minhqng/predictive-cold-chain-aiot/evidence/A/W01/photos/21-dual-esp32-actual-component-side.jpg

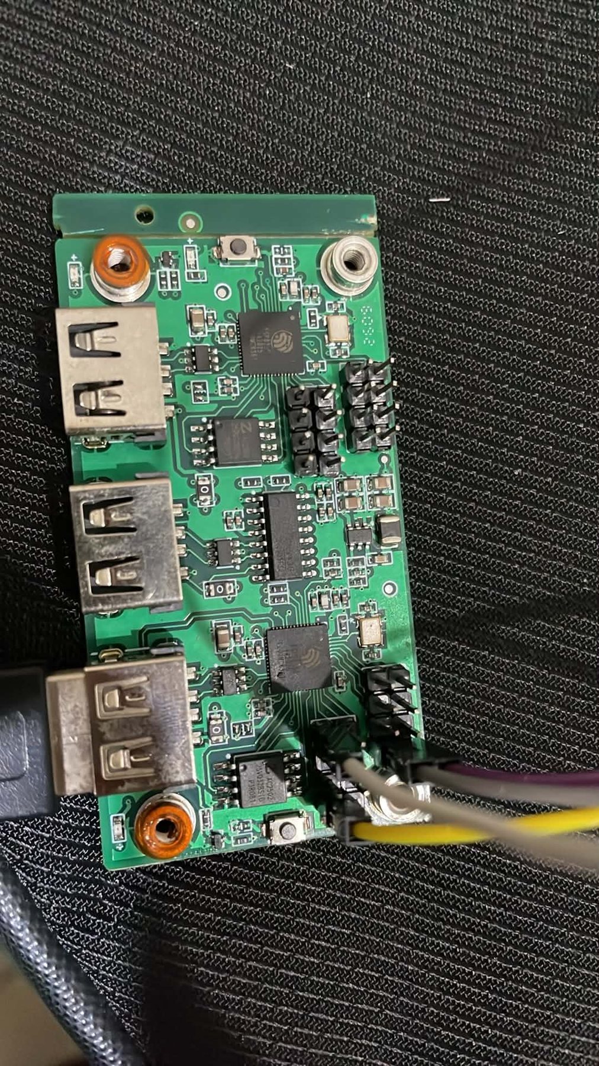
evidence/A/W01/photos/21-dual-esp32-actual-component-side.jpg
