minhqng/predictive-cold-chain-aiot/evidence/A/W01/photos/25-bme280-actual-component-side.jpg

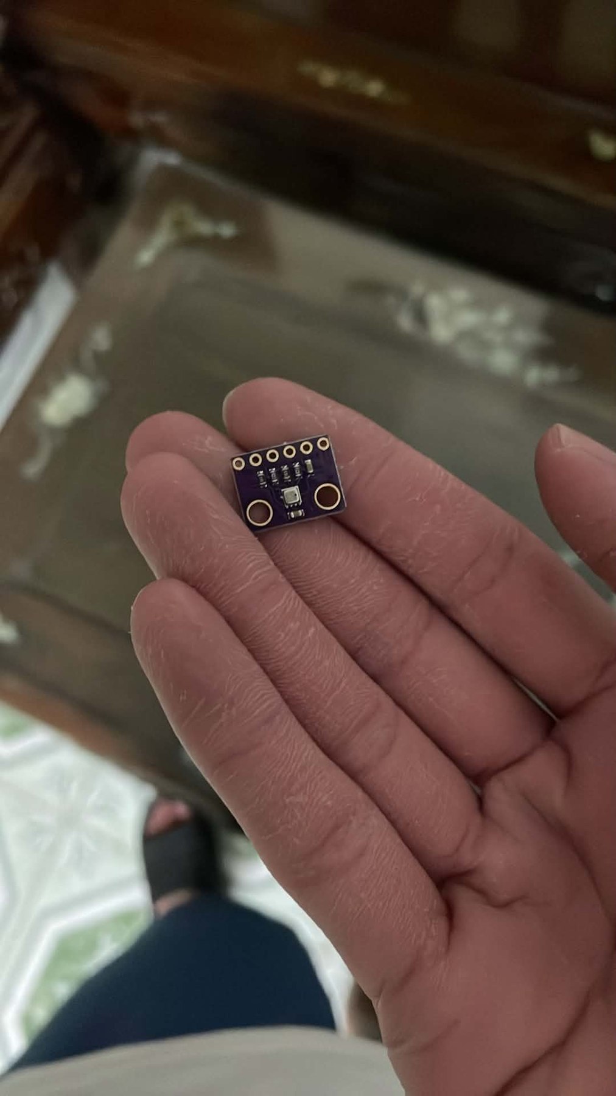
evidence/A/W01/photos/25-bme280-actual-component-side.jpg
