minhqng/predictive-cold-chain-aiot/evidence/D/W21/README.md

# Week 21 — Final resilience/security campaign gate

**Status: HOST MATRIX TESTED; LIVE FINAL CAMPAIGN PENDING.**

The pure `negative_campaign.py` assessment covers all nine cases in Doc 05D
section 53: expired, duplicate, out-of-range, wrong-device, unauthorized
broker, backend authorization, network/backend outage, AI outage, and
reconnect. Each case has explicit required outcomes and an evidence authority.

Host simulation may prove the decision contract and make `all_cases_pass`
true. It cannot make `live_evidence_complete` true. That final state requires
passing `LIVE_EVIDENCE` for every case, with a nonempty evidence reference and
operator identity on every record. Merely changing the authority enum cannot
create live completion. The module only assesses immutable caller-supplied
facts; it does not publish, reconnect, authorize, enter a real mode, actuate
hardware, or edit evidence.

The final live negative/failure campaign remains pending. No physical effect,
ACL event, backend denial, outage transition, or reconnect result is claimed
by this host-only change.
