minhqng/predictive-cold-chain-aiot/evidence/A/W23/README.md

# A-W23 documentary delivery — runbook, recovery kit, labeling deviation

DRAFT week delivery (Member A W23). Base main b5e5cbf.

## Accepted / pending
- **A-W23-02 PASS** — recovery kit: spare fuses (20/30/10 A), jumper 40P, tools,
  spare wire+faston, clamp meter, documentation. Genuine photos
  (operator-submission-20261108/), operator confirmed 2026-11-08.
- **A-W23-01 pending** — demo runbook drafted (demo-runbook.md + runbook v2);
  operator 8-step confirmation outstanding.
- **A-W23-03 INCOMPLETE** — operator-accepted deviation: dedicated branch labels NOT
  applied; system identified via existing component markings + runbook v2 schematic.
  Canonical criterion (6 applied labels) not met; labeling deferred. Not a PASS.
  (operator-acceptance-20261108.md records the decision; no waiver clause exists.)
- **A-W23-04 pending** — ≥3 team rehearsals (not performed).
- **A-W23-05 pending** — evidence index (blocked by A-W15-01).

## Evidence
- operator-submission-20261108/: kit-jumpers/tools/spare-wire/clamp-meter/spare-fuses,
  fuse-block-installed, diagrams (GENERATED, not photos), runbook-v2. SHA256SUMS.
- results/A-W23-02.json (PASS), A-W23-03.json (INCOMPLETE) + imports/ (integrity []).

## Provenance / limitations
- Photos are genuine operator submissions; diagrams are generated schematics (not
  physical photos) and are not used as photo evidence.
- A-W23-03 deviation is operator-accepted but does not satisfy the applied-label
  criterion; kept INCOMPLETE, history preserved.
- Evaluators live in the unpublished acceptance application (feat/a-w21-evidence-final);
  not fully reproducible on main alone.

## Merge readiness
DRAFT — not merge-ready. W23 not complete (W23-01/03/04/05 pending). Operator decides merge.
