minhqng/predictive-cold-chain-aiot/evidence/A/W04/README.md

# evidence/A/W04 — Member A TEC commissioning dossier

Metadata block required by `docs/05A`. Per-requirement verdicts live in
`acceptance.md`; the committed-versus-local inventory is in
`ARTIFACT-MANIFEST.md`; the two open contract questions are in
`change-review-request-CR-A-W04-01.md` (issue **#14**) and
`change-review-request-CR-A-W04-02.md` (issue **#15**); the remaining physical
steps and their safety preconditions are in `w04-physical-verification-plan.md`.

| Field | Value |
|---|---|
| `date` | dossier 2026-11-01, extended 2026-11-02; bench sessions covered 2026-10-29, with the 2026-11-01 box-cooling run cross-referenced as later-week data |
| `operator` | Member A (GitHub `giaback`), attended bench, explicit per-session authorization |
| `hardware_config_id` | `CG-HW-001` (device-emitted in `h6/03-w04-boot-before-flash.log`) |
| `firmware commit` | base `origin/main` `8b73da8e0e7db199259267ac9f0f173c4e289a67`; the W04 code is the commit that adds this dossier on `feat/a-w04-tec-commissioning`. Built image: `0acd230c…b240769e`, 244,496 bytes (`build-2026-11-01/21-artifact-hashes.txt`), compile-only and never flashed |
| `test IDs` | `A-W04-01`…`A-W04-07`; `ACT-H4-01..03`; `PWR-H5-01..03`; `THERM-H6-01/02`; `docs/06` gates G0–G3 |
| `setup` | ESP32-S3R2 MAKDRIVERONE bench, PZEM-017 on the cooling branch, IBT-2 (BTS7960B) driver, TEC1-12715, 12 V/400 W PSU, branch fuse 15 A installed (operator-reported, no readable marking photographed), COM4 console; production firmware built with the TEC output stage compiled out |
| `result` | **W04 PARTIAL** — fail-closed foundation delivered and verified offline (host suite 7/7, ESP-IDF compile PASS); one supervised H6 conservative electrical response measured (peak 0.97 A / 11.3 W, modal 0.96 A / 11.2 W); all six canonical deliverable files now exist; physical W04 acceptance not met |
| `pass/fail` | host suite PASS 7/7 (185 unittest tests + 3 static checkers + 3 dossier validators), ESP-IDF compile PASS; A-W04-02 DEVIATION (1.75 mm² vs 2 × 2.5 mm², change review raised), A-W04-03 not frozen, A-W04-04 PARTIAL (11 resets, 0 power-on boots, 0 pin-level readings), A-W04-06 PARTIAL (direction recorded, no photograph), A-W04-07 PARTIAL (no thermal channels in a conservative trace), H4/H5/H6 PARTIAL |
| `anomalies` | first PZEM sample after START still returns pre-run registers (`elapsed_ms=2 current_ma=0`); one `class=ECHO_ONLY` poll retried once inside the session, documented as transport latency in `h6/41-h6-run-analysis.md` (frame tally corrected there on 2026-11-01), not as zero current; `fan_status=NOT_COMMANDABLE` in all 62 committed G1 telemetry rows — no tachometer feedback exists on CG-HW-001 |

## What this dossier proves

- The W04 control mechanism refuses to energize: output stage compiled out, all
  seven limits `UNRESOLVED`, adapter rejects every enable, proven by static
  contracts plus a 34-scenario host harness against the real control core.
- One conservative H6 energization really happened, with valid 1 Hz PZEM
  electrical samples and an automatic 60.000 s stop.
- Across 132 ROM banners deduplicated to 116 unique start events, no start ever
  produced an unintended output state and all seven production resets came up
  SAFE_OFF — but no start was ever a genuine power-on, which is why A-W04-04 is
  not closed.
- The delivered bytes compile with ESP-IDF v6.1, and every source file in that
  build is hash-pinned.

## Derived artifacts and how to regenerate them

| Artifact | Derived from | Tool |
|---|---|---|
| `h6/first-tec-trace.csv`, `h6/first-tec-plot.png` | `h6/40-h6-run.log` | `firmware/tools/cg_build_h6_trace_csv.py`, `tools/render_trace_plot.ps1` |
| `boot-default-off.csv` | 101 raw captures across the W02, production G1, H6, H7 and H8 sessions | `firmware/tools/cg_build_boot_default_off_csv.py` |
| `tec-cooling-response-600s.csv`, `.png` | the local-only 2026-11-01 monitor `samples.jsonl` (hash pinned in `ARTIFACT-MANIFEST.md` §2.2) | `firmware/tools/cg_build_cooling_trace_csv.py`, `tools/render_trace_plot.ps1` |
| `power-topology-v1.png` | the node and edge list inside the renderer | `tools/render_power_topology.ps1` |

The committed raw captures contain seven per-boot console authorization tokens
(`#CG AUTH token=…`). Each is generated by `esp_random()` at boot, lives 120 s,
cannot be used in another boot and cannot energize the delivered firmware, so
they are inert; they are listed here so a reviewer does not mistake them for
credentials.

## What it does not prove

- Cooling performance from the delivered code, a safe operating envelope, a
  continuous TEC rating, or W04/H4/H5/H6 completion — see `acceptance.md` §1–§4.
- Anything about H7/H8 as W04 evidence: those trees are later-week work, left
  local, recorded by aggregate digest only (`ARTIFACT-MANIFEST.md` §2.3). The
  600 s cooling figures are reproduced here as cross-week measurements at
  **100 % duty**, not as a conservative W04 response.
- The operator statements of 2026-11-02 (fuse installed, 1.75 mm² conductor,
  probe placements) are photographs or measurements. They are statements until
  the images exist.

## Verify

```bash
py evidence/A/W04/validate_w04.py     # recompute every committed hash
py firmware/tools/run_all_checks_w04.py
```
