minhqng/predictive-cold-chain-aiot/evidence/A/W07/repeatability-report.md

# W07 repeatability report

Generated by `evidence/A/W07/build_w07_artifacts.py` from committed captures. Every number reproduces with the commands in `README.md`; nothing was measured for this report.

Primary representation: `tmean_airroles_v0` = mean of the as-built chamber-air probes (T1 centre, T3 bottom, T4 near door), per the operator-frozen geometry in `probe-identification-v0.md`. `includes_hot_side: false`.

## Verdict

**NOT ESTABLISHED — insufficient independent runs.** The analysis exists; the captures do not.

- cooling-step runs: `INSUFFICIENT_RUNS`
- passive warm-up runs: `INSUFFICIENT_RUNS`
- plant variation reportable: `False`
- undetermined rows (no usable applied duty): `0`
- A-W07-02/03 require 3 valid runs of each kind

## What the one available run shows

Every value below is `tmean_airroles_v0`. Slope columns name their own definition: `tmean_airroles_v0/120samples/trailing_window_least_squares_v0` for trailing motion and `tmean_airroles_v0/whole_phase_least_squares_v0` for the phase as a whole.

| phase | samples / rows read | skipped | partial-term | duration min | delta C | trailing slope C/min | whole-phase slope C/min | 1 C at min |
|---|---|---|---|---|---|---|---|---|
| passive warm-up segment | 226 / 226 | 0 | 0 | 3.7498 | 0.0833 | 0.020463 | 0.027185 | None |
| cooling step | 600 / 600 | 0 | 0 | 9.9833 | -8.7083 | -0.070104 | -0.854771 | 0.85 |
| post-action recovery segment | 131 / 131 | 0 | 0 | 2.1667 | 5.333 | 3.097228 | 2.89316 | 0.8167 |

The two slope columns answer different questions and are not two estimates of one. In the only cooling segment the trailing window measures -0.070104 C/min, which is shallower than the whole phase at -0.854771 C/min, so it reports recent motion rather than the response. Neither value is "the cooling slope": the phase answer is `whole_phase_slope_c_per_min`, and the comparison is computed (`trailing_differs_from_whole_phase`) rather than asserted, so a future run in which the two agree will say so.

### Electrical figures

- driven block: mean current `7.2247 A`, peak `9.99 A`, mean power `85.1593 W`, energy delta `14.0 Wh`
- recovery segment: peak current `7.15 A` — **that peak is the single suspect frame below**, not evidence of current after the bridge opened
- electrical qualification: no electrical column in this capture carries a recorded OK: current and voltage have empty status cells and power/energy have no status column at all, so the values are unqualified, not verified (`electrical_rows_unqualified: 2400`, `electrical_status_recorded: false`), so values that nothing checked are never presented as status-checked

Suspect frame (`device_ms=826894`): applied duty `0` and requested duty `0` in state `COOLDOWN`, yet the row carries `7.15 A` and `84.2 W`; `current_status` is an **empty cell, not OK** and all 14 measured fields match 2 of the 2 preceding frames, so the readings did not move when the duty did. Naming this CONTROL_ELECTRICAL_ANOMALY is a safety classification and not a host tool's call, so it is recorded as the canonical candidate for the next supervised session; the frame stays inside the recovery segment's published peak, where the report names it instead of averaging it away.

- canonical candidate: docs/01 22.4 'Commanded OFF + unexpected current' names CONTROL_ELECTRICAL_ANOMALY, high severity, and 23.4 lists 'current while state should be OFF' as its example
- competing explanation: register/transition lag on the PZEM side. Two committed observations support it: evidence/A/W04/README.md records the first PZEM sample after START still returning pre-run registers, and after this frame the applied duty stays 0 while the reading falls 7.15 -> 0.56 -> 0.02 -> 0.0 -> 0.0 -> 0.02 A, reaching 0 at device_ms 829894. That is a decaying tail, not sustained energization - but it is a meter trace, not a verified zero-current measurement, so it weakens the anomaly reading without closing it
- comparison actually performed: `14` measured fields, `2` of `2` preceding frames identical on all of them, differing on `none`

## The representation question, measured

Same single run, four definitions:

| representation | terms | roles | includes hot side | delta C | whole-phase slope C/min | 1 C at min |
|---|---|---|---|---|---|---|
| `tmean_airroles_v0` | t1_c, t3_c, t4_c | CHAMBER_CENTER, CHAMBER_BOTTOM, CHAMBER_NEAR_DOOR | False | -8.7083 | -0.854771 | 0.85 |
| `tmean_chamber3_v0` | t1_c, t2_c, t3_c | CHAMBER_CENTER, TEC_HOT_SIDE, CHAMBER_BOTTOM | True | -2.5627 | -0.34487 | 2.6833 |
| `tmean_t2excluded_v0` | t1_c, t3_c | CHAMBER_CENTER, CHAMBER_BOTTOM | False | -8.6875 | -0.864815 | 0.8833 |
| `tmean_all4_v0` | t1_c, t2_c, t3_c, t4_c | CHAMBER_CENTER, TEC_HOT_SIDE, CHAMBER_BOTTOM, CHAMBER_NEAR_DOOR | True | -4.1095 | -0.467323 | 1.9 |

The docs/01 §20.1 literal mean(T1,T2,T3) measures `-2.5627` C where the
as-built chamber-air mean measures `-8.7083` C — a factor of
3.40. T2 is on the hot side, rises while the air
probes fall, and averaging it into an air temperature flattens the response
the chamber actually produced.

This is stated as measured disagreement between named definitions. The
physical geometry is operator-final and is not reopened here; the logical
T1/T2/T3 naming in docs/01 remains a project decision, and no silent
firmware remap is proposed.

## Statistics

Sample (n-1) spread. With n=1 the spread columns are empty by construction:
one run has no dispersion, and inventing a variance would be the exact thing
this week must not do. Outcomes no run produced are listed as NO_SAMPLES
rather than dropped from the table.

| phase | outcome | n | mean | sd (sample) | CV % | min | max | note |
|---|---|---|---|---|---|---|---|---|
| baseline | start_c | 1 | 29.9167 | None | None | 29.9167 | 29.9167 | spread needs at least two runs |
| baseline | end_c | 1 | 30.0 | None | None | 30.0 | 30.0 | spread needs at least two runs |
| baseline | delta_c | 1 | 0.0833 | None | None | 0.0833 | 0.0833 | spread needs at least two runs |
| baseline | min_c | 1 | 29.9167 | None | None | 29.9167 | 29.9167 | spread needs at least two runs |
| baseline | max_c | 1 | 30.0417 | None | None | 30.0417 | 30.0417 | spread needs at least two runs |
| baseline | slope_c_per_min | 1 | 0.020463 | None | None | 0.020463 | 0.020463 | spread needs at least two runs |
| baseline | whole_phase_slope_c_per_min | 1 | 0.027185 | None | None | 0.027185 | 0.027185 | spread needs at least two runs |
| baseline | minutes_to_1c | 0 | - | - | - | - | - | no run of this phase produced this outcome |
| baseline | minutes_to_2c | 0 | - | - | - | - | - | no run of this phase produced this outcome |
| baseline | mean_current_a | 1 | 0.0 | None | None | 0.0 | 0.0 | spread needs at least two runs |
| baseline | peak_current_a | 1 | 0.0 | None | None | 0.0 | 0.0 | spread needs at least two runs |
| baseline | mean_power_w | 1 | 0.0 | None | None | 0.0 | 0.0 | spread needs at least two runs |
| baseline | energy_wh | 1 | 0.0 | None | None | 0.0 | 0.0 | spread needs at least two runs |
| baseline | valid_sample_fraction | 1 | 1.0 | None | None | 1.0 | 1.0 | spread needs at least two runs |
| cooling | start_c | 1 | 30.021 | None | None | 30.021 | 30.021 | spread needs at least two runs |
| cooling | end_c | 1 | 21.3127 | None | None | 21.3127 | 21.3127 | spread needs at least two runs |
| cooling | delta_c | 1 | -8.7083 | None | None | -8.7083 | -8.7083 | spread needs at least two runs |
| cooling | min_c | 1 | 21.3127 | None | None | 21.3127 | 21.3127 | spread needs at least two runs |
| cooling | max_c | 1 | 30.0417 | None | None | 30.0417 | 30.0417 | spread needs at least two runs |
| cooling | slope_c_per_min | 1 | -0.070104 | None | None | -0.070104 | -0.070104 | spread needs at least two runs |
| cooling | whole_phase_slope_c_per_min | 1 | -0.854771 | None | None | -0.854771 | -0.854771 | spread needs at least two runs |
| cooling | minutes_to_1c | 1 | 0.85 | None | None | 0.85 | 0.85 | spread needs at least two runs |
| cooling | minutes_to_2c | 1 | 1.25 | None | None | 1.25 | 1.25 | spread needs at least two runs |
| cooling | mean_current_a | 1 | 7.2247 | None | None | 7.2247 | 7.2247 | spread needs at least two runs |
| cooling | peak_current_a | 1 | 9.99 | None | None | 9.99 | 9.99 | spread needs at least two runs |
| cooling | mean_power_w | 1 | 85.1593 | None | None | 85.1593 | 85.1593 | spread needs at least two runs |
| cooling | energy_wh | 1 | 14.0 | None | None | 14.0 | 14.0 | spread needs at least two runs |
| cooling | valid_sample_fraction | 1 | 1.0 | None | None | 1.0 | 1.0 | spread needs at least two runs |
| recovery | start_c | 1 | 21.3127 | None | None | 21.3127 | 21.3127 | spread needs at least two runs |
| recovery | end_c | 1 | 26.6457 | None | None | 26.6457 | 26.6457 | spread needs at least two runs |
| recovery | delta_c | 1 | 5.333 | None | None | 5.333 | 5.333 | spread needs at least two runs |
| recovery | min_c | 1 | 21.3127 | None | None | 21.3127 | 21.3127 | spread needs at least two runs |
| recovery | max_c | 1 | 26.6457 | None | None | 26.6457 | 26.6457 | spread needs at least two runs |
| recovery | slope_c_per_min | 1 | 3.097228 | None | None | 3.097228 | 3.097228 | spread needs at least two runs |
| recovery | whole_phase_slope_c_per_min | 1 | 2.89316 | None | None | 2.89316 | 2.89316 | spread needs at least two runs |
| recovery | minutes_to_1c | 1 | 0.8167 | None | None | 0.8167 | 0.8167 | spread needs at least two runs |
| recovery | minutes_to_2c | 1 | 1.0833 | None | None | 1.0833 | 1.0833 | spread needs at least two runs |
| recovery | mean_current_a | 1 | 0.0604 | None | None | 0.0604 | 0.0604 | spread needs at least two runs |
| recovery | peak_current_a | 1 | 7.15 | None | None | 7.15 | 7.15 | spread needs at least two runs |
| recovery | mean_power_w | 1 | 0.7084 | None | None | 0.7084 | 0.7084 | spread needs at least two runs |
| recovery | energy_wh | 1 | 0.0 | None | None | 0.0 | 0.0 | spread needs at least two runs |
| recovery | valid_sample_fraction | 1 | 1.0 | None | None | 1.0 | 1.0 | spread needs at least two runs |

## Reproduce

```bash
py firmware/tools/run_all_checks_w07.py
py evidence/A/W07/build_w07_artifacts.py --check
py firmware/tools/cg_thermal_repeatability.py evidence/A/W04/tec-cooling-response-600s.csv --representation tmean_airroles_v0
```
