minhqng/predictive-cold-chain-aiot/evidence/A/W08/Gate-A-report.md

# Gate A report - W08 physical characterization and SAFE_LOCAL support

Generated by `firmware/tools/cg_w08_gate_a.py` through
`evidence/A/W08/build_w08_artifacts.py`. **Every** statement below is one of
an observation over recorded bytes, a declared dependency, or a named gap.
No line is `PHYSICALLY_VERIFIED`; nothing here authorizes energizing the
branch, and the produced verdict is `GATE A NOT CLOSED`.

## 1. Requirement matrix (docs/05A section 17)

| ID | Canonical ask | Status | Evidence | Gap |
|---|---|---|---|---|
| **A-W08-01** | safe operating envelope from W4-W7 | REAL_DATA_ANALYZED (observed) / NOT FROZEN | operating-envelope-v1.yaml, envelope-by-duty.csv, holdover-frames.csv, electrical-status-coverage.csv | one committed duty level; the ladder is local-only; no limit is a rating |
| **A-W08-02** | fuse finalization 10/15/20 A with rationale | BLOCKED_HARDWARE | fuse-selection.md (generated) + the observed currents table | no ampacity basis for the installed conductor (2.405 mm2 derived from a 1.75 mm core diameter under a solid-round assumption), no photographed fuse marking, canonical 2 x 2.5 mm2 deviation open |
| **A-W08-03** | hot-side sustainability long run | REAL_DATA_ANALYZED (three of four bullets) / NEED_USER_ACTION | thermal-sustainability.csv | terminals/IBT-2 abnormal behaviour is unmeasured by any frame; no continuous rating may be claimed |
| **A-W08-04** | SAFE_LOCAL integration support with D | TEAM_DEPENDENCY | safe-local-physical-inputs.csv (SL-01..SL-14) | no transport, no wall clock, no fan observation, no interlock, and the mode itself belongs to D |
| **A-W08-05** | Gate A package indexing all H0-H7 artifacts | IMPLEMENTED / HOST_VERIFIED | Gate-A-report.md + gate-a-artifact-index.csv | W07 evidence is not in this checkout; the H7/H8 raw sessions are local-bench; committed captures in this run: 5 |

## 2. Pass-criteria walk

| Criterion | Result | Why |
|---|---|---|
| safe physical envelope known | NOT MET | the observed envelope exists (one duty level committed, the ladder local-only), but the fuse/conductor basis is missing so nothing can be called safe; see fuse-selection.md verdict NO_FREEZE |
| repeatable enough plant | NOT MET HERE | repeatability is W07's question and its evidence is not in this checkout; one 600 s capture cannot answer it |
| fuse selected | NOT MET | NO_FREEZE: no ampacity basis for the installed branch (a 1.75 mm core diameter, 2.405 mm2 if solid round) and no photographed fuse marking; the 15 A value is operator-reported only |
| no unresolved high-current anomaly | NOT PRE-JUDGED - CANDIDATE OPEN IN W15 | fault_bits=0 in all 957 committed frames and steady OFF current never exceeded the 0.02 A meter floor; the duty-0 frames above it are the two PZEM register-latency frames, named individually and left open by W15 between the register-holdover reading and the canonical CONTROL_ELECTRICAL_ANOMALY class (docs/01 22.4/23.4, high severity). This row does not decide that safety classification, and nothing here measures the terminals or the IBT-2 case either |
| SAFE_LOCAL physically possible | NOT DEMONSTRATED | the inputs exist (SL-01..SL-08) but the fan is unobservable, no interlock is installed, there is no wall clock and no transport, and the mode itself is Member D's |

## 3. Index of H0-H7 artifacts (docs/01 Gate H0 ... Gate H7)

Curated list, resolved against this checkout. `exists_in_this_checkout`
false is a finding, not a formatting failure: those artifacts live on other
branches or only in Member A's local bench tree.

| Gate | Required | Artifact | In this checkout | SHA-256 (12) |
|---|---|---|---|---|
| H0 mechanical assembly | V1 installed, TEC integrated, paste, fan mounted, penetration sealed, sensor positions fixed, panel outside chamber | `evidence/A/W01/hardware-audit-w01.md` | true | 9962ee5ee97c |
| H0 as-built positions | the frozen as-built pin/position record | `evidence/A/as-built-pinmap-2026-10-27.md` | true | 39acc702d0d7 |
| H0/H1 photos | photographic inventory of the assembly | `evidence/A/W01/photo-inventory.csv` | true | a644db8cd956 |
| H1 sensor subsystem | three expected DS18B20 ROM ids, BME read, MC-38 open/close | `evidence/A/W02/ds18b20/ds18b20-verification.md` | true | ecace2203db4 |
| H1 ROM map | the by-source ROM identity table | `evidence/A/W02/sensor-rom-map.yaml` | true | 50709135f7f0 |
| H1 door subsystem | MC-38 open/close verified | `evidence/A/W02/mc38/mc38-bench-report.md` | true | 48d33f5294e8 |
| H2 logic power | 5 V rail verified, no TEC actuation | `evidence/A/W03/logic-power-measurement.md` | true | 485cfaffeda6 |
| H3 PZEM / RS-485 | Modbus response, 50 A profile, V/I/P/Wh readable | `evidence/A/W03/pzem-register-readback.txt` | true | ca6b58183c1e |
| H3 current profile readback | 50 A profile verified on the wire | `evidence/A/W03/hardware-2026-10-27/test-131-profile-readback.md` | true | b7301e80b9e0 |
| H3 OFF-state envelope | zero-current envelope with per-sample validity | `evidence/A/W03/hardware-2026-10-27/raw/test-132b-off-envelope.csv` | true | 7eac5f80c2d9 |
| H4 IBT-2 logic | default OFF, enable, direction, reset, 3.3 V logic | `evidence/A/W03/hardware-2026-10-27/test-133b-reset-default-off.md` | true | bb1d334b79f3 |
| H4 default-OFF on the delivered build | boot with outputs off | `evidence/A/W04/boot-default-off-note.md` | true | c67ed70cc300 |
| H4 IBT-2 pin map | the pin contract actually used | `evidence/A/W03/ibt2-pin-map.md` | true | 4901c0328534 |
| H5 power branch | fuse installed, high-current wiring, shunt, terminal check, fan | `evidence/A/W04/fuse-commissioning-note.md` | true | 2342bbbf3b38 |
| H5 shunt continuity | series return path proven | `evidence/A/W03/hardware-2026-10-27/shunt-continuity.md` | true | fa0e25f36b65 |
| H5 G0 electrical verification | branch voltage/presence evidence before any drive | `evidence/A/W04/g0-electrical-verification.md` | true | de2f24567b46 |
| H6 conservative TEC test | current present, correct cooling face, hot side rejects, no abnormal connector behaviour | `evidence/A/W04/h6/41-h6-run-analysis.md` | true | d5553d313c22 |
| H6 trace artifact | the 1 Hz electrical samples | `evidence/A/W04/h6/first-tec-trace.csv` | true | f5cd1fb7d741 |
| H6 polarity | correct cooling face proven | `evidence/A/W04/polarity-photo.md` | true | f1729ecadf6a |
| H7 full characterization | V/I/P, actuation state, T1/T2/T3, BME, door, timing, thermal response over the duty ladder | `evidence/A/W04/tec-cooling-response-600s.csv` | true | f8716b5136f3 |
| H7 duty ladder | the 20-100 % staircase | `h7/50-stage-20pct.md .. h7/60-h7-100pct-duty-audit.md` | false | - |
| H7 endurance / hot side | long runs at 100 % duty | `h8/phase4e/H8_FULL_SENSOR_ENDURANCE_REPORT.md` | false | - |
| W05 timing / freshness | cadence and age statistics | `evidence/A/W05/timing-pilot.json` | true | 6621f7a9c12b |
| W06 command/ACK contract | desired vs applied state, idempotency, expiry | `evidence/A/W06/ack-fixture.json` | true | 1a195a4a7fef |
| W07 plant repeatability | repeated baseline runs and their spread | `evidence/A/W07` | false | - |

## 4. SAFE_LOCAL physical inputs (A-W08-04)

What firmware can observe, what must come from Member D's policy, and what
no recorded field measures at all. Full machine-readable table:
`safe-local-physical-inputs.csv`.

| ID | Input | Firmware can observe | Recorded validity | Gap |
|---|---|---|---|---|
| SL-01 | chamber CENTER temperature (T1, as-built CHAMBER_CENTER) | YES | false | the device role token is UNASSIGNED in every frame, so the mapping T1=CHAMBER_CENTER comes from the operator-frozen as-built record, not from the frame |
| SL-02 | TEC HOT_SIDE temperature (T2, as-built TEC_HOT_SIDE) | YES | false | the production schema still reports the hot-side channel as NOT_ASSIGNED, so the delivered build has no hot-side protection input until the role is wired end to end |
| SL-03 | chamber BOTTOM (T3) and NEAR-DOOR (T4/SPARE) | YES | false | both report role UNASSIGNED in every frame; no frame proves which physical probe it is, and the ROM ids are by-source (firmware ROM map), not a readback |
| SL-04 | chamber air / humidity / pressure (BME280) | YES | UNQUALIFIED | the CSV builder dropped the air and humidity validity tokens, so an air statistic quoted from the CSV is unqualified even though the wire labelled it OK |
| SL-05 | door state (MC-38) | PARTIAL | UNQUALIFIED | no magnetic/door disturbance experiment has been recorded, and the polarity check is by-source, not by a documented test procedure |
| SL-06 | branch voltage / current / power (PZEM-017) | YES (with one-poll latency) | UNQUALIFIED | the producer publishes a 666 ms-old sample into a 1 Hz frame and the CSV carries no token at all, so downstream consumers cannot separate fresh, stale and held-over readings |
| SL-07 | accumulated energy (PZEM energy register) | PARTIAL | UNQUALIFIED | a 1 Wh counter at ~85 W updates about every 42 s, so it cannot resolve a short run, and it has no validity token on the bench wire at all |
| SL-08 | applied duty and its readback (IBT-2 / LEDC) | YES for duty, NO for the enable pins | false | enable_readback reports ren:0,len:0 in EVERY frame including the 600 driven ones while ren_command=1, so the driver enable state is commanded but never observed; output verification rests on current alone |
| SL-09 | TEC / hot-side fan running | NO | UNQUALIFIED | the only fan evidence is operator presence; SAFE_LOCAL cannot detect a stopped fan from any recorded field |
| SL-10 | safety interlock / hardware cutout | NO | n-a | no interlock is installed, so every stop recorded so far came from software or from the operator at the PSU |
| SL-11 | operating limits and who approved them | PARTIAL (it reports the policy it was given) | n-a | the six (docs/05A) / seven (docs/06) limit-count discrepancy and the numeric values are Member D's decision; the bench image's APPROVED table is not the delivered firmware's and must never be quoted as such |
| SL-12 | wall clock / command expiry | NO | n-a | clock synchronisation is Member C's work; until it exists, expiry-based protection is fail-closed rather than satisfied |
| SL-13 | backend / broker reachability | PARTIAL | n-a | the delivered firmware has no transport, so removing the broker/backend (the literal A-W08-04 ask) cannot be tested against it; the SAFE_LOCAL mode itself is Member D's |
| SL-14 | fault latch and why the stage stopped | YES | false | fault_latency_us=-1 in every frame: the fault-to-stop latency has never been measured because no fault was ever injected |

### 4.1 The split, stated plainly

**Firmware observes:**
* raw sensor conversions with per-channel status and age
* the snapshot completeness mask and the mandatory-role gate
* PZEM V/I/P with per-field status and age (one poll of latency)
* requested vs applied duty and the duty readback
* fault bits, stop reason and the OFF-current gate result

**Member D must supply:**
* the numeric values of the six operating limits and their provenance
* the SAFE_LOCAL entry/exit rule and what protective cooling is allowed while the remote path is gone
* the staleness budget each input must satisfy before it may act
* the fault taxonomy that turns an anomaly into a lockout

> the bench image reports limits_policy=APPROVED and limits_enforced=1; that table belongs to a bench build and is not the delivered firmware's, whose limits are all UNRESOLVED

## 5. Named gaps

| Gap | Detail | Status |
|---|---|---|
| no electrical validity token in the committed 600 s CSV | voltage_status and current_status exist as columns but are empty in all 957 rows; power_status, energy_status and door_status are not columns at all. The same session's wire frames do carry them, so the loss happened in the CSV builder. | REAL_DATA_ANALYZED |
| energy has no validity token anywhere on the bench wire | no energy_wh_status token exists in any of the 957 raw frames; the delivered production schema expects one. | REAL_DATA_ANALYZED |
| driver enable state is commanded but never observed | enable_readback=ren:0,len:0 in every frame including the 600 driven ones, while ren_command=1 there. | REAL_DATA_ANALYZED |
| fan running is not electronically observable | fan_readback=NOT_ELECTRONICALLY_VERIFIED in 957/957 frames. | BLOCKED_HARDWARE |
| no hardware interlock | interlock_state=NOT_INSTALLED in 957/957 frames. | BLOCKED_HARDWARE |
| fault-to-stop latency never measured | fault_latency_us=-1 in every frame; no fault was ever injected. | NEED_USER_ACTION |
| duty-0 frames with current | 11 frames across all sources, each listed individually in duty-zero-current-frames.csv and excluded from both the drive and the OFF envelope. The record names them as register-latency cases, which is an explanation and not a classification: docs/01 22.4/23.4 make a commanded-OFF-with-current frame a candidate CONTROL_ELECTRICAL_ANOMALY (high severity), and W15 leaves that option open. For device_ms=826894 the applied duty stayed 0 while the PZEM-reported reading decayed 7.15 -> 0.56 -> 0.02 -> 0.0 A, reaching zero at device_ms=829894, so the decay weakens sustained-energization and supports register/transition lag - but that trace is the meter's own report with no independent instrument behind it, so measured value and verified physical current stay apart and the safety qualification is open. | REAL_DATA_ANALYZED |
| no continuous rating for the TEC | the 55 C hot-side ceiling was provisional; the SKU continuous rating is unestablished, so 'margin to 55 C' is not headroom. | NEED_USER_ACTION |
| conductor deviation open | the record's "1.75" is the copper core diameter in mm (unit error corrected by the operator 2026-11-02), i.e. 2.405 mm2 if the core is round solid - a ~3.8 % gap to the canonical 2 x 2.5 mm2 ask rather than ~30 %, and inside the FDD2-250 1.5-2.5 mm2 termination rating. The assumption is stated, not proven: no marking was photographed, so no nominal 2.5 mm2 compliance is claimed and HW-19 stays UNVERIFIED. | TEAM_DEPENDENCY |

## 6. Operator action queue (W08 half; the W15 half is in evidence/A/W15)

Merged to the minimum number of supervised sessions without dropping any
required repetition. The unpowered inspection (OQ-W08-1) is **necessary, not
sufficient**: it produces the conductor and fuse markings, and it does not by
itself clear any energized-session gate - the open CONTROL_ELECTRICAL_ANOMALY
classification of the duty-0 frame and Member D's unresolved thresholds gate
those sessions too, and neither is answered by a photo.

| Queue | Requirement | Action | Power state | Unlocks | Sessions |
|---|---|---|---|---|---|
| OQ-W08-1 | A-W08-02 | Photograph the installed branch fuse body (rating, 250 V, glass/ceramic) and the spare 10 A fuse; photograph the installed power cable marking and measure its run length. | PSU OFF, branch de-energized; no flashing, no serial needed | the ampacity basis that A-W08-02 needs before any of 10/15/20 A can be defended; closes the HW-19 audit row. It is necessary, not sufficient: it does not clear an energized-session gate, which also needs the duty-0 anomaly classification and Member D's thresholds | 1 (cold inspection, no supervision of energized parts needed) |
| OQ-W08-2 | A-W08-03 | One supervised long run at 100 % duty for at least 1800 s with the operator touching nothing and reporting terminal / IBT-2 / cable temperature by touch-free measurement at t=0, 300, 600, 900, 1200, 1500, 1800 s. | energized branch, attended bench, operator at the PSU | A-W08-03's fourth bullet (terminals/IBT-2 abnormal behaviour) and the component-thermal half of the fuse decision | 1 (merge with OQ-W15-2's duty points only if the ladder is re-authorized; a 100 % long run must keep its own repetition) |
| OQ-W08-3 | A-W08-04 | SAFE_LOCAL demonstration session: with TEC running, remove broker/backend reachability (and then restore it) while Controller A keeps sensing and local output behaviour is recorded. | energized branch, attended | A-W08-04 and the docs/00 Q7 resilience claim | 1 (depends on D + C delivering a mode to test) |
| OQ-W08-4 | A-W08-01 / A-W08-05 | Deliver the committed copy of the H7 duty-ladder logs and the H8 A-E endurance samples.jsonl into this repository (hash-pinned, read-only), or accept that the envelope's 20-90 % rows stay LOCAL_BENCH and unreproducible for reviewers. | no hardware at all: this is an evidence-move, not a test | a clean-checkout reviewer can reproduce every number in operating-envelope-v1.yaml instead of trusting a declaration | 0 |

## 7. What this package refuses to say

* it does not certify the envelope as safe (fuse/conductor basis missing);
* it does not claim a continuous TEC rating, and 55 C is quoted only as the
  provisional working ceiling the bench sessions were run against;
* it does not claim a device received a command, that the branch may be
  energized, or that SAFE_LOCAL works - there is no transport and no mode;
* it does not average TEC_HOT_SIDE into any chamber statistic, and no frame
  proves which physical probe is which beyond the operator-frozen as-built
  record;
* every electrical figure from the committed CSV is published as a value
  with **no recorded validity** (`electrical_status_recorded: false`);
* it does not decide the duty-0-with-current classification, and it does not
  treat the PZEM's own decaying trace as proof the branch was unenergized -
  a measured value and a verified physical current are different claims, and
  no independent instrument stands behind any figure here;
* it does not read the corrected conductor figure as compliance: ~2.405 mm2
  holds only if the core is round solid, and no marking was photographed;
* it does not treat a shop listing or catalogue entry as evidence about the
  installed fuse body, whose marking has never been read;
* it does not claim that the unpowered inspection clears an energized-session
  gate.

Verdict: **GATE A NOT CLOSED**
