minhqng/predictive-cold-chain-aiot/evidence/A/W14/spatial-report.md

# W14 spatial statistics (A-W14-03)

Generated by `evidence/A/W14/build_w14_artifacts.py` from committed captures. Nothing was measured for this report: no flash, no energized stage, no probe moved, and every figure below is host analysis of rows already in the repository.

## Verdict

- independent thermal sessions on disk: **1** (`boot_id` 56044b74), each phase block labelled from its own capture
- gradient distribution: **NOT_COMPUTABLE_AS_DISTRIBUTION** - a distribution needs 3 independent sessions, so what is published instead is one session's per-sample series, labelled `SINGLE_SESSION_OBSERVATION`
- disturbance-specific spatial response: **NOT_COMPUTABLE**
- max pairwise air difference in the driven block: **1.126 C**, against **18.938 C** between an air probe and the hot-side surface

## What one session can and cannot say

It can say how far apart the three chamber-air positions sat from each other while the bridge was driven, and how far the hot-side surface sat from them. It cannot say what the run-to-run spread of those quantities is, because one boot of one session carries no repetition; calling its sample dispersion a distribution would be the exact defect this deliverable exists to avoid.

## Air gradients (T1 centre, T3 bottom, T4 near door)

`sd_within_session_sample_c` is dispersion across samples **inside one run** (sample n-1). It is not a repeat spread and is not a tolerance.

| phase | pair (roles) | n | mean C | sd within session C | min C | max C | max |dT| C | at device_ms |
|---|---|---|---|---|---|---|---|---|
| baseline | t1_c-vs-t3_c (CHAMBER_CENTER vs CHAMBER_BOTTOM) | 226 | 0.3285 | 0.0348 | 0.25 | 0.375 | 0.375 | 127894 |
| baseline | t1_c-vs-t4_c (CHAMBER_CENTER vs CHAMBER_NEAR_DOOR) | 226 | -0.0338 | 0.0313 | -0.063 | 0.0 | 0.063 | 49894 |
| baseline | t3_c-vs-t4_c (CHAMBER_BOTTOM vs CHAMBER_NEAR_DOOR) | 226 | -0.3623 | 0.0289 | -0.438 | -0.312 | 0.438 | 200894 |
| cooling | t1_c-vs-t3_c (CHAMBER_CENTER vs CHAMBER_BOTTOM) | 600 | -0.731 | 0.3909 | -1.126 | 0.375 | 1.126 | 518894 |
| cooling | t1_c-vs-t4_c (CHAMBER_CENTER vs CHAMBER_NEAR_DOOR) | 600 | -0.3815 | 0.2316 | -0.626 | 0.063 | 0.626 | 632894 |
| cooling | t3_c-vs-t4_c (CHAMBER_BOTTOM vs CHAMBER_NEAR_DOOR) | 600 | 0.3495 | 0.2462 | -0.438 | 0.687 | 0.687 | 408894 |
| recovery | t1_c-vs-t3_c (CHAMBER_CENTER vs CHAMBER_BOTTOM) | 131 | -0.1136 | 0.4771 | -0.813 | 0.5 | 0.813 | 833894 |
| recovery | t1_c-vs-t4_c (CHAMBER_CENTER vs CHAMBER_NEAR_DOOR) | 131 | -0.3913 | 0.1901 | -0.626 | -0.062 | 0.626 | 851894 |
| recovery | t3_c-vs-t4_c (CHAMBER_BOTTOM vs CHAMBER_NEAR_DOOR) | 131 | -0.2777 | 0.2988 | -0.626 | 0.25 | 0.626 | 925894 |

Row accounting for the driven block: `{'usable_pairs': 600, 'partial_rows': 0, 'invalid_rows': 0, 'unqualified_rows': 0, 'usable_pairs_all_terms_ok': 600}` - a row missing one probe is counted, not averaged over.

## Air versus the hot-side surface

T2 sits on TEC metal (`TEC_HOT_SIDE`) and is never part of an air mean; it is reported here as a separation so the surface is visible without being averaged into air. The pairs below are labelled by what they are.

| phase | pair (roles) | read as | n | mean C | max |dT| C |
|---|---|---|---|---|---|
| baseline | t1_c-vs-t2_c (CHAMBER_CENTER vs TEC_HOT_SIDE) | surface-to-air separation, not an air gradient | 226 | 0.1813 | 0.25 |
| baseline | t2_c-vs-t3_c (TEC_HOT_SIDE vs CHAMBER_BOTTOM) | surface-to-air separation, not an air gradient | 226 | 0.1472 | 0.25 |
| baseline | t2_c-vs-t4_c (TEC_HOT_SIDE vs CHAMBER_NEAR_DOOR) | surface-to-air separation, not an air gradient | 226 | -0.2152 | 0.313 |
| cooling | t1_c-vs-t2_c (CHAMBER_CENTER vs TEC_HOT_SIDE) | surface-to-air separation, not an air gradient | 600 | -14.2271 | 18.938 |
| cooling | t2_c-vs-t3_c (TEC_HOT_SIDE vs CHAMBER_BOTTOM) | surface-to-air separation, not an air gradient | 600 | 13.4961 | 18.063 |
| cooling | t2_c-vs-t4_c (TEC_HOT_SIDE vs CHAMBER_NEAR_DOOR) | surface-to-air separation, not an air gradient | 600 | 13.8456 | 18.376 |
| recovery | t1_c-vs-t2_c (CHAMBER_CENTER vs TEC_HOT_SIDE) | surface-to-air separation, not an air gradient | 131 | -12.0072 | 18.687 |
| recovery | t2_c-vs-t3_c (TEC_HOT_SIDE vs CHAMBER_BOTTOM) | surface-to-air separation, not an air gradient | 131 | 11.8936 | 17.937 |
| recovery | t2_c-vs-t4_c (TEC_HOT_SIDE vs CHAMBER_NEAR_DOOR) | surface-to-air separation, not an air gradient | 131 | 11.6159 | 18.124 |

## Disturbance-specific response

**NOT_COMPUTABLE**. no door-open transition exists in the capture: the field is never OPEN, so there is no applied disturbance whose spatial response could be measured. Estimating one would be inventing a physical event.

Re-derived from the capture rather than quoted from a document:

- rows: `957`
- `door_open` token tally: `{'0': 940, 'UNKNOWN': 17}`
- rows that are OPEN: `0`
- rows whose door state is not knowable: `17`
- confirmed closed: `940`

What would make it computable: a supervised session that opens the door to a recorded extent and holds it for a bounded window, with door_polarity CONFIRMED on the open rows, repeated at least the required number of times

## Data limits this report lives inside

- one `boot_id` (56044b74) across 957 rows, so baseline, cooling and recovery are segments of one session, not three runs
- gradient tallies carry `unqualified_rows`: a row whose `t*_status` was never recorded is counted as unvouched instead of being quietly treated as checked (this capture's `t*_status` is `OK` on every row, so the count here is 0)
- `current_status`/`voltage_status` are empty in every row and `power_w`/`energy_wh` have no status column, so no electrical figure is status-checked
- `device_ms` is per-boot; host wall-clock is not device time
- the `#CG H8S schema=3` frames carry no sensor ROM ids, so a channel is a slot name, not a proven physical probe
- the 2026-11-02 touch session is classed `PROBE_IDENTIFICATION` and is excluded from every number above

## Reproduce

```bash
py firmware/tools/cg_w14_spatial.py evidence/A/W04/tec-cooling-response-600s.csv --min-sessions 3
py evidence/A/W14/build_w14_artifacts.py --check
py evidence/A/W14/validate_w14.py
```
