minhqng/predictive-cold-chain-aiot/evidence/A/W15/pzem-quality-report.md

# A-W15-01 / A-W15-03 - PZEM electrical-producer quality report

Generated by `firmware/tools/cg_w15_pzem_quality.py` through
`evidence/A/W15/build_w15_artifacts.py`. Status label: **REAL_DATA_ANALYZED**
- every figure below is a statistic over frames that were recorded by
supervised bench sessions. Nothing here is `PHYSICALLY_VERIFIED`, no
calibration is certified, and no hardware was touched to produce it.

## 1. Headline

* sources audited: **23** (5 committed in git, the rest in Member A's local bench tree)
* frames: **11242**, of which **85** carry no electrical value at all and **16** say so explicitly with `IO_ERROR` (+85 non-OK status frames across all sources)
* register-latency (holdover/settling/pre-run) frames: **31**, each listed individually
* V x I versus reported power: worst absolute delta **0.0997 W** against a register-quantisation tolerance of **0.18 W**; **0** frames beyond tolerance
* sources that publish an electrical value with **no validity token** (so the value is unqualified): H7-100pct, H7-20pct, H7-30pct, H7-40pct, H7-50pct, H7-60pct, H7-60pct-diag1, H7-60pct-diag2, H7-60pct-shunt, H7-70pct, H7-80pct, H7-90pct, W04-G1-production-failclosed, W04-H6-10pct, W04-H8C-box-600s
* sources that carry **no freshness age token** at all: H7-100pct, H7-20pct, H7-30pct, H7-40pct, H7-50pct, H7-60pct, H7-60pct-diag1, H7-60pct-diag2, H7-60pct-shunt, H7-70pct, H7-80pct, H7-90pct, W03-132b-off-envelope, W03-pzem-off-2026-10-20, W04-G1-production-failclosed, W04-H6-10pct, W04-H8C-box-600s (the W03 host captures carry a poll-level token but no age; the committed CSV carries neither)

## 2. What the producer actually publishes

The PZEM-017 is read as six input registers (`firmware/tools/cg_modbus.py`: 0x0000 voltage, 0x0001 current, 0x0002..0x0003 power, 0x0004..0x0005 energy) with the 50 A shunt profile in holding register 0x0003. The device stamps each of voltage, current and power with its own status token and an age; **energy gets a value and nothing else** - no `energy_wh_status`, no age token, in any of the 957 committed raw frames. Power factor and frequency (input 0x0006/0x0007) are not read by this firmware at all.

## 3. Missing, invalid and unpowered responses

| Source | Frames | With a current value | Without | Status tokens | Transport classes | rx_len |
|---|---|---|---|---|---|---|
| H7-100pct | 60 | 60 | 0 | {"(no token)": 60} | {"OK": 60} | {} |
| H7-20pct | 60 | 60 | 0 | {"(no token)": 60} | {"OK": 60} | {} |
| H7-30pct | 60 | 60 | 0 | {"(no token)": 60} | {"OK": 60} | {} |
| H7-40pct | 60 | 60 | 0 | {"(no token)": 60} | {"OK": 60} | {} |
| H7-50pct | 60 | 60 | 0 | {"(no token)": 60} | {"OK": 60} | {} |
| H7-60pct | 60 | 60 | 0 | {"(no token)": 60} | {"OK": 60} | {} |
| H7-60pct-diag1 | 20 | 20 | 0 | {"(no token)": 20} | {"OK": 20} | {} |
| H7-60pct-diag2 | 20 | 20 | 0 | {"(no token)": 20} | {"OK": 20} | {} |
| H7-60pct-shunt | 20 | 20 | 0 | {"(no token)": 20} | {"OK": 20} | {} |
| H7-70pct | 60 | 60 | 0 | {"(no token)": 60} | {"OK": 60} | {} |
| H7-80pct | 60 | 60 | 0 | {"(no token)": 60} | {"OK": 60} | {} |
| H7-90pct | 60 | 60 | 0 | {"(no token)": 60} | {"OK": 60} | {} |
| H8-A-180s | 1023 | 1010 | 13 | {"IO_ERROR": 13, "OK": 1010} | {} | {} |
| H8-B-420s | 1086 | 1085 | 1 | {"IO_ERROR": 1, "OK": 1085} | {} | {} |
| H8-C-600s-2026-10-31 | 1195 | 1195 | 0 | {"OK": 1195} | {} | {} |
| H8-D-900s | 1186 | 1186 | 0 | {"OK": 1186} | {} | {} |
| H8-E-1800s | 2915 | 2913 | 2 | {"IO_ERROR": 2, "OK": 2913} | {} | {} |
| W03-132b-off-envelope | 600 | 600 | 0 | {"OK": 600} | {} | {"29": 600} |
| W03-pzem-off-2026-10-20 | 601 | 594 | 7 | {"CRC_VALID": 594, "INVALID": 7} | {} | {"28": 1, "29": 6} |
| W04-G1-production-failclosed | 62 | 0 | 62 | {"INVALID": 61, "NO_DATA": 1} | {} | {} |
| W04-H6-10pct | 60 | 60 | 0 | {"(no token)": 60} | {"OK": 60} | {} |
| W04-H8C-box-600s | 957 | 957 | 0 | {"(no token)": 957} | {} | {} |
| W04-H8C-box-600s-raw | 957 | 957 | 0 | {"OK": 957} | {} | {} |

Reading rules that matter for this table:

* **Producer read failures are stamped, not silent.** In the H8 raw sessions 16 frames carry `current_a_status=IO_ERROR` with an **empty value cell** and an age token of `-1`: the frame still exists, so the correct reading is 'no sample', never 'zero current'. Per source: H8-A-180s 13; H8-B-420s 1; H8-E-1800s 2,
* **Host-side poll failures are recorded explicitly too.** The W03 capture is the other family: 7 of 601 rows are `quality=INVALID` with `physical_fail=1` (`received=29` six times, `received=28` once) and empty value cells. Those are missing-sample evidence, and they are why `frames_without_any_electrical_value` is 7 there rather than 0.
* **The production fail-closed build publishes no electrical value at all**: 62/62 frames label the cells `INVALID`/`NO_DATA` with the value empty. That is a declared absence by design, not a lost sample, and it is the reason a zero from the production build must never be read as a measurement.
* `rx_len=25` is a good poll in the **device-side** trace (~86-111 ms round trip, 8 echo + 17 response). The W03 host collector counts its own received length (28-29), so a byte-length threshold must never be shared between the two collectors.
* `rx_len=0` with `class=NO_RESPONSE` while the 12 V supply is off is the **expected** behaviour of an unpowered meter, not a failed MAX3485; it must not be counted as a transceiver defect.
* `ECHO_ONLY` (rx_len=8) is a retried poll: the H7 60 % diagnostic runs record exactly one each and the stage continued after the retry.
* The committed 600 s CSV has **no failed-poll signature at all** - a failed poll simply never became a row, and the rows that exist carry empty status cells. So 'no row' and 'a row with no value' and 'a row that says IO_ERROR' are three different statements, and only the second and third are visible in this dataset.

## 4. Cadence and freshness

| Source | frames with clock | median gap ms | max gap ms | late | age token | current age median ms | current age max ms |
|---|---|---|---|---|---|---|---|
| H7-100pct | 60 | 1000 | 1010 | 0 | NO |  |  |
| H7-20pct | 60 | 1000 | 1010 | 0 | NO |  |  |
| H7-30pct | 60 | 1000 | 1010 | 0 | NO |  |  |
| H7-40pct | 60 | 1000 | 1010 | 0 | NO |  |  |
| H7-50pct | 60 | 1000 | 1010 | 0 | NO |  |  |
| H7-60pct | 60 | 1000 | 1010 | 0 | NO |  |  |
| H7-60pct-diag1 | 20 | 1000 | 1010 | 0 | NO |  |  |
| H7-60pct-diag2 | 20 | 1000 | 1010 | 0 | NO |  |  |
| H7-60pct-shunt | 20 | 1000 | 1010 | 0 | NO |  |  |
| H7-70pct | 60 | 1000 | 1010 | 0 | NO |  |  |
| H7-80pct | 60 | 1000 | 1010 | 0 | NO |  |  |
| H7-90pct | 60 | 1000 | 1020 | 0 | NO |  |  |
| H8-A-180s | 1023 | 1000 | 1000 | 0 | yes | 666 | 666 |
| H8-B-420s | 1086 | 1000 | 1000 | 0 | yes | 666 | 666 |
| H8-C-600s-2026-10-31 | 1195 | 1000 | 1000 | 0 | yes | 666 | 666 |
| H8-D-900s | 1186 | 1000 | 1000 | 0 | yes | 666 | 666 |
| H8-E-1800s | 2915 | 1000 | 1000 | 0 | yes | 666 | 666 |
| W03-132b-off-envelope | 600 | 1000 | 1000 | 0 | NO |  |  |
| W03-pzem-off-2026-10-20 | 601 | 1000 | 1004 | 0 | NO |  |  |
| W04-G1-production-failclosed | 62 | 980 | 1080 | 0 | NO |  |  |
| W04-H6-10pct | 60 | 1000 | 1013 | 0 | NO |  |  |
| W04-H8C-box-600s | 957 | 1000 | 1000 | 0 | NO |  |  |
| W04-H8C-box-600s-raw | 957 | 1000 | 1000 | 0 | yes | 666 | 666 |

The committed 600 s capture runs at a 1000 ms frame period. On the wire its electrical sample is stamped **636-666 ms old** at publish time, and the BME air sample 775 ms old - so the frame that reports 'this instant' actually reports a ~0.67 s-old branch reading. In the CSV both ages and both status tokens were dropped, which is why freshness cannot be audited from the committed CSV at all and why every electrical figure taken from it must be published as `electrical_status_recorded: false`.

### Clock semantics (which clock is the sample time)

* authoritative device time: **device_ms within boot_id + seq (docs/01 18.3)**;
* docs/01 18.5: record uptime and sequence; do not manufacture false timestamp precision;
* a TTL measured on arrival does not establish a command's original age; unverifiable absolute expiry fails closed;
* docs/01 18.4: historical validity != control freshness;
* no source in this dossier uses a host wall-clock stamp as the sample time, and opening the COM port starts a new `boot_id`, so a segment of one boot is never filed as an independent run.

| Source | device clock | frames with clock | monotonic non-decreasing | host wall clock used |
|---|---|---|---|---|
| W03-132b-off-envelope | device_ms | 600 | yes | no |
| W03-pzem-off-2026-10-20 | device_ms | 601 | yes | no |
| W04-G1-production-failclosed | device_ms | 62 | yes | no |
| W04-H6-10pct | device_ms | 60 | yes | no |
| W04-H8C-box-600s | device_ms | 957 | yes | no |

## 5. ON/OFF separation and holdover patterns

| Source | DRIVEN | PRE_RUN_REGISTER | OUTPUTS_OFF_REGISTER | OFF_SETTLING | OFF_RESIDUAL_ABOVE_FLOOR | IDLE_OFF | NO_ELECTRICAL_VALUE |
|---|---|---|---|---|---|---|---|
| H7-100pct | 59 | 1 | 0 | 0 | 0 | 0 | 0 |
| H7-20pct | 59 | 1 | 0 | 0 | 0 | 0 | 0 |
| H7-30pct | 59 | 1 | 0 | 0 | 0 | 0 | 0 |
| H7-40pct | 59 | 1 | 0 | 0 | 0 | 0 | 0 |
| H7-50pct | 59 | 1 | 0 | 0 | 0 | 0 | 0 |
| H7-60pct | 59 | 1 | 0 | 0 | 0 | 0 | 0 |
| H7-60pct-diag1 | 19 | 1 | 0 | 0 | 0 | 0 | 0 |
| H7-60pct-diag2 | 19 | 1 | 0 | 0 | 0 | 0 | 0 |
| H7-60pct-shunt | 19 | 1 | 0 | 0 | 0 | 0 | 0 |
| H7-70pct | 59 | 1 | 0 | 0 | 0 | 0 | 0 |
| H7-80pct | 59 | 1 | 0 | 0 | 0 | 0 | 0 |
| H7-90pct | 59 | 1 | 0 | 0 | 0 | 0 | 0 |
| H8-A-180s | 179 | 1 | 1 | 1 | 0 | 828 | 13 |
| H8-B-420s | 419 | 1 | 1 | 0 | 0 | 664 | 1 |
| H8-C-600s-2026-10-31 | 599 | 1 | 1 | 0 | 0 | 594 | 0 |
| H8-D-900s | 899 | 1 | 1 | 1 | 0 | 284 | 0 |
| H8-E-1800s | 1799 | 1 | 1 | 0 | 0 | 1112 | 2 |
| W03-132b-off-envelope | 0 | 0 | 0 | 0 | 0 | 600 | 0 |
| W03-pzem-off-2026-10-20 | 0 | 0 | 0 | 0 | 0 | 594 | 7 |
| W04-G1-production-failclosed | 0 | 0 | 0 | 0 | 0 | 0 | 62 |
| W04-H6-10pct | 59 | 1 | 0 | 0 | 0 | 0 | 0 |
| W04-H8C-box-600s | 599 | 1 | 1 | 1 | 0 | 355 | 0 |
| W04-H8C-box-600s-raw | 599 | 1 | 1 | 1 | 0 | 355 | 0 |

Documented latency behaviour, from these captures:

* the first sample after START still holds the pre-run registers (current 0.00 with duty nonzero) - one frame per driven block;
* the first poll after outputs go off returns the **last loaded current** (7.11-7.15 A in the H8 sessions, one frame period after the last driven frame), and the poll ~1 s later reads the unwinding value (0.41-3.57 A) or 0;
* steady OFF current never exceeded **0.02 A** - one current LSB - which is the meter's own noise floor, well under the bench image's simulated `off_current_limit_a=0.200` gate;
* so the ON/OFF separation rule for any downstream feature is: drop the first frame of a driven block and the first two frames after the applied duty reaches 0, and say which frames were dropped.

### Applied duty versus measured current, frame by frame

* `applied_off_current_above_floor`: 2
* `applied_off_current_at_or_below_floor`: 1549
* `applied_on_current_at_or_below_floor`: 0
* `applied_on_current_flows`: 658
* `applied_on_current_zero`: 2
* `commanded_and_applied_differ`: 600
* `commanded_on_but_applied_zero`: 0

| Kind | source | device_ms | applied duty | current A | frame class | electrical status recorded |
|---|---|---|---|---|---|---|
| APPLIED_ON_ZERO_CURRENT | W04-H6-10pct | 2 | 100 | 0.0 | PRE_RUN_REGISTER | false |
| APPLIED_ON_ZERO_CURRENT | W04-H8C-box-600s | 226894 | 999 | 0.0 | PRE_RUN_REGISTER | false |
| APPLIED_OFF_CURRENT_ABOVE_FLOOR | W04-H8C-box-600s | 826894 | 0 | 7.15 | OUTPUTS_OFF_REGISTER | false |
| APPLIED_OFF_CURRENT_ABOVE_FLOOR | W04-H8C-box-600s | 827894 | 0 | 0.56 | OFF_SETTLING | false |

APPLIED_OFF_CURRENT_ABOVE_FLOOR frames are candidate anomalies only, and two explanations compete without this host tool choosing between them: the canonical safety class CONTROL_ELECTRICAL_ANOMALY (docs/01 22.4 'Commanded OFF + unexpected current' and 23.4 'current while state should be OFF', high severity), and the register-holdover reading in which the same values merely repeat the preceding driven frame. The anomaly option stays open, exactly as docs/01 23.5 prefers UNKNOWN over invented certainty. The 600 s capture's `device_ms=826894` frame is quoted here exactly as recorded - commanded OFF, applied duty 0, 7.15 A, an empty status cell, and every measured field identical to the two preceding driven frames - and it is **not** averaged into any peak.

### What the meter reported after each applied-OFF frame above the floor

The whole recorded decay, not only the first held frame. The applied duty stayed 0 across each row below; the walk stops at the first frame whose applied duty is not 0, and once the reported current reaches 0.0 A.

| source | device_ms | PZEM-reported current A while applied duty stayed 0 | returns to 0.0 A at device_ms |
|---|---|---|---|
| W04-H8C-box-600s | 826894 | 7.15 -> 0.56 -> 0.02 -> 0.0 | 829894 |
| W04-H8C-box-600s | 827894 | 0.56 -> 0.02 -> 0.0 | 829894 |

For the committed capture the sequence is **7.15 -> 0.56 -> 0.02 -> 0.0 A**, reaching zero at `device_ms=829894`. That decay supports register/transition lag and weakens sustained-energization, and it is recorded here exactly as the operator confirmed it on 2026-11-02 - but the recorded sequence is what the PZEM itself reported while the applied duty stayed 0; no independent instrument stands behind it, so it does not verify that the branch was de-energized and it does not settle the anomaly classification. A measured value and a verified physical current are different claims, so the safety qualification of the CONTROL_ELECTRICAL_ANOMALY candidate stays open, and a short unpowered inspection does not close it: that classification and Member D's unresolved thresholds gate the energized sessions as well.

## 6. Power consistency (A-W15-01's fourth bullet)

| Source | frames compared | mean abs delta W | max abs delta W | verdict |
|---|---|---|---|---|
| H7-100pct | 60 | 0.0429 | 0.098 | NO_MISMATCH_BEYOND_REGISTER_QUANTISATION |
| H7-20pct | 60 | 0.0529 | 0.085 | NO_MISMATCH_BEYOND_REGISTER_QUANTISATION |
| H7-30pct | 60 | 0.0546 | 0.0964 | NO_MISMATCH_BEYOND_REGISTER_QUANTISATION |
| H7-40pct | 60 | 0.0582 | 0.0936 | NO_MISMATCH_BEYOND_REGISTER_QUANTISATION |
| H7-50pct | 60 | 0.041 | 0.0987 | NO_MISMATCH_BEYOND_REGISTER_QUANTISATION |
| H7-60pct | 60 | 0.0428 | 0.098 | NO_MISMATCH_BEYOND_REGISTER_QUANTISATION |
| H7-60pct-diag1 | 20 | 0.0442 | 0.0812 | NO_MISMATCH_BEYOND_REGISTER_QUANTISATION |
| H7-60pct-diag2 | 20 | 0.0409 | 0.088 | NO_MISMATCH_BEYOND_REGISTER_QUANTISATION |
| H7-60pct-shunt | 20 | 0.0439 | 0.0975 | NO_MISMATCH_BEYOND_REGISTER_QUANTISATION |
| H7-70pct | 60 | 0.0458 | 0.0928 | NO_MISMATCH_BEYOND_REGISTER_QUANTISATION |
| H7-80pct | 60 | 0.0485 | 0.095 | NO_MISMATCH_BEYOND_REGISTER_QUANTISATION |
| H7-90pct | 60 | 0.048 | 0.0976 | NO_MISMATCH_BEYOND_REGISTER_QUANTISATION |
| H8-A-180s | 1010 | 0.009 | 0.098 | NO_MISMATCH_BEYOND_REGISTER_QUANTISATION |
| H8-B-420s | 1085 | 0.018 | 0.098 | NO_MISMATCH_BEYOND_REGISTER_QUANTISATION |
| H8-C-600s-2026-10-31 | 1195 | 0.0272 | 0.0997 | NO_MISMATCH_BEYOND_REGISTER_QUANTISATION |
| H8-D-900s | 1186 | 0.0415 | 0.0997 | NO_MISMATCH_BEYOND_REGISTER_QUANTISATION |
| H8-E-1800s | 2913 | 0.0462 | 0.0985 | NO_MISMATCH_BEYOND_REGISTER_QUANTISATION |
| W03-132b-off-envelope | 600 | 0 | 0 | NO_MISMATCH_BEYOND_REGISTER_QUANTISATION |
| W03-pzem-off-2026-10-20 | 594 | 0 | 0 | NO_MISMATCH_BEYOND_REGISTER_QUANTISATION |
| W04-H6-10pct | 60 | 0.0415 | 0.0587 | NO_MISMATCH_BEYOND_REGISTER_QUANTISATION |
| W04-H8C-box-600s | 957 | 0.0349 | 0.099 | NO_MISMATCH_BEYOND_REGISTER_QUANTISATION |
| W04-H8C-box-600s-raw | 957 | 0.0349 | 0.099 | NO_MISMATCH_BEYOND_REGISTER_QUANTISATION |

Energy counters versus the integral of reported power, per source that has a counter:

| Source | counter delta Wh | integral Wh | residual Wh | counter verdict |
|---|---|---|---|---|
| H8-A-180s | 5 | 4.3309 | 0.6691 | COUNTER_WITHIN_QUANTISATION |
| H8-B-420s | 10 | 9.9241 | 0.0759 | COUNTER_WITHIN_QUANTISATION |
| H8-C-600s-2026-10-31 | 14 | 14.1276 | -0.1276 | COUNTER_WITHIN_QUANTISATION |
| H8-D-900s | 21 | 21.1049 | -0.1049 | COUNTER_WITHIN_QUANTISATION |
| H8-E-1800s | 42 | 42.0576 | -0.0576 | COUNTER_WITHIN_QUANTISATION |
| W03-132b-off-envelope | 0 | 0 | 0 | COUNTER_WITHIN_QUANTISATION |
| W03-pzem-off-2026-10-20 | 0 | 0 | 0 | COUNTER_WITHIN_QUANTISATION |
| W04-H8C-box-600s | 14 | 14.219 | -0.219 | COUNTER_WITHIN_QUANTISATION |
| W04-H8C-box-600s-raw | 14 | 14.219 | -0.219 | COUNTER_WITHIN_QUANTISATION |

Every counter in this dataset is monotonic non-decreasing inside a boot and quantised to 1 Wh, so `COUNTER_WITHIN_QUANTISATION` is the strongest statement the data supports - and none of these counters carries a validity token.

## 7. A3 feature provenance (A-W15-02)

| Feature | Kind | Register | Validity condition | Authentic data | Computable now |
|---|---|---|---|---|---|
| branch_voltage_v | raw | input 0x0000, 0.01 V/count | status token == OK AND age within the acquisition period AND the frame is not a register-latency frame | YES in 7-qualified sources: H8-A-180s, H8-B-420s, H8-C-600s-2026-10-31, H8-D-900s, H8-E-1800s, W03-132b-off-envelope, W04-H8C-box-600s-raw | YES |
| branch_current_a | raw | input 0x0001, 0.01 A/count | same as voltage; plus the 50 A shunt profile (holding 0x0003) is what the readback recorded | YES: H8-A-180s, H8-B-420s, H8-C-600s-2026-10-31, H8-D-900s, H8-E-1800s, W03-132b-off-envelope, W04-H8C-box-600s-raw | YES |
| branch_power_w | raw | input 0x0002..0x0003 (low word first), 0.1 W/count | status OK; note the delivered CSV builder never emitted a power status column at all | YES: H8-A-180s, H8-B-420s, H8-C-600s-2026-10-31, H8-D-900s, H8-E-1800s, W03-132b-off-envelope, W04-H8C-box-600s-raw | YES |
| accumulated_energy_wh | raw | input 0x0004..0x0005 (low word first), 1.0 Wh/count | NONE PUBLISHED: the value arrives with no validity companion, so it cannot be qualified at all | values exist in H8-A-180s, H8-B-420s, H8-C-600s-2026-10-31, H8-D-900s, H8-E-1800s, W03-132b-off-envelope, W03-pzem-off-2026-10-20, W04-H8C-box-600s, W04-H8C-box-600s-raw but NONE of them are qualified (qualified sources: W03-132b-off-envelope) | NO (unqualified) |
| v_times_i_power_w | derived | computed from input 0x0000 x 0x0001 | both operands qualified and the frame is DRIVEN | YES for the raw operands; the derived column agrees with reported power inside quantisation | YES |
| energy_delta_wh | derived | difference of input 0x0004..0x0005 across a run | same boot_id, monotonic counter, run boundaries known | YES: committed 600 s capture 108 -> 122 Wh (delta 14 Wh) against a 14.219 Wh trapezoidal integral of power | YES, but resolution-limited |
| specific_power_w_per_kelvin | derived | power register / thermal channels | power qualified AND the thermal channel OK AND the sensor position frozen | PARTIAL - one 600 s committed run at one duty level only | NO for a duty-resolved model |
| power_factor / frequency | raw-register-not-published | input 0x0006 (power factor) / 0x0007 (frequency) on the PZEM-017 - NOT read by this firmware, which reads 6 input registers (cg_modbus.py INPUT_REGISTER_COUNT) | n/a | NO | NO |
| electrical_quality / producer liveness | derived | host-side classification of the frames | requires the delivered schema's liveness counters, which the bench image's line does not emit | NO bench capture carries them; the W05 fixture shows them as a host scenario | NO from authentic data |

Machine-readable version, including the caveats: `a3-feature-provenance.csv`.

## 8. A-W15-03 - reference check against an independent meter

Trusted independent meter available: **NO**.
Reported instead: *plausibility and internal consistency*.

* no calibration record for the PZEM-017 and none for the 50 A / 75 mV shunt exists in this repository (the shunt was seen in a photo only, SOURCE VERIFIED, never calibrated)
* V x I agreement: worst 0.099 W against a 0.18 W quantisation tolerance, 0 frames beyond tolerance in 4 committed sources
* energy agreement per source: W03-132b-off-envelope counter 0 Wh vs integral 0 Wh (COUNTER_WITHIN_QUANTISATION); W03-pzem-off-2026-10-20 counter 0 Wh vs integral 0 Wh (COUNTER_WITHIN_QUANTISATION); W04-H8C-box-600s counter 14 Wh vs integral 14.219 Wh (COUNTER_WITHIN_QUANTISATION)
* resolution limits: V 0.01 V, I 0.01 A, P 0.1 W, E 1.0 Wh - a 1 Wh counter and a 0.1 W register cannot resolve a short-run efficiency difference; only run-integral comparisons are meaningful

Certified calibration: **no**. Status label: **NEED_USER_ACTION** - one trusted reference meter (or a calibrated shunt channel) measured at several duty points against the PZEM, recorded in the same session.

## 9. What could not be computed, and why

* power factor / frequency features: the firmware never reads those registers, so no capture contains them;
* producer liveness counters (`power_beats`, `power_max_gap_ms`, `electrical_quality`): a delivered-schema concept that the bench image's line does not emit, so it exists only in the W05 host fixture;
* a duty-resolved electrical model from committed data alone: the ladder is local-bench only;
* stale-versus-fresh separation inside the committed CSV: its status and age columns are empty/absent;
* any calibration statement: no reference instrument, no shunt calibration.
