minhqng/predictive-cold-chain-aiot/docs/04-team-execution-plan-coldguard.md

# COLDGUARD — HỆ THỐNG BẢO VỆ CHUỖI LẠNH CHỦ ĐỘNG
## Team Execution Plan · 24-Week Delivery · Ownership · Dependencies · Gates · Evidence

> **Document:** `docs/04-team-execution-plan.md`  
> **Course:** Internet of Things (IoT) — Course Project / Bài tập lớn  
> **Project:** **ColdGuard — Hệ thống bảo vệ chuỗi lạnh chủ động**  
> **Type:** Team Execution Plan + Delivery Governance + Integration/Review Contract  
> **Status:** **PROPOSED FREEZE v1.0 — REVIEW CANDIDATE**  
> **Baseline date:** **2026-09-29**  
> **Team size:** **4 members**  
> **Planning horizon:** **24 weeks**  
> **Parents:**  
> `00-project-scope-architecture.md` — project thesis, architecture, exact purchased BOM baseline and scope.  
> `01-physical-measurement-correctness-contract.md` — physical authority, measurement semantics, legal states and safety invariants.  
> `02-aiot-closed-loop-engineering.md` — firmware, MQTT, backend/twin, inference, command, SAFE_LOCAL and recovery semantics.  
> `03-verification-experiments-demo.md` — commissioning tests, experiment design, statistical analysis, evidence and demo/defense proof.  
> **Children:**  
> `05A-member-a-embedded-thermal.md`  
> `05B-member-b-ai-experimental-data.md`  
> `05C-member-c-iot-backend-digital-twin.md`  
> `05D-member-d-control-security-resilience.md`  
> **Normative role:** source of truth for ownership, 24-week chronology, dependency graph, integration order, review rules, work-item taxonomy, release gates, handoff deadlines, workload accounting, scope-cut order, leader audit and final delivery preparation.  
> **Not source of truth for:** physical/correctness semantics (`01`), runtime protocol semantics (`02`), experiment/statistical meaning (`03`). If schedule conflicts with correctness or evidence, **Docs 00–03 win**.  
> **Execution principle:** work is organized around **proof-bearing vertical increments**. A risky mechanism is not considered delivered until the member can demonstrate implementation, quantitative evidence, integration and reproducibility in the same phase.

> **Team north star.**  
> **By Week 24, all four members must be able to start or reconstruct the system from a clean environment, identify the exact frozen hardware configuration, explain the complete sensing→prediction→policy→actuation→verification loop, reproduce at least one failure/resilience proof, trace one physical A/B experiment from raw telemetry to statistical result, and defend why the final claims are limited to what the evidence actually supports.**

---

# 0. Executive plan

## 0.1 Team structure

### Member A — Embedded & Thermal Systems

Primary ownership:

```text
exact purchased hardware testbed
ESP32-S3R2 primary controller
DS18B20 ×3
BME280
MC-38
PZEM-017
50 A / 75 mV shunt
MAX3485
IBT-2
TEC1-12715 exact purchased SKU
V1 thermal assembly
HS2 6 L chamber
12 V / 33 A power architecture
fuses / wiring / distribution
physical commissioning
sensor identity / placement
plant characterization
repeatable disturbance
physical response evidence
```

Secondary/cross-cutting:

```text
firmware acquisition quality
hardware configuration versioning
physical A/B campaign execution
final physical demo
```

North star:

> **Turn the purchased prototype into a safe, repeatable, measurable physical plant whose data are trustworthy.**

---

### Member B — AI & Experimental Data

Primary ownership:

```text
data quality analysis
dataset manifests
run-level split
label protocol
temporal features
threshold/hysteresis analytical baseline
XGBoost
prediction horizon selection
probability calibration when justified
predictive metrics
ablation
locked holdout
paired A/B statistics
confidence intervals
model card
scientific result package
```

Secondary/cross-cutting:

```text
experiment-design review
effect-size/sample-size planning
data leakage audit
report methodology/results
```

North star:

> **Prove predictive usefulness honestly without leakage, inflated sample size or score-only storytelling.**

---

### Member C — IoT Backend & Digital Twin

Primary ownership:

```text
Mosquitto / MQTT
TLS-ready broker configuration
message identity
ingestion validation
raw immutable telemetry
PostgreSQL / TimescaleDB
run metadata
reported/desired/derived twin
event/audit timeline
command lifecycle persistence
API
realtime
prediction integration
replay / duplicate / out-of-order
backup / restore
observability
Docker Compose / reproducible deployment
```

Secondary/cross-cutting:

```text
schema integration
experiment export
closed-loop traceability
demo operational reliability
```

North star:

> **Make every physical sample, prediction, command and response reconstructable end to end.**

---

### Member D — Control, Security & Resilience

Primary ownership:

```text
safety hierarchy
policy state machine
Controller A reactive baseline
Controller B predictive policy
command validation
TTL/freshness/idempotency rules
cooling-health interpretation
electrical/thermal verification rules
SAFE_LOCAL
degraded modes
network/backend/AI outage behavior
identity / TLS / ACL / backend authorization
security negative tests
resilience campaign
final safety case
```

Secondary/cross-cutting:

```text
physical control review
threat model
A/B intervention policy
defense of safety/resilience claims
```

North star:

> **No prediction may become an unsafe or unaudited physical action.**

---

## 0.2 Why this ownership split is balanced

The split follows **authority and risk boundaries**, not feature count.

A's hard problem:

```text
physical uncertainty + electrical/thermal safety + repeatability
```

B's hard problem:

```text
small independent N + temporal dependence + leakage + honest inference
```

C's hard problem:

```text
identity + ordering + durable evidence + state reconciliation
```

D's hard problem:

```text
turn prediction into bounded action under failure and adversarial/stale inputs
```

The domains have different line counts but comparable engineering/research depth.

---

## 0.3 Workload envelope

Planned focused project effort:

| Member | Core hours | Average/week | Heaviest region |
|---|---:|---:|---|
| **A** | **~276 h** | **11.5 h/week** | W3–W4, W18–W20 |
| **B** | **~278 h** | **11.6 h/week** | W10–W11, W18–W20 |
| **C** | **~279 h** | **11.6 h/week** | W5–W6, W17–W20 |
| **D** | **~279 h** | **11.6 h/week** | W17–W20 |
| **Team** | **~1112 h** | **~46.3 h/week** | W17–W20 |

This includes:

- technical study directly supporting the project;
- implementation;
- physical lab work;
- test/evidence creation;
- integration;
- review;
- report/demo preparation.

It excludes:

- unrelated lecture study;
- general coursework;
- optional features after scope-cut;
- waiting time while chamber passively resets unless the member is actively operating/analyzing.

This is a capacity reservation, not a requirement to consume every hour.

---

## 0.4 Six-phase delivery model

| Phase | Weeks | Main question |
|---|---:|---|
| **P0 — Freeze & Physical Foundation** | **W01–W04** | Is the exact purchased system safe, understood and technically connectable? |
| **P1 — Stable IoT Baseline** | **W05–W08** | Can sensing, storage, reactive control and SAFE_LOCAL operate reproducibly? |
| **P2 — Dataset + Reactive Benchmark** | **W09–W12** | Can repeatable runs support baseline/XGBoost/diagnosis without leakage? |
| **P3 — Predictive Readiness + Resilience** | **W13–W16** | Does prediction provide useful warning, and is the system safe under failure? |
| **P4 — Predictive Closed Loop + A/B** | **W17–W20** | Can prediction safely change the plant and improve a matched physical outcome? |
| **P5 — Evidence Freeze + Defense** | **W21–W24** | Can another reviewer reproduce, audit and defend the entire evidence chain? |

---

## 0.5 Project critical path

```text
Docs 00–03 freeze
      ↓
A: exact hardware commissioning
      ↓
A: repeatable 6 L plant
      ↓
C: stable identity/raw telemetry/twin
      ↓
D: Controller A + SAFE_LOCAL
      ↓
A+C: valid experiment data path
      ↓
B: grouped baseline + XGBoost
      ↓
B+D: actionable warning / policy semantics
      ↓
C+D: shadow closed-loop trace
      ↓
A+D: Controller B physical enablement
      ↓
A+B+C+D: matched A/B campaign
      ↓
B: paired statistics / uncertainty
      ↓
team: evidence / demo / defense
```

---

## 0.6 Highest-risk critical path

The most schedule-sensitive chain is:

```text
PZEM / IBT-2 / V1 / TEC commissioning
→ repeatable S2 door disturbance
→ leakage-safe predictive evidence
→ command + physical verification
→ Controller B enablement
→ final paired A/B runs
```

If this path slips:

1. stop optional PWM/energy work;
2. stop deep-model work;
3. stop UI polish;
4. reassign reviewer capacity;
5. preserve W23–W24 evidence/defense buffer.

---

# 1. Delivery philosophy

## 1.1 Proof-bearing vertical increments

Bad plan:

```text
W1–W10 everyone codes own subsystem
W11 integrate
W18 test
W23 discover hardware/model mismatch
```

Preferred:

```text
small physical path
→ connect digital path
→ force failure
→ verify evidence
→ expand
```

Example:

```text
one real telemetry snapshot
→ MQTT
→ raw DB
→ twin
→ dashboard
```

exists before polishing the complete UI.

Another:

```text
one legal ON command
→ ACK
→ PZEM current
→ thermal response
```

exists before enabling AI control.

---

## 1.2 Risk-first sequencing

Implementation priority:

```text
1. electrical / thermal safety
2. stable sensor identity
3. PZEM electrical observability
4. repeatable plant dynamics
5. raw data provenance
6. Controller A + SAFE_LOCAL
7. leakage-safe model
8. command physical verification
9. Controller B
10. final A/B evidence
11. energy/deep-model/security hardening extras
```

---

## 1.3 Test accompanies mechanism

When introducing:

```text
PZEM
```

also implement:

```text
50 A range proof
OFF envelope
reference/plausibility check
```

When introducing:

```text
QoS 1
```

also test:

```text
duplicate delivery
```

When introducing:

```text
command TTL
```

also send:

```text
expired command
```

When introducing:

```text
XGBoost
```

also run:

```text
grouped split + leakage audit + baseline
```

Never defer all verification to W23.

---

## 1.4 Correctness outranks schedule

If `04` says:

```text
enable predictive actuation in W18
```

but Gate D in `03` is red:

```text
predictive actuation remains disabled
```

The schedule slips.

The safety rule does not.

---

# 2. Work-item / tracker operating model

The tracker mirrors this plan.

GitHub currently supports:

- parent/sub-issue hierarchies;
- issue dependencies;
- milestones/labels;
- Project fields.

Use those relationships instead of manually maintaining a second dependency spreadsheet.

---

## 2.1 Hierarchy

```text
Phase
  → Week parent issue
      → Member issue pack
          → implementation / experiment sub-issues
```

Example:

```text
W08 — Physical + Data Baseline Gate
  ├─ A-W08 Repeatability + Gate A evidence
  ├─ B-W08 Dataset readiness + Gate B
  ├─ C-W08 Platform soak / recovery
  └─ D-W08 SAFE_LOCAL integration
```

---

## 2.2 Recommended fields

```text
Status
Owner
Week
Phase
Priority
EstimateHours
ActualHours
Risk
ParentDoc
Gate
TestID
Reviewer
Evidence
BlockedBy
HardwareConfig
```

---

## 2.3 Status values

Use:

```text
Backlog
Ready
In Progress
In Review
Evidence
Done
Blocked
Cut
```

Avoid:

```text
almost done
basically working
testing later
```

---

## 2.4 Priority

```text
P0-BLOCKER
P0
P1
P2
```

`P0-BLOCKER`:

- active release gate cannot pass;
- optional work stops.

---

## 2.5 WIP limit

Per member:

```text
max 2 implementation issues In Progress
```

Team:

```text
max 1 unresolved critical architecture/correctness question on the main path
```

A member may wait on physical reset while doing analysis/review, but should not accumulate unrelated half-finished features.

---

# 3. Git / review baseline

## 3.1 Branching

Member C uses one feature branch and one pull request per week. All tasks for
that week land together after software verification.

Recommended:

```text
main
feature/<issue-id>-<short-name>
fix/<issue-id>-<short-name>
experiment/<id>-<short-name>
```

Avoid semester-long:

```text
person-a
person-b
person-c
person-d
```

branches.

---

## 3.2 Merge rule

Nontrivial P0 change:

- pull request;
- the assigned member owns implementation and verifies the change;
- required tests/evidence where applicable;
- no unresolved correctness question.

Peer review is optional. Technical verification and applicable safety and
evidence gates are required. Record human approval only when it occurred.

---

## 3.3 Reviewer matrix

| Area | Primary | Suggested peer reviewer |
|---|---|---|
| Physical wiring / pin / sensing | A | D |
| PZEM/IBT-2 actuation path | A | D |
| Dataset/split/label | B | A or C |
| Feature/model/evaluation | B | D |
| MQTT/schema/twin/storage | C | A |
| Command lifecycle / replay | C | D |
| Policy / Controller A/B | D | A |
| Security/ACL | D | C |
| A/B methodology | B | A + D |
| Final evidence trace | shared | ≥2 members |

---

## 3.4 PR evidence template

```text
Issue:
Parent docs:
What changed:
Invariant / claim affected:
Hardware config affected?:
Test IDs:
Evidence path:
Reviewer focus:
Known limitation:
Out of scope:
```

---

# 4. Definition of Ready

An issue is `Ready` only when:

```text
[ ] parent doc section is known
[ ] owner is known
[ ] dependency is available or a valid fixture/simulator exists
[ ] expected output is explicit
[ ] test/evidence is named
[ ] hardware impact is understood
[ ] no member is forced to invent missing semantics
```

If not:

> design/research issue first, implementation issue later.

---

# 5. Definition of Done

The team uses one shared quality definition.

The official Scrum Guide describes Definition of Done as the formal state at which an increment meets required quality measures and creates shared transparency.

ColdGuard adapts that concept to an academic cyber-physical project.

---

## 5.1 Ordinary software issue

```text
[ ] implementation complete
[ ] local tests green
[ ] integration test when boundary matters
[ ] docs/contracts still agree
[ ] logs/errors safe and understandable
[ ] assigned owner verified the change and applicable safety/evidence gates
[ ] no hidden TODO in P0 path
```

---

## 5.2 Physical/hardware issue

Additionally:

```text
[ ] physical configuration recorded
[ ] measurement evidence exists
[ ] safety check passed
[ ] actual measured value recorded where required
[ ] repeatability checked where required
[ ] photo/diagram/version stored
```

---

## 5.3 ML/data issue

Additionally:

```text
[ ] run-level independence preserved
[ ] leakage audit
[ ] baseline comparison
[ ] versioned feature/model artifact
[ ] metric unit clearly stated
[ ] reproducible script/notebook
```

---

## 5.4 Control/security issue

Additionally:

```text
[ ] failure/negative case
[ ] stale/duplicate behavior considered
[ ] no direct AI→actuator bypass
[ ] authoritative final state asserted
[ ] evidence stored
```

---

## 5.5 Week complete

A week is GREEN only if:

```text
exit criteria
+
required evidence
+
required handoff
+
integration check
```

are complete.

“Code written” is not week completion.

---

# 6. Ownership matrix

| Subsystem / artifact | Primary | Reviewer | Backup understanding |
|---|---|---|---|
| exact BOM / hardware config | A | D | all |
| DS18B20/BME/door | A | C | D |
| PZEM/MAX3485 | A | C | D |
| IBT-2/TEC/V1 | A | D | C |
| physical characterization | A | B | D |
| run validity physical side | A | B | D |
| raw dataset QA | B | C | A |
| split/label/feature | B | D | C |
| XGBoost/model card | B | D | C |
| statistics/A-B analysis | B | A | D |
| MQTT/broker | C | D | A |
| DB/twin | C | A | B |
| command persistence/ACK audit | C | D | A |
| backup/deployment | C | A | D |
| Controller A | D | A | B |
| Controller B | D | B | A |
| SAFE_LOCAL | D + A | C | B |
| security ACL/authz | D | C | A |
| resilience campaign | D | C | A |
| final closed-loop trace | shared | all | all |

---

# 7. Evidence ownership matrix

| Evidence family | Owner |
|---|---|
| H0–H7 commissioning | A |
| sensor/calibration records | A |
| data QA/split manifest | B |
| model metrics/calibration/ablation | B |
| raw ingestion/twin/command logs | C |
| replay/duplicate/backend recovery | C |
| policy decisions/safety tests | D |
| SAFE_LOCAL/security tests | D |
| H8 closed-loop proof | A+C+D |
| final paired A/B | A+B+C+D |
| final statistics | B |
| final claim→artifact index | C + leader |
| final defense evidence selection | all |

---

# 8. Critical dependency graph

```text
Docs 00–03
   ↓
A: H0–H4 physical bring-up
   │
   ├────────────→ C: schema/broker/DB with simulator
   │                    ↓
   └→ A: H5–H7 plant ─→ C: real telemetry/twin
              │                  ↓
              │             D: Controller A
              │                  ↓
              ├────────────→ A+D: SAFE_LOCAL
              │
              └→ A: repeatable S1/S2
                         ↓
                      B: QA
                         ↓
                 B: grouped baseline
                         ↓
                    B: XGBoost
                         ↓
                  B: locked evidence
                         ↓
                B+D: predictive policy
                         ↓
                  C+D: shadow mode
                         ↓
                  A+D: Controller B
                         ↓
                A/B final campaign
                         ↓
                 B statistical proof
                         ↓
                 final evidence/demo
```

---

# 9. Blocking rules

## A blocks B

B may develop synthetic pipelines early.

B may **not** claim real predictive evidence until:

- Gate A physical;
- repeated valid runs;
- hardware config stable enough.

---

## A blocks D

D may write policy logic early.

D may **not** enable physical Controller B until:

- A has safe actuation envelope;
- H8 reactive closed-loop works.

---

## C blocks B

B can analyze exported CSV manually during early development.

Final online model/evidence requires:

- stable raw identity;
- run manifests;
- reproducible export.

---

## B blocks D

D can implement Controller A without B.

Controller B requires:

- frozen model version;
- feature/horizon semantics;
- warning threshold/persistence.

---

## D blocks final A/B

No final predictive intervention before:

- command safety;
- shadow mode;
- SAFE_LOCAL;
- response verification.

---

# 10. Cross-member handoff contracts

## 10.1 A → C

A supplies:

```text
device_id
boot_id
seq
physical schema fields
quality flags
hardware_config_id
firmware_version
calibration_id
applied actuator state
```

Handoff evidence:

- sample telemetry;
- schema fixture;
- real device capture.

---

## 10.2 A → B

A supplies:

```text
valid run IDs
physical scenario semantics
sensor positions
disturbance timestamps
calibration/config
invalid-run reasons
plant response characterization
```

B does not infer missing physical meaning from column names.

---

## 10.3 A → D

A supplies:

```text
safe operating envelope
healthy current/power range
OFF envelope
thermal response window
actuator delay
fault behavior
```

D does not invent safety thresholds before measurement.

---

## 10.4 C → B

C supplies:

```text
versioned export
run manifest
raw/normalized data
event timeline
dataset checksum
```

---

## 10.5 B → C

B supplies:

```text
feature_version
model_version
model artifact/hash
horizon
risk-score/probability semantics
inference input/output contract
```

---

## 10.6 B → D

B supplies:

```text
warning threshold
persistence recommendation
false-warning behavior
EWT distribution
AIW evidence inputs
model limitations
```

D decides action policy.

---

## 10.7 D → C

D supplies:

```text
policy_version
command reason codes
TTL/freshness
state machine
verification state
security rules
```

C persists/transports these semantics.

---

## 10.8 D → A

D supplies device-side requirements:

```text
allowed command range
local fallback thresholds
expiry handling
idempotency
SAFE_LOCAL mode transitions
```

A implements physical edge behavior.

---

# 11. Integration freeze rules

## 11.1 End W4 — physical/protocol draft freeze

Freeze enough for W5 parallel work:

- physical signal names;
- device identity;
- single cooling branch semantics;
- initial MQTT topics;
- command/ACK shape v0.

Breaking change later requires explicit review.

---

## 11.2 End W8 — baseline integration freeze

Freeze:

- telemetry schema v1;
- run identity;
- hardware config;
- Controller A interface;
- SAFE_LOCAL contract;
- DB/twin baseline.

---

## 11.3 End W12 — dataset/control baseline freeze

Freeze:

- experiment protocol;
- critical-state label family;
- baseline metrics;
- Controller A;
- diagnosis semantics.

---

## 11.4 End W16 — predictive freeze

Freeze before final closed-loop campaign:

- feature version;
- model;
- primary horizon;
- model operating threshold;
- calibration semantics;
- policy version;
- Controller B;
- A/B primary outcomes.

---

## 11.5 W17 onward

No architecture redesign unless:

- safety defect;
- correctness defect;
- irreproducible experiment;
- severe implementation bug.

Optional improvement waits until after core campaign.

---

# 12. Weekly team cadence

## Week start — 30–45 min

Review:

```text
previous exit
gate status
current blockers
invalid evidence
Ready issues
review assignments
critical path
```

No slide deck.

---

## Midweek integration — 30–60 min

Run at least one actual cross-boundary path.

Examples:

```text
real ESP telemetry → DB
command → ACK
model → policy shadow
```

---

## End-of-week review — 45–75 min

Leader checks:

```text
objective
artifact
quantitative evidence
integration
handoff
actual hours
risk
GREEN/YELLOW/RED
```

---

## Async update

Compact:

```text
Closed:
In progress:
Blocked:
Evidence:
Need review:
```

---

# 13. Leader weekly audit checklist

For each member:

```text
[ ] required artifact exists
[ ] evidence is quantitative where applicable
[ ] version/config is recorded
[ ] acceptance criterion actually passed
[ ] handoff consumer can use the output
[ ] blocker has owner
[ ] no silent scope/hardware change
[ ] next-week dependency is Ready
```

For the team:

```text
[ ] critical path remains viable
[ ] no doc authority conflict
[ ] no invalid evidence hidden
[ ] optional work has not displaced P0
```

---

# 14. Health classification

## GREEN

- week exit complete;
- gate stable;
- no critical dependency blocked.

## YELLOW

- one important item late;
- workaround/fixture exists;
- no safety/correctness ambiguity.

## RED

- physical safety uncertainty;
- repeatability failure;
- schema/correctness disagreement;
- leakage detected;
- critical path >1 week late;
- required integration cannot run.

When RED:

```text
optional P1/P2 work = 0
```

until root issue understood.

---

# 15. Blocker escalation

## >2 focused hours

Write exact issue:

```text
expected
observed
reproduction
evidence
what was tried
which doc contract applies
```

Ask reviewer.

---

## >1 working day

Parent week becomes YELLOW.

Lead decides:

- pair;
- reassign;
- use fixture;
- scope cut.

---

## >1 week on critical path

Parent phase is RED.

Immediately:

- freeze optional work;
- protect final-campaign buffer;
- revise downstream week issue packs.

---

# 16. WEEK 01 — Shared freeze, BOM audit and execution setup
**Team planned effort: ~42 h**  
A: **11 h** · B: **10 h** · C: **11 h** · D: **10 h**

## Objective

All four members operate from the same Docs 00–03 and the exact current purchased hardware configuration.

---

## Team tasks

### TEAM-W01-01 — Read/freeze Docs 00–03

Each member writes a short summary:

```text
own authority
top 5 invariants
top 5 dependencies
top 3 risks
evidence responsibilities
```

### TEAM-W01-02 — Hardware inventory audit

A leads.

Verify all 24 purchased items physically against Docs 00–01.

No electrical power required.

### TEAM-W01-03 — Repo and tracker skeleton

Create:

```text
docs/
firmware/
backend/
ml/
frontend/
infra/
experiments/
tests/
evidence/
```

Set project fields/status.

### TEAM-W01-04 — Oral architecture walkthrough

All answer:

1. Why one TEC?
2. What does PZEM prove?
3. Why ACK is not physical success?
4. Who owns `reported` state?
5. Why rows are not independent samples?
6. What happens if broker disappears?

---

## Member A

- physical BOM audit;
- board/module visual identification;
- hardware risk ledger;
- proposed GPIO review;
- sensor labels.

Deliver:

```text
hardware-audit-w01.md
photos
risk register
```

---

## Member B

- freeze central RQs and ML claim boundaries;
- create data dictionary draft from Docs 01–02;
- identify leakage risks;
- define dataset artifact convention.

---

## Member C

- backend architecture decision draft;
- broker/database/container plan;
- telemetry/command schema fixtures v0;
- environment bootstrap plan.

---

## Member D

- safety hierarchy review;
- threat/control boundary;
- command safety checklist;
- failure-mode ledger.

---

## Exit

```text
[ ] Docs 00–03 accepted as implementation baseline
[ ] exact BOM physically reconciled
[ ] no legacy INA226/2-TEC/20-L assumptions remain
[ ] ownership agreed
[ ] tracker active
[ ] no authority disagreement
```

---

## Leader review

Focus:

- Does every member understand the new hardware?
- Did anyone copy an old two-channel schema?
- Are missing seller/module details correctly marked commissioning-derived?

---

# 17. WEEK 02 — Mechanical/sensor foundation + digital skeleton
**Team planned effort: ~44 h**  
A: **12 h** · B: **10 h** · C: **11 h** · D: **11 h**

## Objective

Create safe non-TEC physical foundation and reproducible digital infrastructure.

---

## A

Execute:

```text
H0 mechanical
H1 sensor subsystem
```

- mount V1/TEC mechanically without powered TEC test;
- freeze T1/T2/T3 positions;
- discover DS18B20 ROM IDs;
- BME read;
- MC-38 polarity;
- sensor consistency check.

Evidence:

```text
H0/H1 package
ROM map
placement photo
```

---

## B

- dataset schema validator;
- synthetic run generator;
- grouped split prototype;
- label mechanics with synthetic trajectory;
- experiment manifest parser.

No real model result yet.

---

## C

- Mosquitto + PostgreSQL/Timescale Compose;
- backend skeleton;
- raw table migration;
- MQTT simulator;
- TLS-ready configuration structure.

Test:

```text
clean compose up
synthetic telemetry → raw DB
```

---

## D

- threat model v0;
- policy state-machine skeleton;
- SAFE_LOCAL contract review with A;
- command validation rules draft.

---

## Team integration

Synthetic device uses same schema intended for A's real firmware.

---

## Exit

```text
[ ] H0/H1 safe
[ ] sensor identities stable
[ ] broker/db/backend boots from clean environment
[ ] synthetic telemetry persisted
[ ] control/safety boundary documented
```

---

# 18. WEEK 03 — PZEM/RS-485 + immutable ingestion + experiment design
**Team planned effort: ~47 h**  
A: **14 h** · B: **10 h** · C: **12 h** · D: **11 h**

## Objective

Establish electrical observation and experiment/data correctness before high-power TEC work.

---

## A

Execute:

```text
H2 logic power
H3 PZEM / MAX3485
H4 IBT-2 logic partial
```

Tasks:

- XL4015 5 V verify;
- MAX3485 3.3 V;
- PZEM Modbus;
- 50 A profile;
- OFF envelope;
- 8N1/8N2 actual revision check;
- IBT-2 default-off logic without unsafe high-load assumptions.

---
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
