minhqng/predictive-cold-chain-aiot/evidence/A/W01/photos/02-rs485-front.jpg

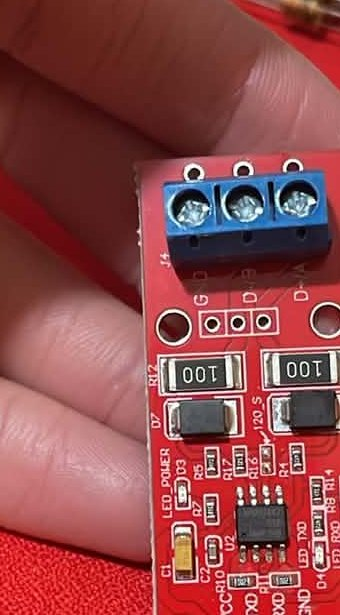
evidence/A/W01/photos/02-rs485-front.jpg
