minhqng/predictive-cold-chain-aiot/evidence/A/W01/photos/03-rs485-back.jpg

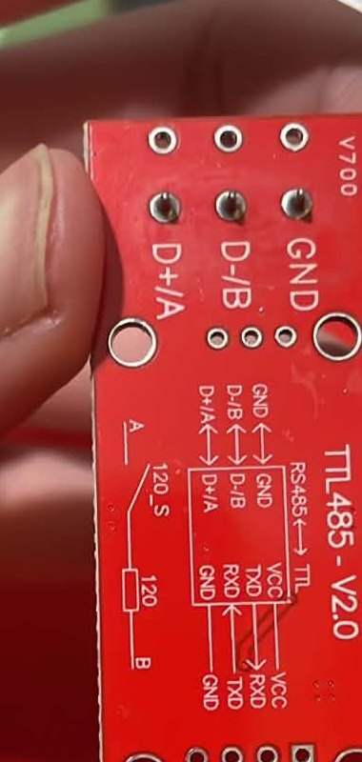
evidence/A/W01/photos/03-rs485-back.jpg
