minhqng/predictive-cold-chain-aiot/evidence/A/W01/photos/04-pzem-shunt.jpg

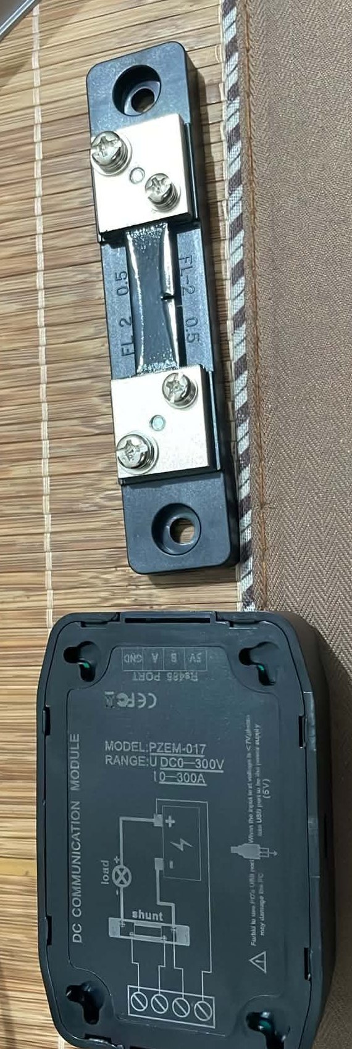
evidence/A/W01/photos/04-pzem-shunt.jpg
