minhqng/predictive-cold-chain-aiot/evidence/A/W01/photos/05-pzem-terminals.jpg

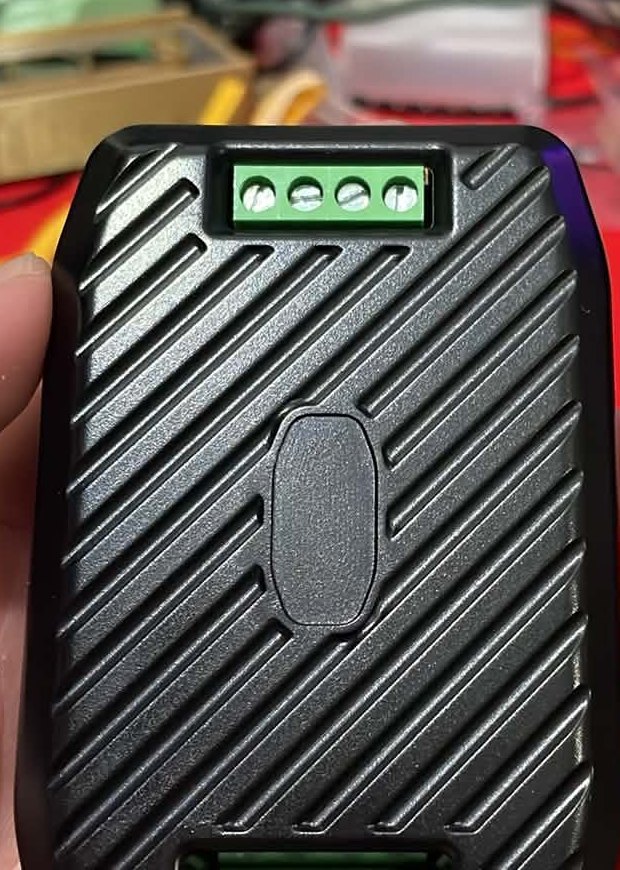
evidence/A/W01/photos/05-pzem-terminals.jpg
