minhqng/predictive-cold-chain-aiot/evidence/A/W01/photos/06-xl4015.jpg

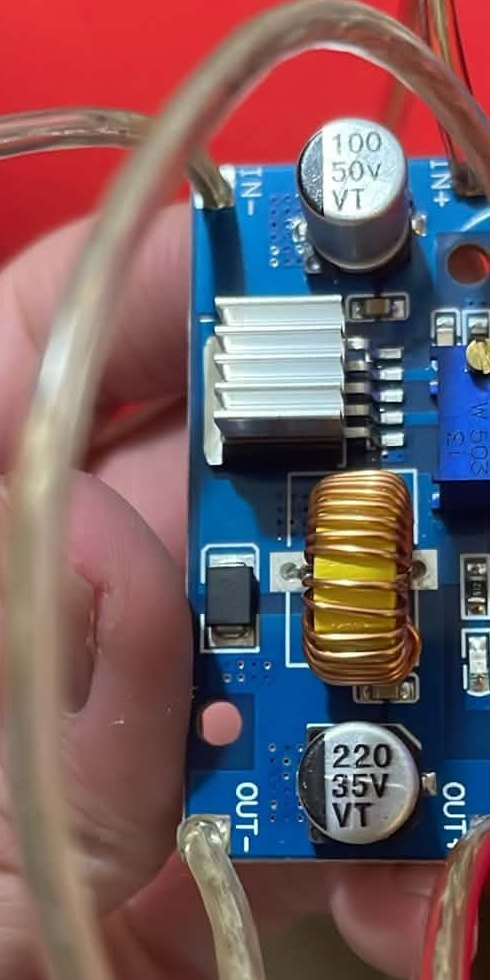
evidence/A/W01/photos/06-xl4015.jpg
