minhqng/predictive-cold-chain-aiot/evidence/A/W01/photos/07-fusebox.jpg

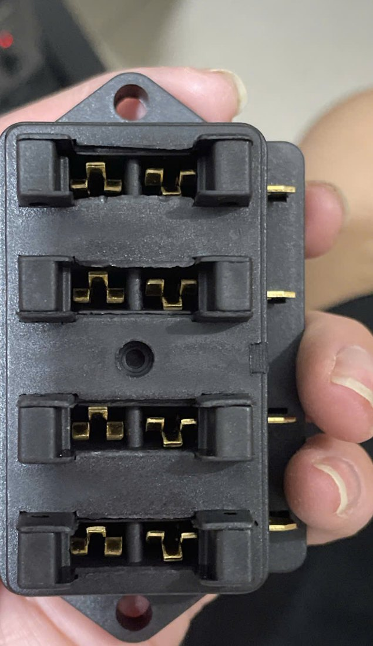
evidence/A/W01/photos/07-fusebox.jpg
