minhqng/predictive-cold-chain-aiot/evidence/A/W01/photos/08-terminal-block.jpg

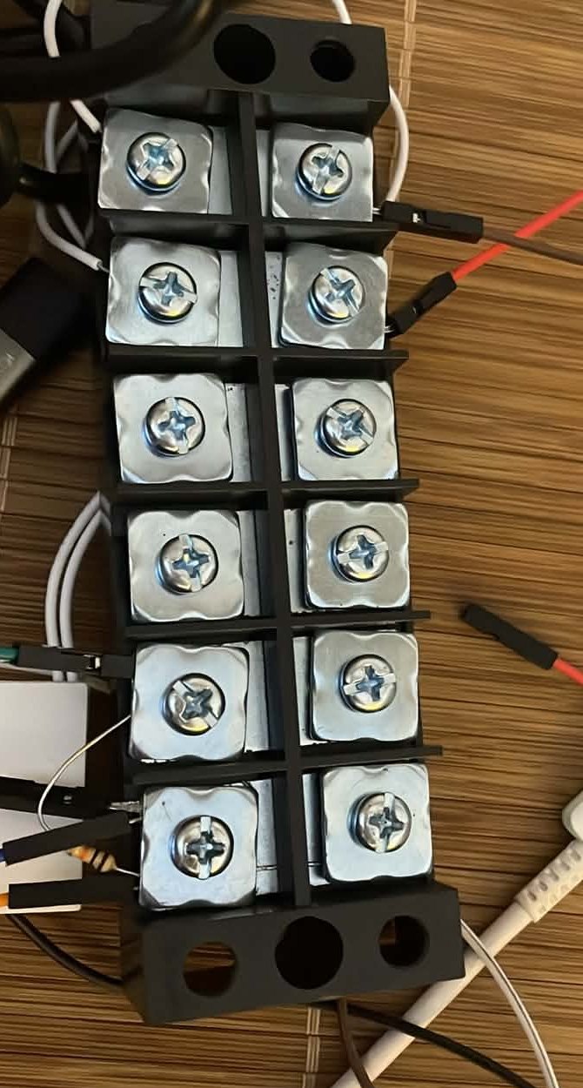
evidence/A/W01/photos/08-terminal-block.jpg
