minhqng/predictive-cold-chain-aiot/evidence/A/W01/photos/09-psu-output.jpg

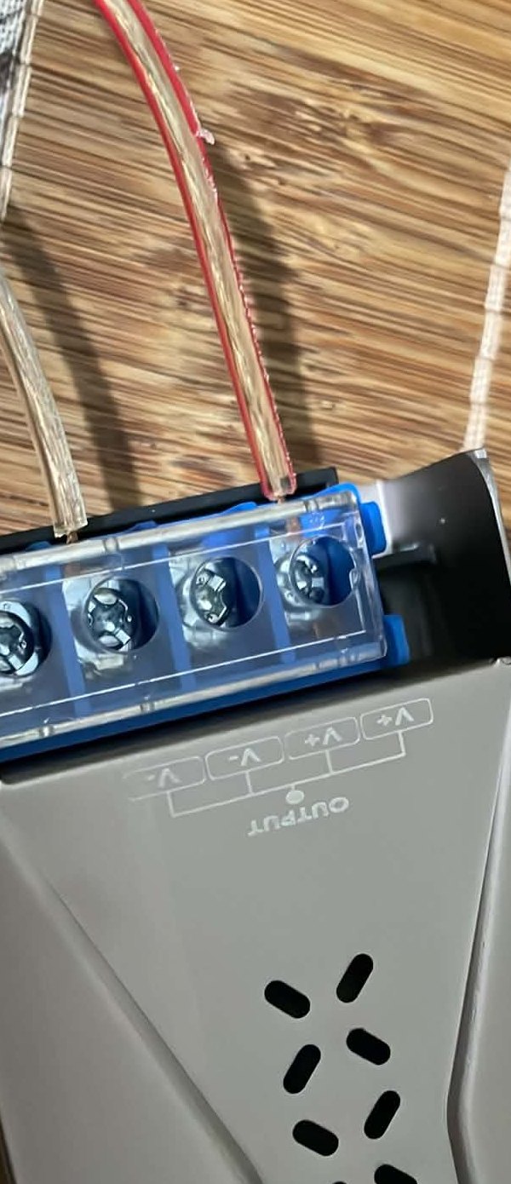
evidence/A/W01/photos/09-psu-output.jpg
