minhqng/predictive-cold-chain-aiot/evidence/A/W01/photos/10-fan-label.jpg

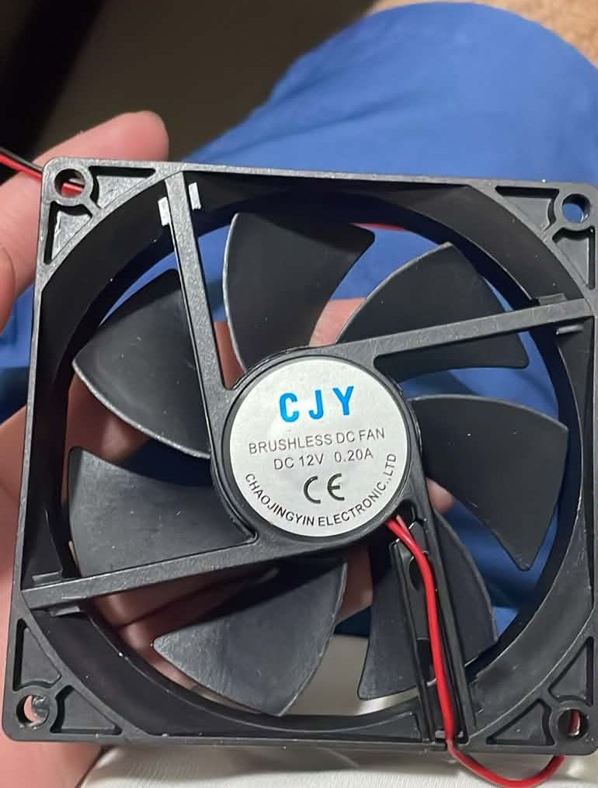
evidence/A/W01/photos/10-fan-label.jpg
