minhqng/predictive-cold-chain-aiot/evidence/A/W01/photos/12-ds18b20-probe-actual.jpg

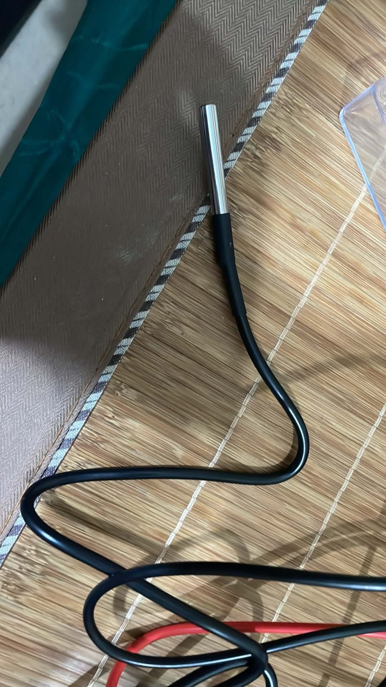
evidence/A/W01/photos/12-ds18b20-probe-actual.jpg
