minhqng/predictive-cold-chain-aiot/evidence/A/W01/photos/13-mc38-actual.jpg

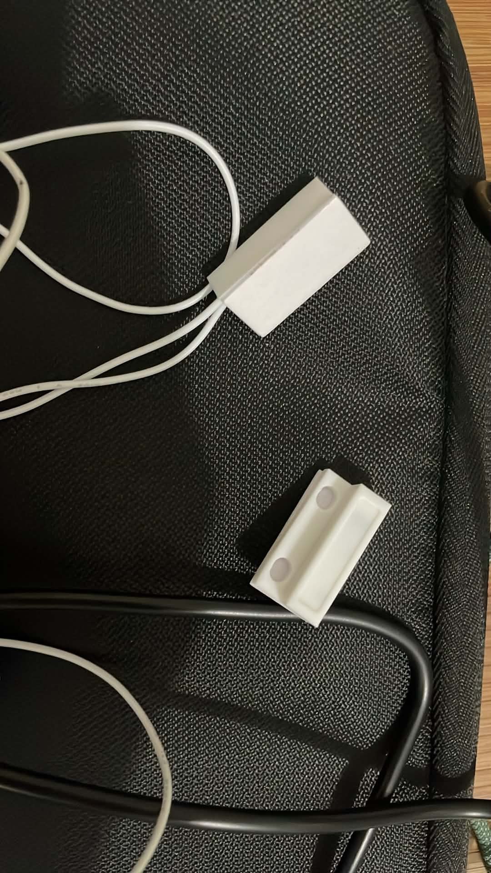
evidence/A/W01/photos/13-mc38-actual.jpg
