minhqng/predictive-cold-chain-aiot/evidence/A/W01/photos/14-ibt2-actual.jpg

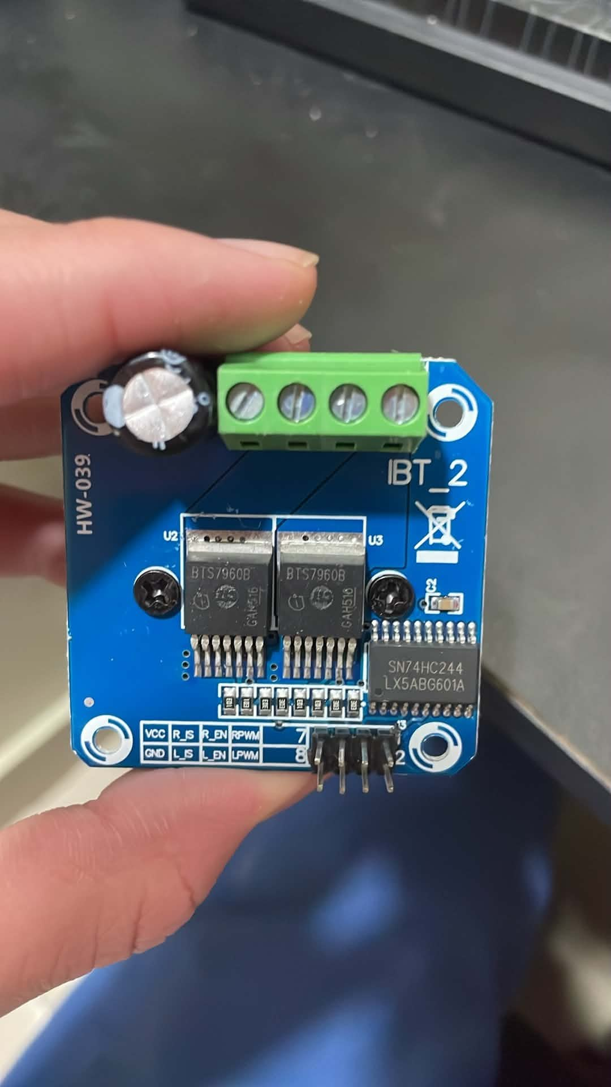
evidence/A/W01/photos/14-ibt2-actual.jpg
