minhqng/predictive-cold-chain-aiot/evidence/A/W01/photos/15-tec-marking-actual.jpg

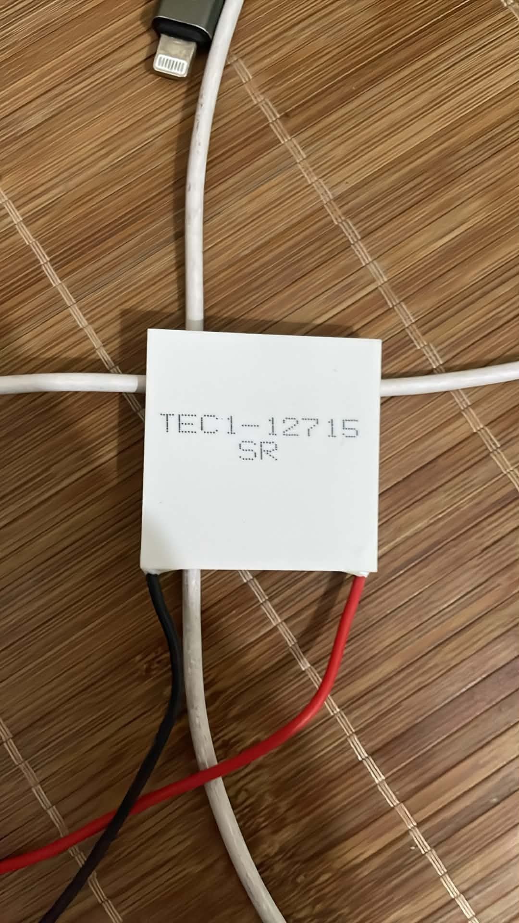
evidence/A/W01/photos/15-tec-marking-actual.jpg
