minhqng/predictive-cold-chain-aiot/evidence/A/W01/photos/17-v1-kit-actual.jpg

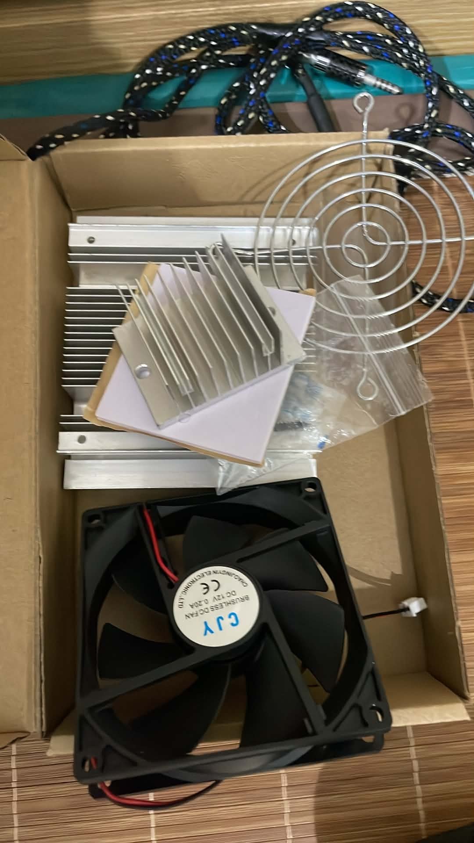
evidence/A/W01/photos/17-v1-kit-actual.jpg
