minhqng/predictive-cold-chain-aiot/evidence/A/W01/photos/20-dual-esp32-actual-back.jpg

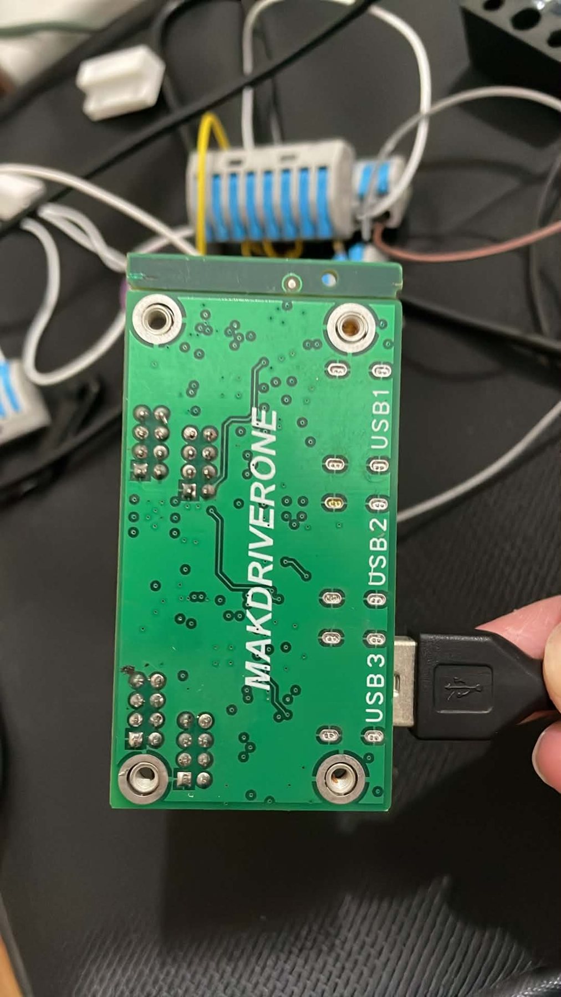
evidence/A/W01/photos/20-dual-esp32-actual-back.jpg
