minhqng/predictive-cold-chain-aiot/evidence/A/W01/photos/22-pct218-actual-marking.jpg

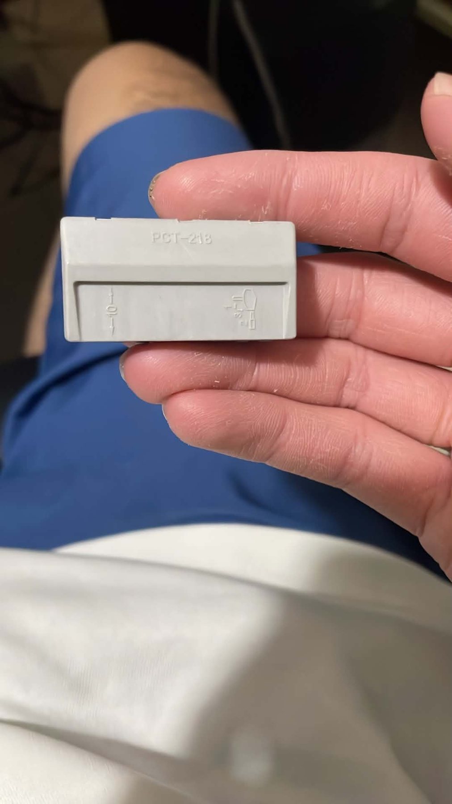
evidence/A/W01/photos/22-pct218-actual-marking.jpg
