minhqng/predictive-cold-chain-aiot/evidence/A/W01/photos/23-pct218-actual-levers.jpg

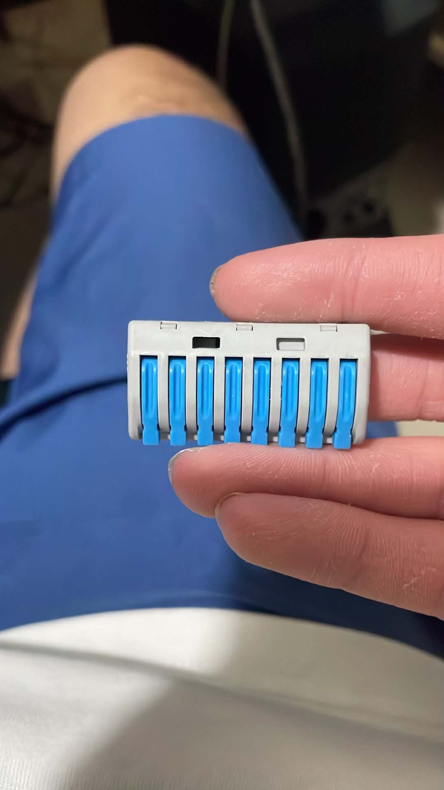
evidence/A/W01/photos/23-pct218-actual-levers.jpg
