minhqng/predictive-cold-chain-aiot/evidence/A/W01/photos/24-pct218-actual-ports.jpg

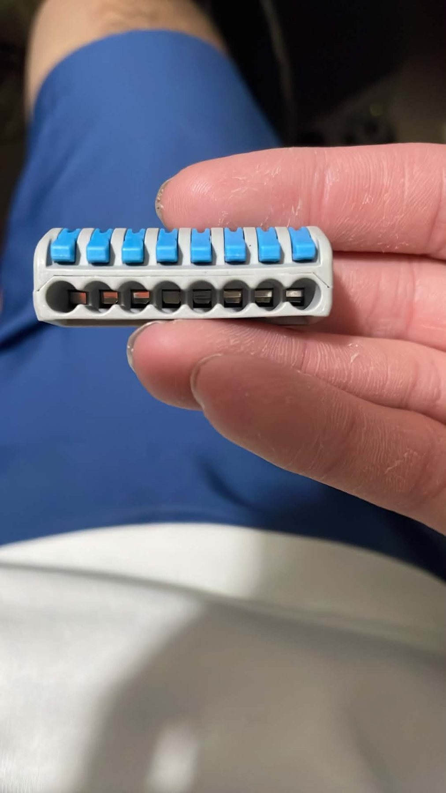
evidence/A/W01/photos/24-pct218-actual-ports.jpg
