minhqng/predictive-cold-chain-aiot/evidence/A/W01/photos/26-bme280-actual-silkscreen.jpg

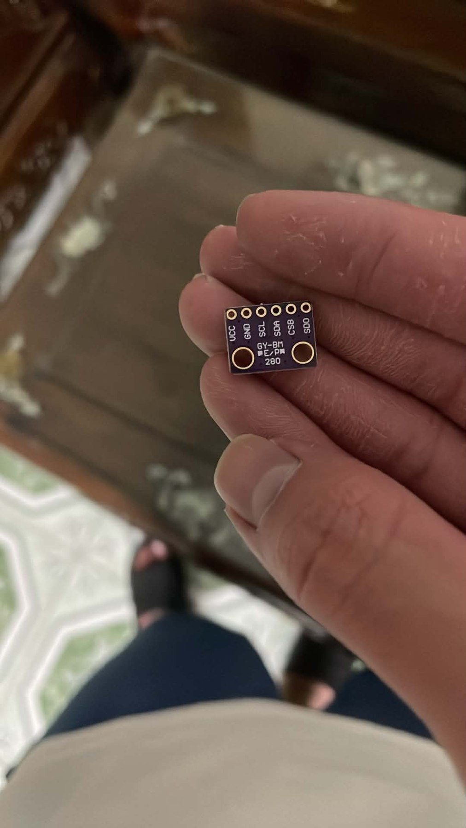
evidence/A/W01/photos/26-bme280-actual-silkscreen.jpg
