minhqng/predictive-cold-chain-aiot/evidence/A/W01/photos/27-chamber-packaged-user-photo.jpg

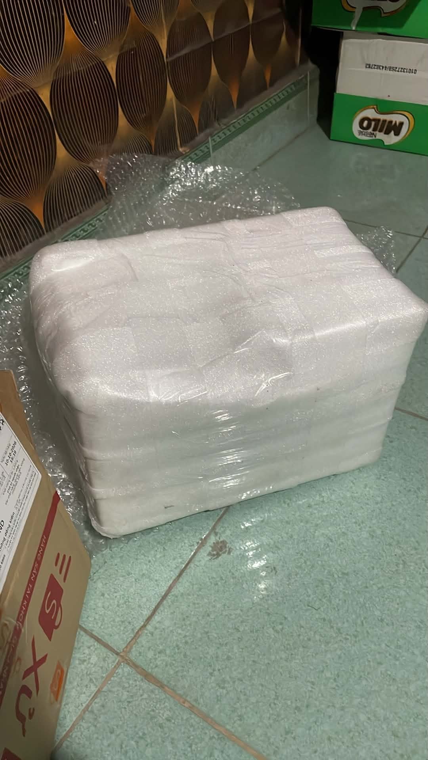
evidence/A/W01/photos/27-chamber-packaged-user-photo.jpg
