minhqng/predictive-cold-chain-aiot/evidence/A/W02/w02_ds18b20_600_samples_summary.png

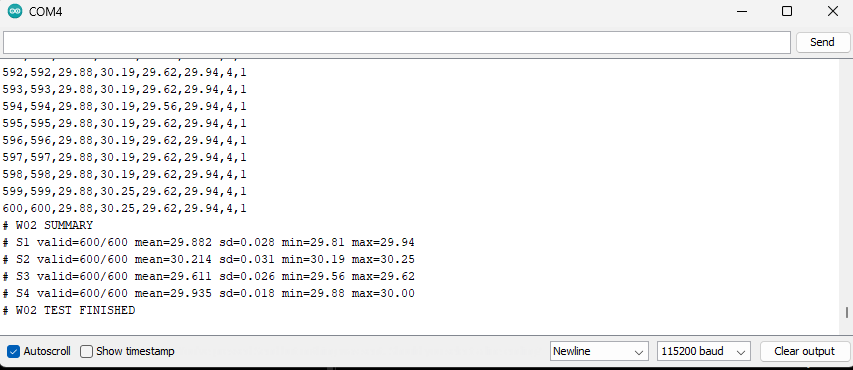
evidence/A/W02/w02_ds18b20_600_samples_summary.png
