minhqng/predictive-cold-chain-aiot/evidence/A/W02/w02_mc38_24_cycles.png

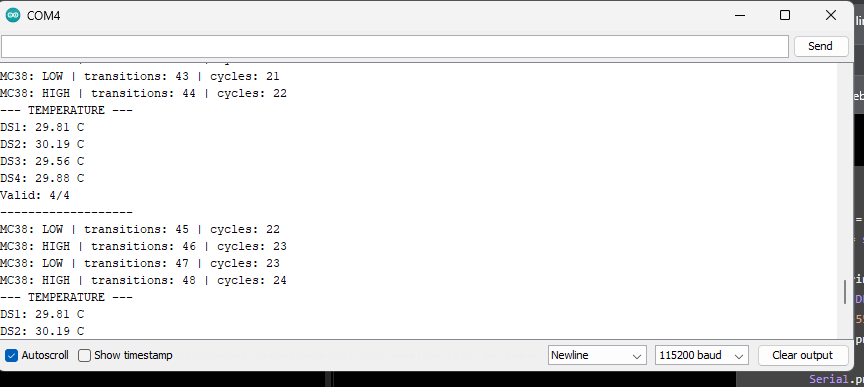
evidence/A/W02/w02_mc38_24_cycles.png
