minhqng/predictive-cold-chain-aiot/evidence/A/W02/w02_rom_enumeration_4_devices.png

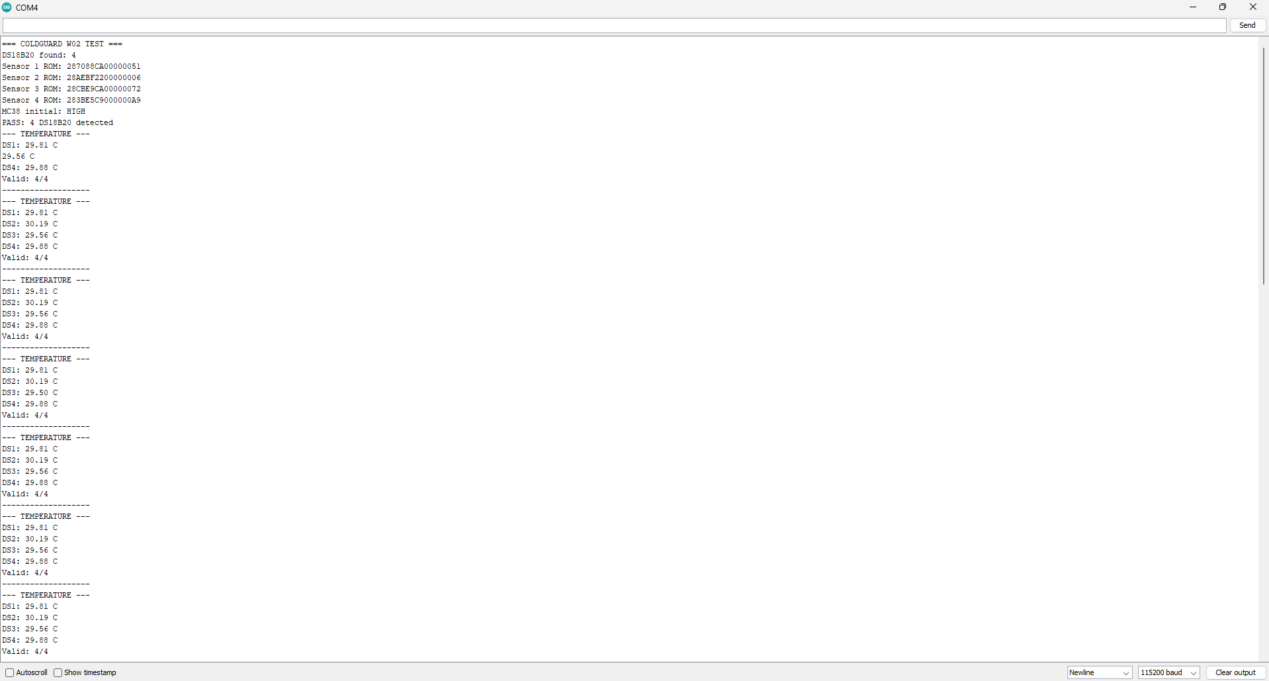
evidence/A/W02/w02_rom_enumeration_4_devices.png
