minhqng/predictive-cold-chain-aiot/evidence/A/W04/h6/first-tec-plot.png

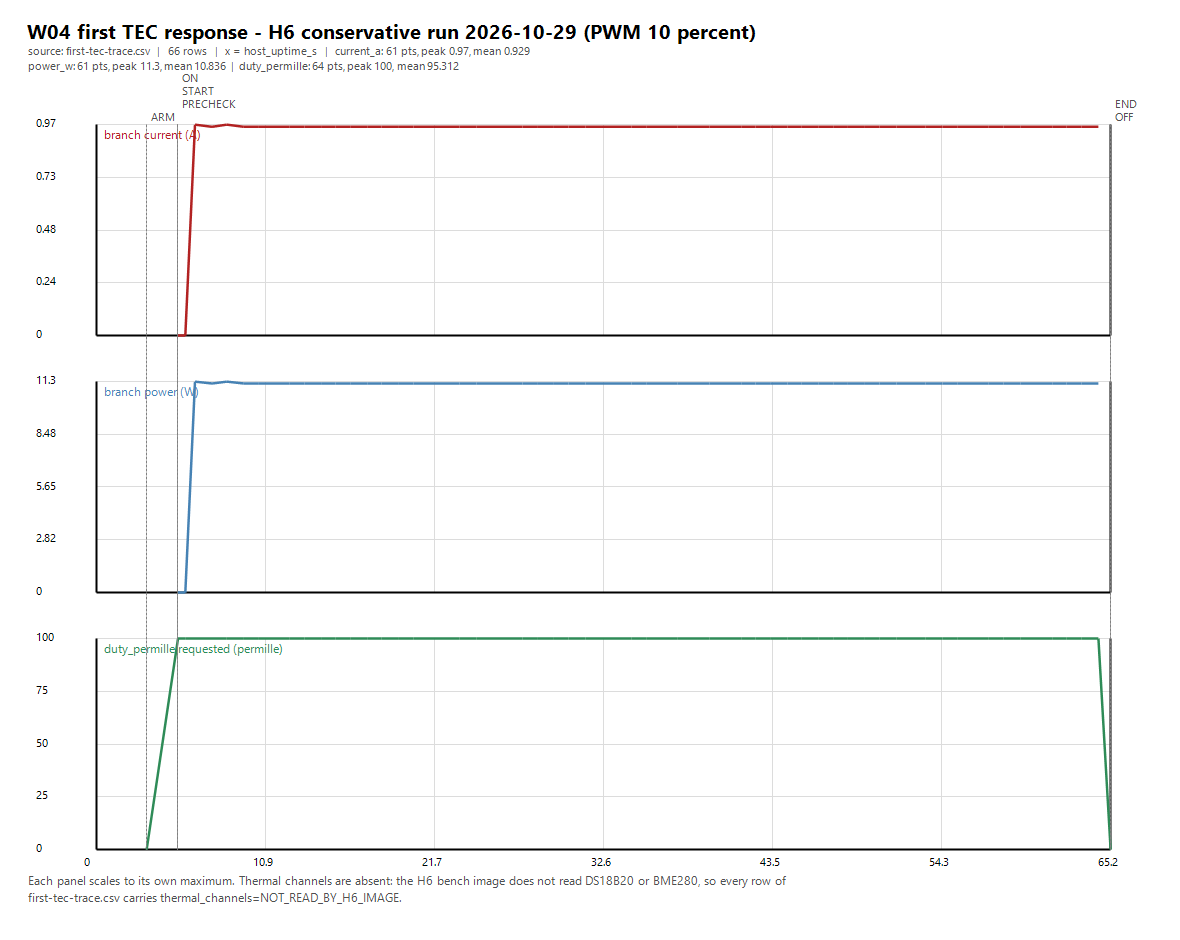
evidence/A/W04/h6/first-tec-plot.png
