minhqng/predictive-cold-chain-aiot/evidence/A/W04/power-topology-v1.png

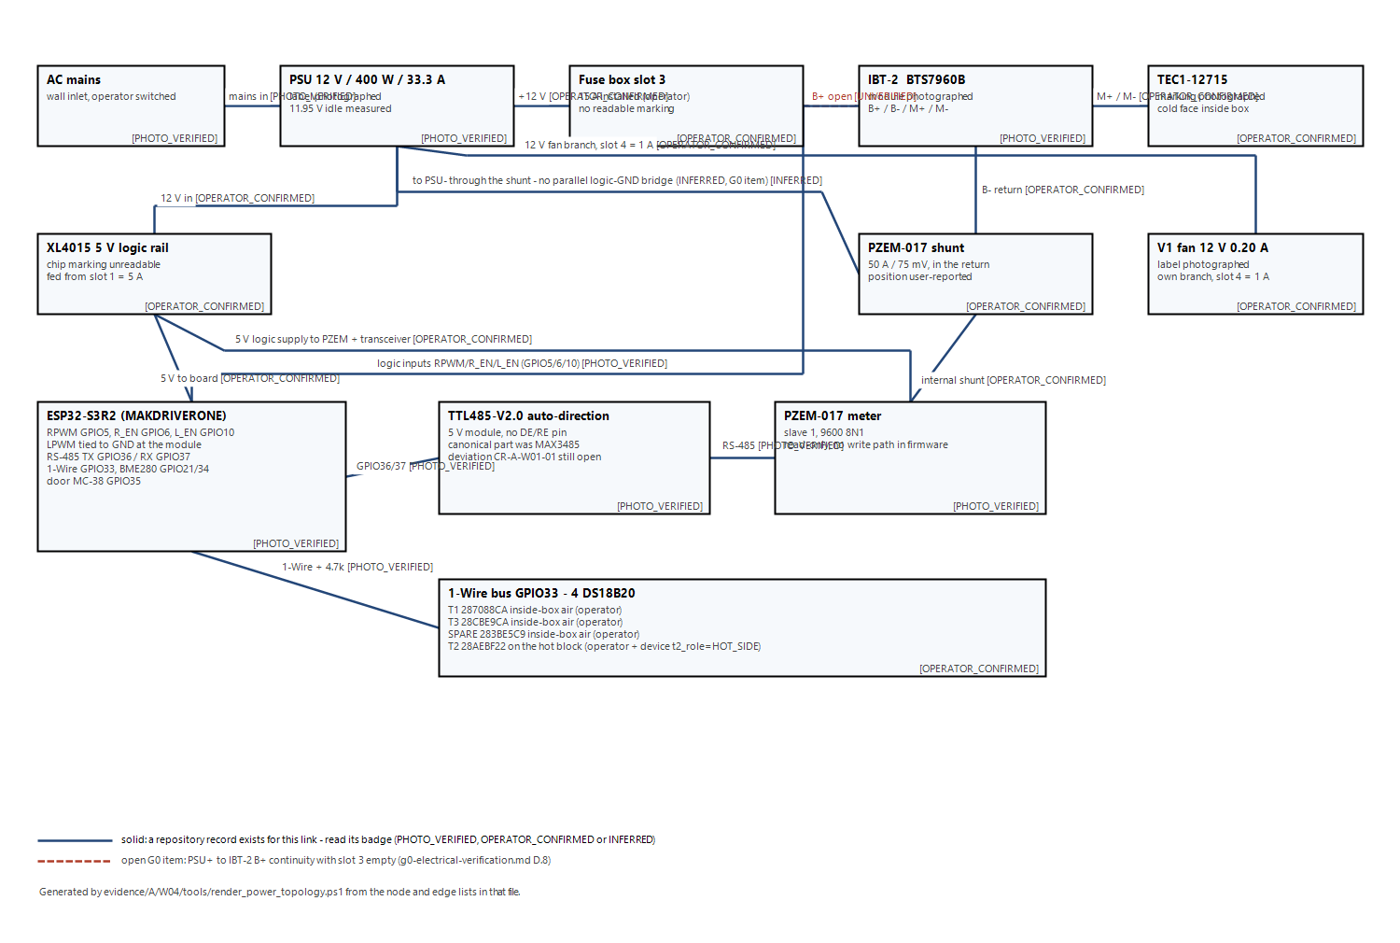
evidence/A/W04/power-topology-v1.png
