minhqng/predictive-cold-chain-aiot/evidence/A/W04/tec-cooling-response-600s.png

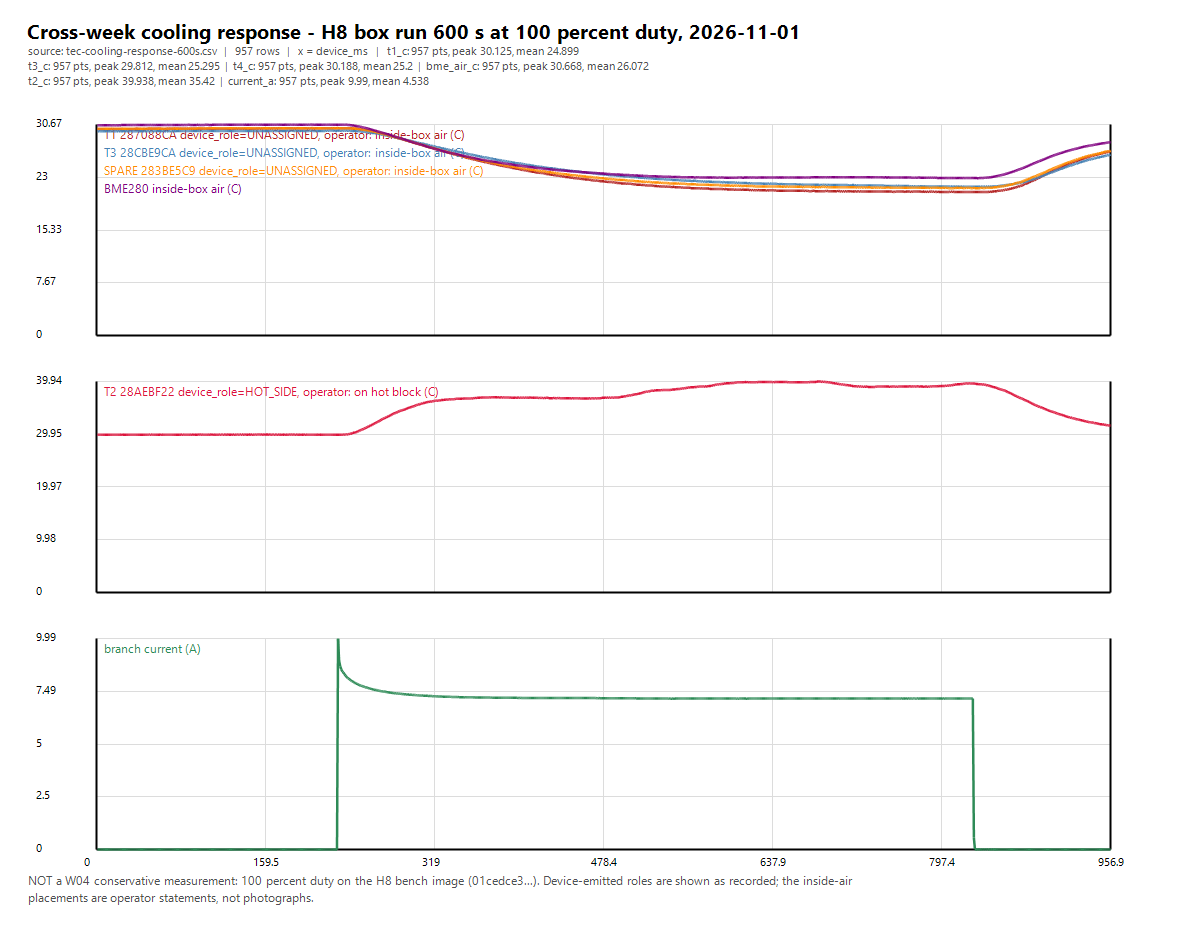
evidence/A/W04/tec-cooling-response-600s.png
