minhqng/predictive-cold-chain-aiot/evidence/A/W07/geometry-v1-photos-20261104/geometry-v1-interior-20261104.png

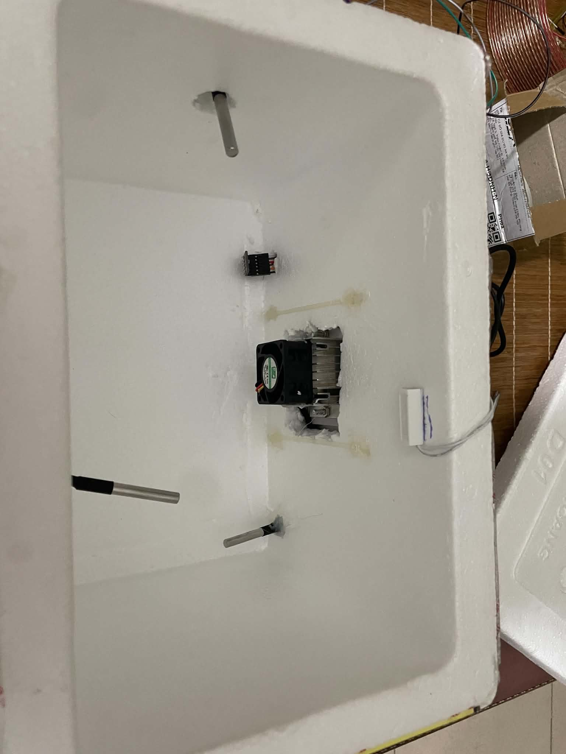
evidence/A/W07/geometry-v1-photos-20261104/geometry-v1-interior-20261104.png
