minhqng/predictive-cold-chain-aiot/evidence/A/W23/imports/A-W23-02/6d2c4ff9b788-kit-clamp-meter.png

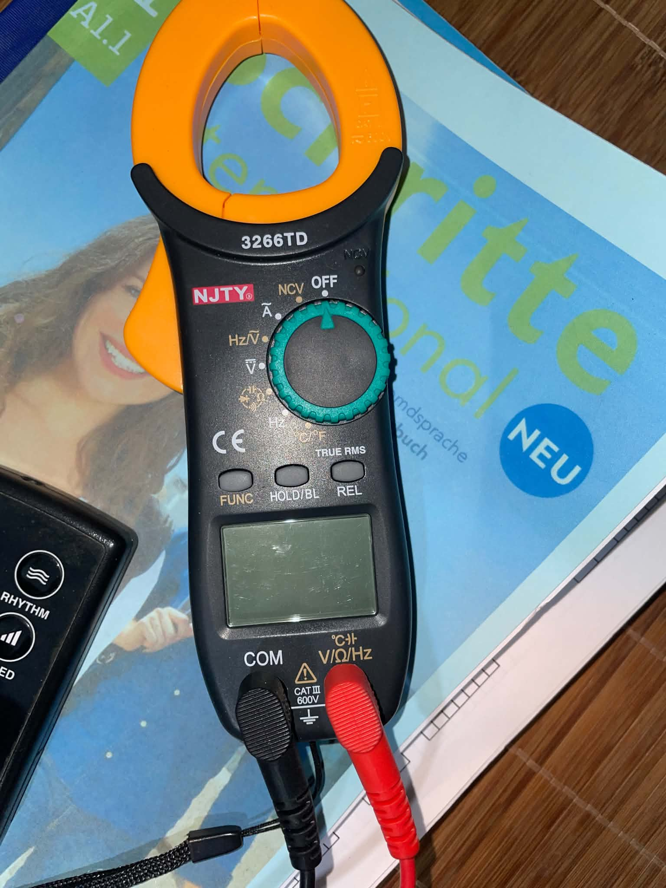
evidence/A/W23/imports/A-W23-02/6d2c4ff9b788-kit-clamp-meter.png
