minhqng/predictive-cold-chain-aiot/evidence/A/W23/imports/A-W23-02/64fe39468bc9-kit-tools.png

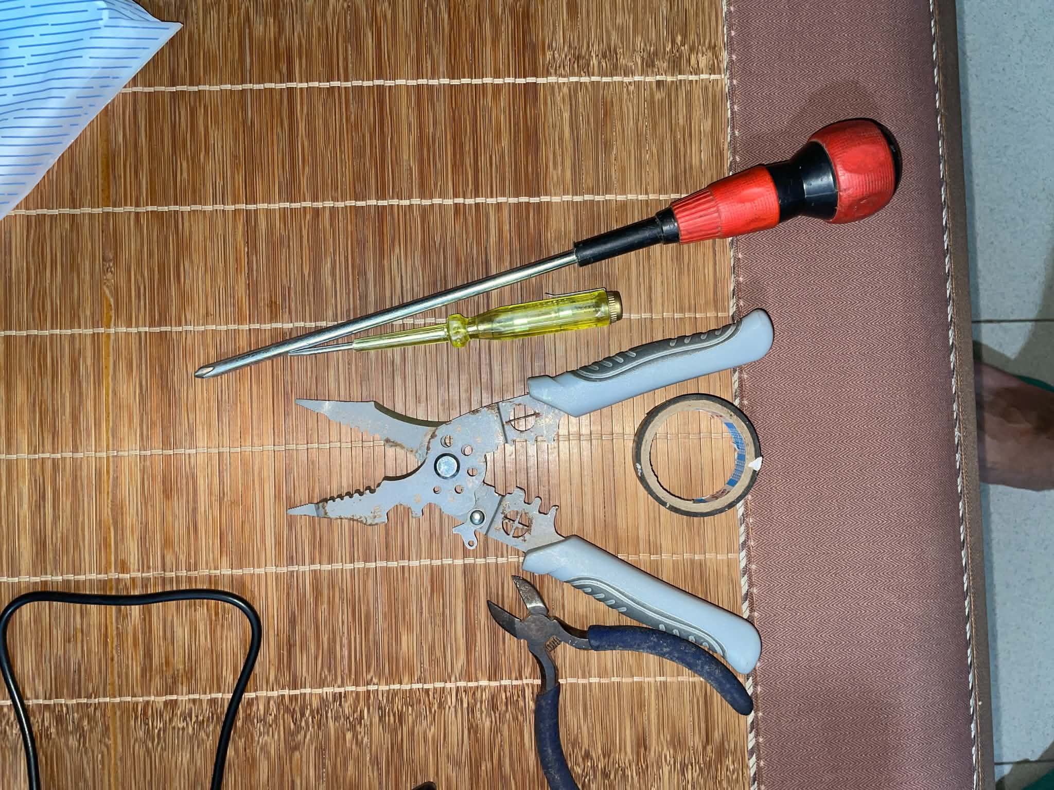
evidence/A/W23/imports/A-W23-02/64fe39468bc9-kit-tools.png
