minhqng/predictive-cold-chain-aiot/evidence/A/W23/imports/A-W23-02/203fe32ccc96-kit-spare-wire-fastons.png

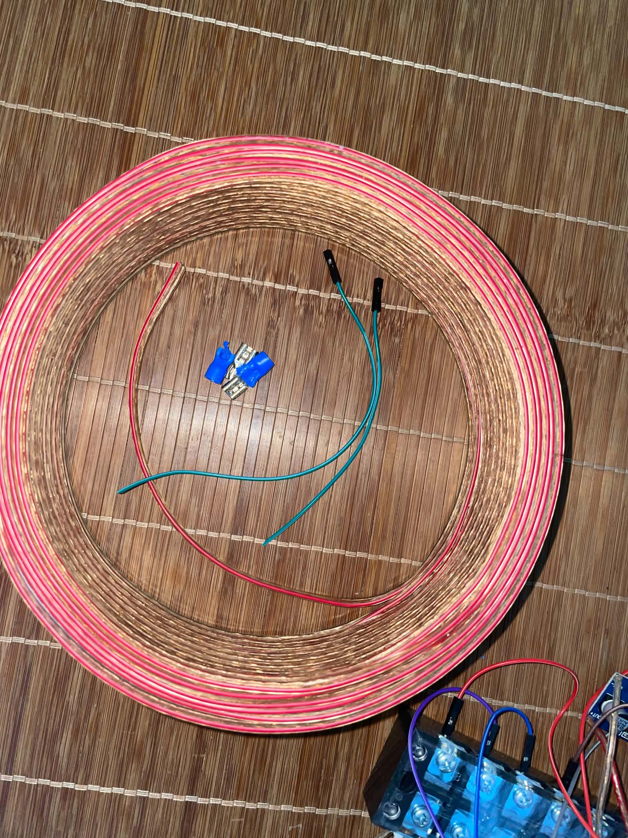
evidence/A/W23/imports/A-W23-02/203fe32ccc96-kit-spare-wire-fastons.png
