minhqng/predictive-cold-chain-aiot/evidence/A/W23/imports/A-W23-02/926f4ae340ee-kit-jumpers-40p.png

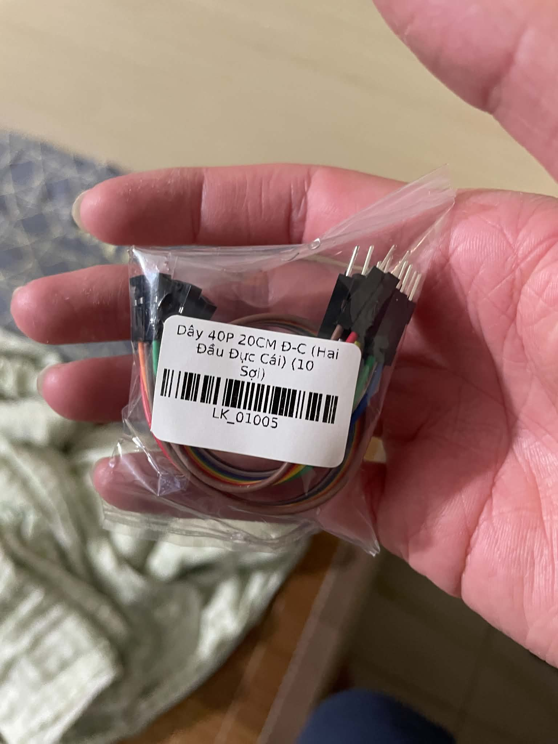
evidence/A/W23/imports/A-W23-02/926f4ae340ee-kit-jumpers-40p.png
