minhqng/predictive-cold-chain-aiot/evidence/A/W23/imports/A-W23-02/2873d1d9f501-kit-spare-fuses.png

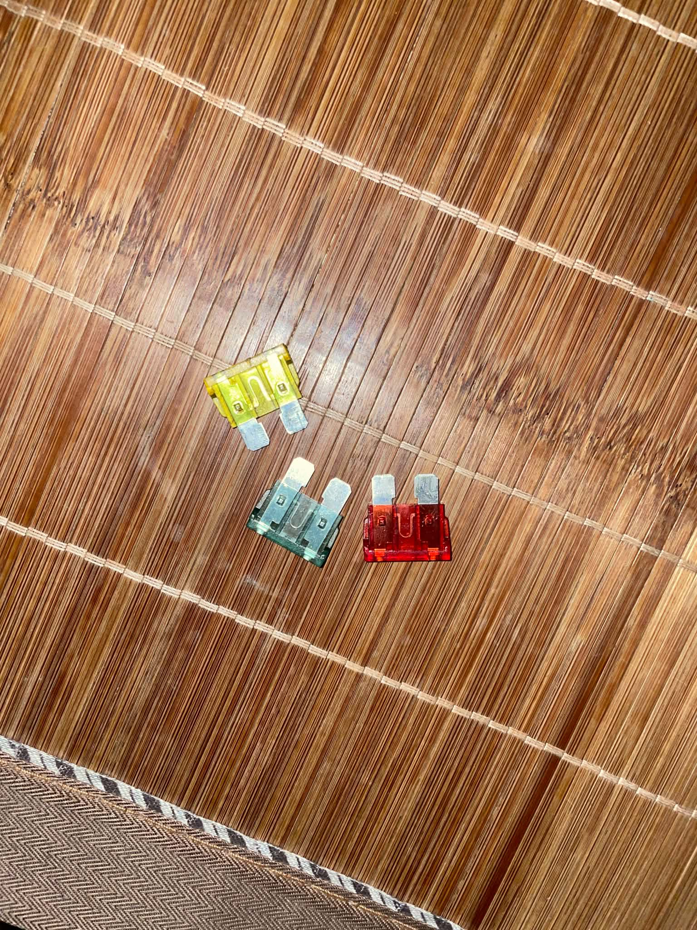
evidence/A/W23/imports/A-W23-02/2873d1d9f501-kit-spare-fuses.png
