minhqng/predictive-cold-chain-aiot/evidence/A/W23/imports/A-W23-03/9991e27915e0-18-shunt-marking-actual.jpg

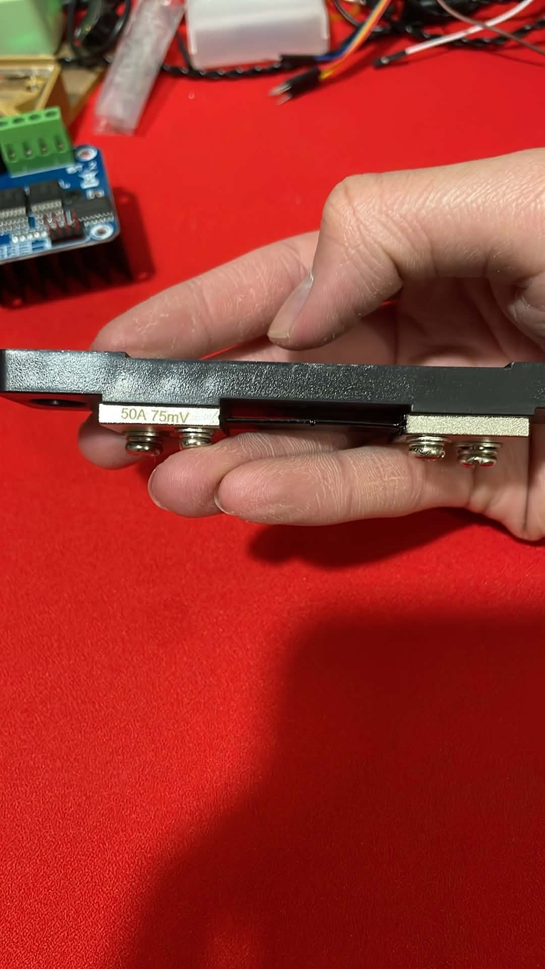
evidence/A/W23/imports/A-W23-03/9991e27915e0-18-shunt-marking-actual.jpg
