minhqng/predictive-cold-chain-aiot/evidence/A/W23/imports/A-W23-03/a518702fb2d1-16-psu-label-actual.jpg

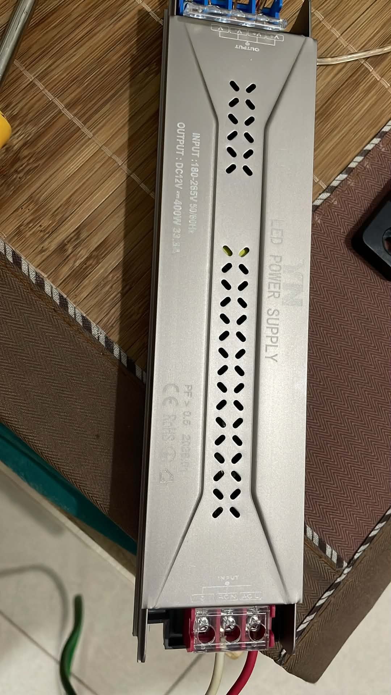
evidence/A/W23/imports/A-W23-03/a518702fb2d1-16-psu-label-actual.jpg
