minhqng/predictive-cold-chain-aiot/evidence/A/W23/operator-submission-20261108/diagram-power-GENERATED.png

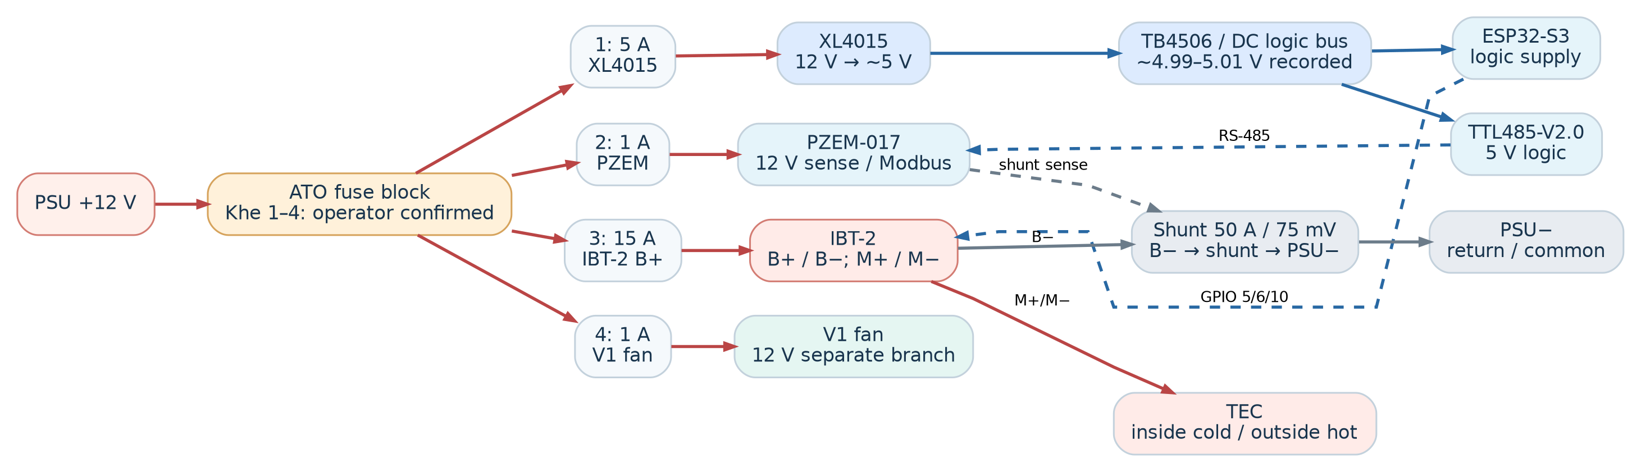
evidence/A/W23/operator-submission-20261108/diagram-power-GENERATED.png
