minhqng/predictive-cold-chain-aiot/evidence/A/W23/operator-submission-20261108/diagram-signals-GENERATED.png

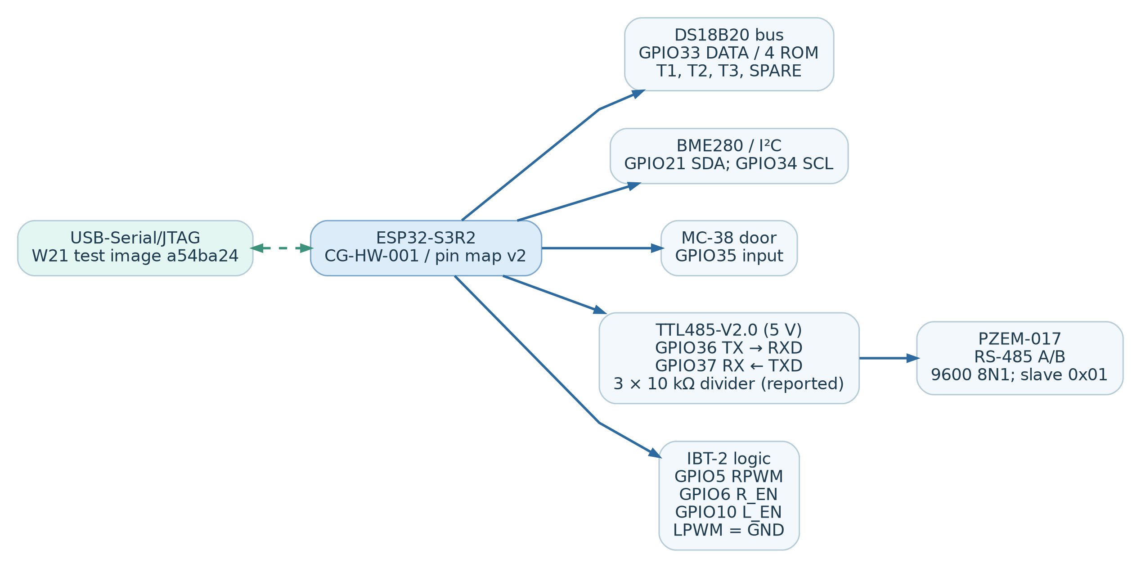
evidence/A/W23/operator-submission-20261108/diagram-signals-GENERATED.png
