minhqng/predictive-cold-chain-aiot/evidence/D/W01/trust-boundary.png

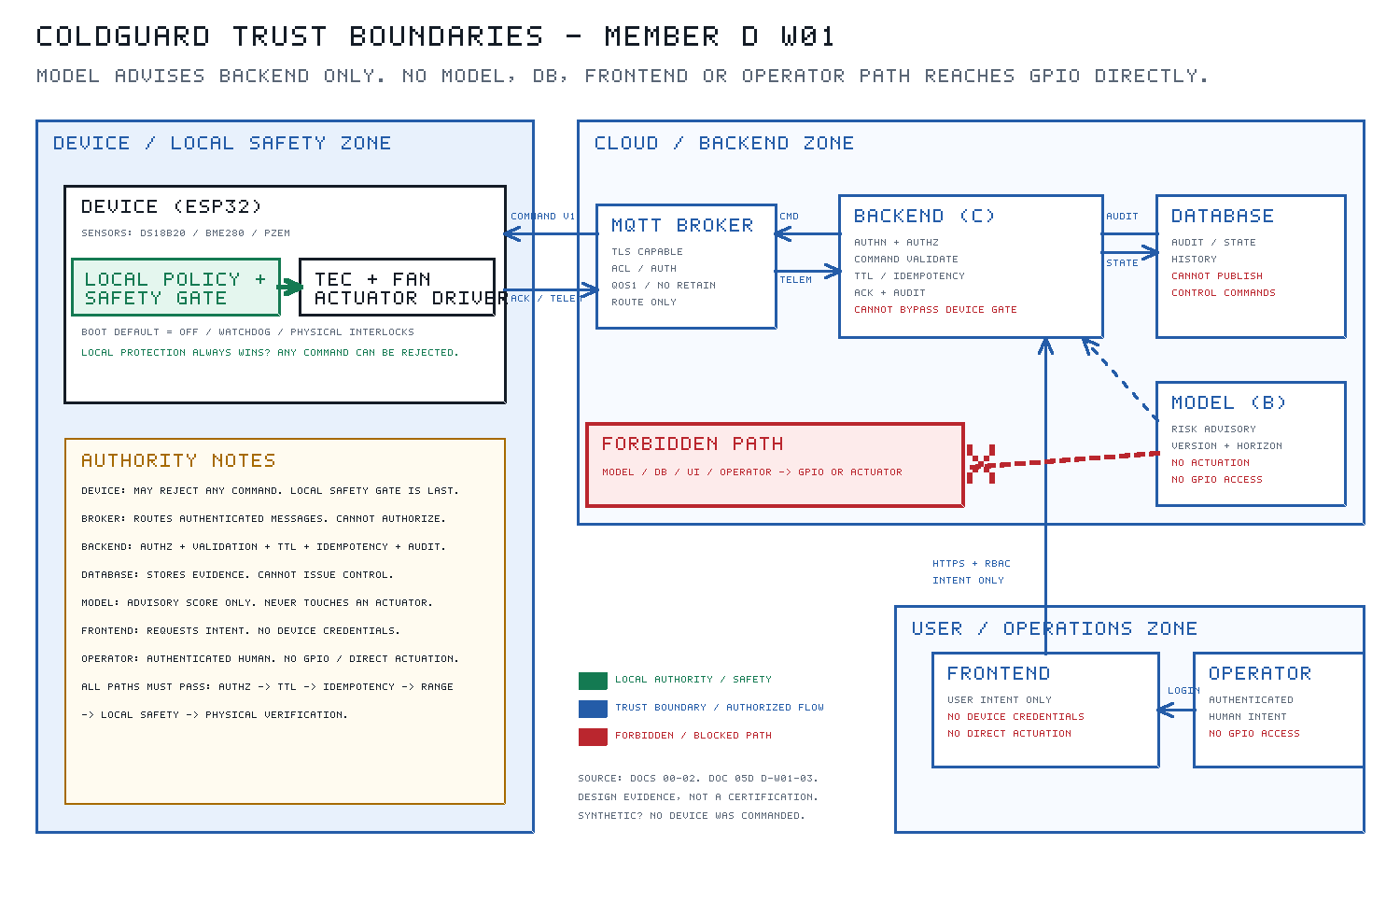
evidence/D/W01/trust-boundary.png
