minhqng/predictive-cold-chain-aiot/evidence/A/W01/bom-audit.csv

id | frozen_item | frozen_spec | frozen_qty | observed_item | observed_qty | inspection_status | visible_marking | seller_sku | physical_condition | photo_ref | deviation_or_uncertainty | next_action
HW-01 | Board điều khiển | Dual ESP32-S3R2 + W25Q32 + CH343G | 1 | Board dual ESP32-S3 (ảnh 20 xác nhận silkscreen MAKDRIVERONE); đã nạp chương trình, thử GPIO/UART/Wi-Fi | 1 reported | PRESENT_PHOTOGRAPHED_TEST_REPORTED | Silkscreen MAKDRIVERONE và USB1/USB2/USB3 (ảnh 20); marking ESP32-S3R2 / W25Q32 / CH343G không đọc được trong ảnh | UNKNOWN | Đã chạy test cơ bản trên bench | photos/21-dual-esp32-actual-component-side.jpg;photos/20-dual-esp32-actual-back.jpg | Thương hiệu board đã xác nhận bằng ảnh; danh tính từng chip vẫn chỉ là thông tin người dùng báo | Xác minh marking chip ở ảnh cận/độ phân giải cao hơn; đối chiếu sơ đồ chân nhà bán
HW-02 | DS18B20 | Waterproof, dây 1 m | 3 | DS18B20 chống nước; ảnh 12 cho thấy một đầu dò đúng loại; 4 đầu dò đọc được nhiệt độ và 4 ROM ID duy nhất qua GPIO10 | 4 reported (ảnh chứng minh một đầu dò) | PRESENT_PHOTOGRAPHED_PARTIAL | Đầu dò chống nước không in mã; chưa lưu ROM ID kèm ảnh/nhãn | UNKNOWN | Đã đọc nhiệt độ 4 đầu dò; chưa lưu log 10 phút | photos/12-ds18b20-probe-actual.jpg | DEVIATION chỉ số lượng: 4 thực có vs 3 trong BOM đã freeze (CR-A-W01-04); ảnh 12 chứng minh một đầu dò, KHÔNG đếm được 4; cảm biến thứ 4 chỉ dự phòng | Chụp đủ 4 đầu dò trong một khung kèm ROM; lưu ROM ID sang vai trò T1/T2/T3 (W02) và chốt quyết định dự phòng
HW-03 | BME280 | I²C, module 3.3 V | 1 | Breakout BME280; người dùng báo mã dạng "GY-BM…280" (ký tự giữa E/P không xác định); đã nhận, chưa hàn header | 1 reported | PRESENT_PHOTOGRAPHED | Silkscreen GY-BM[P/E] 280 và VCC GND SCL SDA CSB SDO (ảnh 26); ký tự giữa M và 280 không đọc chắc chắn | UNKNOWN | Chưa hàn chân nên chưa cấp điện và chưa test | photos/25-bme280-actual-component-side.jpg;photos/26-bme280-actual-silkscreen.jpg | Chưa xác minh die BME280 hay BMP280 (có CSB/SDO nên không loại trừ BMP280); nguồn và trình tự chân chưa xác minh; chưa test I²C | Hàn header, đánh dấu chân 3.3 V và test I²C ở W02; xác minh die trước khi dùng số đọc độ ẩm
HW-04 | MC-38 | Reed switch | 1 | MC-38; ảnh 13 cho thấy hai chi tiết rời (thân công tắc từ + nam châm); đã quan sát 24 chu kỳ đóng/mở qua GPIO34 | 1 reported | PRESENT_PHOTOGRAPHED_TEST_REPORTED | Không thấy marking MC-38 trên thân | UNKNOWN | Đã test logic chuyển trạng thái; chưa có log | photos/13-mc38-actual.jpg | Chưa có log chu kỳ trong bộ chứng cứ; 24 chu kỳ là kết quả do người dùng báo; chưa đo khoảng cách kích hoạt | Lưu log chu kỳ có timestamp; đo khoảng cách kích hoạt và ghi cực tính pull-up
HW-05 | PZEM-017 | RS485 / Modbus | 1 | PZEM-017; Modbus trả lời hợp lệ CRC qua GPIO36/37, đọc 11.95 V | 1 | PRESENT_PHOTOGRAPHED_TEST_REPORTED | MODEL PZEM-017 / DC0-300V / 10-300A visible | UNKNOWN | Đo được điện áp; chưa đo dòng/công suất | photos/04-pzem-shunt.jpg;photos/05-pzem-terminals.jpg | Nhánh cảm biến 12 V dùng fuse 1 A bổ sung; dòng và profile shunt 50 A chưa xác minh | Giữ ảnh gốc; cấu hình và readback thanh ghi shunt ở W03
HW-06 | Shunt | 50 A / 75 mV | 1 | Shunt rời kèm PZEM: phần tử khắc FL-2 0.5; thân có nhãn in định mức | 1 | PRESENT_PHOTOGRAPHED | Nhãn IN 50A 75mV dán trên thân shunt (ảnh 18); khắc trên phần tử điện trở FL-2 0.5 (ảnh 04) | UNKNOWN | Chưa thử có tải | photos/18-shunt-marking-actual.jpg;photos/04-pzem-shunt.jpg | Marking định mức nay đã khớp 50 A / 75 mV đã freeze; cấp chính xác của shunt và profile 50 A trong PZEM chưa xác minh | W03 readback cấu hình shunt; thử tải có kiểm soát dòng; không suy công suất từ một lần đo
HW-07 | MAX3485 | Module RS485 3.3 V | 1 | TTL485-V2.0 cấp 5 V; người dùng báo chip MAX13487ESA | 1 | APPROVED_SUBSTITUTION | TTL485-V2.0 visible; marking chip MAX13487ESA do người dùng báo, chưa đọc được trong ảnh | UNKNOWN | Đã truyền Modbus qua phân áp 5 V sang 3.3 V tại GPIO37 | photos/02-rs485-front.jpg;photos/03-rs485-back.jpg | DEVIATION MAJOR: không trùng MAX3485 3.3 V trong BOM đã freeze (CR-A-W01-01); không có ảnh nào trong bộ 25 ảnh đọc được marking chip | Thay thế được project owner phê duyệt 2026-11-09 (CR-A-W01-01 — xem freeze-deviation-review.md); còn phải xác minh ảnh part marking VCC/Vih/Voh và đo lại mức RX trước lần đấu GPIO kế tiếp
HW-08 | BTS7960 / IBT-2 | H-Bridge module | 1 | BTS7960 / IBT-2; ảnh 14 cho thấy board thật, marking chip và nhãn chân đầu vào; đã kiểm tra logic enable/PWM bằng đồng hồ | 1 reported | PRESENT_PHOTOGRAPHED_TEST_REPORTED | Silkscreen IBT_2 và HW-039; BTS7960B in trên CẢ HAI tầng công suất (U2, U3); SN74HC244 / LX5ABG601A trên chip đệm; header VCC R_IS R_EN RPWM / GND L_IS L_EN LPWM (ảnh 14) | UNKNOWN | Đã kiểm tra logic; GND logic thông mạch với B- nguồn; chưa thử tải TEC | photos/14-ibt2-actual.jpg | Marking chip đã đọc được và khớp BTS7960; ảnh không phủ mặt sau; chưa đo dòng/thermal; chưa log trạng thái mặc định khi boot | Chụp mặt sau; review pull-down và trạng thái OFF mặc định với D; xác nhận chip nào của board dual lái R_IS/L_IS
HW-09 | TEC1-12715 | Đúng SKU / sản phẩm đã chọn | 1 | TEC1-12715 SR; ảnh 15 đọc rõ marking trên TEC | 1 reported | PRESENT_PHOTOGRAPHED | TEC1-12715 SR (ảnh 15) | UNKNOWN | Không cấp nguồn trong W01 | photos/15-tec-marking-actual.jpg | Marking khớp tên người dùng báo; KHÔNG xác lập dòng định mức liên tục; seller/SKU chưa xác minh | Xác minh seller/SKU ngoài marking; giữ nguyên chính sách không cấp nguồn trong W01
HW-10 | Bộ tản Peltier V1 | 12 V | 1 | Cụm tản V1; ảnh 17 cho thấy tản/block nhôm, tản lá nhôm và quạt CJY 12 V trong cùng hộp kit | 1 reported | PRESENT_PHOTOGRAPHED_PARTIAL | CJY BRUSHLESS DC FAN DC 12V 0.20A (ảnh 10 và ảnh 17) | UNKNOWN | Chưa xác nhận lắp hoàn chỉnh và keo tản nhiệt | photos/17-v1-kit-actual.jpg;photos/10-fan-label.jpg | Quạt đã chứng minh thuộc hộp kit V1; chưa chứng minh cụm đã lắp, lực ép và keo; không có thử nghiệm nhiệt | Chụp cụm tản nóng/lạnh đã lắp kèm keo và quạt; thử interlock quạt ở W04
HW-11 | Chamber | HS2 6 L | 1 | Buồng 6 L; ảnh 27 cho thấy kiện còn bọc, chưa mở; dung tích là LỜI XÁC NHẬN của Member A (người vận hành), không có ảnh/đo | 1 reported | PRESENT_PHOTOGRAPHED_PARTIAL | Không thấy marking HS2 hoặc tem dung tích trong ảnh | UNKNOWN | Kiện chưa mở tại thời điểm chụp | photos/27-chamber-packaged-user-photo.jpg | Ảnh 27 chỉ chứng nhận đã nhận kiện; model HS2 và dung tích 6 L CHƯA được ảnh hay phép đo xác thực — chỉ là lời khai của người vận hành; chưa chụp vị trí đặt cảm biến | Mở kiện và chụp tem thể tích/kích thước HS2 cùng góc lắp cảm biến
HW-12 | PSU | 12 V / 33 A, khoảng 400 W | 1 | Nguồn tổ ong 12 V/33 A-class; OUTPUT 2×V+ và 2×V-; đo khoảng 11.95 V ở tải nhẹ | 1 | PRESENT_PHOTOGRAPHED_TEST_REPORTED | Tem: INPUT 180-265V 50/60Hz; OUTPUT DC12V == 400W 33.3A; CE/RoHS (ảnh 16); nhãn OUTPUT V-/V+/V+ (ảnh 09) | UNKNOWN | Đã cấp nguồn ở tải nhẹ; ảnh 16 cho thấy cọc AC vào lộ ra | photos/16-psu-label-actual.jpg;photos/09-psu-output.jpg | Tem định mức nay khớp 12 V / 33.3 A / 400 W đã freeze; vùng AC/tiếp địa và định mức cầu chì nhánh chưa được người có chuyên môn nghiệm thu | Chụp nắp bảo vệ AC; D review và cấm chạm khi AC đang cấp
HW-13 | XL4015 | DC-DC Buck | 1 | Module buck dạng XL4015 theo người dùng báo; đo khoảng 5.00 V ở đầu ra và 4.99 V tại TB4506 | 1 | PRESENT_PHOTOGRAPHED_TEST_REPORTED | Marking chip bị cắt ở mép ảnh — CHƯA xác nhận trực quan XL4015 | UNKNOWN | Đã đo điện áp không tải/tải logic; chưa đo ripple và nhiệt | photos/06-xl4015.jpg | Chưa đo ripple/nhiệt ở tải thiết kế; danh tính XL4015 vẫn chỉ là thông tin người dùng báo vì ảnh không đọc được marking chip | Lưu bằng chứng W03; đo tải theo tiêu chí sau
HW-14 | Fuse Box | ATO 4-way | 1 | Hộp cầu chì 4 vị trí dạng ATO; đã đo thông mạch | 1 | PRESENT_PHOTOGRAPHED_TEST_REPORTED | Ảnh cho thấy 4 khe cầu chì lá; không thấy chữ ATO | UNKNOWN | Đã thử thông mạch | photos/07-fusebox.jpg | Chưa xác minh định mức dòng từng nhánh; chưa rõ cấp điện chung hay rời | Kiểm tra marking định mức; vẽ sơ đồ các đầu vào/ra qua fuse
HW-15 | Fuse TEC | Bộ 10 A / 15 A / 20 A | 1 bộ | Có cầu chì 10 A 15 A 20 A; chưa chọn fuse TEC cuối | 1 bộ reported | PRESENT_REPORTED | 10/15/20 A do người dùng báo | UNKNOWN | Chưa đưa dòng lớn qua fuse | photos/01-overview-wiring.jpg | Không được mặc định 15 A hay 20 A là phù hợp cho dây/TEC; ảnh 01 chỉ thấy cầu chì xuất hiện phụ, không phải đối tượng chứng cứ | Dòng TEC và ampacity dây/đầu nối xác định ở W04 trước khi chốt fuse
HW-16 | Fuse phụ | 5 A | ≥2 | 1 cầu chì 5 A cho nhánh XL4015; thêm 1 A cho nhánh PZEM (ngoài BOM) | 1 × 5 A (người dùng báo); 1 × 1 A ngoài BOM | PARTIAL_QUANTITY | 5 A và 1 A do người dùng báo | UNKNOWN | Nhánh 5 A cho XL4015 đã hoạt động | photos/07-fusebox.jpg | BOM yêu cầu ≥2 × 5 A; mới xác nhận 1 × 5 A (người dùng báo); cầu chì 1 A là bổ sung ngoài BOM | Đếm và chụp toàn bộ cầu chì 5 A dự phòng; ghi rõ 1 A là bổ sung có kiểm soát
HW-17 | TB4504 | 45 A 4P | 1 | TB4506 6 vị trí dùng cho 5 V/GND/nhánh chia áp | 1 | APPROVED_SUBSTITUTION | Ảnh cho thấy 6 vị trí; marking TB4506 chưa đọc được | UNKNOWN | Đã kiểm tra tiếp xúc từng vị trí | photos/08-terminal-block.jpg | DEVIATION MAJOR: khác TB4504 45 A 4P đã freeze; định mức TB4506 chưa xác minh (CR-A-W01-02) | Thay thế được project owner phê duyệt 2026-11-09 (CR-A-W01-02 — xem freeze-deviation-review.md); còn phải xác minh ảnh marking và định mức kẹp tiết diện/vị trí của TB4506; không tự xem tương đương 45 A
HW-18 | PCT218 | 8 cổng | 1 | PCT-218 8 cổng; ảnh 22 đọc rõ khắc nổi PCT-218; người dùng xác nhận đã có 4 chiếc | 4 reported (ảnh chứng minh một chiếc) | PRESENT_PHOTOGRAPHED_PARTIAL | Khắc nổi PCT-218 trên nhựa trắng 8 cổng (ảnh 22); tám cần gạt xanh (ảnh 23); tám cửa vào dây (ảnh 24) | UNKNOWN | Chưa đưa vào lắp hệ thống | photos/22-pct218-actual-marking.jpg;photos/23-pct218-actual-levers.jpg;photos/24-pct218-actual-ports.jpg | DEVIATION chỉ số lượng: 4 thực có vs 1 trong BOM đã freeze (CR-A-W01-03); marking và cấu hình 8 cổng đã chứng minh cho MỘT chiếc, tổng 4 chiếc vẫn là người dùng xác nhận; định mức dòng chưa xác minh | Chụp đủ 4 chiếc trong cùng một khung; chốt phân bổ dùng chính/dự phòng với leader
HW-19 | Dây công suất | 2×2.5 mm² | ~2 m | Có dây công suất rời; tiết diện và chiều dài thực tế chưa xác minh | UNKNOWN | UNVERIFIED | UNKNOWN | UNKNOWN | Chưa test dòng TEC | NONE | Không xác nhận được đủ 2×2.5 mm² ~2 m bằng chứng hiện có; không ảnh nào trong bộ 25 ảnh đọc được marking tiết diện cáp | Đọc marking vỏ cáp đo chiều dài và cỡ dây chụp ảnh; W04 tính fuse
HW-20 | Dây phụ | 2×0.75 mm² | ~1 m | Dây đôi 0.75 mm² đã dùng cho 5 V và nhánh nguồn nhỏ; người dùng báo đủ dùng | ~1 m reported | PRESENT_REPORTED_PARTIAL | 0.75 mm² reported | UNKNOWN | Đã lắp thử; cos xanh FDD2-250 (1.5-2.5 mm²) dùng trên dây 0.75 mm² cần xử lý | photos/01-overview-wiring.jpg | Chiều dài chưa đo; cos sai dải dây so với tiết diện | Dùng cos đúng gauge kiểm lực giữ và cách điện; rà soát bảo vệ dòng
HW-21 | Jumper | M-M / M-F / F-F | 1 bộ | Jumper đang dùng trên ESP32/TB4506; người dùng báo đủ | 1 bộ reported | PRESENT_REPORTED | UNKNOWN | UNKNOWN | Đã test logic mức thấp | photos/01-overview-wiring.jpg | Chưa đếm đủ 3 loại M-M/M-F/F-F; ảnh 01 chỉ thấy jumper xuất hiện phụ, không phải đối tượng chứng cứ | Đếm bộ dây và chụp từng loại; không dùng ở đường công suất
HW-22 | Header | 2.54 mm | đủ | Header và dây kết nối breakout; người dùng báo đủ; BME280 chưa hàn | đủ reported | PRESENT_REPORTED | UNKNOWN | UNKNOWN | Chưa đánh giá trực quan | NONE | Số header cụ thể và tình trạng hàn chưa xác nhận bằng ảnh | Chụp header tồn kho và số chân phù hợp BME280
HW-23 | Điện trở | 4.7 kΩ | ≥1 | 3×10 kΩ dùng phân áp TTL485 (người dùng báo đã đo); 4.7 kΩ người dùng báo đủ | 10 kΩ ×3 đo (người dùng báo); 4.7 kΩ ≥1 reported | PRESENT_REPORTED_PARTIAL | 10 kΩ do người dùng báo là đã đo | UNKNOWN | Mạch phân áp 10 kΩ hoạt động | photos/01-overview-wiring.jpg | 4.7 kΩ pull-up DS18B20 chưa có ảnh/đo; 10 kΩ là linh kiện ngoài BOM; cả hai con số đều chưa được agent tái lập; LƯU Ý tổng đếm trên bench: dòng này chỉ kiểm 3 × 10 kΩ của mạch phân áp — còn 2 × 10 kΩ pull-down trên chân EN của IBT-2 (xem pin-candidates-v0.md và R06), nên bench thực có 5 × 10 kΩ và chỉ 3 được kiểm trong CSV; ảnh 01 chỉ thấy trở xuất hiện phụ | Đo và chụp điện trở 4.7 kΩ pull-up riêng; ghi 10 kΩ là ngoài BOM; đối chiếu đủ 5 × 10 kΩ khi vẽ sơ đồ
HW-24 | Thermal paste | Đi kèm bộ V1 | đủ | Keo tản nhiệt đi kèm cụm V1; người dùng xác nhận có | đủ reported | PRESENT_REPORTED | UNKNOWN | UNKNOWN | Chưa dùng trong thử nghiệm W01 | NONE | Chưa có ảnh xác thực số lượng/chất lượng; ảnh 17 cho thấy hộp kit V1 nhưng KHÔNG nhận diện riêng được tuýp keo | Chụp tuýp keo và hạn dùng; xác minh đủ lắp 1 TEC
