minhqng/predictive-cold-chain-aiot/ml/reports/W06/event-timeline-W06.csv

event_id | event_type | provenance | source_path | source_sha256 | source_namespace | source_record_index | device_id | boot_id | run_id | identity_status | command_id | ack_seq | seq | device_uptime_ms | event_time_utc | backend_received_at | persisted_at | clock_domain | clock_sync | measurement_quality | uncertainty_s | eligibility | delivery_count | reason_codes | field_origin | raw_fields | normalized_fields
48358561236d062e:TELEMETRY_SAMPLE:coldguard-001:boot-w01-fixture-001:12345:NO_LINE:base | TELEMETRY_SAMPLE | SYNTHETIC_FIXTURE | backend/fixtures/telemetry_v0.json | 48358561236d062ee63bc3fc8596f341498837063c24aa9b84b5873525a23dab | coldguard.telemetry/v1 |  | coldguard-001 | boot-w01-fixture-001 | CG-S2-A-001 | RESOLVED |  |  | 12345 | 1234567 | 2026-10-14T07:00:00.000000Z |  |  | DEVICE_EVENT_UTC | UNVERIFIED_SYNC | VALID |  | SYNTHETIC_UNIT_TEST | 1 | CLOCK_SYNC_NOT_EVIDENCED|SYNTHETIC_OR_UNVERIFIED_PROVENANCE | NORMALIZED_ONLY | {} | {"applied_cooling":"ON","applied_duty_permille":"1000","chamber_air_mean_c":"","chamber_air_status":"ROLE_NOT_QUALIFIED_OR_MISSING","cooling_current_a":"10.800000","cooling_energy_counter_wh":"42.000000","cooling_power_w":"128.500000","cooling_voltage_v":"11.900000","device_state":"ONLINE_NORMAL","door_polarity":"","door_state":"CLOSED","experiment_phase":"","pressure_hpa":"","quality.electrical":"VALID","quality.environment":"VALID","quality.overall":"VALID","quality.probe.t1":"","quality.probe.t2":"","quality.probe.t3":"","quality.thermal":"VALID","readback_duty_permille":"","requested_duty_permille":"","rh_pct":"84.200000","seq":"12345","t1_c":"7.100000","t2_c":"7.400000","t3_c":"7.800000","t_air_c":"7.500000"}
9a6a47a0119c9303:DEVICE_ACK:coldguard-001:abcd0123:00000000-0000-4000-8000-00000000000a:42:5:base | DEVICE_ACK | HOST_GENERATED_SYNTHETIC | evidence/A/W06/demo-command-capture.log | 9a6a47a0119c9303cb8c24094b878c78e1999b538fd5267a17f0ead281b3ec06 | coldguard.command-ack-serial/v1 | 5 | coldguard-001 | abcd0123 |  | PARTIAL | 00000000-0000-4000-8000-00000000000a | 42 |  | 123456 |  |  |  | DEVICE_BOOT_UPTIME | UNSYNCHRONIZED | NOT_APPLICABLE_PROTOCOL_EVIDENCE |  | SYNTHETIC_UNIT_TEST | 1 | ACK_IS_NOT_APPLIED_STATE|DEVICE_CLOCK_UNSYNCHRONIZED|DEVICE_UPTIME_IS_BOOT_SCOPED|EXPIRY_NOT_EVALUABLE|HOST_GENERATED_SYNTHETIC|NO_COMMAND_PUBLICATION_TIME | RAW_AND_NORMALIZED | {"ack_seq":"42","allowed_duty_max_permille":"0","applied_cooling":"OFF","applied_duty_permille":"0","boot_count":"9","boot_id":"abcd0123","command_id":"00000000-0000-4000-8000-00000000000a","command_id_form":"UUID","desired_cooling":"ON","desired_duty_permille":"250","device_id":"coldguard-001","device_mode":"OFF","event":"ACK","expiry_evaluable":"0","fault_code":"0x00000000","output_stage":"DISABLED","reapplied":"0","reason":"EPOCH_UNSYNCHRONIZED","schema":"1","source":"NETWORK","status":"SAFETY_BLOCKED","time_sync_state":"UNSYNCHRONIZED","uptime_ms":"123456"} | {"ack_seq":"42","allowed_duty_max_permille":"0","applied_cooling":"OFF","applied_duty_permille":"0","boot_count":"9","boot_id":"abcd0123","command_id":"00000000-0000-4000-8000-00000000000a","command_id_form":"UUID","desired_cooling":"ON","desired_duty_permille":"250","device_id":"coldguard-001","device_mode":"OFF","event":"ACK","expiry_evaluable":"0","fault_code":"0x00000000","output_stage":"DISABLED","reapplied":"0","reason":"EPOCH_UNSYNCHRONIZED","schema":"1","source":"NETWORK","status":"SAFETY_BLOCKED","time_sync_state":"UNSYNCHRONIZED","uptime_ms":"123456"}
9a6a47a0119c9303:DEVICE_ACK:coldguard-001:abcd0123:00000000-0000-4000-8000-00000000000b:42:6:base | DEVICE_ACK | HOST_GENERATED_SYNTHETIC | evidence/A/W06/demo-command-capture.log | 9a6a47a0119c9303cb8c24094b878c78e1999b538fd5267a17f0ead281b3ec06 | coldguard.command-ack-serial/v1 | 6 | coldguard-001 | abcd0123 |  | PARTIAL | 00000000-0000-4000-8000-00000000000b | 42 |  | 123456 |  |  |  | DEVICE_BOOT_UPTIME | SYNCHRONIZED | NOT_APPLICABLE_PROTOCOL_EVIDENCE |  | SYNTHETIC_UNIT_TEST | 1 | ACK_IS_NOT_APPLIED_STATE|DEVICE_UPTIME_IS_BOOT_SCOPED|HOST_GENERATED_SYNTHETIC|NO_COMMAND_PUBLICATION_TIME | RAW_AND_NORMALIZED | {"ack_seq":"42","allowed_duty_max_permille":"500","applied_cooling":"OFF","applied_duty_permille":"0","boot_count":"9","boot_id":"abcd0123","command_id":"00000000-0000-4000-8000-00000000000b","command_id_form":"UUID","desired_cooling":"ON","desired_duty_permille":"250","device_id":"coldguard-001","device_mode":"OFF","event":"ACK","expiry_evaluable":"1","fault_code":"0x00000000","output_stage":"ENABLED","reapplied":"0","reason":"NONE","schema":"1","source":"NETWORK","status":"ACCEPTED","time_sync_state":"SYNCHRONIZED","uptime_ms":"123456"} | {"ack_seq":"42","allowed_duty_max_permille":"500","applied_cooling":"OFF","applied_duty_permille":"0","boot_count":"9","boot_id":"abcd0123","command_id":"00000000-0000-4000-8000-00000000000b","command_id_form":"UUID","desired_cooling":"ON","desired_duty_permille":"250","device_id":"coldguard-001","device_mode":"OFF","event":"ACK","expiry_evaluable":"1","fault_code":"0x00000000","output_stage":"ENABLED","reapplied":"0","reason":"NONE","schema":"1","source":"NETWORK","status":"ACCEPTED","time_sync_state":"SYNCHRONIZED","uptime_ms":"123456"}
9a6a47a0119c9303:DEVICE_ACK:coldguard-001:abcd0123:00000000-0000-4000-8000-00000000000c:42:7:base | DEVICE_ACK | HOST_GENERATED_SYNTHETIC | evidence/A/W06/demo-command-capture.log | 9a6a47a0119c9303cb8c24094b878c78e1999b538fd5267a17f0ead281b3ec06 | coldguard.command-ack-serial/v1 | 7 | coldguard-001 | abcd0123 |  | PARTIAL | 00000000-0000-4000-8000-00000000000c | 42 |  | 123456 |  |  |  | DEVICE_BOOT_UPTIME | SYNCHRONIZED | NOT_APPLICABLE_PROTOCOL_EVIDENCE |  | SYNTHETIC_UNIT_TEST | 1 | ACK_IS_NOT_APPLIED_STATE|DEVICE_UPTIME_IS_BOOT_SCOPED|HOST_GENERATED_SYNTHETIC|NO_COMMAND_PUBLICATION_TIME | RAW_AND_NORMALIZED | {"ack_seq":"42","allowed_duty_max_permille":"500","applied_cooling":"OFF","applied_duty_permille":"0","boot_count":"9","boot_id":"abcd0123","command_id":"00000000-0000-4000-8000-00000000000c","command_id_form":"UUID","desired_cooling":"ON","desired_duty_permille":"250","device_id":"coldguard-001","device_mode":"OFF","event":"ACK","expiry_evaluable":"1","fault_code":"0x00000000","output_stage":"ENABLED","reapplied":"0","reason":"EXPIRED","schema":"1","source":"NETWORK","status":"EXPIRED","time_sync_state":"SYNCHRONIZED","uptime_ms":"123456"} | {"ack_seq":"42","allowed_duty_max_permille":"500","applied_cooling":"OFF","applied_duty_permille":"0","boot_count":"9","boot_id":"abcd0123","command_id":"00000000-0000-4000-8000-00000000000c","command_id_form":"UUID","desired_cooling":"ON","desired_duty_permille":"250","device_id":"coldguard-001","device_mode":"OFF","event":"ACK","expiry_evaluable":"1","fault_code":"0x00000000","output_stage":"ENABLED","reapplied":"0","reason":"EXPIRED","schema":"1","source":"NETWORK","status":"EXPIRED","time_sync_state":"SYNCHRONIZED","uptime_ms":"123456"}
9a6a47a0119c9303:DEVICE_ACK:coldguard-001:abcd0123:00000000-0000-4000-8000-00000000000d:42:8:base | DEVICE_ACK | HOST_GENERATED_SYNTHETIC | evidence/A/W06/demo-command-capture.log | 9a6a47a0119c9303cb8c24094b878c78e1999b538fd5267a17f0ead281b3ec06 | coldguard.command-ack-serial/v1 | 8 | coldguard-001 | abcd0123 |  | PARTIAL | 00000000-0000-4000-8000-00000000000d | 42 |  | 123456 |  |  |  | DEVICE_BOOT_UPTIME | SYNCHRONIZED | NOT_APPLICABLE_PROTOCOL_EVIDENCE |  | SYNTHETIC_UNIT_TEST | 1 | ACK_IS_NOT_APPLIED_STATE|DEVICE_UPTIME_IS_BOOT_SCOPED|EXPIRY_NOT_EVALUABLE|HOST_GENERATED_SYNTHETIC|NO_COMMAND_PUBLICATION_TIME | RAW_AND_NORMALIZED | {"ack_seq":"42","allowed_duty_max_permille":"500","applied_cooling":"OFF","applied_duty_permille":"0","boot_count":"9","boot_id":"abcd0123","command_id":"00000000-0000-4000-8000-00000000000d","command_id_form":"UUID","desired_cooling":"ON","desired_duty_permille":"250","device_id":"coldguard-001","device_mode":"OFF","event":"ACK","expiry_evaluable":"0","fault_code":"0x00000000","output_stage":"ENABLED","reapplied":"0","reason":"DEVICE_ID_MISMATCH","schema":"1","source":"NETWORK","status":"REJECTED","time_sync_state":"SYNCHRONIZED","uptime_ms":"123456"} | {"ack_seq":"42","allowed_duty_max_permille":"500","applied_cooling":"OFF","applied_duty_permille":"0","boot_count":"9","boot_id":"abcd0123","command_id":"00000000-0000-4000-8000-00000000000d","command_id_form":"UUID","desired_cooling":"ON","desired_duty_permille":"250","device_id":"coldguard-001","device_mode":"OFF","event":"ACK","expiry_evaluable":"0","fault_code":"0x00000000","output_stage":"ENABLED","reapplied":"0","reason":"DEVICE_ID_MISMATCH","schema":"1","source":"NETWORK","status":"REJECTED","time_sync_state":"SYNCHRONIZED","uptime_ms":"123456"}
9a6a47a0119c9303:DEVICE_ACK:coldguard-001:abcd0123:00000000-0000-4000-8000-00000000000e:42:9:base | DEVICE_ACK | HOST_GENERATED_SYNTHETIC | evidence/A/W06/demo-command-capture.log | 9a6a47a0119c9303cb8c24094b878c78e1999b538fd5267a17f0ead281b3ec06 | coldguard.command-ack-serial/v1 | 9 | coldguard-001 | abcd0123 |  | PARTIAL | 00000000-0000-4000-8000-00000000000e | 42 |  | 123456 |  |  |  | DEVICE_BOOT_UPTIME | SYNCHRONIZED | NOT_APPLICABLE_PROTOCOL_EVIDENCE |  | SYNTHETIC_UNIT_TEST | 1 | ACK_IS_NOT_APPLIED_STATE|DEVICE_UPTIME_IS_BOOT_SCOPED|DUPLICATE_CANONICAL_REPLY|EXPIRY_NOT_EVALUABLE|HOST_GENERATED_SYNTHETIC|NO_COMMAND_PUBLICATION_TIME | RAW_AND_NORMALIZED | {"ack_seq":"42","allowed_duty_max_permille":"500","applied_cooling":"OFF","applied_duty_permille":"0","boot_count":"9","boot_id":"abcd0123","canonical_status":"ACCEPTED","command_id":"00000000-0000-4000-8000-00000000000e","command_id_form":"UUID","desired_cooling":"ON","desired_duty_permille":"250","device_id":"coldguard-001","device_mode":"OFF","event":"ACK","expiry_evaluable":"0","fault_code":"0x00000000","output_stage":"ENABLED","reapplied":"0","reason":"NONE","schema":"1","source":"NETWORK","status":"DUPLICATE_CANONICAL","time_sync_state":"SYNCHRONIZED","uptime_ms":"123456"} | {"ack_seq":"42","allowed_duty_max_permille":"500","applied_cooling":"OFF","applied_duty_permille":"0","boot_count":"9","boot_id":"abcd0123","canonical_status":"ACCEPTED","command_id":"00000000-0000-4000-8000-00000000000e","command_id_form":"UUID","desired_cooling":"ON","desired_duty_permille":"250","device_id":"coldguard-001","device_mode":"OFF","event":"ACK","expiry_evaluable":"0","fault_code":"0x00000000","output_stage":"ENABLED","reapplied":"0","reason":"NONE","schema":"1","source":"NETWORK","status":"DUPLICATE_CANONICAL","time_sync_state":"SYNCHRONIZED","uptime_ms":"123456"}
f6235e23b4513f98:TELEMETRY_SAMPLE:NO_DEVICE_ID:56044b74:1:2:base | TELEMETRY_SAMPLE | PHYSICAL_MEASURED | evidence/A/W09/exports/CG-S1-H8C-600S.json | f6235e23b4513f98ba7c1deb289f4a3d48afd3c0a87d7f38bfe4e67b2fc79feb | w09-run-export/v2 | 2 |  | 56044b74 | run-00000000 | PARTIAL |  |  | 1 | 904 |  |  |  | DEVICE_BOOT_UPTIME | NOT_EVIDENCED | INVALID |  | DIAGNOSTIC_ONLY | 1 | CLOCK_SYNC_NOT_EVIDENCED|DEVICE_ID_NOT_CARRIED|RUN_ID_UNRESOLVED | NORMALIZED_ONLY | {} | {"applied_cooling":"OFF","applied_duty_permille":"0","chamber_air_mean_c":"29.916667","chamber_air_status":"ROLE_QUALIFIED_CHAMBER_AIR","cooling_current_a":"0.000000","cooling_energy_counter_wh":"108.000000","cooling_power_w":"0.000000","cooling_voltage_v":"11.950000","device_state":"OFF","door_polarity":"UNCONFIRMED","door_state":"UNKNOWN","experiment_phase":"PRE_FIRST_SNAPSHOT","pressure_hpa":"1012.900000","quality.door":"UNKNOWN","quality.electrical":"UNKNOWN","quality.environment":"UNKNOWN","quality.overall":"INVALID","quality.probe.t1":"OK","quality.probe.t2":"OK","quality.probe.t3":"OK","quality.probe.t4":"OK","quality.producer":"INVALID","quality.provenance":"VALID","quality.sequence":"VALID","quality.thermal":"VALID","readback_duty_permille":"0","requested_duty_permille":"0","rh_pct":"68.915000","seq":"1","t1_c":"30.000000","t2_c":"29.875000","t3_c":"29.688000","t4_c":"30.062000","t_air_c":"30.572000"}
f6235e23b4513f98:TELEMETRY_SAMPLE:NO_DEVICE_ID:56044b74:2:3:base | TELEMETRY_SAMPLE | PHYSICAL_MEASURED | evidence/A/W09/exports/CG-S1-H8C-600S.json | f6235e23b4513f98ba7c1deb289f4a3d48afd3c0a87d7f38bfe4e67b2fc79feb | w09-run-export/v2 | 3 |  | 56044b74 | run-00000000 | PARTIAL |  |  | 2 | 1894 |  |  |  | DEVICE_BOOT_UPTIME | NOT_EVIDENCED | INVALID |  | DIAGNOSTIC_ONLY | 1 | CLOCK_SYNC_NOT_EVIDENCED|DEVICE_ID_NOT_CARRIED|RUN_ID_UNRESOLVED | NORMALIZED_ONLY | {} | {"applied_cooling":"OFF","applied_duty_permille":"0","chamber_air_mean_c":"29.937333","chamber_air_status":"ROLE_QUALIFIED_CHAMBER_AIR","cooling_current_a":"0.000000","cooling_energy_counter_wh":"108.000000","cooling_power_w":"0.000000","cooling_voltage_v":"11.950000","device_state":"OFF","door_polarity":"UNCONFIRMED","door_state":"UNKNOWN","experiment_phase":"PRE_FIRST_SNAPSHOT","pressure_hpa":"1012.990000","quality.door":"UNKNOWN","quality.electrical":"UNKNOWN","quality.environment":"UNKNOWN","quality.overall":"INVALID","quality.probe.t1":"OK","quality.probe.t2":"OK","quality.probe.t3":"OK","quality.probe.t4":"OK","quality.producer":"INVALID","quality.provenance":"VALID","quality.sequence":"VALID","quality.thermal":"VALID","readback_duty_permille":"0","requested_duty_permille":"0","rh_pct":"68.926000","seq":"2","t1_c":"30.000000","t2_c":"29.875000","t3_c":"29.750000","t4_c":"30.062000","t_air_c":"30.572000"}
f6235e23b4513f98:TELEMETRY_SAMPLE:NO_DEVICE_ID:56044b74:3:4:base | TELEMETRY_SAMPLE | PHYSICAL_MEASURED | evidence/A/W09/exports/CG-S1-H8C-600S.json | f6235e23b4513f98ba7c1deb289f4a3d48afd3c0a87d7f38bfe4e67b2fc79feb | w09-run-export/v2 | 4 |  | 56044b74 | run-00000000 | PARTIAL |  |  | 3 | 2894 |  |  |  | DEVICE_BOOT_UPTIME | NOT_EVIDENCED | INVALID |  | DIAGNOSTIC_ONLY | 1 | CLOCK_SYNC_NOT_EVIDENCED|DEVICE_ID_NOT_CARRIED|RUN_ID_UNRESOLVED | NORMALIZED_ONLY | {} | {"applied_cooling":"OFF","applied_duty_permille":"0","chamber_air_mean_c":"29.916667","chamber_air_status":"ROLE_QUALIFIED_CHAMBER_AIR","cooling_current_a":"0.000000","cooling_energy_counter_wh":"108.000000","cooling_power_w":"0.000000","cooling_voltage_v":"11.950000","device_state":"OFF","door_polarity":"UNCONFIRMED","door_state":"UNKNOWN","experiment_phase":"PRE_FIRST_SNAPSHOT","pressure_hpa":"1013.000000","quality.door":"UNKNOWN","quality.electrical":"UNKNOWN","quality.environment":"UNKNOWN","quality.overall":"INVALID","quality.probe.t1":"OK","quality.probe.t2":"OK","quality.probe.t3":"OK","quality.probe.t4":"OK","quality.producer":"INVALID","quality.provenance":"VALID","quality.sequence":"VALID","quality.thermal":"VALID","readback_duty_permille":"0","requested_duty_permille":"0","rh_pct":"68.932000","seq":"3","t1_c":"30.000000","t2_c":"29.875000","t3_c":"29.688000","t4_c":"30.062000","t_air_c":"30.577000"}
f6235e23b4513f98:TELEMETRY_SAMPLE:NO_DEVICE_ID:56044b74:4:5:base | TELEMETRY_SAMPLE | PHYSICAL_MEASURED | evidence/A/W09/exports/CG-S1-H8C-600S.json | f6235e23b4513f98ba7c1deb289f4a3d48afd3c0a87d7f38bfe4e67b2fc79feb | w09-run-export/v2 | 5 |  | 56044b74 | run-00000000 | PARTIAL |  |  | 4 | 3894 |  |  |  | DEVICE_BOOT_UPTIME | NOT_EVIDENCED | INVALID |  | DIAGNOSTIC_ONLY | 1 | CLOCK_SYNC_NOT_EVIDENCED|DEVICE_ID_NOT_CARRIED|RUN_ID_UNRESOLVED | NORMALIZED_ONLY | {} | {"applied_cooling":"OFF","applied_duty_permille":"0","chamber_air_mean_c":"29.916667","chamber_air_status":"ROLE_QUALIFIED_CHAMBER_AIR","cooling_current_a":"0.000000","cooling_energy_counter_wh":"108.000000","cooling_power_w":"0.000000","cooling_voltage_v":"11.950000","device_state":"OFF","door_polarity":"UNCONFIRMED","door_state":"UNKNOWN","experiment_phase":"PRE_FIRST_SNAPSHOT","pressure_hpa":"1013.060000","quality.door":"UNKNOWN","quality.electrical":"UNKNOWN","quality.environment":"UNKNOWN","quality.overall":"INVALID","quality.probe.t1":"OK","quality.probe.t2":"OK","quality.probe.t3":"OK","quality.probe.t4":"OK","quality.producer":"INVALID","quality.provenance":"VALID","quality.sequence":"VALID","quality.thermal":"VALID","readback_duty_permille":"0","requested_duty_permille":"0","rh_pct":"68.927000","seq":"4","t1_c":"30.000000","t2_c":"29.875000","t3_c":"29.688000","t4_c":"30.062000","t_air_c":"30.582000"}
f6235e23b4513f98:TELEMETRY_SAMPLE:NO_DEVICE_ID:56044b74:5:6:base | TELEMETRY_SAMPLE | PHYSICAL_MEASURED | evidence/A/W09/exports/CG-S1-H8C-600S.json | f6235e23b4513f98ba7c1deb289f4a3d48afd3c0a87d7f38bfe4e67b2fc79feb | w09-run-export/v2 | 6 |  | 56044b74 | run-00000000 | PARTIAL |  |  | 5 | 4894 |  |  |  | DEVICE_BOOT_UPTIME | NOT_EVIDENCED | INVALID |  | DIAGNOSTIC_ONLY | 1 | CLOCK_SYNC_NOT_EVIDENCED|DEVICE_ID_NOT_CARRIED|RUN_ID_UNRESOLVED | NORMALIZED_ONLY | {} | {"applied_cooling":"OFF","applied_duty_permille":"0","chamber_air_mean_c":"29.916667","chamber_air_status":"ROLE_QUALIFIED_CHAMBER_AIR","cooling_current_a":"0.000000","cooling_energy_counter_wh":"108.000000","cooling_power_w":"0.000000","cooling_voltage_v":"11.950000","device_state":"OFF","door_polarity":"UNCONFIRMED","door_state":"UNKNOWN","experiment_phase":"PRE_FIRST_SNAPSHOT","pressure_hpa":"1012.940000","quality.door":"UNKNOWN","quality.electrical":"UNKNOWN","quality.environment":"UNKNOWN","quality.overall":"INVALID","quality.probe.t1":"OK","quality.probe.t2":"OK","quality.probe.t3":"OK","quality.probe.t4":"OK","quality.producer":"INVALID","quality.provenance":"VALID","quality.sequence":"VALID","quality.thermal":"VALID","readback_duty_permille":"0","requested_duty_permille":"0","rh_pct":"68.915000","seq":"5","t1_c":"30.000000","t2_c":"29.875000","t3_c":"29.688000","t4_c":"30.062000","t_air_c":"30.577000"}
f6235e23b4513f98:TELEMETRY_SAMPLE:NO_DEVICE_ID:56044b74:6:7:base | TELEMETRY_SAMPLE | PHYSICAL_MEASURED | evidence/A/W09/exports/CG-S1-H8C-600S.json | f6235e23b4513f98ba7c1deb289f4a3d48afd3c0a87d7f38bfe4e67b2fc79feb | w09-run-export/v2 | 7 |  | 56044b74 | run-00000000 | PARTIAL |  |  | 6 | 5894 |  |  |  | DEVICE_BOOT_UPTIME | NOT_EVIDENCED | INVALID |  | DIAGNOSTIC_ONLY | 1 | CLOCK_SYNC_NOT_EVIDENCED|DEVICE_ID_NOT_CARRIED|RUN_ID_UNRESOLVED | NORMALIZED_ONLY | {} | {"applied_cooling":"OFF","applied_duty_permille":"0","chamber_air_mean_c":"29.916667","chamber_air_status":"ROLE_QUALIFIED_CHAMBER_AIR","cooling_current_a":"0.000000","cooling_energy_counter_wh":"108.000000","cooling_power_w":"0.000000","cooling_voltage_v":"11.950000","device_state":"OFF","door_polarity":"UNCONFIRMED","door_state":"UNKNOWN","experiment_phase":"PRE_FIRST_SNAPSHOT","pressure_hpa":"1013.030000","quality.door":"UNKNOWN","quality.electrical":"UNKNOWN","quality.environment":"UNKNOWN","quality.overall":"INVALID","quality.probe.t1":"OK","quality.probe.t2":"OK","quality.probe.t3":"OK","quality.probe.t4":"OK","quality.producer":"INVALID","quality.provenance":"VALID","quality.sequence":"VALID","quality.thermal":"VALID","readback_duty_permille":"0","requested_duty_permille":"0","rh_pct":"68.905000","seq":"6","t1_c":"30.000000","t2_c":"29.875000","t3_c":"29.688000","t4_c":"30.062000","t_air_c":"30.582000"}
f6235e23b4513f98:TELEMETRY_SAMPLE:NO_DEVICE_ID:56044b74:7:8:base | TELEMETRY_SAMPLE | PHYSICAL_MEASURED | evidence/A/W09/exports/CG-S1-H8C-600S.json | f6235e23b4513f98ba7c1deb289f4a3d48afd3c0a87d7f38bfe4e67b2fc79feb | w09-run-export/v2 | 8 |  | 56044b74 | run-00000000 | PARTIAL |  |  | 7 | 6894 |  |  |  | DEVICE_BOOT_UPTIME | NOT_EVIDENCED | INVALID |  | DIAGNOSTIC_ONLY | 1 | CLOCK_SYNC_NOT_EVIDENCED|DEVICE_ID_NOT_CARRIED|RUN_ID_UNRESOLVED | NORMALIZED_ONLY | {} | {"applied_cooling":"OFF","applied_duty_permille":"0","chamber_air_mean_c":"29.916667","chamber_air_status":"ROLE_QUALIFIED_CHAMBER_AIR","cooling_current_a":"0.000000","cooling_energy_counter_wh":"108.000000","cooling_power_w":"0.000000","cooling_voltage_v":"11.950000","device_state":"OFF","door_polarity":"UNCONFIRMED","door_state":"UNKNOWN","experiment_phase":"PRE_FIRST_SNAPSHOT","pressure_hpa":"1013.000000","quality.door":"UNKNOWN","quality.electrical":"UNKNOWN","quality.environment":"UNKNOWN","quality.overall":"INVALID","quality.probe.t1":"OK","quality.probe.t2":"OK","quality.probe.t3":"OK","quality.probe.t4":"OK","quality.producer":"INVALID","quality.provenance":"VALID","quality.sequence":"VALID","quality.thermal":"VALID","readback_duty_permille":"0","requested_duty_permille":"0","rh_pct":"68.904000","seq":"7","t1_c":"30.000000","t2_c":"29.875000","t3_c":"29.688000","t4_c":"30.062000","t_air_c":"30.577000"}
f6235e23b4513f98:TELEMETRY_SAMPLE:NO_DEVICE_ID:56044b74:8:9:base | TELEMETRY_SAMPLE | PHYSICAL_MEASURED | evidence/A/W09/exports/CG-S1-H8C-600S.json | f6235e23b4513f98ba7c1deb289f4a3d48afd3c0a87d7f38bfe4e67b2fc79feb | w09-run-export/v2 | 9 |  | 56044b74 | run-00000000 | PARTIAL |  |  | 8 | 7894 |  |  |  | DEVICE_BOOT_UPTIME | NOT_EVIDENCED | INVALID |  | DIAGNOSTIC_ONLY | 1 | CLOCK_SYNC_NOT_EVIDENCED|DEVICE_ID_NOT_CARRIED|RUN_ID_UNRESOLVED | NORMALIZED_ONLY | {} | {"applied_cooling":"OFF","applied_duty_permille":"0","chamber_air_mean_c":"29.916667","chamber_air_status":"ROLE_QUALIFIED_CHAMBER_AIR","cooling_current_a":"0.000000","cooling_energy_counter_wh":"108.000000","cooling_power_w":"0.000000","cooling_voltage_v":"11.950000","device_state":"OFF","door_polarity":"UNCONFIRMED","door_state":"UNKNOWN","experiment_phase":"PRE_FIRST_SNAPSHOT","pressure_hpa":"1013.000000","quality.door":"UNKNOWN","quality.electrical":"UNKNOWN","quality.environment":"UNKNOWN","quality.overall":"INVALID","quality.probe.t1":"OK","quality.probe.t2":"OK","quality.probe.t3":"OK","quality.probe.t4":"OK","quality.producer":"INVALID","quality.provenance":"VALID","quality.sequence":"VALID","quality.thermal":"VALID","readback_duty_permille":"0","requested_duty_permille":"0","rh_pct":"68.899000","seq":"8","t1_c":"30.000000","t2_c":"29.875000","t3_c":"29.688000","t4_c":"30.062000","t_air_c":"30.582000"}
f6235e23b4513f98:TELEMETRY_SAMPLE:NO_DEVICE_ID:56044b74:9:10:base | TELEMETRY_SAMPLE | PHYSICAL_MEASURED | evidence/A/W09/exports/CG-S1-H8C-600S.json | f6235e23b4513f98ba7c1deb289f4a3d48afd3c0a87d7f38bfe4e67b2fc79feb | w09-run-export/v2 | 10 |  | 56044b74 | run-00000000 | PARTIAL |  |  | 9 | 8894 |  |  |  | DEVICE_BOOT_UPTIME | NOT_EVIDENCED | INVALID |  | DIAGNOSTIC_ONLY | 1 | CLOCK_SYNC_NOT_EVIDENCED|DEVICE_ID_NOT_CARRIED|RUN_ID_UNRESOLVED | NORMALIZED_ONLY | {} | {"applied_cooling":"OFF","applied_duty_permille":"0","chamber_air_mean_c":"29.916667","chamber_air_status":"ROLE_QUALIFIED_CHAMBER_AIR","cooling_current_a":"0.000000","cooling_energy_counter_wh":"108.000000","cooling_power_w":"0.000000","cooling_voltage_v":"11.950000","device_state":"OFF","door_polarity":"UNCONFIRMED","door_state":"UNKNOWN","experiment_phase":"PRE_FIRST_SNAPSHOT","pressure_hpa":"1012.960000","quality.door":"UNKNOWN","quality.electrical":"UNKNOWN","quality.environment":"UNKNOWN","quality.overall":"INVALID","quality.probe.t1":"OK","quality.probe.t2":"OK","quality.probe.t3":"OK","quality.probe.t4":"OK","quality.producer":"INVALID","quality.provenance":"VALID","quality.sequence":"VALID","quality.thermal":"VALID","readback_duty_permille":"0","requested_duty_permille":"0","rh_pct":"68.898000","seq":"9","t1_c":"30.000000","t2_c":"29.875000","t3_c":"29.688000","t4_c":"30.062000","t_air_c":"30.572000"}
f6235e23b4513f98:TELEMETRY_SAMPLE:NO_DEVICE_ID:56044b74:10:11:base | TELEMETRY_SAMPLE | PHYSICAL_MEASURED | evidence/A/W09/exports/CG-S1-H8C-600S.json | f6235e23b4513f98ba7c1deb289f4a3d48afd3c0a87d7f38bfe4e67b2fc79feb | w09-run-export/v2 | 11 |  | 56044b74 | run-00000000 | PARTIAL |  |  | 10 | 9894 |  |  |  | DEVICE_BOOT_UPTIME | NOT_EVIDENCED | INVALID |  | DIAGNOSTIC_ONLY | 1 | CLOCK_SYNC_NOT_EVIDENCED|DEVICE_ID_NOT_CARRIED|RUN_ID_UNRESOLVED | NORMALIZED_ONLY | {} | {"applied_cooling":"OFF","applied_duty_permille":"0","chamber_air_mean_c":"29.937333","chamber_air_status":"ROLE_QUALIFIED_CHAMBER_AIR","cooling_current_a":"0.000000","cooling_energy_counter_wh":"108.000000","cooling_power_w":"0.000000","cooling_voltage_v":"11.950000","device_state":"OFF","door_polarity":"UNCONFIRMED","door_state":"UNKNOWN","experiment_phase":"PRE_FIRST_SNAPSHOT","pressure_hpa":"1012.960000","quality.door":"UNKNOWN","quality.electrical":"UNKNOWN","quality.environment":"UNKNOWN","quality.overall":"INVALID","quality.probe.t1":"OK","quality.probe.t2":"OK","quality.probe.t3":"OK","quality.probe.t4":"OK","quality.producer":"INVALID","quality.provenance":"VALID","quality.sequence":"VALID","quality.thermal":"VALID","readback_duty_permille":"0","requested_duty_permille":"0","rh_pct":"68.904000","seq":"10","t1_c":"30.000000","t2_c":"29.875000","t3_c":"29.750000","t4_c":"30.062000","t_air_c":"30.572000"}
f6235e23b4513f98:TELEMETRY_SAMPLE:NO_DEVICE_ID:56044b74:11:12:base | TELEMETRY_SAMPLE | PHYSICAL_MEASURED | evidence/A/W09/exports/CG-S1-H8C-600S.json | f6235e23b4513f98ba7c1deb289f4a3d48afd3c0a87d7f38bfe4e67b2fc79feb | w09-run-export/v2 | 12 |  | 56044b74 | run-00000000 | PARTIAL |  |  | 11 | 10894 |  |  |  | DEVICE_BOOT_UPTIME | NOT_EVIDENCED | INVALID |  | DIAGNOSTIC_ONLY | 1 | CLOCK_SYNC_NOT_EVIDENCED|DEVICE_ID_NOT_CARRIED|RUN_ID_UNRESOLVED | NORMALIZED_ONLY | {} | {"applied_cooling":"OFF","applied_duty_permille":"0","chamber_air_mean_c":"29.916667","chamber_air_status":"ROLE_QUALIFIED_CHAMBER_AIR","cooling_current_a":"0.000000","cooling_energy_counter_wh":"108.000000","cooling_power_w":"0.000000","cooling_voltage_v":"11.950000","device_state":"OFF","door_polarity":"UNCONFIRMED","door_state":"UNKNOWN","experiment_phase":"PRE_FIRST_SNAPSHOT","pressure_hpa":"1013.000000","quality.door":"UNKNOWN","quality.electrical":"UNKNOWN","quality.environment":"UNKNOWN","quality.overall":"INVALID","quality.probe.t1":"OK","quality.probe.t2":"OK","quality.probe.t3":"OK","quality.probe.t4":"OK","quality.producer":"INVALID","quality.provenance":"VALID","quality.sequence":"VALID","quality.thermal":"VALID","readback_duty_permille":"0","requested_duty_permille":"0","rh_pct":"68.893000","seq":"11","t1_c":"30.000000","t2_c":"29.875000","t3_c":"29.688000","t4_c":"30.062000","t_air_c":"30.577000"}
f6235e23b4513f98:TELEMETRY_SAMPLE:NO_DEVICE_ID:56044b74:12:13:base | TELEMETRY_SAMPLE | PHYSICAL_MEASURED | evidence/A/W09/exports/CG-S1-H8C-600S.json | f6235e23b4513f98ba7c1deb289f4a3d48afd3c0a87d7f38bfe4e67b2fc79feb | w09-run-export/v2 | 13 |  | 56044b74 | run-00000000 | PARTIAL |  |  | 12 | 11894 |  |  |  | DEVICE_BOOT_UPTIME | NOT_EVIDENCED | INVALID |  | DIAGNOSTIC_ONLY | 1 | CLOCK_SYNC_NOT_EVIDENCED|DEVICE_ID_NOT_CARRIED|RUN_ID_UNRESOLVED | NORMALIZED_ONLY | {} | {"applied_cooling":"OFF","applied_duty_permille":"0","chamber_air_mean_c":"29.916667","chamber_air_status":"ROLE_QUALIFIED_CHAMBER_AIR","cooling_current_a":"0.000000","cooling_energy_counter_wh":"108.000000","cooling_power_w":"0.000000","cooling_voltage_v":"11.950000","device_state":"OFF","door_polarity":"UNCONFIRMED","door_state":"UNKNOWN","experiment_phase":"PRE_FIRST_SNAPSHOT","pressure_hpa":"1013.010000","quality.door":"UNKNOWN","quality.electrical":"UNKNOWN","quality.environment":"UNKNOWN","quality.overall":"INVALID","quality.probe.t1":"OK","quality.probe.t2":"OK","quality.probe.t3":"OK","quality.probe.t4":"OK","quality.producer":"INVALID","quality.provenance":"VALID","quality.sequence":"VALID","quality.thermal":"VALID","readback_duty_permille":"0","requested_duty_permille":"0","rh_pct":"68.894000","seq":"12","t1_c":"30.000000","t2_c":"29.875000","t3_c":"29.688000","t4_c":"30.062000","t_air_c":"30.587000"}
f6235e23b4513f98:TELEMETRY_SAMPLE:NO_DEVICE_ID:56044b74:13:14:base | TELEMETRY_SAMPLE | PHYSICAL_MEASURED | evidence/A/W09/exports/CG-S1-H8C-600S.json | f6235e23b4513f98ba7c1deb289f4a3d48afd3c0a87d7f38bfe4e67b2fc79feb | w09-run-export/v2 | 14 |  | 56044b74 | run-00000000 | PARTIAL |  |  | 13 | 12894 |  |  |  | DEVICE_BOOT_UPTIME | NOT_EVIDENCED | INVALID |  | DIAGNOSTIC_ONLY | 1 | CLOCK_SYNC_NOT_EVIDENCED|DEVICE_ID_NOT_CARRIED|RUN_ID_UNRESOLVED | NORMALIZED_ONLY | {} | {"applied_cooling":"OFF","applied_duty_permille":"0","chamber_air_mean_c":"29.916667","chamber_air_status":"ROLE_QUALIFIED_CHAMBER_AIR","cooling_current_a":"0.000000","cooling_energy_counter_wh":"108.000000","cooling_power_w":"0.000000","cooling_voltage_v":"11.950000","device_state":"OFF","door_polarity":"UNCONFIRMED","door_state":"UNKNOWN","experiment_phase":"PRE_FIRST_SNAPSHOT","pressure_hpa":"1013.020000","quality.door":"UNKNOWN","quality.electrical":"UNKNOWN","quality.environment":"UNKNOWN","quality.overall":"INVALID","quality.probe.t1":"OK","quality.probe.t2":"OK","quality.probe.t3":"OK","quality.probe.t4":"OK","quality.producer":"INVALID","quality.provenance":"VALID","quality.sequence":"VALID","quality.thermal":"VALID","readback_duty_permille":"0","requested_duty_permille":"0","rh_pct":"68.894000","seq":"13","t1_c":"30.000000","t2_c":"29.875000","t3_c":"29.688000","t4_c":"30.062000","t_air_c":"30.592000"}
f6235e23b4513f98:TELEMETRY_SAMPLE:NO_DEVICE_ID:56044b74:14:15:base | TELEMETRY_SAMPLE | PHYSICAL_MEASURED | evidence/A/W09/exports/CG-S1-H8C-600S.json | f6235e23b4513f98ba7c1deb289f4a3d48afd3c0a87d7f38bfe4e67b2fc79feb | w09-run-export/v2 | 15 |  | 56044b74 | run-00000000 | PARTIAL |  |  | 14 | 13894 |  |  |  | DEVICE_BOOT_UPTIME | NOT_EVIDENCED | INVALID |  | DIAGNOSTIC_ONLY | 1 | CLOCK_SYNC_NOT_EVIDENCED|DEVICE_ID_NOT_CARRIED|RUN_ID_UNRESOLVED | NORMALIZED_ONLY | {} | {"applied_cooling":"OFF","applied_duty_permille":"0","chamber_air_mean_c":"29.916667","chamber_air_status":"ROLE_QUALIFIED_CHAMBER_AIR","cooling_current_a":"0.000000","cooling_energy_counter_wh":"108.000000","cooling_power_w":"0.000000","cooling_voltage_v":"11.950000","device_state":"OFF","door_polarity":"UNCONFIRMED","door_state":"UNKNOWN","experiment_phase":"PRE_FIRST_SNAPSHOT","pressure_hpa":"1012.940000","quality.door":"UNKNOWN","quality.electrical":"UNKNOWN","quality.environment":"UNKNOWN","quality.overall":"INVALID","quality.probe.t1":"OK","quality.probe.t2":"OK","quality.probe.t3":"OK","quality.probe.t4":"OK","quality.producer":"INVALID","quality.provenance":"VALID","quality.sequence":"VALID","quality.thermal":"VALID","readback_duty_permille":"0","requested_duty_permille":"0","rh_pct":"68.900000","seq":"14","t1_c":"30.000000","t2_c":"29.875000","t3_c":"29.688000","t4_c":"30.062000","t_air_c":"30.597000"}
f6235e23b4513f98:TELEMETRY_SAMPLE:NO_DEVICE_ID:56044b74:15:16:base | TELEMETRY_SAMPLE | PHYSICAL_MEASURED | evidence/A/W09/exports/CG-S1-H8C-600S.json | f6235e23b4513f98ba7c1deb289f4a3d48afd3c0a87d7f38bfe4e67b2fc79feb | w09-run-export/v2 | 16 |  | 56044b74 | run-00000000 | PARTIAL |  |  | 15 | 14894 |  |  |  | DEVICE_BOOT_UPTIME | NOT_EVIDENCED | INVALID |  | DIAGNOSTIC_ONLY | 1 | CLOCK_SYNC_NOT_EVIDENCED|DEVICE_ID_NOT_CARRIED|RUN_ID_UNRESOLVED | NORMALIZED_ONLY | {} | {"applied_cooling":"OFF","applied_duty_permille":"0","chamber_air_mean_c":"29.937333","chamber_air_status":"ROLE_QUALIFIED_CHAMBER_AIR","cooling_current_a":"0.000000","cooling_energy_counter_wh":"108.000000","cooling_power_w":"0.000000","cooling_voltage_v":"11.950000","device_state":"OFF","door_polarity":"UNCONFIRMED","door_state":"UNKNOWN","experiment_phase":"PRE_FIRST_SNAPSHOT","pressure_hpa":"1013.020000","quality.door":"UNKNOWN","quality.electrical":"UNKNOWN","quality.environment":"UNKNOWN","quality.overall":"INVALID","quality.probe.t1":"OK","quality.probe.t2":"OK","quality.probe.t3":"OK","quality.probe.t4":"OK","quality.producer":"INVALID","quality.provenance":"VALID","quality.sequence":"VALID","quality.thermal":"VALID","readback_duty_permille":"0","requested_duty_permille":"0","rh_pct":"68.894000","seq":"15","t1_c":"30.062000","t2_c":"29.875000","t3_c":"29.688000","t4_c":"30.062000","t_air_c":"30.592000"}
f6235e23b4513f98:TELEMETRY_SAMPLE:NO_DEVICE_ID:56044b74:16:17:base | TELEMETRY_SAMPLE | PHYSICAL_MEASURED | evidence/A/W09/exports/CG-S1-H8C-600S.json | f6235e23b4513f98ba7c1deb289f4a3d48afd3c0a87d7f38bfe4e67b2fc79feb | w09-run-export/v2 | 17 |  | 56044b74 | run-00000000 | PARTIAL |  |  | 16 | 15894 |  |  |  | DEVICE_BOOT_UPTIME | NOT_EVIDENCED | INVALID |  | DIAGNOSTIC_ONLY | 1 | CLOCK_SYNC_NOT_EVIDENCED|DEVICE_ID_NOT_CARRIED|RUN_ID_UNRESOLVED | NORMALIZED_ONLY | {} | {"applied_cooling":"OFF","applied_duty_permille":"0","chamber_air_mean_c":"29.916667","chamber_air_status":"ROLE_QUALIFIED_CHAMBER_AIR","cooling_current_a":"0.000000","cooling_energy_counter_wh":"108.000000","cooling_power_w":"0.000000","cooling_voltage_v":"11.950000","device_state":"OFF","door_polarity":"UNCONFIRMED","door_state":"UNKNOWN","experiment_phase":"PRE_FIRST_SNAPSHOT","pressure_hpa":"1013.000000","quality.door":"UNKNOWN","quality.electrical":"UNKNOWN","quality.environment":"UNKNOWN","quality.overall":"INVALID","quality.probe.t1":"OK","quality.probe.t2":"OK","quality.probe.t3":"OK","quality.probe.t4":"OK","quality.producer":"INVALID","quality.provenance":"VALID","quality.sequence":"VALID","quality.thermal":"VALID","readback_duty_permille":"0","requested_duty_permille":"0","rh_pct":"68.899000","seq":"16","t1_c":"30.000000","t2_c":"29.875000","t3_c":"29.688000","t4_c":"30.062000","t_air_c":"30.582000"}
f6235e23b4513f98:TELEMETRY_SAMPLE:NO_DEVICE_ID:56044b74:17:18:base | TELEMETRY_SAMPLE | PHYSICAL_MEASURED | evidence/A/W09/exports/CG-S1-H8C-600S.json | f6235e23b4513f98ba7c1deb289f4a3d48afd3c0a87d7f38bfe4e67b2fc79feb | w09-run-export/v2 | 18 |  | 56044b74 | run-00000000 | PARTIAL |  |  | 17 | 16894 |  |  |  | DEVICE_BOOT_UPTIME | NOT_EVIDENCED | INVALID |  | DIAGNOSTIC_ONLY | 1 | CLOCK_SYNC_NOT_EVIDENCED|DEVICE_ID_NOT_CARRIED|RUN_ID_UNRESOLVED | NORMALIZED_ONLY | {} | {"applied_cooling":"OFF","applied_duty_permille":"0","chamber_air_mean_c":"29.916667","chamber_air_status":"ROLE_QUALIFIED_CHAMBER_AIR","cooling_current_a":"0.000000","cooling_energy_counter_wh":"108.000000","cooling_power_w":"0.000000","cooling_voltage_v":"11.950000","device_state":"OFF","door_polarity":"UNCONFIRMED","door_state":"UNKNOWN","experiment_phase":"PRE_FIRST_SNAPSHOT","pressure_hpa":"1012.950000","quality.door":"UNKNOWN","quality.electrical":"UNKNOWN","quality.environment":"UNKNOWN","quality.overall":"INVALID","quality.probe.t1":"OK","quality.probe.t2":"OK","quality.probe.t3":"OK","quality.probe.t4":"OK","quality.producer":"INVALID","quality.provenance":"VALID","quality.sequence":"VALID","quality.thermal":"VALID","readback_duty_permille":"0","requested_duty_permille":"0","rh_pct":"68.888000","seq":"17","t1_c":"30.000000","t2_c":"29.875000","t3_c":"29.688000","t4_c":"30.062000","t_air_c":"30.582000"}
f6235e23b4513f98:TELEMETRY_SAMPLE:NO_DEVICE_ID:56044b74:18:19:base | TELEMETRY_SAMPLE | PHYSICAL_MEASURED | evidence/A/W09/exports/CG-S1-H8C-600S.json | f6235e23b4513f98ba7c1deb289f4a3d48afd3c0a87d7f38bfe4e67b2fc79feb | w09-run-export/v2 | 19 |  | 56044b74 | run-00000000 | PARTIAL |  |  | 18 | 17894 |  |  |  | DEVICE_BOOT_UPTIME | NOT_EVIDENCED | UNKNOWN |  | DIAGNOSTIC_ONLY | 1 | CLOCK_SYNC_NOT_EVIDENCED|DEVICE_ID_NOT_CARRIED|RUN_ID_UNRESOLVED | NORMALIZED_ONLY | {} | {"applied_cooling":"OFF","applied_duty_permille":"0","chamber_air_mean_c":"29.916667","chamber_air_status":"ROLE_QUALIFIED_CHAMBER_AIR","cooling_current_a":"0.000000","cooling_energy_counter_wh":"108.000000","cooling_power_w":"0.000000","cooling_voltage_v":"11.950000","device_state":"OFF","door_polarity":"CONFIRMED","door_state":"CLOSED","experiment_phase":"OFF_IDLE","pressure_hpa":"1012.990000","quality.door":"UNKNOWN","quality.electrical":"UNKNOWN","quality.environment":"UNKNOWN","quality.overall":"UNKNOWN","quality.probe.t1":"OK","quality.probe.t2":"OK","quality.probe.t3":"OK","quality.probe.t4":"OK","quality.producer":"DEGRADED","quality.provenance":"VALID","quality.sequence":"VALID","quality.thermal":"VALID","readback_duty_permille":"0","requested_duty_permille":"0","rh_pct":"68.872000","seq":"18","t1_c":"30.000000","t2_c":"29.875000","t3_c":"29.688000","t4_c":"30.062000","t_air_c":"30.592000"}
f6235e23b4513f98:TELEMETRY_SAMPLE:NO_DEVICE_ID:56044b74:19:20:base | TELEMETRY_SAMPLE | PHYSICAL_MEASURED | evidence/A/W09/exports/CG-S1-H8C-600S.json | f6235e23b4513f98ba7c1deb289f4a3d48afd3c0a87d7f38bfe4e67b2fc79feb | w09-run-export/v2 | 20 |  | 56044b74 | run-00000000 | PARTIAL |  |  | 19 | 18894 |  |  |  | DEVICE_BOOT_UPTIME | NOT_EVIDENCED | UNKNOWN |  | DIAGNOSTIC_ONLY | 1 | CLOCK_SYNC_NOT_EVIDENCED|DEVICE_ID_NOT_CARRIED|RUN_ID_UNRESOLVED | NORMALIZED_ONLY | {} | {"applied_cooling":"OFF","applied_duty_permille":"0","chamber_air_mean_c":"29.916667","chamber_air_status":"ROLE_QUALIFIED_CHAMBER_AIR","cooling_current_a":"0.000000","cooling_energy_counter_wh":"108.000000","cooling_power_w":"0.000000","cooling_voltage_v":"11.950000","device_state":"OFF","door_polarity":"CONFIRMED","door_state":"CLOSED","experiment_phase":"OFF_IDLE","pressure_hpa":"1012.950000","quality.door":"UNKNOWN","quality.electrical":"UNKNOWN","quality.environment":"UNKNOWN","quality.overall":"UNKNOWN","quality.probe.t1":"OK","quality.probe.t2":"OK","quality.probe.t3":"OK","quality.probe.t4":"OK","quality.producer":"DEGRADED","quality.provenance":"VALID","quality.sequence":"VALID","quality.thermal":"VALID","readback_duty_permille":"0","requested_duty_permille":"0","rh_pct":"68.888000","seq":"19","t1_c":"30.000000","t2_c":"29.875000","t3_c":"29.688000","t4_c":"30.062000","t_air_c":"30.582000"}
f6235e23b4513f98:TELEMETRY_SAMPLE:NO_DEVICE_ID:56044b74:20:21:base | TELEMETRY_SAMPLE | PHYSICAL_MEASURED | evidence/A/W09/exports/CG-S1-H8C-600S.json | f6235e23b4513f98ba7c1deb289f4a3d48afd3c0a87d7f38bfe4e67b2fc79feb | w09-run-export/v2 | 21 |  | 56044b74 | run-00000000 | PARTIAL |  |  | 20 | 19894 |  |  |  | DEVICE_BOOT_UPTIME | NOT_EVIDENCED | UNKNOWN |  | DIAGNOSTIC_ONLY | 1 | CLOCK_SYNC_NOT_EVIDENCED|DEVICE_ID_NOT_CARRIED|RUN_ID_UNRESOLVED | NORMALIZED_ONLY | {} | {"applied_cooling":"OFF","applied_duty_permille":"0","chamber_air_mean_c":"29.937333","chamber_air_status":"ROLE_QUALIFIED_CHAMBER_AIR","cooling_current_a":"0.000000","cooling_energy_counter_wh":"108.000000","cooling_power_w":"0.000000","cooling_voltage_v":"11.950000","device_state":"OFF","door_polarity":"CONFIRMED","door_state":"CLOSED","experiment_phase":"OFF_IDLE","pressure_hpa":"1013.000000","quality.door":"UNKNOWN","quality.electrical":"UNKNOWN","quality.environment":"UNKNOWN","quality.overall":"UNKNOWN","quality.probe.t1":"OK","quality.probe.t2":"OK","quality.probe.t3":"OK","quality.probe.t4":"OK","quality.producer":"DEGRADED","quality.provenance":"VALID","quality.sequence":"VALID","quality.thermal":"VALID","readback_duty_permille":"0","requested_duty_permille":"0","rh_pct":"68.878000","seq":"20","t1_c":"30.000000","t2_c":"29.875000","t3_c":"29.750000","t4_c":"30.062000","t_air_c":"30.597000"}
f6235e23b4513f98:TELEMETRY_SAMPLE:NO_DEVICE_ID:56044b74:21:22:base | TELEMETRY_SAMPLE | PHYSICAL_MEASURED | evidence/A/W09/exports/CG-S1-H8C-600S.json | f6235e23b4513f98ba7c1deb289f4a3d48afd3c0a87d7f38bfe4e67b2fc79feb | w09-run-export/v2 | 22 |  | 56044b74 | run-00000000 | PARTIAL |  |  | 21 | 20894 |  |  |  | DEVICE_BOOT_UPTIME | NOT_EVIDENCED | UNKNOWN |  | DIAGNOSTIC_ONLY | 1 | CLOCK_SYNC_NOT_EVIDENCED|DEVICE_ID_NOT_CARRIED|RUN_ID_UNRESOLVED | NORMALIZED_ONLY | {} | {"applied_cooling":"OFF","applied_duty_permille":"0","chamber_air_mean_c":"29.916667","chamber_air_status":"ROLE_QUALIFIED_CHAMBER_AIR","cooling_current_a":"0.000000","cooling_energy_counter_wh":"108.000000","cooling_power_w":"0.000000","cooling_voltage_v":"11.950000","device_state":"OFF","door_polarity":"CONFIRMED","door_state":"CLOSED","experiment_phase":"OFF_IDLE","pressure_hpa":"1013.020000","quality.door":"UNKNOWN","quality.electrical":"UNKNOWN","quality.environment":"UNKNOWN","quality.overall":"UNKNOWN","quality.probe.t1":"OK","quality.probe.t2":"OK","quality.probe.t3":"OK","quality.probe.t4":"OK","quality.producer":"DEGRADED","quality.provenance":"VALID","quality.sequence":"VALID","quality.thermal":"VALID","readback_duty_permille":"0","requested_duty_permille":"0","rh_pct":"68.877000","seq":"21","t1_c":"30.000000","t2_c":"29.875000","t3_c":"29.688000","t4_c":"30.062000","t_air_c":"30.592000"}
f6235e23b4513f98:TELEMETRY_SAMPLE:NO_DEVICE_ID:56044b74:22:23:base | TELEMETRY_SAMPLE | PHYSICAL_MEASURED | evidence/A/W09/exports/CG-S1-H8C-600S.json | f6235e23b4513f98ba7c1deb289f4a3d48afd3c0a87d7f38bfe4e67b2fc79feb | w09-run-export/v2 | 23 |  | 56044b74 | run-00000000 | PARTIAL |  |  | 22 | 21894 |  |  |  | DEVICE_BOOT_UPTIME | NOT_EVIDENCED | UNKNOWN |  | DIAGNOSTIC_ONLY | 1 | CLOCK_SYNC_NOT_EVIDENCED|DEVICE_ID_NOT_CARRIED|RUN_ID_UNRESOLVED | NORMALIZED_ONLY | {} | {"applied_cooling":"OFF","applied_duty_permille":"0","chamber_air_mean_c":"29.937333","chamber_air_status":"ROLE_QUALIFIED_CHAMBER_AIR","cooling_current_a":"0.000000","cooling_energy_counter_wh":"108.000000","cooling_power_w":"0.000000","cooling_voltage_v":"11.950000","device_state":"OFF","door_polarity":"CONFIRMED","door_state":"CLOSED","experiment_phase":"OFF_IDLE","pressure_hpa":"1012.980000","quality.door":"UNKNOWN","quality.electrical":"UNKNOWN","quality.environment":"UNKNOWN","quality.overall":"UNKNOWN","quality.probe.t1":"OK","quality.probe.t2":"OK","quality.probe.t3":"OK","quality.probe.t4":"OK","quality.producer":"DEGRADED","quality.provenance":"VALID","quality.sequence":"VALID","quality.thermal":"VALID","readback_duty_permille":"0","requested_duty_permille":"0","rh_pct":"68.877000","seq":"22","t1_c":"30.000000","t2_c":"29.875000","t3_c":"29.750000","t4_c":"30.062000","t_air_c":"30.582000"}
f6235e23b4513f98:TELEMETRY_SAMPLE:NO_DEVICE_ID:56044b74:23:24:base | TELEMETRY_SAMPLE | PHYSICAL_MEASURED | evidence/A/W09/exports/CG-S1-H8C-600S.json | f6235e23b4513f98ba7c1deb289f4a3d48afd3c0a87d7f38bfe4e67b2fc79feb | w09-run-export/v2 | 24 |  | 56044b74 | run-00000000 | PARTIAL |  |  | 23 | 22894 |  |  |  | DEVICE_BOOT_UPTIME | NOT_EVIDENCED | UNKNOWN |  | DIAGNOSTIC_ONLY | 1 | CLOCK_SYNC_NOT_EVIDENCED|DEVICE_ID_NOT_CARRIED|RUN_ID_UNRESOLVED | NORMALIZED_ONLY | {} | {"applied_cooling":"OFF","applied_duty_permille":"0","chamber_air_mean_c":"29.916667","chamber_air_status":"ROLE_QUALIFIED_CHAMBER_AIR","cooling_current_a":"0.000000","cooling_energy_counter_wh":"108.000000","cooling_power_w":"0.000000","cooling_voltage_v":"11.950000","device_state":"OFF","door_polarity":"CONFIRMED","door_state":"CLOSED","experiment_phase":"OFF_IDLE","pressure_hpa":"1013.010000","quality.door":"UNKNOWN","quality.electrical":"UNKNOWN","quality.environment":"UNKNOWN","quality.overall":"UNKNOWN","quality.probe.t1":"OK","quality.probe.t2":"OK","quality.probe.t3":"OK","quality.probe.t4":"OK","quality.producer":"DEGRADED","quality.provenance":"VALID","quality.sequence":"VALID","quality.thermal":"VALID","readback_duty_permille":"0","requested_duty_permille":"0","rh_pct":"68.861000","seq":"23","t1_c":"30.000000","t2_c":"29.875000","t3_c":"29.688000","t4_c":"30.062000","t_air_c":"30.602000"}
f6235e23b4513f98:TELEMETRY_SAMPLE:NO_DEVICE_ID:56044b74:24:25:base | TELEMETRY_SAMPLE | PHYSICAL_MEASURED | evidence/A/W09/exports/CG-S1-H8C-600S.json | f6235e23b4513f98ba7c1deb289f4a3d48afd3c0a87d7f38bfe4e67b2fc79feb | w09-run-export/v2 | 25 |  | 56044b74 | run-00000000 | PARTIAL |  |  | 24 | 23894 |  |  |  | DEVICE_BOOT_UPTIME | NOT_EVIDENCED | UNKNOWN |  | DIAGNOSTIC_ONLY | 1 | CLOCK_SYNC_NOT_EVIDENCED|DEVICE_ID_NOT_CARRIED|RUN_ID_UNRESOLVED | NORMALIZED_ONLY | {} | {"applied_cooling":"OFF","applied_duty_permille":"0","chamber_air_mean_c":"29.937333","chamber_air_status":"ROLE_QUALIFIED_CHAMBER_AIR","cooling_current_a":"0.000000","cooling_energy_counter_wh":"108.000000","cooling_power_w":"0.000000","cooling_voltage_v":"11.950000","device_state":"OFF","door_polarity":"CONFIRMED","door_state":"CLOSED","experiment_phase":"OFF_IDLE","pressure_hpa":"1013.040000","quality.door":"UNKNOWN","quality.electrical":"UNKNOWN","quality.environment":"UNKNOWN","quality.overall":"UNKNOWN","quality.probe.t1":"OK","quality.probe.t2":"OK","quality.probe.t3":"OK","quality.probe.t4":"OK","quality.producer":"DEGRADED","quality.provenance":"VALID","quality.sequence":"VALID","quality.thermal":"VALID","readback_duty_permille":"0","requested_duty_permille":"0","rh_pct":"68.878000","seq":"24","t1_c":"30.062000","t2_c":"29.938000","t3_c":"29.688000","t4_c":"30.062000","t_air_c":"30.602000"}
f6235e23b4513f98:TELEMETRY_SAMPLE:NO_DEVICE_ID:56044b74:25:26:base | TELEMETRY_SAMPLE | PHYSICAL_MEASURED | evidence/A/W09/exports/CG-S1-H8C-600S.json | f6235e23b4513f98ba7c1deb289f4a3d48afd3c0a87d7f38bfe4e67b2fc79feb | w09-run-export/v2 | 26 |  | 56044b74 | run-00000000 | PARTIAL |  |  | 25 | 24894 |  |  |  | DEVICE_BOOT_UPTIME | NOT_EVIDENCED | UNKNOWN |  | DIAGNOSTIC_ONLY | 1 | CLOCK_SYNC_NOT_EVIDENCED|DEVICE_ID_NOT_CARRIED|RUN_ID_UNRESOLVED | NORMALIZED_ONLY | {} | {"applied_cooling":"OFF","applied_duty_permille":"0","chamber_air_mean_c":"29.916667","chamber_air_status":"ROLE_QUALIFIED_CHAMBER_AIR","cooling_current_a":"0.000000","cooling_energy_counter_wh":"108.000000","cooling_power_w":"0.000000","cooling_voltage_v":"11.950000","device_state":"OFF","door_polarity":"CONFIRMED","door_state":"CLOSED","experiment_phase":"OFF_IDLE","pressure_hpa":"1013.040000","quality.door":"UNKNOWN","quality.electrical":"UNKNOWN","quality.environment":"UNKNOWN","quality.overall":"UNKNOWN","quality.probe.t1":"OK","quality.probe.t2":"OK","quality.probe.t3":"OK","quality.probe.t4":"OK","quality.producer":"DEGRADED","quality.provenance":"VALID","quality.sequence":"VALID","quality.thermal":"VALID","readback_duty_permille":"0","requested_duty_permille":"0","rh_pct":"68.872000","seq":"25","t1_c":"30.000000","t2_c":"29.875000","t3_c":"29.688000","t4_c":"30.062000","t_air_c":"30.602000"}
f6235e23b4513f98:TELEMETRY_SAMPLE:NO_DEVICE_ID:56044b74:26:27:base | TELEMETRY_SAMPLE | PHYSICAL_MEASURED | evidence/A/W09/exports/CG-S1-H8C-600S.json | f6235e23b4513f98ba7c1deb289f4a3d48afd3c0a87d7f38bfe4e67b2fc79feb | w09-run-export/v2 | 27 |  | 56044b74 | run-00000000 | PARTIAL |  |  | 26 | 25894 |  |  |  | DEVICE_BOOT_UPTIME | NOT_EVIDENCED | UNKNOWN |  | DIAGNOSTIC_ONLY | 1 | CLOCK_SYNC_NOT_EVIDENCED|DEVICE_ID_NOT_CARRIED|RUN_ID_UNRESOLVED | NORMALIZED_ONLY | {} | {"applied_cooling":"OFF","applied_duty_permille":"0","chamber_air_mean_c":"29.937333","chamber_air_status":"ROLE_QUALIFIED_CHAMBER_AIR","cooling_current_a":"0.000000","cooling_energy_counter_wh":"108.000000","cooling_power_w":"0.000000","cooling_voltage_v":"11.950000","device_state":"OFF","door_polarity":"CONFIRMED","door_state":"CLOSED","experiment_phase":"OFF_IDLE","pressure_hpa":"1013.000000","quality.door":"UNKNOWN","quality.electrical":"UNKNOWN","quality.environment":"UNKNOWN","quality.overall":"UNKNOWN","quality.probe.t1":"OK","quality.probe.t2":"OK","quality.probe.t3":"OK","quality.probe.t4":"OK","quality.producer":"DEGRADED","quality.provenance":"VALID","quality.sequence":"VALID","quality.thermal":"VALID","readback_duty_permille":"0","requested_duty_permille":"0","rh_pct":"68.844000","seq":"26","t1_c":"30.000000","t2_c":"29.875000","t3_c":"29.750000","t4_c":"30.062000","t_air_c":"30.597000"}
f6235e23b4513f98:TELEMETRY_SAMPLE:NO_DEVICE_ID:56044b74:27:28:base | TELEMETRY_SAMPLE | PHYSICAL_MEASURED | evidence/A/W09/exports/CG-S1-H8C-600S.json | f6235e23b4513f98ba7c1deb289f4a3d48afd3c0a87d7f38bfe4e67b2fc79feb | w09-run-export/v2 | 28 |  | 56044b74 | run-00000000 | PARTIAL |  |  | 27 | 26894 |  |  |  | DEVICE_BOOT_UPTIME | NOT_EVIDENCED | UNKNOWN |  | DIAGNOSTIC_ONLY | 1 | CLOCK_SYNC_NOT_EVIDENCED|DEVICE_ID_NOT_CARRIED|RUN_ID_UNRESOLVED | NORMALIZED_ONLY | {} | {"applied_cooling":"OFF","applied_duty_permille":"0","chamber_air_mean_c":"29.937333","chamber_air_status":"ROLE_QUALIFIED_CHAMBER_AIR","cooling_current_a":"0.000000","cooling_energy_counter_wh":"108.000000","cooling_power_w":"0.000000","cooling_voltage_v":"11.950000","device_state":"OFF","door_polarity":"CONFIRMED","door_state":"CLOSED","experiment_phase":"OFF_IDLE","pressure_hpa":"1013.000000","quality.door":"UNKNOWN","quality.electrical":"UNKNOWN","quality.environment":"UNKNOWN","quality.overall":"UNKNOWN","quality.probe.t1":"OK","quality.probe.t2":"OK","quality.probe.t3":"OK","quality.probe.t4":"OK","quality.producer":"DEGRADED","quality.provenance":"VALID","quality.sequence":"VALID","quality.thermal":"VALID","readback_duty_permille":"0","requested_duty_permille":"0","rh_pct":"68.867000","seq":"27","t1_c":"30.000000","t2_c":"29.875000","t3_c":"29.750000","t4_c":"30.062000","t_air_c":"30.597000"}
f6235e23b4513f98:TELEMETRY_SAMPLE:NO_DEVICE_ID:56044b74:28:29:base | TELEMETRY_SAMPLE | PHYSICAL_MEASURED | evidence/A/W09/exports/CG-S1-H8C-600S.json | f6235e23b4513f98ba7c1deb289f4a3d48afd3c0a87d7f38bfe4e67b2fc79feb | w09-run-export/v2 | 29 |  | 56044b74 | run-00000000 | PARTIAL |  |  | 28 | 27894 |  |  |  | DEVICE_BOOT_UPTIME | NOT_EVIDENCED | UNKNOWN |  | DIAGNOSTIC_ONLY | 1 | CLOCK_SYNC_NOT_EVIDENCED|DEVICE_ID_NOT_CARRIED|RUN_ID_UNRESOLVED | NORMALIZED_ONLY | {} | {"applied_cooling":"OFF","applied_duty_permille":"0","chamber_air_mean_c":"29.916667","chamber_air_status":"ROLE_QUALIFIED_CHAMBER_AIR","cooling_current_a":"0.000000","cooling_energy_counter_wh":"108.000000","cooling_power_w":"0.000000","cooling_voltage_v":"11.950000","device_state":"OFF","door_polarity":"CONFIRMED","door_state":"CLOSED","experiment_phase":"OFF_IDLE","pressure_hpa":"1013.060000","quality.door":"UNKNOWN","quality.electrical":"UNKNOWN","quality.environment":"UNKNOWN","quality.overall":"UNKNOWN","quality.probe.t1":"OK","quality.probe.t2":"OK","quality.probe.t3":"OK","quality.probe.t4":"OK","quality.producer":"DEGRADED","quality.provenance":"VALID","quality.sequence":"VALID","quality.thermal":"VALID","readback_duty_permille":"0","requested_duty_permille":"0","rh_pct":"68.872000","seq":"28","t1_c":"30.000000","t2_c":"29.875000","t3_c":"29.688000","t4_c":"30.062000","t_air_c":"30.597000"}
f6235e23b4513f98:TELEMETRY_SAMPLE:NO_DEVICE_ID:56044b74:29:30:base | TELEMETRY_SAMPLE | PHYSICAL_MEASURED | evidence/A/W09/exports/CG-S1-H8C-600S.json | f6235e23b4513f98ba7c1deb289f4a3d48afd3c0a87d7f38bfe4e67b2fc79feb | w09-run-export/v2 | 30 |  | 56044b74 | run-00000000 | PARTIAL |  |  | 29 | 28894 |  |  |  | DEVICE_BOOT_UPTIME | NOT_EVIDENCED | UNKNOWN |  | DIAGNOSTIC_ONLY | 1 | CLOCK_SYNC_NOT_EVIDENCED|DEVICE_ID_NOT_CARRIED|RUN_ID_UNRESOLVED | NORMALIZED_ONLY | {} | {"applied_cooling":"OFF","applied_duty_permille":"0","chamber_air_mean_c":"29.937333","chamber_air_status":"ROLE_QUALIFIED_CHAMBER_AIR","cooling_current_a":"0.000000","cooling_energy_counter_wh":"108.000000","cooling_power_w":"0.000000","cooling_voltage_v":"11.950000","device_state":"OFF","door_polarity":"CONFIRMED","door_state":"CLOSED","experiment_phase":"OFF_IDLE","pressure_hpa":"1013.040000","quality.door":"UNKNOWN","quality.electrical":"UNKNOWN","quality.environment":"UNKNOWN","quality.overall":"UNKNOWN","quality.probe.t1":"OK","quality.probe.t2":"OK","quality.probe.t3":"OK","quality.probe.t4":"OK","quality.producer":"DEGRADED","quality.provenance":"VALID","quality.sequence":"VALID","quality.thermal":"VALID","readback_duty_permille":"0","requested_duty_permille":"0","rh_pct":"68.856000","seq":"29","t1_c":"30.000000","t2_c":"29.875000","t3_c":"29.750000","t4_c":"30.062000","t_air_c":"30.602000"}
f6235e23b4513f98:TELEMETRY_SAMPLE:NO_DEVICE_ID:56044b74:30:31:base | TELEMETRY_SAMPLE | PHYSICAL_MEASURED | evidence/A/W09/exports/CG-S1-H8C-600S.json | f6235e23b4513f98ba7c1deb289f4a3d48afd3c0a87d7f38bfe4e67b2fc79feb | w09-run-export/v2 | 31 |  | 56044b74 | run-00000000 | PARTIAL |  |  | 30 | 29894 |  |  |  | DEVICE_BOOT_UPTIME | NOT_EVIDENCED | UNKNOWN |  | DIAGNOSTIC_ONLY | 1 | CLOCK_SYNC_NOT_EVIDENCED|DEVICE_ID_NOT_CARRIED|RUN_ID_UNRESOLVED | NORMALIZED_ONLY | {} | {"applied_cooling":"OFF","applied_duty_permille":"0","chamber_air_mean_c":"29.916667","chamber_air_status":"ROLE_QUALIFIED_CHAMBER_AIR","cooling_current_a":"0.000000","cooling_energy_counter_wh":"108.000000","cooling_power_w":"0.000000","cooling_voltage_v":"11.950000","device_state":"OFF","door_polarity":"CONFIRMED","door_state":"CLOSED","experiment_phase":"OFF_IDLE","pressure_hpa":"1012.970000","quality.door":"UNKNOWN","quality.electrical":"UNKNOWN","quality.environment":"UNKNOWN","quality.overall":"UNKNOWN","quality.probe.t1":"OK","quality.probe.t2":"OK","quality.probe.t3":"OK","quality.probe.t4":"OK","quality.producer":"DEGRADED","quality.provenance":"VALID","quality.sequence":"VALID","quality.thermal":"VALID","readback_duty_permille":"0","requested_duty_permille":"0","rh_pct":"68.861000","seq":"30","t1_c":"30.000000","t2_c":"29.875000","t3_c":"29.688000","t4_c":"30.062000","t_air_c":"30.597000"}
f6235e23b4513f98:TELEMETRY_SAMPLE:NO_DEVICE_ID:56044b74:31:32:base | TELEMETRY_SAMPLE | PHYSICAL_MEASURED | evidence/A/W09/exports/CG-S1-H8C-600S.json | f6235e23b4513f98ba7c1deb289f4a3d48afd3c0a87d7f38bfe4e67b2fc79feb | w09-run-export/v2 | 32 |  | 56044b74 | run-00000000 | PARTIAL |  |  | 31 | 30894 |  |  |  | DEVICE_BOOT_UPTIME | NOT_EVIDENCED | UNKNOWN |  | DIAGNOSTIC_ONLY | 1 | CLOCK_SYNC_NOT_EVIDENCED|DEVICE_ID_NOT_CARRIED|RUN_ID_UNRESOLVED | NORMALIZED_ONLY | {} | {"applied_cooling":"OFF","applied_duty_permille":"0","chamber_air_mean_c":"29.916667","chamber_air_status":"ROLE_QUALIFIED_CHAMBER_AIR","cooling_current_a":"0.000000","cooling_energy_counter_wh":"108.000000","cooling_power_w":"0.000000","cooling_voltage_v":"11.950000","device_state":"OFF","door_polarity":"CONFIRMED","door_state":"CLOSED","experiment_phase":"OFF_IDLE","pressure_hpa":"1013.010000","quality.door":"UNKNOWN","quality.electrical":"UNKNOWN","quality.environment":"UNKNOWN","quality.overall":"UNKNOWN","quality.probe.t1":"OK","quality.probe.t2":"OK","quality.probe.t3":"OK","quality.probe.t4":"OK","quality.producer":"DEGRADED","quality.provenance":"VALID","quality.sequence":"VALID","quality.thermal":"VALID","readback_duty_permille":"0","requested_duty_permille":"0","rh_pct":"68.861000","seq":"31","t1_c":"30.000000","t2_c":"29.875000","t3_c":"29.688000","t4_c":"30.062000","t_air_c":"30.602000"}
f6235e23b4513f98:TELEMETRY_SAMPLE:NO_DEVICE_ID:56044b74:32:33:base | TELEMETRY_SAMPLE | PHYSICAL_MEASURED | evidence/A/W09/exports/CG-S1-H8C-600S.json | f6235e23b4513f98ba7c1deb289f4a3d48afd3c0a87d7f38bfe4e67b2fc79feb | w09-run-export/v2 | 33 |  | 56044b74 | run-00000000 | PARTIAL |  |  | 32 | 31894 |  |  |  | DEVICE_BOOT_UPTIME | NOT_EVIDENCED | UNKNOWN |  | DIAGNOSTIC_ONLY | 1 | CLOCK_SYNC_NOT_EVIDENCED|DEVICE_ID_NOT_CARRIED|RUN_ID_UNRESOLVED | NORMALIZED_ONLY | {} | {"applied_cooling":"OFF","applied_duty_permille":"0","chamber_air_mean_c":"29.916667","chamber_air_status":"ROLE_QUALIFIED_CHAMBER_AIR","cooling_current_a":"0.000000","cooling_energy_counter_wh":"108.000000","cooling_power_w":"0.000000","cooling_voltage_v":"11.950000","device_state":"OFF","door_polarity":"CONFIRMED","door_state":"CLOSED","experiment_phase":"OFF_IDLE","pressure_hpa":"1013.040000","quality.door":"UNKNOWN","quality.electrical":"UNKNOWN","quality.environment":"UNKNOWN","quality.overall":"UNKNOWN","quality.probe.t1":"OK","quality.probe.t2":"OK","quality.probe.t3":"OK","quality.probe.t4":"OK","quality.producer":"DEGRADED","quality.provenance":"VALID","quality.sequence":"VALID","quality.thermal":"VALID","readback_duty_permille":"0","requested_duty_permille":"0","rh_pct":"68.845000","seq":"32","t1_c":"30.000000","t2_c":"29.875000","t3_c":"29.688000","t4_c":"30.062000","t_air_c":"30.602000"}
f6235e23b4513f98:TELEMETRY_SAMPLE:NO_DEVICE_ID:56044b74:33:34:base | TELEMETRY_SAMPLE | PHYSICAL_MEASURED | evidence/A/W09/exports/CG-S1-H8C-600S.json | f6235e23b4513f98ba7c1deb289f4a3d48afd3c0a87d7f38bfe4e67b2fc79feb | w09-run-export/v2 | 34 |  | 56044b74 | run-00000000 | PARTIAL |  |  | 33 | 32894 |  |  |  | DEVICE_BOOT_UPTIME | NOT_EVIDENCED | UNKNOWN |  | DIAGNOSTIC_ONLY | 1 | CLOCK_SYNC_NOT_EVIDENCED|DEVICE_ID_NOT_CARRIED|RUN_ID_UNRESOLVED | NORMALIZED_ONLY | {} | {"applied_cooling":"OFF","applied_duty_permille":"0","chamber_air_mean_c":"29.937333","chamber_air_status":"ROLE_QUALIFIED_CHAMBER_AIR","cooling_current_a":"0.000000","cooling_energy_counter_wh":"108.000000","cooling_power_w":"0.000000","cooling_voltage_v":"11.950000","device_state":"OFF","door_polarity":"CONFIRMED","door_state":"CLOSED","experiment_phase":"OFF_IDLE","pressure_hpa":"1012.960000","quality.door":"UNKNOWN","quality.electrical":"UNKNOWN","quality.environment":"UNKNOWN","quality.overall":"UNKNOWN","quality.probe.t1":"OK","quality.probe.t2":"OK","quality.probe.t3":"OK","quality.probe.t4":"OK","quality.producer":"DEGRADED","quality.provenance":"VALID","quality.sequence":"VALID","quality.thermal":"VALID","readback_duty_permille":"0","requested_duty_permille":"0","rh_pct":"68.850000","seq":"33","t1_c":"30.000000","t2_c":"29.875000","t3_c":"29.750000","t4_c":"30.062000","t_air_c":"30.607000"}
f6235e23b4513f98:TELEMETRY_SAMPLE:NO_DEVICE_ID:56044b74:34:35:base | TELEMETRY_SAMPLE | PHYSICAL_MEASURED | evidence/A/W09/exports/CG-S1-H8C-600S.json | f6235e23b4513f98ba7c1deb289f4a3d48afd3c0a87d7f38bfe4e67b2fc79feb | w09-run-export/v2 | 35 |  | 56044b74 | run-00000000 | PARTIAL |  |  | 34 | 33894 |  |  |  | DEVICE_BOOT_UPTIME | NOT_EVIDENCED | UNKNOWN |  | DIAGNOSTIC_ONLY | 1 | CLOCK_SYNC_NOT_EVIDENCED|DEVICE_ID_NOT_CARRIED|RUN_ID_UNRESOLVED | NORMALIZED_ONLY | {} | {"applied_cooling":"OFF","applied_duty_permille":"0","chamber_air_mean_c":"29.916667","chamber_air_status":"ROLE_QUALIFIED_CHAMBER_AIR","cooling_current_a":"0.000000","cooling_energy_counter_wh":"108.000000","cooling_power_w":"0.000000","cooling_voltage_v":"11.950000","device_state":"OFF","door_polarity":"CONFIRMED","door_state":"CLOSED","experiment_phase":"OFF_IDLE","pressure_hpa":"1013.000000","quality.door":"UNKNOWN","quality.electrical":"UNKNOWN","quality.environment":"UNKNOWN","quality.overall":"UNKNOWN","quality.probe.t1":"OK","quality.probe.t2":"OK","quality.probe.t3":"OK","quality.probe.t4":"OK","quality.producer":"DEGRADED","quality.provenance":"VALID","quality.sequence":"VALID","quality.thermal":"VALID","readback_duty_permille":"0","requested_duty_permille":"0","rh_pct":"68.827000","seq":"34","t1_c":"30.000000","t2_c":"29.875000","t3_c":"29.688000","t4_c":"30.062000","t_air_c":"30.597000"}
f6235e23b4513f98:TELEMETRY_SAMPLE:NO_DEVICE_ID:56044b74:35:36:base | TELEMETRY_SAMPLE | PHYSICAL_MEASURED | evidence/A/W09/exports/CG-S1-H8C-600S.json | f6235e23b4513f98ba7c1deb289f4a3d48afd3c0a87d7f38bfe4e67b2fc79feb | w09-run-export/v2 | 36 |  | 56044b74 | run-00000000 | PARTIAL |  |  | 35 | 34894 |  |  |  | DEVICE_BOOT_UPTIME | NOT_EVIDENCED | UNKNOWN |  | DIAGNOSTIC_ONLY | 1 | CLOCK_SYNC_NOT_EVIDENCED|DEVICE_ID_NOT_CARRIED|RUN_ID_UNRESOLVED | NORMALIZED_ONLY | {} | {"applied_cooling":"OFF","applied_duty_permille":"0","chamber_air_mean_c":"29.916667","chamber_air_status":"ROLE_QUALIFIED_CHAMBER_AIR","cooling_current_a":"0.000000","cooling_energy_counter_wh":"108.000000","cooling_power_w":"0.000000","cooling_voltage_v":"11.950000","device_state":"OFF","door_polarity":"CONFIRMED","door_state":"CLOSED","experiment_phase":"OFF_IDLE","pressure_hpa":"1012.970000","quality.door":"UNKNOWN","quality.electrical":"UNKNOWN","quality.environment":"UNKNOWN","quality.overall":"UNKNOWN","quality.probe.t1":"OK","quality.probe.t2":"OK","quality.probe.t3":"OK","quality.probe.t4":"OK","quality.producer":"DEGRADED","quality.provenance":"VALID","quality.sequence":"VALID","quality.thermal":"VALID","readback_duty_permille":"0","requested_duty_permille":"0","rh_pct":"68.839000","seq":"35","t1_c":"30.000000","t2_c":"29.875000","t3_c":"29.688000","t4_c":"30.062000","t_air_c":"30.597000"}
f6235e23b4513f98:TELEMETRY_SAMPLE:NO_DEVICE_ID:56044b74:36:37:base | TELEMETRY_SAMPLE | PHYSICAL_MEASURED | evidence/A/W09/exports/CG-S1-H8C-600S.json | f6235e23b4513f98ba7c1deb289f4a3d48afd3c0a87d7f38bfe4e67b2fc79feb | w09-run-export/v2 | 37 |  | 56044b74 | run-00000000 | PARTIAL |  |  | 36 | 35894 |  |  |  | DEVICE_BOOT_UPTIME | NOT_EVIDENCED | UNKNOWN |  | DIAGNOSTIC_ONLY | 1 | CLOCK_SYNC_NOT_EVIDENCED|DEVICE_ID_NOT_CARRIED|RUN_ID_UNRESOLVED | NORMALIZED_ONLY | {} | {"applied_cooling":"OFF","applied_duty_permille":"0","chamber_air_mean_c":"29.916667","chamber_air_status":"ROLE_QUALIFIED_CHAMBER_AIR","cooling_current_a":"0.000000","cooling_energy_counter_wh":"108.000000","cooling_power_w":"0.000000","cooling_voltage_v":"11.950000","device_state":"OFF","door_polarity":"CONFIRMED","door_state":"CLOSED","experiment_phase":"OFF_IDLE","pressure_hpa":"1013.010000","quality.door":"UNKNOWN","quality.electrical":"UNKNOWN","quality.environment":"UNKNOWN","quality.overall":"UNKNOWN","quality.probe.t1":"OK","quality.probe.t2":"OK","quality.probe.t3":"OK","quality.probe.t4":"OK","quality.producer":"DEGRADED","quality.provenance":"VALID","quality.sequence":"VALID","quality.thermal":"VALID","readback_duty_permille":"0","requested_duty_permille":"0","rh_pct":"68.850000","seq":"36","t1_c":"30.000000","t2_c":"29.875000","t3_c":"29.688000","t4_c":"30.062000","t_air_c":"30.602000"}
f6235e23b4513f98:TELEMETRY_SAMPLE:NO_DEVICE_ID:56044b74:37:38:base | TELEMETRY_SAMPLE | PHYSICAL_MEASURED | evidence/A/W09/exports/CG-S1-H8C-600S.json | f6235e23b4513f98ba7c1deb289f4a3d48afd3c0a87d7f38bfe4e67b2fc79feb | w09-run-export/v2 | 38 |  | 56044b74 | run-00000000 | PARTIAL |  |  | 37 | 36894 |  |  |  | DEVICE_BOOT_UPTIME | NOT_EVIDENCED | UNKNOWN |  | DIAGNOSTIC_ONLY | 1 | CLOCK_SYNC_NOT_EVIDENCED|DEVICE_ID_NOT_CARRIED|RUN_ID_UNRESOLVED | NORMALIZED_ONLY | {} | {"applied_cooling":"OFF","applied_duty_permille":"0","chamber_air_mean_c":"29.937333","chamber_air_status":"ROLE_QUALIFIED_CHAMBER_AIR","cooling_current_a":"0.000000","cooling_energy_counter_wh":"108.000000","cooling_power_w":"0.000000","cooling_voltage_v":"11.950000","device_state":"OFF","door_polarity":"CONFIRMED","door_state":"CLOSED","experiment_phase":"OFF_IDLE","pressure_hpa":"1012.950000","quality.door":"UNKNOWN","quality.electrical":"UNKNOWN","quality.environment":"UNKNOWN","quality.overall":"UNKNOWN","quality.probe.t1":"OK","quality.probe.t2":"OK","quality.probe.t3":"OK","quality.probe.t4":"OK","quality.producer":"DEGRADED","quality.provenance":"VALID","quality.sequence":"VALID","quality.thermal":"VALID","readback_duty_permille":"0","requested_duty_permille":"0","rh_pct":"68.856000","seq":"37","t1_c":"30.062000","t2_c":"29.875000","t3_c":"29.688000","t4_c":"30.062000","t_air_c":"30.602000"}
f6235e23b4513f98:TELEMETRY_SAMPLE:NO_DEVICE_ID:56044b74:38:39:base | TELEMETRY_SAMPLE | PHYSICAL_MEASURED | evidence/A/W09/exports/CG-S1-H8C-600S.json | f6235e23b4513f98ba7c1deb289f4a3d48afd3c0a87d7f38bfe4e67b2fc79feb | w09-run-export/v2 | 39 |  | 56044b74 | run-00000000 | PARTIAL |  |  | 38 | 37894 |  |  |  | DEVICE_BOOT_UPTIME | NOT_EVIDENCED | UNKNOWN |  | DIAGNOSTIC_ONLY | 1 | CLOCK_SYNC_NOT_EVIDENCED|DEVICE_ID_NOT_CARRIED|RUN_ID_UNRESOLVED | NORMALIZED_ONLY | {} | {"applied_cooling":"OFF","applied_duty_permille":"0","chamber_air_mean_c":"29.937333","chamber_air_status":"ROLE_QUALIFIED_CHAMBER_AIR","cooling_current_a":"0.000000","cooling_energy_counter_wh":"108.000000","cooling_power_w":"0.000000","cooling_voltage_v":"11.950000","device_state":"OFF","door_polarity":"CONFIRMED","door_state":"CLOSED","experiment_phase":"OFF_IDLE","pressure_hpa":"1012.990000","quality.door":"UNKNOWN","quality.electrical":"UNKNOWN","quality.environment":"UNKNOWN","quality.overall":"UNKNOWN","quality.probe.t1":"OK","quality.probe.t2":"OK","quality.probe.t3":"OK","quality.probe.t4":"OK","quality.producer":"DEGRADED","quality.provenance":"VALID","quality.sequence":"VALID","quality.thermal":"VALID","readback_duty_permille":"0","requested_duty_permille":"0","rh_pct":"68.845000","seq":"38","t1_c":"30.062000","t2_c":"29.875000","t3_c":"29.688000","t4_c":"30.062000","t_air_c":"30.613000"}
f6235e23b4513f98:TELEMETRY_SAMPLE:NO_DEVICE_ID:56044b74:39:40:base | TELEMETRY_SAMPLE | PHYSICAL_MEASURED | evidence/A/W09/exports/CG-S1-H8C-600S.json | f6235e23b4513f98ba7c1deb289f4a3d48afd3c0a87d7f38bfe4e67b2fc79feb | w09-run-export/v2 | 40 |  | 56044b74 | run-00000000 | PARTIAL |  |  | 39 | 38894 |  |  |  | DEVICE_BOOT_UPTIME | NOT_EVIDENCED | UNKNOWN |  | DIAGNOSTIC_ONLY | 1 | CLOCK_SYNC_NOT_EVIDENCED|DEVICE_ID_NOT_CARRIED|RUN_ID_UNRESOLVED | NORMALIZED_ONLY | {} | {"applied_cooling":"OFF","applied_duty_permille":"0","chamber_air_mean_c":"29.937333","chamber_air_status":"ROLE_QUALIFIED_CHAMBER_AIR","cooling_current_a":"0.000000","cooling_energy_counter_wh":"108.000000","cooling_power_w":"0.000000","cooling_voltage_v":"11.950000","device_state":"OFF","door_polarity":"CONFIRMED","door_state":"CLOSED","experiment_phase":"OFF_IDLE","pressure_hpa":"1012.950000","quality.door":"UNKNOWN","quality.electrical":"UNKNOWN","quality.environment":"UNKNOWN","quality.overall":"UNKNOWN","quality.probe.t1":"OK","quality.probe.t2":"OK","quality.probe.t3":"OK","quality.probe.t4":"OK","quality.producer":"DEGRADED","quality.provenance":"VALID","quality.sequence":"VALID","quality.thermal":"VALID","readback_duty_permille":"0","requested_duty_permille":"0","rh_pct":"68.839000","seq":"39","t1_c":"30.062000","t2_c":"29.875000","t3_c":"29.688000","t4_c":"30.062000","t_air_c":"30.602000"}
f6235e23b4513f98:TELEMETRY_SAMPLE:NO_DEVICE_ID:56044b74:40:41:base | TELEMETRY_SAMPLE | PHYSICAL_MEASURED | evidence/A/W09/exports/CG-S1-H8C-600S.json | f6235e23b4513f98ba7c1deb289f4a3d48afd3c0a87d7f38bfe4e67b2fc79feb | w09-run-export/v2 | 41 |  | 56044b74 | run-00000000 | PARTIAL |  |  | 40 | 39894 |  |  |  | DEVICE_BOOT_UPTIME | NOT_EVIDENCED | UNKNOWN |  | DIAGNOSTIC_ONLY | 1 | CLOCK_SYNC_NOT_EVIDENCED|DEVICE_ID_NOT_CARRIED|RUN_ID_UNRESOLVED | NORMALIZED_ONLY | {} | {"applied_cooling":"OFF","applied_duty_permille":"0","chamber_air_mean_c":"29.916667","chamber_air_status":"ROLE_QUALIFIED_CHAMBER_AIR","cooling_current_a":"0.000000","cooling_energy_counter_wh":"108.000000","cooling_power_w":"0.000000","cooling_voltage_v":"11.950000","device_state":"OFF","door_polarity":"CONFIRMED","door_state":"CLOSED","experiment_phase":"OFF_IDLE","pressure_hpa":"1013.040000","quality.door":"UNKNOWN","quality.electrical":"UNKNOWN","quality.environment":"UNKNOWN","quality.overall":"UNKNOWN","quality.probe.t1":"OK","quality.probe.t2":"OK","quality.probe.t3":"OK","quality.probe.t4":"OK","quality.producer":"DEGRADED","quality.provenance":"VALID","quality.sequence":"VALID","quality.thermal":"VALID","readback_duty_permille":"0","requested_duty_permille":"0","rh_pct":"68.850000","seq":"40","t1_c":"30.000000","t2_c":"29.875000","t3_c":"29.688000","t4_c":"30.062000","t_air_c":"30.602000"}
f6235e23b4513f98:TELEMETRY_SAMPLE:NO_DEVICE_ID:56044b74:41:42:base | TELEMETRY_SAMPLE | PHYSICAL_MEASURED | evidence/A/W09/exports/CG-S1-H8C-600S.json | f6235e23b4513f98ba7c1deb289f4a3d48afd3c0a87d7f38bfe4e67b2fc79feb | w09-run-export/v2 | 42 |  | 56044b74 | run-00000000 | PARTIAL |  |  | 41 | 40894 |  |  |  | DEVICE_BOOT_UPTIME | NOT_EVIDENCED | UNKNOWN |  | DIAGNOSTIC_ONLY | 1 | CLOCK_SYNC_NOT_EVIDENCED|DEVICE_ID_NOT_CARRIED|RUN_ID_UNRESOLVED | NORMALIZED_ONLY | {} | {"applied_cooling":"OFF","applied_duty_permille":"0","chamber_air_mean_c":"29.937333","chamber_air_status":"ROLE_QUALIFIED_CHAMBER_AIR","cooling_current_a":"0.000000","cooling_energy_counter_wh":"108.000000","cooling_power_w":"0.000000","cooling_voltage_v":"11.950000","device_state":"OFF","door_polarity":"CONFIRMED","door_state":"CLOSED","experiment_phase":"OFF_IDLE","pressure_hpa":"1012.930000","quality.door":"UNKNOWN","quality.electrical":"UNKNOWN","quality.environment":"UNKNOWN","quality.overall":"UNKNOWN","quality.probe.t1":"OK","quality.probe.t2":"OK","quality.probe.t3":"OK","quality.probe.t4":"OK","quality.producer":"DEGRADED","quality.provenance":"VALID","quality.sequence":"VALID","quality.thermal":"VALID","readback_duty_permille":"0","requested_duty_permille":"0","rh_pct":"68.856000","seq":"41","t1_c":"30.062000","t2_c":"29.875000","t3_c":"29.688000","t4_c":"30.062000","t_air_c":"30.607000"}
f6235e23b4513f98:TELEMETRY_SAMPLE:NO_DEVICE_ID:56044b74:42:43:base | TELEMETRY_SAMPLE | PHYSICAL_MEASURED | evidence/A/W09/exports/CG-S1-H8C-600S.json | f6235e23b4513f98ba7c1deb289f4a3d48afd3c0a87d7f38bfe4e67b2fc79feb | w09-run-export/v2 | 43 |  | 56044b74 | run-00000000 | PARTIAL |  |  | 42 | 41894 |  |  |  | DEVICE_BOOT_UPTIME | NOT_EVIDENCED | UNKNOWN |  | DIAGNOSTIC_ONLY | 1 | CLOCK_SYNC_NOT_EVIDENCED|DEVICE_ID_NOT_CARRIED|RUN_ID_UNRESOLVED | NORMALIZED_ONLY | {} | {"applied_cooling":"OFF","applied_duty_permille":"0","chamber_air_mean_c":"29.916667","chamber_air_status":"ROLE_QUALIFIED_CHAMBER_AIR","cooling_current_a":"0.000000","cooling_energy_counter_wh":"108.000000","cooling_power_w":"0.000000","cooling_voltage_v":"11.950000","device_state":"OFF","door_polarity":"CONFIRMED","door_state":"CLOSED","experiment_phase":"OFF_IDLE","pressure_hpa":"1012.950000","quality.door":"UNKNOWN","quality.electrical":"UNKNOWN","quality.environment":"UNKNOWN","quality.overall":"UNKNOWN","quality.probe.t1":"OK","quality.probe.t2":"OK","quality.probe.t3":"OK","quality.probe.t4":"OK","quality.producer":"DEGRADED","quality.provenance":"VALID","quality.sequence":"VALID","quality.thermal":"VALID","readback_duty_permille":"0","requested_duty_permille":"0","rh_pct":"68.839000","seq":"42","t1_c":"30.000000","t2_c":"29.875000","t3_c":"29.688000","t4_c":"30.062000","t_air_c":"30.602000"}
f6235e23b4513f98:TELEMETRY_SAMPLE:NO_DEVICE_ID:56044b74:43:44:base | TELEMETRY_SAMPLE | PHYSICAL_MEASURED | evidence/A/W09/exports/CG-S1-H8C-600S.json | f6235e23b4513f98ba7c1deb289f4a3d48afd3c0a87d7f38bfe4e67b2fc79feb | w09-run-export/v2 | 44 |  | 56044b74 | run-00000000 | PARTIAL |  |  | 43 | 42894 |  |  |  | DEVICE_BOOT_UPTIME | NOT_EVIDENCED | UNKNOWN |  | DIAGNOSTIC_ONLY | 1 | CLOCK_SYNC_NOT_EVIDENCED|DEVICE_ID_NOT_CARRIED|RUN_ID_UNRESOLVED | NORMALIZED_ONLY | {} | {"applied_cooling":"OFF","applied_duty_permille":"0","chamber_air_mean_c":"29.916667","chamber_air_status":"ROLE_QUALIFIED_CHAMBER_AIR","cooling_current_a":"0.000000","cooling_energy_counter_wh":"108.000000","cooling_power_w":"0.000000","cooling_voltage_v":"11.950000","device_state":"OFF","door_polarity":"CONFIRMED","door_state":"CLOSED","experiment_phase":"OFF_IDLE","pressure_hpa":"1012.990000","quality.door":"UNKNOWN","quality.electrical":"UNKNOWN","quality.environment":"UNKNOWN","quality.overall":"UNKNOWN","quality.probe.t1":"OK","quality.probe.t2":"OK","quality.probe.t3":"OK","quality.probe.t4":"OK","quality.producer":"DEGRADED","quality.provenance":"VALID","quality.sequence":"VALID","quality.thermal":"VALID","readback_duty_permille":"0","requested_duty_permille":"0","rh_pct":"68.834000","seq":"43","t1_c":"30.000000","t2_c":"29.875000","t3_c":"29.688000","t4_c":"30.062000","t_air_c":"30.607000"}
f6235e23b4513f98:TELEMETRY_SAMPLE:NO_DEVICE_ID:56044b74:44:45:base | TELEMETRY_SAMPLE | PHYSICAL_MEASURED | evidence/A/W09/exports/CG-S1-H8C-600S.json | f6235e23b4513f98ba7c1deb289f4a3d48afd3c0a87d7f38bfe4e67b2fc79feb | w09-run-export/v2 | 45 |  | 56044b74 | run-00000000 | PARTIAL |  |  | 44 | 43894 |  |  |  | DEVICE_BOOT_UPTIME | NOT_EVIDENCED | UNKNOWN |  | DIAGNOSTIC_ONLY | 1 | CLOCK_SYNC_NOT_EVIDENCED|DEVICE_ID_NOT_CARRIED|RUN_ID_UNRESOLVED | NORMALIZED_ONLY | {} | {"applied_cooling":"OFF","applied_duty_permille":"0","chamber_air_mean_c":"29.937333","chamber_air_status":"ROLE_QUALIFIED_CHAMBER_AIR","cooling_current_a":"0.000000","cooling_energy_counter_wh":"108.000000","cooling_power_w":"0.000000","cooling_voltage_v":"11.950000","device_state":"OFF","door_polarity":"CONFIRMED","door_state":"CLOSED","experiment_phase":"OFF_IDLE","pressure_hpa":"1013.010000","quality.door":"UNKNOWN","quality.electrical":"UNKNOWN","quality.environment":"UNKNOWN","quality.overall":"UNKNOWN","quality.probe.t1":"OK","quality.probe.t2":"OK","quality.probe.t3":"OK","quality.probe.t4":"OK","quality.producer":"DEGRADED","quality.provenance":"VALID","quality.sequence":"VALID","quality.thermal":"VALID","readback_duty_permille":"0","requested_duty_permille":"0","rh_pct":"68.823000","seq":"44","t1_c":"30.000000","t2_c":"29.875000","t3_c":"29.750000","t4_c":"30.062000","t_air_c":"30.607000"}
f6235e23b4513f98:TELEMETRY_SAMPLE:NO_DEVICE_ID:56044b74:45:46:base | TELEMETRY_SAMPLE | PHYSICAL_MEASURED | evidence/A/W09/exports/CG-S1-H8C-600S.json | f6235e23b4513f98ba7c1deb289f4a3d48afd3c0a87d7f38bfe4e67b2fc79feb | w09-run-export/v2 | 46 |  | 56044b74 | run-00000000 | PARTIAL |  |  | 45 | 44894 |  |  |  | DEVICE_BOOT_UPTIME | NOT_EVIDENCED | UNKNOWN |  | DIAGNOSTIC_ONLY | 1 | CLOCK_SYNC_NOT_EVIDENCED|DEVICE_ID_NOT_CARRIED|RUN_ID_UNRESOLVED | NORMALIZED_ONLY | {} | {"applied_cooling":"OFF","applied_duty_permille":"0","chamber_air_mean_c":"29.937333","chamber_air_status":"ROLE_QUALIFIED_CHAMBER_AIR","cooling_current_a":"0.000000","cooling_energy_counter_wh":"108.000000","cooling_power_w":"0.000000","cooling_voltage_v":"11.950000","device_state":"OFF","door_polarity":"CONFIRMED","door_state":"CLOSED","experiment_phase":"OFF_IDLE","pressure_hpa":"1013.060000","quality.door":"UNKNOWN","quality.electrical":"UNKNOWN","quality.environment":"UNKNOWN","quality.overall":"UNKNOWN","quality.probe.t1":"OK","quality.probe.t2":"OK","quality.probe.t3":"OK","quality.probe.t4":"OK","quality.producer":"DEGRADED","quality.provenance":"VALID","quality.sequence":"VALID","quality.thermal":"VALID","readback_duty_permille":"0","requested_duty_permille":"0","rh_pct":"68.829000","seq":"45","t1_c":"30.062000","t2_c":"29.875000","t3_c":"29.688000","t4_c":"30.062000","t_air_c":"30.618000"}
f6235e23b4513f98:TELEMETRY_SAMPLE:NO_DEVICE_ID:56044b74:46:47:base | TELEMETRY_SAMPLE | PHYSICAL_MEASURED | evidence/A/W09/exports/CG-S1-H8C-600S.json | f6235e23b4513f98ba7c1deb289f4a3d48afd3c0a87d7f38bfe4e67b2fc79feb | w09-run-export/v2 | 47 |  | 56044b74 | run-00000000 | PARTIAL |  |  | 46 | 45894 |  |  |  | DEVICE_BOOT_UPTIME | NOT_EVIDENCED | UNKNOWN |  | DIAGNOSTIC_ONLY | 1 | CLOCK_SYNC_NOT_EVIDENCED|DEVICE_ID_NOT_CARRIED|RUN_ID_UNRESOLVED | NORMALIZED_ONLY | {} | {"applied_cooling":"OFF","applied_duty_permille":"0","chamber_air_mean_c":"29.937333","chamber_air_status":"ROLE_QUALIFIED_CHAMBER_AIR","cooling_current_a":"0.000000","cooling_energy_counter_wh":"108.000000","cooling_power_w":"0.000000","cooling_voltage_v":"11.950000","device_state":"OFF","door_polarity":"CONFIRMED","door_state":"CLOSED","experiment_phase":"OFF_IDLE","pressure_hpa":"1013.000000","quality.door":"UNKNOWN","quality.electrical":"UNKNOWN","quality.environment":"UNKNOWN","quality.overall":"UNKNOWN","quality.probe.t1":"OK","quality.probe.t2":"OK","quality.probe.t3":"OK","quality.probe.t4":"OK","quality.producer":"DEGRADED","quality.provenance":"VALID","quality.sequence":"VALID","quality.thermal":"VALID","readback_duty_permille":"0","requested_duty_permille":"0","rh_pct":"68.834000","seq":"46","t1_c":"30.000000","t2_c":"29.875000","t3_c":"29.750000","t4_c":"30.062000","t_air_c":"30.618000"}
f6235e23b4513f98:TELEMETRY_SAMPLE:NO_DEVICE_ID:56044b74:47:48:base | TELEMETRY_SAMPLE | PHYSICAL_MEASURED | evidence/A/W09/exports/CG-S1-H8C-600S.json | f6235e23b4513f98ba7c1deb289f4a3d48afd3c0a87d7f38bfe4e67b2fc79feb | w09-run-export/v2 | 48 |  | 56044b74 | run-00000000 | PARTIAL |  |  | 47 | 46894 |  |  |  | DEVICE_BOOT_UPTIME | NOT_EVIDENCED | UNKNOWN |  | DIAGNOSTIC_ONLY | 1 | CLOCK_SYNC_NOT_EVIDENCED|DEVICE_ID_NOT_CARRIED|RUN_ID_UNRESOLVED | NORMALIZED_ONLY | {} | {"applied_cooling":"OFF","applied_duty_permille":"0","chamber_air_mean_c":"29.937333","chamber_air_status":"ROLE_QUALIFIED_CHAMBER_AIR","cooling_current_a":"0.000000","cooling_energy_counter_wh":"108.000000","cooling_power_w":"0.000000","cooling_voltage_v":"11.950000","device_state":"OFF","door_polarity":"CONFIRMED","door_state":"CLOSED","experiment_phase":"OFF_IDLE","pressure_hpa":"1012.990000","quality.door":"UNKNOWN","quality.electrical":"UNKNOWN","quality.environment":"UNKNOWN","quality.overall":"UNKNOWN","quality.probe.t1":"OK","quality.probe.t2":"OK","quality.probe.t3":"OK","quality.probe.t4":"OK","quality.producer":"DEGRADED","quality.provenance":"VALID","quality.sequence":"VALID","quality.thermal":"VALID","readback_duty_permille":"0","requested_duty_permille":"0","rh_pct":"68.817000","seq":"47","t1_c":"30.000000","t2_c":"29.875000","t3_c":"29.750000","t4_c":"30.062000","t_air_c":"30.613000"}
f6235e23b4513f98:TELEMETRY_SAMPLE:NO_DEVICE_ID:56044b74:48:49:base | TELEMETRY_SAMPLE | PHYSICAL_MEASURED | evidence/A/W09/exports/CG-S1-H8C-600S.json | f6235e23b4513f98ba7c1deb289f4a3d48afd3c0a87d7f38bfe4e67b2fc79feb | w09-run-export/v2 | 49 |  | 56044b74 | run-00000000 | PARTIAL |  |  | 48 | 47894 |  |  |  | DEVICE_BOOT_UPTIME | NOT_EVIDENCED | UNKNOWN |  | DIAGNOSTIC_ONLY | 1 | CLOCK_SYNC_NOT_EVIDENCED|DEVICE_ID_NOT_CARRIED|RUN_ID_UNRESOLVED | NORMALIZED_ONLY | {} | {"applied_cooling":"OFF","applied_duty_permille":"0","chamber_air_mean_c":"29.937333","chamber_air_status":"ROLE_QUALIFIED_CHAMBER_AIR","cooling_current_a":"0.000000","cooling_energy_counter_wh":"108.000000","cooling_power_w":"0.000000","cooling_voltage_v":"11.950000","device_state":"OFF","door_polarity":"CONFIRMED","door_state":"CLOSED","experiment_phase":"OFF_IDLE","pressure_hpa":"1012.990000","quality.door":"UNKNOWN","quality.electrical":"UNKNOWN","quality.environment":"UNKNOWN","quality.overall":"UNKNOWN","quality.probe.t1":"OK","quality.probe.t2":"OK","quality.probe.t3":"OK","quality.probe.t4":"OK","quality.producer":"DEGRADED","quality.provenance":"VALID","quality.sequence":"VALID","quality.thermal":"VALID","readback_duty_permille":"0","requested_duty_permille":"0","rh_pct":"68.817000","seq":"48","t1_c":"30.062000","t2_c":"29.875000","t3_c":"29.688000","t4_c":"30.062000","t_air_c":"30.607000"}
f6235e23b4513f98:TELEMETRY_SAMPLE:NO_DEVICE_ID:56044b74:49:50:base | TELEMETRY_SAMPLE | PHYSICAL_MEASURED | evidence/A/W09/exports/CG-S1-H8C-600S.json | f6235e23b4513f98ba7c1deb289f4a3d48afd3c0a87d7f38bfe4e67b2fc79feb | w09-run-export/v2 | 50 |  | 56044b74 | run-00000000 | PARTIAL |  |  | 49 | 48894 |  |  |  | DEVICE_BOOT_UPTIME | NOT_EVIDENCED | UNKNOWN |  | DIAGNOSTIC_ONLY | 1 | CLOCK_SYNC_NOT_EVIDENCED|DEVICE_ID_NOT_CARRIED|RUN_ID_UNRESOLVED | NORMALIZED_ONLY | {} | {"applied_cooling":"OFF","applied_duty_permille":"0","chamber_air_mean_c":"29.937333","chamber_air_status":"ROLE_QUALIFIED_CHAMBER_AIR","cooling_current_a":"0.000000","cooling_energy_counter_wh":"108.000000","cooling_power_w":"0.000000","cooling_voltage_v":"11.950000","device_state":"OFF","door_polarity":"CONFIRMED","door_state":"CLOSED","experiment_phase":"OFF_IDLE","pressure_hpa":"1012.990000","quality.door":"UNKNOWN","quality.electrical":"UNKNOWN","quality.environment":"UNKNOWN","quality.overall":"UNKNOWN","quality.probe.t1":"OK","quality.probe.t2":"OK","quality.probe.t3":"OK","quality.probe.t4":"OK","quality.producer":"DEGRADED","quality.provenance":"VALID","quality.sequence":"VALID","quality.thermal":"VALID","readback_duty_permille":"0","requested_duty_permille":"0","rh_pct":"68.823000","seq":"49","t1_c":"30.062000","t2_c":"29.875000","t3_c":"29.688000","t4_c":"30.062000","t_air_c":"30.607000"}
f6235e23b4513f98:TELEMETRY_SAMPLE:NO_DEVICE_ID:56044b74:50:51:base | TELEMETRY_SAMPLE | PHYSICAL_MEASURED | evidence/A/W09/exports/CG-S1-H8C-600S.json | f6235e23b4513f98ba7c1deb289f4a3d48afd3c0a87d7f38bfe4e67b2fc79feb | w09-run-export/v2 | 51 |  | 56044b74 | run-00000000 | PARTIAL |  |  | 50 | 49894 |  |  |  | DEVICE_BOOT_UPTIME | NOT_EVIDENCED | UNKNOWN |  | DIAGNOSTIC_ONLY | 1 | CLOCK_SYNC_NOT_EVIDENCED|DEVICE_ID_NOT_CARRIED|RUN_ID_UNRESOLVED | NORMALIZED_ONLY | {} | {"applied_cooling":"OFF","applied_duty_permille":"0","chamber_air_mean_c":"29.979000","chamber_air_status":"ROLE_QUALIFIED_CHAMBER_AIR","cooling_current_a":"0.000000","cooling_energy_counter_wh":"108.000000","cooling_power_w":"0.000000","cooling_voltage_v":"11.950000","device_state":"OFF","door_polarity":"CONFIRMED","door_state":"CLOSED","experiment_phase":"OFF_IDLE","pressure_hpa":"1012.970000","quality.door":"UNKNOWN","quality.electrical":"UNKNOWN","quality.environment":"UNKNOWN","quality.overall":"UNKNOWN","quality.probe.t1":"OK","quality.probe.t2":"OK","quality.probe.t3":"OK","quality.probe.t4":"OK","quality.producer":"DEGRADED","quality.provenance":"VALID","quality.sequence":"VALID","quality.thermal":"VALID","readback_duty_permille":"0","requested_duty_permille":"0","rh_pct":"68.828000","seq":"50","t1_c":"30.062000","t2_c":"29.875000","t3_c":"29.750000","t4_c":"30.125000","t_air_c":"30.613000"}
f6235e23b4513f98:TELEMETRY_SAMPLE:NO_DEVICE_ID:56044b74:51:52:base | TELEMETRY_SAMPLE | PHYSICAL_MEASURED | evidence/A/W09/exports/CG-S1-H8C-600S.json | f6235e23b4513f98ba7c1deb289f4a3d48afd3c0a87d7f38bfe4e67b2fc79feb | w09-run-export/v2 | 52 |  | 56044b74 | run-00000000 | PARTIAL |  |  | 51 | 50894 |  |  |  | DEVICE_BOOT_UPTIME | NOT_EVIDENCED | UNKNOWN |  | DIAGNOSTIC_ONLY | 1 | CLOCK_SYNC_NOT_EVIDENCED|DEVICE_ID_NOT_CARRIED|RUN_ID_UNRESOLVED | NORMALIZED_ONLY | {} | {"applied_cooling":"OFF","applied_duty_permille":"0","chamber_air_mean_c":"29.958333","chamber_air_status":"ROLE_QUALIFIED_CHAMBER_AIR","cooling_current_a":"0.000000","cooling_energy_counter_wh":"108.000000","cooling_power_w":"0.000000","cooling_voltage_v":"11.950000","device_state":"OFF","door_polarity":"CONFIRMED","door_state":"CLOSED","experiment_phase":"OFF_IDLE","pressure_hpa":"1012.950000","quality.door":"UNKNOWN","quality.electrical":"UNKNOWN","quality.environment":"UNKNOWN","quality.overall":"UNKNOWN","quality.probe.t1":"OK","quality.probe.t2":"OK","quality.probe.t3":"OK","quality.probe.t4":"OK","quality.producer":"DEGRADED","quality.provenance":"VALID","quality.sequence":"VALID","quality.thermal":"VALID","readback_duty_permille":"0","requested_duty_permille":"0","rh_pct":"68.805000","seq":"51","t1_c":"30.062000","t2_c":"29.938000","t3_c":"29.688000","t4_c":"30.125000","t_air_c":"30.602000"}
f6235e23b4513f98:TELEMETRY_SAMPLE:NO_DEVICE_ID:56044b74:52:53:base | TELEMETRY_SAMPLE | PHYSICAL_MEASURED | evidence/A/W09/exports/CG-S1-H8C-600S.json | f6235e23b4513f98ba7c1deb289f4a3d48afd3c0a87d7f38bfe4e67b2fc79feb | w09-run-export/v2 | 53 |  | 56044b74 | run-00000000 | PARTIAL |  |  | 52 | 51894 |  |  |  | DEVICE_BOOT_UPTIME | NOT_EVIDENCED | UNKNOWN |  | DIAGNOSTIC_ONLY | 1 | CLOCK_SYNC_NOT_EVIDENCED|DEVICE_ID_NOT_CARRIED|RUN_ID_UNRESOLVED | NORMALIZED_ONLY | {} | {"applied_cooling":"OFF","applied_duty_permille":"0","chamber_air_mean_c":"29.937333","chamber_air_status":"ROLE_QUALIFIED_CHAMBER_AIR","cooling_current_a":"0.000000","cooling_energy_counter_wh":"108.000000","cooling_power_w":"0.000000","cooling_voltage_v":"11.950000","device_state":"OFF","door_polarity":"CONFIRMED","door_state":"CLOSED","experiment_phase":"OFF_IDLE","pressure_hpa":"1013.000000","quality.door":"UNKNOWN","quality.electrical":"UNKNOWN","quality.environment":"UNKNOWN","quality.overall":"UNKNOWN","quality.probe.t1":"OK","quality.probe.t2":"OK","quality.probe.t3":"OK","quality.probe.t4":"OK","quality.producer":"DEGRADED","quality.provenance":"VALID","quality.sequence":"VALID","quality.thermal":"VALID","readback_duty_permille":"0","requested_duty_permille":"0","rh_pct":"68.829000","seq":"52","t1_c":"30.062000","t2_c":"29.875000","t3_c":"29.688000","t4_c":"30.062000","t_air_c":"30.618000"}
f6235e23b4513f98:TELEMETRY_SAMPLE:NO_DEVICE_ID:56044b74:53:54:base | TELEMETRY_SAMPLE | PHYSICAL_MEASURED | evidence/A/W09/exports/CG-S1-H8C-600S.json | f6235e23b4513f98ba7c1deb289f4a3d48afd3c0a87d7f38bfe4e67b2fc79feb | w09-run-export/v2 | 54 |  | 56044b74 | run-00000000 | PARTIAL |  |  | 53 | 52894 |  |  |  | DEVICE_BOOT_UPTIME | NOT_EVIDENCED | UNKNOWN |  | DIAGNOSTIC_ONLY | 1 | CLOCK_SYNC_NOT_EVIDENCED|DEVICE_ID_NOT_CARRIED|RUN_ID_UNRESOLVED | NORMALIZED_ONLY | {} | {"applied_cooling":"OFF","applied_duty_permille":"0","chamber_air_mean_c":"29.937333","chamber_air_status":"ROLE_QUALIFIED_CHAMBER_AIR","cooling_current_a":"0.000000","cooling_energy_counter_wh":"108.000000","cooling_power_w":"0.000000","cooling_voltage_v":"11.950000","device_state":"OFF","door_polarity":"CONFIRMED","door_state":"CLOSED","experiment_phase":"OFF_IDLE","pressure_hpa":"1012.990000","quality.door":"UNKNOWN","quality.electrical":"UNKNOWN","quality.environment":"UNKNOWN","quality.overall":"UNKNOWN","quality.probe.t1":"OK","quality.probe.t2":"OK","quality.probe.t3":"OK","quality.probe.t4":"OK","quality.producer":"DEGRADED","quality.provenance":"VALID","quality.sequence":"VALID","quality.thermal":"VALID","readback_duty_permille":"0","requested_duty_permille":"0","rh_pct":"68.823000","seq":"53","t1_c":"30.062000","t2_c":"29.875000","t3_c":"29.688000","t4_c":"30.062000","t_air_c":"30.607000"}
f6235e23b4513f98:TELEMETRY_SAMPLE:NO_DEVICE_ID:56044b74:54:55:base | TELEMETRY_SAMPLE | PHYSICAL_MEASURED | evidence/A/W09/exports/CG-S1-H8C-600S.json | f6235e23b4513f98ba7c1deb289f4a3d48afd3c0a87d7f38bfe4e67b2fc79feb | w09-run-export/v2 | 55 |  | 56044b74 | run-00000000 | PARTIAL |  |  | 54 | 53894 |  |  |  | DEVICE_BOOT_UPTIME | NOT_EVIDENCED | UNKNOWN |  | DIAGNOSTIC_ONLY | 1 | CLOCK_SYNC_NOT_EVIDENCED|DEVICE_ID_NOT_CARRIED|RUN_ID_UNRESOLVED | NORMALIZED_ONLY | {} | {"applied_cooling":"OFF","applied_duty_permille":"0","chamber_air_mean_c":"29.958000","chamber_air_status":"ROLE_QUALIFIED_CHAMBER_AIR","cooling_current_a":"0.000000","cooling_energy_counter_wh":"108.000000","cooling_power_w":"0.000000","cooling_voltage_v":"11.950000","device_state":"OFF","door_polarity":"CONFIRMED","door_state":"CLOSED","experiment_phase":"OFF_IDLE","pressure_hpa":"1013.050000","quality.door":"UNKNOWN","quality.electrical":"UNKNOWN","quality.environment":"UNKNOWN","quality.overall":"UNKNOWN","quality.probe.t1":"OK","quality.probe.t2":"OK","quality.probe.t3":"OK","quality.probe.t4":"OK","quality.producer":"DEGRADED","quality.provenance":"VALID","quality.sequence":"VALID","quality.thermal":"VALID","readback_duty_permille":"0","requested_duty_permille":"0","rh_pct":"68.823000","seq":"54","t1_c":"30.062000","t2_c":"29.875000","t3_c":"29.750000","t4_c":"30.062000","t_air_c":"30.613000"}
f6235e23b4513f98:TELEMETRY_SAMPLE:NO_DEVICE_ID:56044b74:55:56:base | TELEMETRY_SAMPLE | PHYSICAL_MEASURED | evidence/A/W09/exports/CG-S1-H8C-600S.json | f6235e23b4513f98ba7c1deb289f4a3d48afd3c0a87d7f38bfe4e67b2fc79feb | w09-run-export/v2 | 56 |  | 56044b74 | run-00000000 | PARTIAL |  |  | 55 | 54894 |  |  |  | DEVICE_BOOT_UPTIME | NOT_EVIDENCED | UNKNOWN |  | DIAGNOSTIC_ONLY | 1 | CLOCK_SYNC_NOT_EVIDENCED|DEVICE_ID_NOT_CARRIED|RUN_ID_UNRESOLVED | NORMALIZED_ONLY | {} | {"applied_cooling":"OFF","applied_duty_permille":"0","chamber_air_mean_c":"29.958000","chamber_air_status":"ROLE_QUALIFIED_CHAMBER_AIR","cooling_current_a":"0.000000","cooling_energy_counter_wh":"108.000000","cooling_power_w":"0.000000","cooling_voltage_v":"11.950000","device_state":"OFF","door_polarity":"CONFIRMED","door_state":"CLOSED","experiment_phase":"OFF_IDLE","pressure_hpa":"1013.020000","quality.door":"UNKNOWN","quality.electrical":"UNKNOWN","quality.environment":"UNKNOWN","quality.overall":"UNKNOWN","quality.probe.t1":"OK","quality.probe.t2":"OK","quality.probe.t3":"OK","quality.probe.t4":"OK","quality.producer":"DEGRADED","quality.provenance":"VALID","quality.sequence":"VALID","quality.thermal":"VALID","readback_duty_permille":"0","requested_duty_permille":"0","rh_pct":"68.817000","seq":"55","t1_c":"30.062000","t2_c":"29.875000","t3_c":"29.750000","t4_c":"30.062000","t_air_c":"30.613000"}
f6235e23b4513f98:TELEMETRY_SAMPLE:NO_DEVICE_ID:56044b74:56:57:base | TELEMETRY_SAMPLE | PHYSICAL_MEASURED | evidence/A/W09/exports/CG-S1-H8C-600S.json | f6235e23b4513f98ba7c1deb289f4a3d48afd3c0a87d7f38bfe4e67b2fc79feb | w09-run-export/v2 | 57 |  | 56044b74 | run-00000000 | PARTIAL |  |  | 56 | 55894 |  |  |  | DEVICE_BOOT_UPTIME | NOT_EVIDENCED | UNKNOWN |  | DIAGNOSTIC_ONLY | 1 | CLOCK_SYNC_NOT_EVIDENCED|DEVICE_ID_NOT_CARRIED|RUN_ID_UNRESOLVED | NORMALIZED_ONLY | {} | {"applied_cooling":"OFF","applied_duty_permille":"0","chamber_air_mean_c":"29.958000","chamber_air_status":"ROLE_QUALIFIED_CHAMBER_AIR","cooling_current_a":"0.000000","cooling_energy_counter_wh":"108.000000","cooling_power_w":"0.000000","cooling_voltage_v":"11.950000","device_state":"OFF","door_polarity":"CONFIRMED","door_state":"CLOSED","experiment_phase":"OFF_IDLE","pressure_hpa":"1013.000000","quality.door":"UNKNOWN","quality.electrical":"UNKNOWN","quality.environment":"UNKNOWN","quality.overall":"UNKNOWN","quality.probe.t1":"OK","quality.probe.t2":"OK","quality.probe.t3":"OK","quality.probe.t4":"OK","quality.producer":"DEGRADED","quality.provenance":"VALID","quality.sequence":"VALID","quality.thermal":"VALID","readback_duty_permille":"0","requested_duty_permille":"0","rh_pct":"68.823000","seq":"56","t1_c":"30.062000","t2_c":"29.875000","t3_c":"29.750000","t4_c":"30.062000","t_air_c":"30.618000"}
f6235e23b4513f98:TELEMETRY_SAMPLE:NO_DEVICE_ID:56044b74:57:58:base | TELEMETRY_SAMPLE | PHYSICAL_MEASURED | evidence/A/W09/exports/CG-S1-H8C-600S.json | f6235e23b4513f98ba7c1deb289f4a3d48afd3c0a87d7f38bfe4e67b2fc79feb | w09-run-export/v2 | 58 |  | 56044b74 | run-00000000 | PARTIAL |  |  | 57 | 56894 |  |  |  | DEVICE_BOOT_UPTIME | NOT_EVIDENCED | UNKNOWN |  | DIAGNOSTIC_ONLY | 1 | CLOCK_SYNC_NOT_EVIDENCED|DEVICE_ID_NOT_CARRIED|RUN_ID_UNRESOLVED | NORMALIZED_ONLY | {} | {"applied_cooling":"OFF","applied_duty_permille":"0","chamber_air_mean_c":"29.958000","chamber_air_status":"ROLE_QUALIFIED_CHAMBER_AIR","cooling_current_a":"0.000000","cooling_energy_counter_wh":"108.000000","cooling_power_w":"0.000000","cooling_voltage_v":"11.950000","device_state":"OFF","door_polarity":"CONFIRMED","door_state":"CLOSED","experiment_phase":"OFF_IDLE","pressure_hpa":"1012.990000","quality.door":"UNKNOWN","quality.electrical":"UNKNOWN","quality.environment":"UNKNOWN","quality.overall":"UNKNOWN","quality.probe.t1":"OK","quality.probe.t2":"OK","quality.probe.t3":"OK","quality.probe.t4":"OK","quality.producer":"DEGRADED","quality.provenance":"VALID","quality.sequence":"VALID","quality.thermal":"VALID","readback_duty_permille":"0","requested_duty_permille":"0","rh_pct":"68.817000","seq":"57","t1_c":"30.062000","t2_c":"29.875000","t3_c":"29.750000","t4_c":"30.062000","t_air_c":"30.607000"}
f6235e23b4513f98:TELEMETRY_SAMPLE:NO_DEVICE_ID:56044b74:58:59:base | TELEMETRY_SAMPLE | PHYSICAL_MEASURED | evidence/A/W09/exports/CG-S1-H8C-600S.json | f6235e23b4513f98ba7c1deb289f4a3d48afd3c0a87d7f38bfe4e67b2fc79feb | w09-run-export/v2 | 59 |  | 56044b74 | run-00000000 | PARTIAL |  |  | 58 | 57894 |  |  |  | DEVICE_BOOT_UPTIME | NOT_EVIDENCED | UNKNOWN |  | DIAGNOSTIC_ONLY | 1 | CLOCK_SYNC_NOT_EVIDENCED|DEVICE_ID_NOT_CARRIED|RUN_ID_UNRESOLVED | NORMALIZED_ONLY | {} | {"applied_cooling":"OFF","applied_duty_permille":"0","chamber_air_mean_c":"29.958000","chamber_air_status":"ROLE_QUALIFIED_CHAMBER_AIR","cooling_current_a":"0.000000","cooling_energy_counter_wh":"108.000000","cooling_power_w":"0.000000","cooling_voltage_v":"11.950000","device_state":"OFF","door_polarity":"CONFIRMED","door_state":"CLOSED","experiment_phase":"OFF_IDLE","pressure_hpa":"1013.020000","quality.door":"UNKNOWN","quality.electrical":"UNKNOWN","quality.environment":"UNKNOWN","quality.overall":"UNKNOWN","quality.probe.t1":"OK","quality.probe.t2":"OK","quality.probe.t3":"OK","quality.probe.t4":"OK","quality.producer":"DEGRADED","quality.provenance":"VALID","quality.sequence":"VALID","quality.thermal":"VALID","readback_duty_permille":"0","requested_duty_permille":"0","rh_pct":"68.812000","seq":"58","t1_c":"30.062000","t2_c":"29.875000","t3_c":"29.750000","t4_c":"30.062000","t_air_c":"30.613000"}
f6235e23b4513f98:TELEMETRY_SAMPLE:NO_DEVICE_ID:56044b74:59:60:base | TELEMETRY_SAMPLE | PHYSICAL_MEASURED | evidence/A/W09/exports/CG-S1-H8C-600S.json | f6235e23b4513f98ba7c1deb289f4a3d48afd3c0a87d7f38bfe4e67b2fc79feb | w09-run-export/v2 | 60 |  | 56044b74 | run-00000000 | PARTIAL |  |  | 59 | 58894 |  |  |  | DEVICE_BOOT_UPTIME | NOT_EVIDENCED | UNKNOWN |  | DIAGNOSTIC_ONLY | 1 | CLOCK_SYNC_NOT_EVIDENCED|DEVICE_ID_NOT_CARRIED|RUN_ID_UNRESOLVED | NORMALIZED_ONLY | {} | {"applied_cooling":"OFF","applied_duty_permille":"0","chamber_air_mean_c":"29.958000","chamber_air_status":"ROLE_QUALIFIED_CHAMBER_AIR","cooling_current_a":"0.000000","cooling_energy_counter_wh":"108.000000","cooling_power_w":"0.000000","cooling_voltage_v":"11.950000","device_state":"OFF","door_polarity":"CONFIRMED","door_state":"CLOSED","experiment_phase":"OFF_IDLE","pressure_hpa":"1013.080000","quality.door":"UNKNOWN","quality.electrical":"UNKNOWN","quality.environment":"UNKNOWN","quality.overall":"UNKNOWN","quality.probe.t1":"OK","quality.probe.t2":"OK","quality.probe.t3":"OK","quality.probe.t4":"OK","quality.producer":"DEGRADED","quality.provenance":"VALID","quality.sequence":"VALID","quality.thermal":"VALID","readback_duty_permille":"0","requested_duty_permille":"0","rh_pct":"68.806000","seq":"59","t1_c":"30.062000","t2_c":"29.875000","t3_c":"29.750000","t4_c":"30.062000","t_air_c":"30.613000"}
f6235e23b4513f98:TELEMETRY_SAMPLE:NO_DEVICE_ID:56044b74:60:61:base | TELEMETRY_SAMPLE | PHYSICAL_MEASURED | evidence/A/W09/exports/CG-S1-H8C-600S.json | f6235e23b4513f98ba7c1deb289f4a3d48afd3c0a87d7f38bfe4e67b2fc79feb | w09-run-export/v2 | 61 |  | 56044b74 | run-00000000 | PARTIAL |  |  | 60 | 59894 |  |  |  | DEVICE_BOOT_UPTIME | NOT_EVIDENCED | UNKNOWN |  | DIAGNOSTIC_ONLY | 1 | CLOCK_SYNC_NOT_EVIDENCED|DEVICE_ID_NOT_CARRIED|RUN_ID_UNRESOLVED | NORMALIZED_ONLY | {} | {"applied_cooling":"OFF","applied_duty_permille":"0","chamber_air_mean_c":"29.979000","chamber_air_status":"ROLE_QUALIFIED_CHAMBER_AIR","cooling_current_a":"0.000000","cooling_energy_counter_wh":"108.000000","cooling_power_w":"0.000000","cooling_voltage_v":"11.950000","device_state":"OFF","door_polarity":"CONFIRMED","door_state":"CLOSED","experiment_phase":"OFF_IDLE","pressure_hpa":"1012.970000","quality.door":"UNKNOWN","quality.electrical":"UNKNOWN","quality.environment":"UNKNOWN","quality.overall":"UNKNOWN","quality.probe.t1":"OK","quality.probe.t2":"OK","quality.probe.t3":"OK","quality.probe.t4":"OK","quality.producer":"DEGRADED","quality.provenance":"VALID","quality.sequence":"VALID","quality.thermal":"VALID","readback_duty_permille":"0","requested_duty_permille":"0","rh_pct":"68.806000","seq":"60","t1_c":"30.062000","t2_c":"29.875000","t3_c":"29.750000","t4_c":"30.125000","t_air_c":"30.618000"}
f6235e23b4513f98:TELEMETRY_SAMPLE:NO_DEVICE_ID:56044b74:61:62:base | TELEMETRY_SAMPLE | PHYSICAL_MEASURED | evidence/A/W09/exports/CG-S1-H8C-600S.json | f6235e23b4513f98ba7c1deb289f4a3d48afd3c0a87d7f38bfe4e67b2fc79feb | w09-run-export/v2 | 62 |  | 56044b74 | run-00000000 | PARTIAL |  |  | 61 | 60894 |  |  |  | DEVICE_BOOT_UPTIME | NOT_EVIDENCED | UNKNOWN |  | DIAGNOSTIC_ONLY | 1 | CLOCK_SYNC_NOT_EVIDENCED|DEVICE_ID_NOT_CARRIED|RUN_ID_UNRESOLVED | NORMALIZED_ONLY | {} | {"applied_cooling":"OFF","applied_duty_permille":"0","chamber_air_mean_c":"29.958000","chamber_air_status":"ROLE_QUALIFIED_CHAMBER_AIR","cooling_current_a":"0.000000","cooling_energy_counter_wh":"108.000000","cooling_power_w":"0.000000","cooling_voltage_v":"11.950000","device_state":"OFF","door_polarity":"CONFIRMED","door_state":"CLOSED","experiment_phase":"OFF_IDLE","pressure_hpa":"1013.030000","quality.door":"UNKNOWN","quality.electrical":"UNKNOWN","quality.environment":"UNKNOWN","quality.overall":"UNKNOWN","quality.probe.t1":"OK","quality.probe.t2":"OK","quality.probe.t3":"OK","quality.probe.t4":"OK","quality.producer":"DEGRADED","quality.provenance":"VALID","quality.sequence":"VALID","quality.thermal":"VALID","readback_duty_permille":"0","requested_duty_permille":"0","rh_pct":"68.812000","seq":"61","t1_c":"30.062000","t2_c":"29.938000","t3_c":"29.750000","t4_c":"30.062000","t_air_c":"30.618000"}
f6235e23b4513f98:TELEMETRY_SAMPLE:NO_DEVICE_ID:56044b74:62:63:base | TELEMETRY_SAMPLE | PHYSICAL_MEASURED | evidence/A/W09/exports/CG-S1-H8C-600S.json | f6235e23b4513f98ba7c1deb289f4a3d48afd3c0a87d7f38bfe4e67b2fc79feb | w09-run-export/v2 | 63 |  | 56044b74 | run-00000000 | PARTIAL |  |  | 62 | 61894 |  |  |  | DEVICE_BOOT_UPTIME | NOT_EVIDENCED | UNKNOWN |  | DIAGNOSTIC_ONLY | 1 | CLOCK_SYNC_NOT_EVIDENCED|DEVICE_ID_NOT_CARRIED|RUN_ID_UNRESOLVED | NORMALIZED_ONLY | {} | {"applied_cooling":"OFF","applied_duty_permille":"0","chamber_air_mean_c":"29.937333","chamber_air_status":"ROLE_QUALIFIED_CHAMBER_AIR","cooling_current_a":"0.000000","cooling_energy_counter_wh":"108.000000","cooling_power_w":"0.000000","cooling_voltage_v":"11.950000","device_state":"OFF","door_polarity":"CONFIRMED","door_state":"CLOSED","experiment_phase":"OFF_IDLE","pressure_hpa":"1013.000000","quality.door":"UNKNOWN","quality.electrical":"UNKNOWN","quality.environment":"UNKNOWN","quality.overall":"UNKNOWN","quality.probe.t1":"OK","quality.probe.t2":"OK","quality.probe.t3":"OK","quality.probe.t4":"OK","quality.producer":"DEGRADED","quality.provenance":"VALID","quality.sequence":"VALID","quality.thermal":"VALID","readback_duty_permille":"0","requested_duty_permille":"0","rh_pct":"68.806000","seq":"62","t1_c":"30.000000","t2_c":"29.875000","t3_c":"29.750000","t4_c":"30.062000","t_air_c":"30.618000"}
f6235e23b4513f98:TELEMETRY_SAMPLE:NO_DEVICE_ID:56044b74:63:64:base | TELEMETRY_SAMPLE | PHYSICAL_MEASURED | evidence/A/W09/exports/CG-S1-H8C-600S.json | f6235e23b4513f98ba7c1deb289f4a3d48afd3c0a87d7f38bfe4e67b2fc79feb | w09-run-export/v2 | 64 |  | 56044b74 | run-00000000 | PARTIAL |  |  | 63 | 62894 |  |  |  | DEVICE_BOOT_UPTIME | NOT_EVIDENCED | UNKNOWN |  | DIAGNOSTIC_ONLY | 1 | CLOCK_SYNC_NOT_EVIDENCED|DEVICE_ID_NOT_CARRIED|RUN_ID_UNRESOLVED | NORMALIZED_ONLY | {} | {"applied_cooling":"OFF","applied_duty_permille":"0","chamber_air_mean_c":"29.937333","chamber_air_status":"ROLE_QUALIFIED_CHAMBER_AIR","cooling_current_a":"0.000000","cooling_energy_counter_wh":"108.000000","cooling_power_w":"0.000000","cooling_voltage_v":"11.950000","device_state":"OFF","door_polarity":"CONFIRMED","door_state":"CLOSED","experiment_phase":"OFF_IDLE","pressure_hpa":"1013.000000","quality.door":"UNKNOWN","quality.electrical":"UNKNOWN","quality.environment":"UNKNOWN","quality.overall":"UNKNOWN","quality.probe.t1":"OK","quality.probe.t2":"OK","quality.probe.t3":"OK","quality.probe.t4":"OK","quality.producer":"DEGRADED","quality.provenance":"VALID","quality.sequence":"VALID","quality.thermal":"VALID","readback_duty_permille":"0","requested_duty_permille":"0","rh_pct":"68.790000","seq":"63","t1_c":"30.062000","t2_c":"29.875000","t3_c":"29.688000","t4_c":"30.062000","t_air_c":"30.618000"}
f6235e23b4513f98:TELEMETRY_SAMPLE:NO_DEVICE_ID:56044b74:64:65:base | TELEMETRY_SAMPLE | PHYSICAL_MEASURED | evidence/A/W09/exports/CG-S1-H8C-600S.json | f6235e23b4513f98ba7c1deb289f4a3d48afd3c0a87d7f38bfe4e67b2fc79feb | w09-run-export/v2 | 65 |  | 56044b74 | run-00000000 | PARTIAL |  |  | 64 | 63894 |  |  |  | DEVICE_BOOT_UPTIME | NOT_EVIDENCED | UNKNOWN |  | DIAGNOSTIC_ONLY | 1 | CLOCK_SYNC_NOT_EVIDENCED|DEVICE_ID_NOT_CARRIED|RUN_ID_UNRESOLVED | NORMALIZED_ONLY | {} | {"applied_cooling":"OFF","applied_duty_permille":"0","chamber_air_mean_c":"29.916667","chamber_air_status":"ROLE_QUALIFIED_CHAMBER_AIR","cooling_current_a":"0.000000","cooling_energy_counter_wh":"108.000000","cooling_power_w":"0.000000","cooling_voltage_v":"11.950000","device_state":"OFF","door_polarity":"CONFIRMED","door_state":"CLOSED","experiment_phase":"OFF_IDLE","pressure_hpa":"1012.990000","quality.door":"UNKNOWN","quality.electrical":"UNKNOWN","quality.environment":"UNKNOWN","quality.overall":"UNKNOWN","quality.probe.t1":"OK","quality.probe.t2":"OK","quality.probe.t3":"OK","quality.probe.t4":"OK","quality.producer":"DEGRADED","quality.provenance":"VALID","quality.sequence":"VALID","quality.thermal":"VALID","readback_duty_permille":"0","requested_duty_permille":"0","rh_pct":"68.784000","seq":"64","t1_c":"30.000000","t2_c":"29.875000","t3_c":"29.688000","t4_c":"30.062000","t_air_c":"30.613000"}
f6235e23b4513f98:TELEMETRY_SAMPLE:NO_DEVICE_ID:56044b74:65:66:base | TELEMETRY_SAMPLE | PHYSICAL_MEASURED | evidence/A/W09/exports/CG-S1-H8C-600S.json | f6235e23b4513f98ba7c1deb289f4a3d48afd3c0a87d7f38bfe4e67b2fc79feb | w09-run-export/v2 | 66 |  | 56044b74 | run-00000000 | PARTIAL |  |  | 65 | 64894 |  |  |  | DEVICE_BOOT_UPTIME | NOT_EVIDENCED | UNKNOWN |  | DIAGNOSTIC_ONLY | 1 | CLOCK_SYNC_NOT_EVIDENCED|DEVICE_ID_NOT_CARRIED|RUN_ID_UNRESOLVED | NORMALIZED_ONLY | {} | {"applied_cooling":"OFF","applied_duty_permille":"0","chamber_air_mean_c":"29.937333","chamber_air_status":"ROLE_QUALIFIED_CHAMBER_AIR","cooling_current_a":"0.000000","cooling_energy_counter_wh":"108.000000","cooling_power_w":"0.000000","cooling_voltage_v":"11.950000","device_state":"OFF","door_polarity":"CONFIRMED","door_state":"CLOSED","experiment_phase":"OFF_IDLE","pressure_hpa":"1013.010000","quality.door":"UNKNOWN","quality.electrical":"UNKNOWN","quality.environment":"UNKNOWN","quality.overall":"UNKNOWN","quality.probe.t1":"OK","quality.probe.t2":"OK","quality.probe.t3":"OK","quality.probe.t4":"OK","quality.producer":"DEGRADED","quality.provenance":"VALID","quality.sequence":"VALID","quality.thermal":"VALID","readback_duty_permille":"0","requested_duty_permille":"0","rh_pct":"68.784000","seq":"65","t1_c":"30.000000","t2_c":"29.875000","t3_c":"29.750000","t4_c":"30.062000","t_air_c":"30.623000"}
f6235e23b4513f98:TELEMETRY_SAMPLE:NO_DEVICE_ID:56044b74:66:67:base | TELEMETRY_SAMPLE | PHYSICAL_MEASURED | evidence/A/W09/exports/CG-S1-H8C-600S.json | f6235e23b4513f98ba7c1deb289f4a3d48afd3c0a87d7f38bfe4e67b2fc79feb | w09-run-export/v2 | 67 |  | 56044b74 | run-00000000 | PARTIAL |  |  | 66 | 65894 |  |  |  | DEVICE_BOOT_UPTIME | NOT_EVIDENCED | UNKNOWN |  | DIAGNOSTIC_ONLY | 1 | CLOCK_SYNC_NOT_EVIDENCED|DEVICE_ID_NOT_CARRIED|RUN_ID_UNRESOLVED | NORMALIZED_ONLY | {} | {"applied_cooling":"OFF","applied_duty_permille":"0","chamber_air_mean_c":"29.937333","chamber_air_status":"ROLE_QUALIFIED_CHAMBER_AIR","cooling_current_a":"0.000000","cooling_energy_counter_wh":"108.000000","cooling_power_w":"0.000000","cooling_voltage_v":"11.950000","device_state":"OFF","door_polarity":"CONFIRMED","door_state":"CLOSED","experiment_phase":"OFF_IDLE","pressure_hpa":"1013.070000","quality.door":"UNKNOWN","quality.electrical":"UNKNOWN","quality.environment":"UNKNOWN","quality.overall":"UNKNOWN","quality.probe.t1":"OK","quality.probe.t2":"OK","quality.probe.t3":"OK","quality.probe.t4":"OK","quality.producer":"DEGRADED","quality.provenance":"VALID","quality.sequence":"VALID","quality.thermal":"VALID","readback_duty_permille":"0","requested_duty_permille":"0","rh_pct":"68.802000","seq":"66","t1_c":"30.062000","t2_c":"29.875000","t3_c":"29.688000","t4_c":"30.062000","t_air_c":"30.628000"}
f6235e23b4513f98:TELEMETRY_SAMPLE:NO_DEVICE_ID:56044b74:67:68:base | TELEMETRY_SAMPLE | PHYSICAL_MEASURED | evidence/A/W09/exports/CG-S1-H8C-600S.json | f6235e23b4513f98ba7c1deb289f4a3d48afd3c0a87d7f38bfe4e67b2fc79feb | w09-run-export/v2 | 68 |  | 56044b74 | run-00000000 | PARTIAL |  |  | 67 | 66894 |  |  |  | DEVICE_BOOT_UPTIME | NOT_EVIDENCED | UNKNOWN |  | DIAGNOSTIC_ONLY | 1 | CLOCK_SYNC_NOT_EVIDENCED|DEVICE_ID_NOT_CARRIED|RUN_ID_UNRESOLVED | NORMALIZED_ONLY | {} | {"applied_cooling":"OFF","applied_duty_permille":"0","chamber_air_mean_c":"29.958000","chamber_air_status":"ROLE_QUALIFIED_CHAMBER_AIR","cooling_current_a":"0.000000","cooling_energy_counter_wh":"108.000000","cooling_power_w":"0.000000","cooling_voltage_v":"11.950000","device_state":"OFF","door_polarity":"CONFIRMED","door_state":"CLOSED","experiment_phase":"OFF_IDLE","pressure_hpa":"1013.020000","quality.door":"UNKNOWN","quality.electrical":"UNKNOWN","quality.environment":"UNKNOWN","quality.overall":"UNKNOWN","quality.probe.t1":"OK","quality.probe.t2":"OK","quality.probe.t3":"OK","quality.probe.t4":"OK","quality.producer":"DEGRADED","quality.provenance":"VALID","quality.sequence":"VALID","quality.thermal":"VALID","readback_duty_permille":"0","requested_duty_permille":"0","rh_pct":"68.789000","seq":"67","t1_c":"30.062000","t2_c":"29.875000","t3_c":"29.750000","t4_c":"30.062000","t_air_c":"30.613000"}
f6235e23b4513f98:TELEMETRY_SAMPLE:NO_DEVICE_ID:56044b74:68:69:base | TELEMETRY_SAMPLE | PHYSICAL_MEASURED | evidence/A/W09/exports/CG-S1-H8C-600S.json | f6235e23b4513f98ba7c1deb289f4a3d48afd3c0a87d7f38bfe4e67b2fc79feb | w09-run-export/v2 | 69 |  | 56044b74 | run-00000000 | PARTIAL |  |  | 68 | 67894 |  |  |  | DEVICE_BOOT_UPTIME | NOT_EVIDENCED | UNKNOWN |  | DIAGNOSTIC_ONLY | 1 | CLOCK_SYNC_NOT_EVIDENCED|DEVICE_ID_NOT_CARRIED|RUN_ID_UNRESOLVED | NORMALIZED_ONLY | {} | {"applied_cooling":"OFF","applied_duty_permille":"0","chamber_air_mean_c":"29.958333","chamber_air_status":"ROLE_QUALIFIED_CHAMBER_AIR","cooling_current_a":"0.000000","cooling_energy_counter_wh":"108.000000","cooling_power_w":"0.000000","cooling_voltage_v":"11.950000","device_state":"OFF","door_polarity":"CONFIRMED","door_state":"CLOSED","experiment_phase":"OFF_IDLE","pressure_hpa":"1013.040000","quality.door":"UNKNOWN","quality.electrical":"UNKNOWN","quality.environment":"UNKNOWN","quality.overall":"UNKNOWN","quality.probe.t1":"OK","quality.probe.t2":"OK","quality.probe.t3":"OK","quality.probe.t4":"OK","quality.producer":"DEGRADED","quality.provenance":"VALID","quality.sequence":"VALID","quality.thermal":"VALID","readback_duty_permille":"0","requested_duty_permille":"0","rh_pct":"68.796000","seq":"68","t1_c":"30.062000","t2_c":"29.875000","t3_c":"29.688000","t4_c":"30.125000","t_air_c":"30.623000"}
f6235e23b4513f98:TELEMETRY_SAMPLE:NO_DEVICE_ID:56044b74:69:70:base | TELEMETRY_SAMPLE | PHYSICAL_MEASURED | evidence/A/W09/exports/CG-S1-H8C-600S.json | f6235e23b4513f98ba7c1deb289f4a3d48afd3c0a87d7f38bfe4e67b2fc79feb | w09-run-export/v2 | 70 |  | 56044b74 | run-00000000 | PARTIAL |  |  | 69 | 68894 |  |  |  | DEVICE_BOOT_UPTIME | NOT_EVIDENCED | UNKNOWN |  | DIAGNOSTIC_ONLY | 1 | CLOCK_SYNC_NOT_EVIDENCED|DEVICE_ID_NOT_CARRIED|RUN_ID_UNRESOLVED | NORMALIZED_ONLY | {} | {"applied_cooling":"OFF","applied_duty_permille":"0","chamber_air_mean_c":"29.937333","chamber_air_status":"ROLE_QUALIFIED_CHAMBER_AIR","cooling_current_a":"0.000000","cooling_energy_counter_wh":"108.000000","cooling_power_w":"0.000000","cooling_voltage_v":"11.950000","device_state":"OFF","door_polarity":"CONFIRMED","door_state":"CLOSED","experiment_phase":"OFF_IDLE","pressure_hpa":"1012.980000","quality.door":"UNKNOWN","quality.electrical":"UNKNOWN","quality.environment":"UNKNOWN","quality.overall":"UNKNOWN","quality.probe.t1":"OK","quality.probe.t2":"OK","quality.probe.t3":"OK","quality.probe.t4":"OK","quality.producer":"DEGRADED","quality.provenance":"VALID","quality.sequence":"VALID","quality.thermal":"VALID","readback_duty_permille":"0","requested_duty_permille":"0","rh_pct":"68.773000","seq":"69","t1_c":"30.062000","t2_c":"29.875000","t3_c":"29.688000","t4_c":"30.062000","t_air_c":"30.623000"}
f6235e23b4513f98:TELEMETRY_SAMPLE:NO_DEVICE_ID:56044b74:70:71:base | TELEMETRY_SAMPLE | PHYSICAL_MEASURED | evidence/A/W09/exports/CG-S1-H8C-600S.json | f6235e23b4513f98ba7c1deb289f4a3d48afd3c0a87d7f38bfe4e67b2fc79feb | w09-run-export/v2 | 71 |  | 56044b74 | run-00000000 | PARTIAL |  |  | 70 | 69894 |  |  |  | DEVICE_BOOT_UPTIME | NOT_EVIDENCED | UNKNOWN |  | DIAGNOSTIC_ONLY | 1 | CLOCK_SYNC_NOT_EVIDENCED|DEVICE_ID_NOT_CARRIED|RUN_ID_UNRESOLVED | NORMALIZED_ONLY | {} | {"applied_cooling":"OFF","applied_duty_permille":"0","chamber_air_mean_c":"29.958000","chamber_air_status":"ROLE_QUALIFIED_CHAMBER_AIR","cooling_current_a":"0.000000","cooling_energy_counter_wh":"108.000000","cooling_power_w":"0.000000","cooling_voltage_v":"11.950000","device_state":"OFF","door_polarity":"CONFIRMED","door_state":"CLOSED","experiment_phase":"OFF_IDLE","pressure_hpa":"1013.040000","quality.door":"UNKNOWN","quality.electrical":"UNKNOWN","quality.environment":"UNKNOWN","quality.overall":"UNKNOWN","quality.probe.t1":"OK","quality.probe.t2":"OK","quality.probe.t3":"OK","quality.probe.t4":"OK","quality.producer":"DEGRADED","quality.provenance":"VALID","quality.sequence":"VALID","quality.thermal":"VALID","readback_duty_permille":"0","requested_duty_permille":"0","rh_pct":"68.784000","seq":"70","t1_c":"30.062000","t2_c":"29.875000","t3_c":"29.750000","t4_c":"30.062000","t_air_c":"30.623000"}
f6235e23b4513f98:TELEMETRY_SAMPLE:NO_DEVICE_ID:56044b74:71:72:base | TELEMETRY_SAMPLE | PHYSICAL_MEASURED | evidence/A/W09/exports/CG-S1-H8C-600S.json | f6235e23b4513f98ba7c1deb289f4a3d48afd3c0a87d7f38bfe4e67b2fc79feb | w09-run-export/v2 | 72 |  | 56044b74 | run-00000000 | PARTIAL |  |  | 71 | 70894 |  |  |  | DEVICE_BOOT_UPTIME | NOT_EVIDENCED | UNKNOWN |  | DIAGNOSTIC_ONLY | 1 | CLOCK_SYNC_NOT_EVIDENCED|DEVICE_ID_NOT_CARRIED|RUN_ID_UNRESOLVED | NORMALIZED_ONLY | {} | {"applied_cooling":"OFF","applied_duty_permille":"0","chamber_air_mean_c":"29.958000","chamber_air_status":"ROLE_QUALIFIED_CHAMBER_AIR","cooling_current_a":"0.000000","cooling_energy_counter_wh":"108.000000","cooling_power_w":"0.000000","cooling_voltage_v":"11.950000","device_state":"OFF","door_polarity":"CONFIRMED","door_state":"CLOSED","experiment_phase":"OFF_IDLE","pressure_hpa":"1013.010000","quality.door":"UNKNOWN","quality.electrical":"UNKNOWN","quality.environment":"UNKNOWN","quality.overall":"UNKNOWN","quality.probe.t1":"OK","quality.probe.t2":"OK","quality.probe.t3":"OK","quality.probe.t4":"OK","quality.producer":"DEGRADED","quality.provenance":"VALID","quality.sequence":"VALID","quality.thermal":"VALID","readback_duty_permille":"0","requested_duty_permille":"0","rh_pct":"68.773000","seq":"71","t1_c":"30.062000","t2_c":"29.875000","t3_c":"29.750000","t4_c":"30.062000","t_air_c":"30.623000"}
f6235e23b4513f98:TELEMETRY_SAMPLE:NO_DEVICE_ID:56044b74:72:73:base | TELEMETRY_SAMPLE | PHYSICAL_MEASURED | evidence/A/W09/exports/CG-S1-H8C-600S.json | f6235e23b4513f98ba7c1deb289f4a3d48afd3c0a87d7f38bfe4e67b2fc79feb | w09-run-export/v2 | 73 |  | 56044b74 | run-00000000 | PARTIAL |  |  | 72 | 71894 |  |  |  | DEVICE_BOOT_UPTIME | NOT_EVIDENCED | UNKNOWN |  | DIAGNOSTIC_ONLY | 1 | CLOCK_SYNC_NOT_EVIDENCED|DEVICE_ID_NOT_CARRIED|RUN_ID_UNRESOLVED | NORMALIZED_ONLY | {} | {"applied_cooling":"OFF","applied_duty_permille":"0","chamber_air_mean_c":"29.937333","chamber_air_status":"ROLE_QUALIFIED_CHAMBER_AIR","cooling_current_a":"0.000000","cooling_energy_counter_wh":"108.000000","cooling_power_w":"0.000000","cooling_voltage_v":"11.950000","device_state":"OFF","door_polarity":"CONFIRMED","door_state":"CLOSED","experiment_phase":"OFF_IDLE","pressure_hpa":"1013.000000","quality.door":"UNKNOWN","quality.electrical":"UNKNOWN","quality.environment":"UNKNOWN","quality.overall":"UNKNOWN","quality.probe.t1":"OK","quality.probe.t2":"OK","quality.probe.t3":"OK","quality.probe.t4":"OK","quality.producer":"DEGRADED","quality.provenance":"VALID","quality.sequence":"VALID","quality.thermal":"VALID","readback_duty_permille":"0","requested_duty_permille":"0","rh_pct":"68.784000","seq":"72","t1_c":"30.062000","t2_c":"29.875000","t3_c":"29.688000","t4_c":"30.062000","t_air_c":"30.618000"}
f6235e23b4513f98:TELEMETRY_SAMPLE:NO_DEVICE_ID:56044b74:73:74:base | TELEMETRY_SAMPLE | PHYSICAL_MEASURED | evidence/A/W09/exports/CG-S1-H8C-600S.json | f6235e23b4513f98ba7c1deb289f4a3d48afd3c0a87d7f38bfe4e67b2fc79feb | w09-run-export/v2 | 74 |  | 56044b74 | run-00000000 | PARTIAL |  |  | 73 | 72894 |  |  |  | DEVICE_BOOT_UPTIME | NOT_EVIDENCED | UNKNOWN |  | DIAGNOSTIC_ONLY | 1 | CLOCK_SYNC_NOT_EVIDENCED|DEVICE_ID_NOT_CARRIED|RUN_ID_UNRESOLVED | NORMALIZED_ONLY | {} | {"applied_cooling":"OFF","applied_duty_permille":"0","chamber_air_mean_c":"29.979000","chamber_air_status":"ROLE_QUALIFIED_CHAMBER_AIR","cooling_current_a":"0.000000","cooling_energy_counter_wh":"108.000000","cooling_power_w":"0.000000","cooling_voltage_v":"11.950000","device_state":"OFF","door_polarity":"CONFIRMED","door_state":"CLOSED","experiment_phase":"OFF_IDLE","pressure_hpa":"1013.040000","quality.door":"UNKNOWN","quality.electrical":"UNKNOWN","quality.environment":"UNKNOWN","quality.overall":"UNKNOWN","quality.probe.t1":"OK","quality.probe.t2":"OK","quality.probe.t3":"OK","quality.probe.t4":"OK","quality.producer":"DEGRADED","quality.provenance":"VALID","quality.sequence":"VALID","quality.thermal":"VALID","readback_duty_permille":"0","requested_duty_permille":"0","rh_pct":"68.773000","seq":"73","t1_c":"30.062000","t2_c":"29.875000","t3_c":"29.750000","t4_c":"30.125000","t_air_c":"30.623000"}
f6235e23b4513f98:TELEMETRY_SAMPLE:NO_DEVICE_ID:56044b74:74:75:base | TELEMETRY_SAMPLE | PHYSICAL_MEASURED | evidence/A/W09/exports/CG-S1-H8C-600S.json | f6235e23b4513f98ba7c1deb289f4a3d48afd3c0a87d7f38bfe4e67b2fc79feb | w09-run-export/v2 | 75 |  | 56044b74 | run-00000000 | PARTIAL |  |  | 74 | 73894 |  |  |  | DEVICE_BOOT_UPTIME | NOT_EVIDENCED | UNKNOWN |  | DIAGNOSTIC_ONLY | 1 | CLOCK_SYNC_NOT_EVIDENCED|DEVICE_ID_NOT_CARRIED|RUN_ID_UNRESOLVED | NORMALIZED_ONLY | {} | {"applied_cooling":"OFF","applied_duty_permille":"0","chamber_air_mean_c":"29.958333","chamber_air_status":"ROLE_QUALIFIED_CHAMBER_AIR","cooling_current_a":"0.000000","cooling_energy_counter_wh":"108.000000","cooling_power_w":"0.000000","cooling_voltage_v":"11.950000","device_state":"OFF","door_polarity":"CONFIRMED","door_state":"CLOSED","experiment_phase":"OFF_IDLE","pressure_hpa":"1012.920000","quality.door":"UNKNOWN","quality.electrical":"UNKNOWN","quality.environment":"UNKNOWN","quality.overall":"UNKNOWN","quality.probe.t1":"OK","quality.probe.t2":"OK","quality.probe.t3":"OK","quality.probe.t4":"OK","quality.producer":"DEGRADED","quality.provenance":"VALID","quality.sequence":"VALID","quality.thermal":"VALID","readback_duty_permille":"0","requested_duty_permille":"0","rh_pct":"68.768000","seq":"74","t1_c":"30.062000","t2_c":"29.875000","t3_c":"29.688000","t4_c":"30.125000","t_air_c":"30.623000"}
f6235e23b4513f98:TELEMETRY_SAMPLE:NO_DEVICE_ID:56044b74:75:76:base | TELEMETRY_SAMPLE | PHYSICAL_MEASURED | evidence/A/W09/exports/CG-S1-H8C-600S.json | f6235e23b4513f98ba7c1deb289f4a3d48afd3c0a87d7f38bfe4e67b2fc79feb | w09-run-export/v2 | 76 |  | 56044b74 | run-00000000 | PARTIAL |  |  | 75 | 74894 |  |  |  | DEVICE_BOOT_UPTIME | NOT_EVIDENCED | UNKNOWN |  | DIAGNOSTIC_ONLY | 1 | CLOCK_SYNC_NOT_EVIDENCED|DEVICE_ID_NOT_CARRIED|RUN_ID_UNRESOLVED | NORMALIZED_ONLY | {} | {"applied_cooling":"OFF","applied_duty_permille":"0","chamber_air_mean_c":"29.958000","chamber_air_status":"ROLE_QUALIFIED_CHAMBER_AIR","cooling_current_a":"0.000000","cooling_energy_counter_wh":"108.000000","cooling_power_w":"0.000000","cooling_voltage_v":"11.950000","device_state":"OFF","door_polarity":"CONFIRMED","door_state":"CLOSED","experiment_phase":"OFF_IDLE","pressure_hpa":"1013.050000","quality.door":"UNKNOWN","quality.electrical":"UNKNOWN","quality.environment":"UNKNOWN","quality.overall":"UNKNOWN","quality.probe.t1":"OK","quality.probe.t2":"OK","quality.probe.t3":"OK","quality.probe.t4":"OK","quality.producer":"DEGRADED","quality.provenance":"VALID","quality.sequence":"VALID","quality.thermal":"VALID","readback_duty_permille":"0","requested_duty_permille":"0","rh_pct":"68.774000","seq":"75","t1_c":"30.062000","t2_c":"29.875000","t3_c":"29.750000","t4_c":"30.062000","t_air_c":"30.628000"}
f6235e23b4513f98:TELEMETRY_SAMPLE:NO_DEVICE_ID:56044b74:76:77:base | TELEMETRY_SAMPLE | PHYSICAL_MEASURED | evidence/A/W09/exports/CG-S1-H8C-600S.json | f6235e23b4513f98ba7c1deb289f4a3d48afd3c0a87d7f38bfe4e67b2fc79feb | w09-run-export/v2 | 77 |  | 56044b74 | run-00000000 | PARTIAL |  |  | 76 | 75894 |  |  |  | DEVICE_BOOT_UPTIME | NOT_EVIDENCED | UNKNOWN |  | DIAGNOSTIC_ONLY | 1 | CLOCK_SYNC_NOT_EVIDENCED|DEVICE_ID_NOT_CARRIED|RUN_ID_UNRESOLVED | NORMALIZED_ONLY | {} | {"applied_cooling":"OFF","applied_duty_permille":"0","chamber_air_mean_c":"29.958000","chamber_air_status":"ROLE_QUALIFIED_CHAMBER_AIR","cooling_current_a":"0.000000","cooling_energy_counter_wh":"108.000000","cooling_power_w":"0.000000","cooling_voltage_v":"11.950000","device_state":"OFF","door_polarity":"CONFIRMED","door_state":"CLOSED","experiment_phase":"OFF_IDLE","pressure_hpa":"1013.050000","quality.door":"UNKNOWN","quality.electrical":"UNKNOWN","quality.environment":"UNKNOWN","quality.overall":"UNKNOWN","quality.probe.t1":"OK","quality.probe.t2":"OK","quality.probe.t3":"OK","quality.probe.t4":"OK","quality.producer":"DEGRADED","quality.provenance":"VALID","quality.sequence":"VALID","quality.thermal":"VALID","readback_duty_permille":"0","requested_duty_permille":"0","rh_pct":"68.773000","seq":"76","t1_c":"30.062000","t2_c":"29.875000","t3_c":"29.750000","t4_c":"30.062000","t_air_c":"30.613000"}
f6235e23b4513f98:TELEMETRY_SAMPLE:NO_DEVICE_ID:56044b74:77:78:base | TELEMETRY_SAMPLE | PHYSICAL_MEASURED | evidence/A/W09/exports/CG-S1-H8C-600S.json | f6235e23b4513f98ba7c1deb289f4a3d48afd3c0a87d7f38bfe4e67b2fc79feb | w09-run-export/v2 | 78 |  | 56044b74 | run-00000000 | PARTIAL |  |  | 77 | 76894 |  |  |  | DEVICE_BOOT_UPTIME | NOT_EVIDENCED | UNKNOWN |  | DIAGNOSTIC_ONLY | 1 | CLOCK_SYNC_NOT_EVIDENCED|DEVICE_ID_NOT_CARRIED|RUN_ID_UNRESOLVED | NORMALIZED_ONLY | {} | {"applied_cooling":"OFF","applied_duty_permille":"0","chamber_air_mean_c":"29.958000","chamber_air_status":"ROLE_QUALIFIED_CHAMBER_AIR","cooling_current_a":"0.000000","cooling_energy_counter_wh":"108.000000","cooling_power_w":"0.000000","cooling_voltage_v":"11.950000","device_state":"OFF","door_polarity":"CONFIRMED","door_state":"CLOSED","experiment_phase":"OFF_IDLE","pressure_hpa":"1013.090000","quality.door":"UNKNOWN","quality.electrical":"UNKNOWN","quality.environment":"UNKNOWN","quality.overall":"UNKNOWN","quality.probe.t1":"OK","quality.probe.t2":"OK","quality.probe.t3":"OK","quality.probe.t4":"OK","quality.producer":"DEGRADED","quality.provenance":"VALID","quality.sequence":"VALID","quality.thermal":"VALID","readback_duty_permille":"0","requested_duty_permille":"0","rh_pct":"68.773000","seq":"77","t1_c":"30.062000","t2_c":"29.875000","t3_c":"29.750000","t4_c":"30.062000","t_air_c":"30.618000"}
f6235e23b4513f98:TELEMETRY_SAMPLE:NO_DEVICE_ID:56044b74:78:79:base | TELEMETRY_SAMPLE | PHYSICAL_MEASURED | evidence/A/W09/exports/CG-S1-H8C-600S.json | f6235e23b4513f98ba7c1deb289f4a3d48afd3c0a87d7f38bfe4e67b2fc79feb | w09-run-export/v2 | 79 |  | 56044b74 | run-00000000 | PARTIAL |  |  | 78 | 77894 |  |  |  | DEVICE_BOOT_UPTIME | NOT_EVIDENCED | UNKNOWN |  | DIAGNOSTIC_ONLY | 1 | CLOCK_SYNC_NOT_EVIDENCED|DEVICE_ID_NOT_CARRIED|RUN_ID_UNRESOLVED | NORMALIZED_ONLY | {} | {"applied_cooling":"OFF","applied_duty_permille":"0","chamber_air_mean_c":"29.979000","chamber_air_status":"ROLE_QUALIFIED_CHAMBER_AIR","cooling_current_a":"0.000000","cooling_energy_counter_wh":"108.000000","cooling_power_w":"0.000000","cooling_voltage_v":"11.950000","device_state":"OFF","door_polarity":"CONFIRMED","door_state":"CLOSED","experiment_phase":"OFF_IDLE","pressure_hpa":"1013.070000","quality.door":"UNKNOWN","quality.electrical":"UNKNOWN","quality.environment":"UNKNOWN","quality.overall":"UNKNOWN","quality.probe.t1":"OK","quality.probe.t2":"OK","quality.probe.t3":"OK","quality.probe.t4":"OK","quality.producer":"DEGRADED","quality.provenance":"VALID","quality.sequence":"VALID","quality.thermal":"VALID","readback_duty_permille":"0","requested_duty_permille":"0","rh_pct":"68.773000","seq":"78","t1_c":"30.062000","t2_c":"29.875000","t3_c":"29.750000","t4_c":"30.125000","t_air_c":"30.623000"}
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
