minhqng/predictive-cold-chain-aiot/ml/reports/W06/response-summary-W06.csv

source_path | relationship | state | command_id | anchor_event_id | latency_s | uncertainty_s | evidence_class | independent_application | sample_count | baseline_median | policy_name | reason_codes
backend/fixtures/telemetry_v0.json | ACK_TO_APPLIED_STATE | NOT_ESTIMABLE_MISSING_ANCHOR |  |  |  |  | NOT_ESTIMABLE |  | 0 |  | electrical-current-step-v1 | NO_ANCHOR_EVENT
evidence/A/W09/exports/CG-S1-H8C-600S.json | ACK_TO_APPLIED_STATE | NOT_ESTIMABLE_MISSING_ANCHOR |  |  |  |  | NOT_ESTIMABLE |  | 0 |  | electrical-current-step-v1 | NO_ANCHOR_EVENT
evidence/A/W06/demo-command-capture.log | ACK_TO_APPLIED_STATE | NOT_APPLICABLE_ACK_NOT_ACCEPTED | 00000000-0000-4000-8000-00000000000a | 9a6a47a0119c9303:DEVICE_ACK:coldguard-001:abcd0123:00000000-0000-4000-8000-00000000000a:42:5:base |  |  | SYNTHETIC_UNIT_TEST |  | 0 |  | electrical-current-step-v1 | ACK_STATUS_SAFETY_BLOCKED
evidence/A/W06/demo-command-capture.log | ACK_TO_APPLIED_STATE | NOT_OBSERVED | 00000000-0000-4000-8000-00000000000b | 9a6a47a0119c9303:DEVICE_ACK:coldguard-001:abcd0123:00000000-0000-4000-8000-00000000000b:42:6:base |  |  | SYNTHETIC_UNIT_TEST |  | 0 |  | electrical-current-step-v1 | NO_APPLIED_STATE_EVIDENCE_AFTER_ACCEPTED_ACK
evidence/A/W06/demo-command-capture.log | ACK_TO_APPLIED_STATE | NOT_APPLICABLE_ACK_NOT_ACCEPTED | 00000000-0000-4000-8000-00000000000c | 9a6a47a0119c9303:DEVICE_ACK:coldguard-001:abcd0123:00000000-0000-4000-8000-00000000000c:42:7:base |  |  | SYNTHETIC_UNIT_TEST |  | 0 |  | electrical-current-step-v1 | ACK_STATUS_EXPIRED
evidence/A/W06/demo-command-capture.log | ACK_TO_APPLIED_STATE | NOT_APPLICABLE_ACK_NOT_ACCEPTED | 00000000-0000-4000-8000-00000000000d | 9a6a47a0119c9303:DEVICE_ACK:coldguard-001:abcd0123:00000000-0000-4000-8000-00000000000d:42:8:base |  |  | SYNTHETIC_UNIT_TEST |  | 0 |  | electrical-current-step-v1 | ACK_STATUS_REJECTED
evidence/A/W06/demo-command-capture.log | ACK_TO_APPLIED_STATE | DUPLICATE_CANONICAL_NOT_AN_APPLICATION | 00000000-0000-4000-8000-00000000000e | 9a6a47a0119c9303:DEVICE_ACK:coldguard-001:abcd0123:00000000-0000-4000-8000-00000000000e:42:9:base |  |  | SYNTHETIC_UNIT_TEST | False | 0 |  | electrical-current-step-v1 | DUPLICATE_CANONICAL_DOES_NOT_COUNT_AS_ANOTHER_APPLICATION
ml/tests/fixtures/W06/qualified-response.json | ACK_TO_APPLIED_STATE | OBSERVED_DIAGNOSTIC_ONLY | CMD-QUALIFIED | ack-1 | 0.3 | 0.05 | SYNTHETIC_UNIT_TEST | True | 2 |  | electrical-current-step-v1
backend/fixtures/telemetry_v0.json | APPLIED_TO_ELECTRICAL | NOT_ESTIMABLE_MISSING_ANCHOR |  |  |  |  | NOT_ESTIMABLE |  | 0 |  | electrical-current-step-v1 | NO_ANCHOR_EVENT
evidence/A/W06/demo-command-capture.log | APPLIED_TO_ELECTRICAL | NOT_ESTIMABLE_MISSING_ANCHOR |  |  |  |  | NOT_ESTIMABLE |  | 0 |  | electrical-current-step-v1 | NO_ANCHOR_EVENT
evidence/A/W09/exports/CG-S1-H8C-600S.json | APPLIED_TO_ELECTRICAL | NOT_ESTIMABLE_QUALITY |  | f6235e23b4513f98:APPLIED_STATE:NO_DEVICE_ID:56044b74:227:228:applied |  |  | NOT_ESTIMABLE |  | 0 |  | electrical-current-step-v1 | BASELINE_QUALITY_NOT_VALID
evidence/A/W09/exports/CG-S1-H8C-600S.json | APPLIED_TO_ELECTRICAL | NOT_ESTIMABLE_QUALITY |  | f6235e23b4513f98:APPLIED_STATE:NO_DEVICE_ID:56044b74:832:833:applied |  |  | NOT_ESTIMABLE |  | 0 |  | electrical-current-step-v1 | BASELINE_QUALITY_NOT_VALID
ml/tests/fixtures/W06/qualified-response.json | APPLIED_TO_ELECTRICAL | OBSERVED_DIAGNOSTIC_ONLY | CMD-QUALIFIED | applied-1 | 0.2 | 0.05 | SYNTHETIC_UNIT_TEST |  | 3 | 0.0 | electrical-current-step-v1 | SYNTHETIC_UNIT_TEST_EVIDENCE
backend/fixtures/telemetry_v0.json | APPLIED_TO_THERMAL | NOT_ESTIMABLE_MISSING_ANCHOR |  |  |  |  | NOT_ESTIMABLE |  | 0 |  | electrical-current-step-v1 | NO_ANCHOR_EVENT
evidence/A/W06/demo-command-capture.log | APPLIED_TO_THERMAL | NOT_ESTIMABLE_MISSING_ANCHOR |  |  |  |  | NOT_ESTIMABLE |  | 0 |  | electrical-current-step-v1 | NO_ANCHOR_EVENT
evidence/A/W09/exports/CG-S1-H8C-600S.json | APPLIED_TO_THERMAL | OBSERVED_DIAGNOSTIC_ONLY |  | f6235e23b4513f98:APPLIED_STATE:NO_DEVICE_ID:56044b74:227:228:applied |  | 1.0 | PHYSICAL_MEASURED |  | 3 | 30.020667 | chamber-air-temperature-step-v1 | ANCHOR_QUALITY_NOT_VALID_DIAGNOSTIC_ONLY
evidence/A/W09/exports/CG-S1-H8C-600S.json | APPLIED_TO_THERMAL | OBSERVED_DIAGNOSTIC_ONLY |  | f6235e23b4513f98:APPLIED_STATE:NO_DEVICE_ID:56044b74:832:833:applied |  | 6.0 | PHYSICAL_MEASURED |  | 3 | 21.312667 | chamber-air-temperature-step-v1 | ANCHOR_QUALITY_NOT_VALID_DIAGNOSTIC_ONLY
ml/tests/fixtures/W06/qualified-response.json | APPLIED_TO_THERMAL | OBSERVED_DIAGNOSTIC_ONLY | CMD-QUALIFIED | applied-1 | 0.3 | 0.05 | SYNTHETIC_UNIT_TEST |  | 3 | 25.0 | chamber-air-temperature-step-v1 | SYNTHETIC_UNIT_TEST_EVIDENCE
backend/fixtures/telemetry_v0.json | COMMAND_TO_ACK | NOT_ESTIMABLE_MISSING_ANCHOR |  |  |  |  | NOT_ESTIMABLE |  | 0 |  | electrical-current-step-v1 | NO_ANCHOR_EVENT
evidence/A/W09/exports/CG-S1-H8C-600S.json | COMMAND_TO_ACK | NOT_ESTIMABLE_MISSING_ANCHOR |  |  |  |  | NOT_ESTIMABLE |  | 0 |  | electrical-current-step-v1 | NO_ANCHOR_EVENT
evidence/A/W06/demo-command-capture.log | COMMAND_TO_ACK | NOT_ESTIMABLE_MISSING_ANCHOR | 00000000-0000-4000-8000-00000000000a | 9a6a47a0119c9303:DEVICE_ACK:coldguard-001:abcd0123:00000000-0000-4000-8000-00000000000a:42:5:base |  |  | NOT_ESTIMABLE |  | 1 |  | electrical-current-step-v1 | ACK_RELATIVE_LATENCY_IS_NOT_COMMAND_PUBLICATION_LATENCY|NO_COMMAND_PUBLICATION_EVENT
evidence/A/W06/demo-command-capture.log | COMMAND_TO_ACK | NOT_ESTIMABLE_MISSING_ANCHOR | 00000000-0000-4000-8000-00000000000b | 9a6a47a0119c9303:DEVICE_ACK:coldguard-001:abcd0123:00000000-0000-4000-8000-00000000000b:42:6:base |  |  | NOT_ESTIMABLE |  | 1 |  | electrical-current-step-v1 | ACK_RELATIVE_LATENCY_IS_NOT_COMMAND_PUBLICATION_LATENCY|NO_COMMAND_PUBLICATION_EVENT
evidence/A/W06/demo-command-capture.log | COMMAND_TO_ACK | NOT_ESTIMABLE_MISSING_ANCHOR | 00000000-0000-4000-8000-00000000000c | 9a6a47a0119c9303:DEVICE_ACK:coldguard-001:abcd0123:00000000-0000-4000-8000-00000000000c:42:7:base |  |  | NOT_ESTIMABLE |  | 1 |  | electrical-current-step-v1 | ACK_RELATIVE_LATENCY_IS_NOT_COMMAND_PUBLICATION_LATENCY|NO_COMMAND_PUBLICATION_EVENT
evidence/A/W06/demo-command-capture.log | COMMAND_TO_ACK | NOT_ESTIMABLE_MISSING_ANCHOR | 00000000-0000-4000-8000-00000000000d | 9a6a47a0119c9303:DEVICE_ACK:coldguard-001:abcd0123:00000000-0000-4000-8000-00000000000d:42:8:base |  |  | NOT_ESTIMABLE |  | 1 |  | electrical-current-step-v1 | ACK_RELATIVE_LATENCY_IS_NOT_COMMAND_PUBLICATION_LATENCY|NO_COMMAND_PUBLICATION_EVENT
evidence/A/W06/demo-command-capture.log | COMMAND_TO_ACK | NOT_ESTIMABLE_MISSING_ANCHOR | 00000000-0000-4000-8000-00000000000e | 9a6a47a0119c9303:DEVICE_ACK:coldguard-001:abcd0123:00000000-0000-4000-8000-00000000000e:42:9:base |  |  | NOT_ESTIMABLE |  | 1 |  | electrical-current-step-v1 | ACK_RELATIVE_LATENCY_IS_NOT_COMMAND_PUBLICATION_LATENCY|NO_COMMAND_PUBLICATION_EVENT
ml/tests/fixtures/W06/qualified-response.json | COMMAND_TO_ACK | OBSERVED_DIAGNOSTIC_ONLY | CMD-QUALIFIED | cmd-publish | 0.2 | 0.05 | SYNTHETIC_UNIT_TEST |  | 2 |  | electrical-current-step-v1 | SYNTHETIC_UNIT_TEST_EVIDENCE
backend/fixtures/telemetry_v0.json | COMMAND_TO_ELECTRICAL | NOT_ESTIMABLE_MISSING_ANCHOR |  |  |  |  | NOT_ESTIMABLE |  | 0 |  | electrical-current-step-v1 | NO_ANCHOR_EVENT
evidence/A/W06/demo-command-capture.log | COMMAND_TO_ELECTRICAL | NOT_ESTIMABLE_MISSING_ANCHOR |  |  |  |  | NOT_ESTIMABLE |  | 0 |  | electrical-current-step-v1 | NO_ANCHOR_EVENT
evidence/A/W09/exports/CG-S1-H8C-600S.json | COMMAND_TO_ELECTRICAL | NOT_ESTIMABLE_MISSING_ANCHOR |  |  |  |  | NOT_ESTIMABLE |  | 0 |  | electrical-current-step-v1 | NO_ANCHOR_EVENT
ml/tests/fixtures/W06/qualified-response.json | COMMAND_TO_ELECTRICAL | OBSERVED_DIAGNOSTIC_ONLY | CMD-QUALIFIED | cmd-publish | 0.7 | 0.05 | SYNTHETIC_UNIT_TEST |  | 3 | 0.0 | electrical-current-step-v1 | SYNTHETIC_UNIT_TEST_EVIDENCE
backend/fixtures/telemetry_v0.json | COMMAND_TO_THERMAL | NOT_ESTIMABLE_MISSING_ANCHOR |  |  |  |  | NOT_ESTIMABLE |  | 0 |  | electrical-current-step-v1 | NO_ANCHOR_EVENT
evidence/A/W06/demo-command-capture.log | COMMAND_TO_THERMAL | NOT_ESTIMABLE_MISSING_ANCHOR |  |  |  |  | NOT_ESTIMABLE |  | 0 |  | electrical-current-step-v1 | NO_ANCHOR_EVENT
evidence/A/W09/exports/CG-S1-H8C-600S.json | COMMAND_TO_THERMAL | NOT_ESTIMABLE_MISSING_ANCHOR |  |  |  |  | NOT_ESTIMABLE |  | 0 |  | electrical-current-step-v1 | NO_ANCHOR_EVENT
ml/tests/fixtures/W06/qualified-response.json | COMMAND_TO_THERMAL | OBSERVED_DIAGNOSTIC_ONLY | CMD-QUALIFIED | cmd-publish | 0.8 | 0.05 | SYNTHETIC_UNIT_TEST |  | 3 | 25.0 | chamber-air-temperature-step-v1 | SYNTHETIC_UNIT_TEST_EVIDENCE
