minhqng/predictive-cold-chain-aiot/ml/reports/W08/run-validation-W08.csv

source_path | source_sha256 | physical_source_key | run_id | device_id | boot_id | scenario_id | hardware_config_id | hardware_config_status | calibration_id | calibration_status | time_domain | clock_sync_status | a_ledger_verdict | admission_status | admission_highest_stage | b_eligibility | anchor_present | whole_capture_completeness | critical_channel_completeness | event_window_completeness | baseline_completeness | recovery_completeness | timing_alignment_status | blocking_checks | reason_codes
evidence/A/W09/exports/CG-S1-H8C-600S.json | f6235e23b4513f98ba7c1deb289f4a3d48afd3c0a87d7f38bfe4e67b2fc79feb | session|56044b74 |  |  | 56044b74 | S1 | CG-HW-001 | DECLARED_NOT_VERIFIED |  | NOT_AVAILABLE | BOOT_SCOPED_UPTIME | NOT_EVIDENCED | INVALID | EXCLUDED_OR_BLOCKED | USABLE_FOR_DIAGNOSTIC_QA | BLOCKED | NOT_APPLICABLE | NOT_EVALUABLE | NOT_EVALUABLE | NOT_APPLICABLE | NOT_APPLICABLE | NOT_APPLICABLE | NOT_EVALUABLE | RUN_IDENTITY_CARRIED;DEVICE_IDENTITY_CARRIED;RUN_MANIFEST_LINKED;CAPTURE_DURATION_DECLARED;A_LEDGER_VERDICT;A_SCENARIO_SCOPE_GRANTED;HARDWARE_CONFIG_VERIFIED;CALIBRATION_VERIFIED;ABSOLUTE_TIME_FOR_CLAIM;TIMING_INTEGRITY | ABSOLUTE_TIME_NOT_EVIDENCED;AUTHORITY_A_LEDGER_INVALID;CALIBRATION_UNVERIFIED;CAPTURE_DURATION_NOT_DECLARED;DEVICE_IDENTITY_MISSING;HARDWARE_CONFIG_NOT_VERIFIED;RUN_IDENTITY_UNRESOLVED;RUN_MANIFEST_LINKAGE_NOT_PROVIDED;SCENARIO_VALIDITY_NOT_GRANTED;TIMING_INTEGRITY_FAILED
