minhqng/predictive-cold-chain-aiot/evidence/A/W12/dataset-validity.csv

capture | intended_hardware_config | evidence_derived_config_identity | physical_session_identity | configuration_evidence | reference_valid | evidence_reviewed | authorized_provenance_valid | config_verification | verification_open_items | is_probe_identification | role_verdict | electrical_qualification | dataset_pooling_eligibility
tec-cooling-response-600s.csv | CG-HW-001 | config:image=01cedce3b794638f25ae4c7f1e2dfdcb4b00555fdc81a0bcf4d35ed4187f6c9f|limits=APPROVED | 56044b74 | installed_image_identity=met;physical_inspection_reference_valid=missing;probe_role_labels=missing;role_map_consistent_with_freeze=met;sensor_rom_readback=missing | False | False | False | UNVERIFIED | DS18B20 ROM identities read back from the devices, not copied from the configuration table;probe role labels asserted by the capture itself for every frozen slot (t1, t2, t3, t4);a dated, repository-resolvable physical inspection record naming this configuration - reference validity only, not evidence that anyone reviewed it;EVIDENCE_REVIEWED: a named person must bind this inspection record by recomputed content hash and cover every inspected aspect (currently: empty or placeholder reference);AUTHORIZED_PROVENANCE: an approval traceable outside the host tooling is required (currently: no approval record was supplied) | False | CONSISTENT_WITH_FREEZE | UNQUALIFIED | config:image=01cedce3b794638f25ae4c7f1e2dfdcb4b00555fdc81a0bcf4d35ed4187f6c9f|limits=APPROVED;CONSISTENT_WITH_FREEZE;UNQUALIFIED
