minhqng/predictive-cold-chain-aiot/ml/reports/W10/label-pilot-W10.csv

population | horizon_s | status | eligible_s2_runs | spec_version | spec_identity | independent_development_runs | dependent_window_count | positive_labels | negative_labels | censored_labels | untrusted_labels | positive_prevalence | feature_available_anchors | feature_values_present | feature_values_total | freeze_status | coverage_limitations
SYNTHETIC_DEVELOPMENT | 30.0 | DEVELOPMENT_ONLY |  | coldguard-w10-label-pilot-v1 | {"boundary_c": null, "frozen_at": null, "horizon_s": 30.0, "representative_temperature": "DEVELOPMENT_CANDIDATE_NOT_SELECTED", "spec_version": "coldguard-w10-label-pilot-v1"} | 4 | 484 | 60 | 304 | 120 | 0 | 0.16483516483516483 | 484 | 12746 | 15004 | DEVELOPMENT_ONLY_NOT_FROZEN | development partitions only; the locked test partition is not used; censored horizons are not negatives; critical event series is a prescribed synthetic fixture; no physical authority; boundary, representative temperature and primary horizon remain unfrozen
SYNTHETIC_DEVELOPMENT | 60.0 | DEVELOPMENT_ONLY |  | coldguard-w10-label-pilot-v1 | {"boundary_c": null, "frozen_at": null, "horizon_s": 60.0, "representative_temperature": "DEVELOPMENT_CANDIDATE_NOT_SELECTED", "spec_version": "coldguard-w10-label-pilot-v1"} | 4 | 484 | 120 | 162 | 202 | 0 | 0.425531914893617 | 484 | 12746 | 15004 | DEVELOPMENT_ONLY_NOT_FROZEN | development partitions only; the locked test partition is not used; censored horizons are not negatives; critical event series is a prescribed synthetic fixture; no physical authority; boundary, representative temperature and primary horizon remain unfrozen
SYNTHETIC_DEVELOPMENT | 120.0 | DEVELOPMENT_ONLY |  | coldguard-w10-label-pilot-v1 | {"boundary_c": null, "frozen_at": null, "horizon_s": 120.0, "representative_temperature": "DEVELOPMENT_CANDIDATE_NOT_SELECTED", "spec_version": "coldguard-w10-label-pilot-v1"} | 4 | 484 | 160 | 2 | 322 | 0 | 0.9876543209876543 | 484 | 12746 | 15004 | DEVELOPMENT_ONLY_NOT_FROZEN | development partitions only; the locked test partition is not used; censored horizons are not negatives; critical event series is a prescribed synthetic fixture; no physical authority; boundary, representative temperature and primary horizon remain unfrozen
SYNTHETIC_DEVELOPMENT | 300.0 | DEVELOPMENT_ONLY |  | coldguard-w10-label-pilot-v1 | {"boundary_c": null, "frozen_at": null, "horizon_s": 300.0, "representative_temperature": "DEVELOPMENT_CANDIDATE_NOT_SELECTED", "spec_version": "coldguard-w10-label-pilot-v1"} | 4 | 484 | 160 | 0 | 324 | 0 | 1.0 | 484 | 12746 | 15004 | DEVELOPMENT_ONLY_NOT_FROZEN | development partitions only; the locked test partition is not used; censored horizons are not negatives; critical event series is a prescribed synthetic fixture; no physical authority; boundary, representative temperature and primary horizon remain unfrozen
REAL_S2 |  | NOT_EVALUABLE | 0 |  |  | 0 | 0 | 0 | 0 | 0 | 0 |  | 0 | 0 | 0 | NOT_FROZEN | Gate B is RED, no eligible S2 run exists and no authoritative critical-event series is available for the real capture
