minhqng/predictive-cold-chain-aiot/ml/reports/W13/horizon-metrics.csv

row_type | population | horizon_s | method | fold_id | evaluable_samples | positive_count | negative_count | positive_prevalence | censored_exclusions | untrusted_exclusions | average_precision | ap_status | ap_reason | event_recall | false_warning_episodes_per_hour | missed_critical_events | unmatched_warnings | ewt_status | ewt_reason_code | aiw_status | aiw_reason_code | undefined_reasons | scientific_claim_status | provenance
HORIZON_LABELS | SYNTHETIC_DEVELOPMENT | 30.0 | ALL | ALL | 2416 | 240 | 2176 | 0.09933774834437085 | 480 | 0 |  |  |  |  |  |  |  | NOT_ESTIMABLE | EWT_UNAVAILABLE_NO_QUALIFIED_COMMON_TRAJECTORY | NOT_ESTIMABLE | AIW_UNAVAILABLE_MEASURED_LATENCY_CHAIN_MISSING |  | SYNTHETIC_SOFTWARE_CONTROL_ONLY | W11_EXPANDED_SYNTHETIC_GROUPED
METHOD_FOLD | SYNTHETIC_DEVELOPMENT | 30.0 | B0_THRESHOLD | F1 |  |  |  |  |  |  | 0.4057788028561846 | DEFINED |  | 1.0 | 0.0 | 0 | 0 | NOT_ESTIMABLE | EWT_UNAVAILABLE_NO_QUALIFIED_COMMON_TRAJECTORY | NOT_ESTIMABLE | AIW_UNAVAILABLE_MEASURED_LATENCY_CHAIN_MISSING |  | SYNTHETIC_SOFTWARE_CONTROL_ONLY | W11_EXPANDED_SYNTHETIC_GROUPED
METHOD_FOLD | SYNTHETIC_DEVELOPMENT | 30.0 | B1_HYSTERESIS | F1 |  |  |  |  |  |  | 0.31746031746031744 | DEFINED |  | 1.0 | 0.0 | 0 | 0 | NOT_ESTIMABLE | EWT_UNAVAILABLE_NO_QUALIFIED_COMMON_TRAJECTORY | NOT_ESTIMABLE | AIW_UNAVAILABLE_MEASURED_LATENCY_CHAIN_MISSING |  | SYNTHETIC_SOFTWARE_CONTROL_ONLY | W11_EXPANDED_SYNTHETIC_GROUPED
METHOD_FOLD | SYNTHETIC_DEVELOPMENT | 30.0 | B0_THRESHOLD | F2 |  |  |  |  |  |  | 0.40594627287199814 | DEFINED |  | 1.0 | 0.0 | 0 | 0 | NOT_ESTIMABLE | EWT_UNAVAILABLE_NO_QUALIFIED_COMMON_TRAJECTORY | NOT_ESTIMABLE | AIW_UNAVAILABLE_MEASURED_LATENCY_CHAIN_MISSING |  | SYNTHETIC_SOFTWARE_CONTROL_ONLY | W11_EXPANDED_SYNTHETIC_GROUPED
METHOD_FOLD | SYNTHETIC_DEVELOPMENT | 30.0 | B1_HYSTERESIS | F2 |  |  |  |  |  |  | 0.29850746268656714 | DEFINED |  | 1.0 | 0.0 | 0 | 0 | NOT_ESTIMABLE | EWT_UNAVAILABLE_NO_QUALIFIED_COMMON_TRAJECTORY | NOT_ESTIMABLE | AIW_UNAVAILABLE_MEASURED_LATENCY_CHAIN_MISSING |  | SYNTHETIC_SOFTWARE_CONTROL_ONLY | W11_EXPANDED_SYNTHETIC_GROUPED
METHOD_FOLD | SYNTHETIC_DEVELOPMENT | 30.0 | B0_THRESHOLD | F3 |  |  |  |  |  |  | 0.4061734952402616 | DEFINED |  | 1.0 | 0.0 | 0 | 0 | NOT_ESTIMABLE | EWT_UNAVAILABLE_NO_QUALIFIED_COMMON_TRAJECTORY | NOT_ESTIMABLE | AIW_UNAVAILABLE_MEASURED_LATENCY_CHAIN_MISSING |  | SYNTHETIC_SOFTWARE_CONTROL_ONLY | W11_EXPANDED_SYNTHETIC_GROUPED
METHOD_FOLD | SYNTHETIC_DEVELOPMENT | 30.0 | B1_HYSTERESIS | F3 |  |  |  |  |  |  | 0.35294117647058826 | DEFINED |  | 1.0 | 0.0 | 0 | 0 | NOT_ESTIMABLE | EWT_UNAVAILABLE_NO_QUALIFIED_COMMON_TRAJECTORY | NOT_ESTIMABLE | AIW_UNAVAILABLE_MEASURED_LATENCY_CHAIN_MISSING |  | SYNTHETIC_SOFTWARE_CONTROL_ONLY | W11_EXPANDED_SYNTHETIC_GROUPED
METHOD_FOLD | SYNTHETIC_DEVELOPMENT | 30.0 | B0_THRESHOLD | F4 |  |  |  |  |  |  | 0.40703289078546895 | DEFINED |  | 1.0 | 0.0 | 0 | 0 | NOT_ESTIMABLE | EWT_UNAVAILABLE_NO_QUALIFIED_COMMON_TRAJECTORY | NOT_ESTIMABLE | AIW_UNAVAILABLE_MEASURED_LATENCY_CHAIN_MISSING |  | SYNTHETIC_SOFTWARE_CONTROL_ONLY | W11_EXPANDED_SYNTHETIC_GROUPED
METHOD_FOLD | SYNTHETIC_DEVELOPMENT | 30.0 | B1_HYSTERESIS | F4 |  |  |  |  |  |  | 0.30927835051546393 | DEFINED |  | 1.0 | 0.0 | 0 | 0 | NOT_ESTIMABLE | EWT_UNAVAILABLE_NO_QUALIFIED_COMMON_TRAJECTORY | NOT_ESTIMABLE | AIW_UNAVAILABLE_MEASURED_LATENCY_CHAIN_MISSING |  | SYNTHETIC_SOFTWARE_CONTROL_ONLY | W11_EXPANDED_SYNTHETIC_GROUPED
METHOD_FOLD | SYNTHETIC_DEVELOPMENT | 30.0 | UNWEIGHTED | F1 |  |  |  |  |  |  | 1.0 | DEFINED |  | 1.0 | 0.0 | 0 | 0 | NOT_ESTIMABLE | EWT_UNAVAILABLE_NO_QUALIFIED_COMMON_TRAJECTORY | NOT_ESTIMABLE | AIW_UNAVAILABLE_MEASURED_LATENCY_CHAIN_MISSING |  | SYNTHETIC_SOFTWARE_CONTROL_ONLY | W11_EXPANDED_SYNTHETIC_GROUPED
METHOD_FOLD | SYNTHETIC_DEVELOPMENT | 30.0 | UNWEIGHTED | F2 |  |  |  |  |  |  | 1.0 | DEFINED |  | 1.0 | 0.0 | 0 | 0 | NOT_ESTIMABLE | EWT_UNAVAILABLE_NO_QUALIFIED_COMMON_TRAJECTORY | NOT_ESTIMABLE | AIW_UNAVAILABLE_MEASURED_LATENCY_CHAIN_MISSING |  | SYNTHETIC_SOFTWARE_CONTROL_ONLY | W11_EXPANDED_SYNTHETIC_GROUPED
METHOD_FOLD | SYNTHETIC_DEVELOPMENT | 30.0 | UNWEIGHTED | F3 |  |  |  |  |  |  | 1.0 | DEFINED |  | 1.0 | 0.0 | 0 | 0 | NOT_ESTIMABLE | EWT_UNAVAILABLE_NO_QUALIFIED_COMMON_TRAJECTORY | NOT_ESTIMABLE | AIW_UNAVAILABLE_MEASURED_LATENCY_CHAIN_MISSING |  | SYNTHETIC_SOFTWARE_CONTROL_ONLY | W11_EXPANDED_SYNTHETIC_GROUPED
METHOD_FOLD | SYNTHETIC_DEVELOPMENT | 30.0 | UNWEIGHTED | F4 |  |  |  |  |  |  | 1.0 | DEFINED |  | 1.0 | 0.0 | 0 | 0 | NOT_ESTIMABLE | EWT_UNAVAILABLE_NO_QUALIFIED_COMMON_TRAJECTORY | NOT_ESTIMABLE | AIW_UNAVAILABLE_MEASURED_LATENCY_CHAIN_MISSING |  | SYNTHETIC_SOFTWARE_CONTROL_ONLY | W11_EXPANDED_SYNTHETIC_GROUPED
METHOD_FOLD | SYNTHETIC_DEVELOPMENT | 30.0 | TRAIN_FOLD_CLASS_WEIGHT | F1 |  |  |  |  |  |  | 1.0 | DEFINED |  | 1.0 | 0.0 | 0 | 0 | NOT_ESTIMABLE | EWT_UNAVAILABLE_NO_QUALIFIED_COMMON_TRAJECTORY | NOT_ESTIMABLE | AIW_UNAVAILABLE_MEASURED_LATENCY_CHAIN_MISSING |  | SYNTHETIC_SOFTWARE_CONTROL_ONLY | W11_EXPANDED_SYNTHETIC_GROUPED
METHOD_FOLD | SYNTHETIC_DEVELOPMENT | 30.0 | TRAIN_FOLD_CLASS_WEIGHT | F2 |  |  |  |  |  |  | 1.0 | DEFINED |  | 1.0 | 0.0 | 0 | 0 | NOT_ESTIMABLE | EWT_UNAVAILABLE_NO_QUALIFIED_COMMON_TRAJECTORY | NOT_ESTIMABLE | AIW_UNAVAILABLE_MEASURED_LATENCY_CHAIN_MISSING |  | SYNTHETIC_SOFTWARE_CONTROL_ONLY | W11_EXPANDED_SYNTHETIC_GROUPED
METHOD_FOLD | SYNTHETIC_DEVELOPMENT | 30.0 | TRAIN_FOLD_CLASS_WEIGHT | F3 |  |  |  |  |  |  | 1.0 | DEFINED |  | 1.0 | 0.0 | 0 | 0 | NOT_ESTIMABLE | EWT_UNAVAILABLE_NO_QUALIFIED_COMMON_TRAJECTORY | NOT_ESTIMABLE | AIW_UNAVAILABLE_MEASURED_LATENCY_CHAIN_MISSING |  | SYNTHETIC_SOFTWARE_CONTROL_ONLY | W11_EXPANDED_SYNTHETIC_GROUPED
METHOD_FOLD | SYNTHETIC_DEVELOPMENT | 30.0 | TRAIN_FOLD_CLASS_WEIGHT | F4 |  |  |  |  |  |  | 1.0 | DEFINED |  | 1.0 | 0.0 | 0 | 0 | NOT_ESTIMABLE | EWT_UNAVAILABLE_NO_QUALIFIED_COMMON_TRAJECTORY | NOT_ESTIMABLE | AIW_UNAVAILABLE_MEASURED_LATENCY_CHAIN_MISSING |  | SYNTHETIC_SOFTWARE_CONTROL_ONLY | W11_EXPANDED_SYNTHETIC_GROUPED
HORIZON_LABELS | SYNTHETIC_DEVELOPMENT | 60.0 | ALL | ALL | 1936 | 480 | 1456 | 0.24793388429752067 | 960 | 0 |  |  |  |  |  |  |  | NOT_ESTIMABLE | EWT_UNAVAILABLE_NO_QUALIFIED_COMMON_TRAJECTORY | NOT_ESTIMABLE | AIW_UNAVAILABLE_MEASURED_LATENCY_CHAIN_MISSING |  | SYNTHETIC_SOFTWARE_CONTROL_ONLY | W11_EXPANDED_SYNTHETIC_GROUPED
METHOD_FOLD | SYNTHETIC_DEVELOPMENT | 60.0 | B0_THRESHOLD | F1 |  |  |  |  |  |  | 0.9873537338021915 | DEFINED |  | 1.0 | 0.0 | 0 | 0 | NOT_ESTIMABLE | EWT_UNAVAILABLE_NO_QUALIFIED_COMMON_TRAJECTORY | NOT_ESTIMABLE | AIW_UNAVAILABLE_MEASURED_LATENCY_CHAIN_MISSING |  | SYNTHETIC_SOFTWARE_CONTROL_ONLY | W11_EXPANDED_SYNTHETIC_GROUPED
METHOD_FOLD | SYNTHETIC_DEVELOPMENT | 60.0 | B1_HYSTERESIS | F1 |  |  |  |  |  |  | 0.6896734726948631 | DEFINED |  | 1.0 | 0.0 | 0 | 0 | NOT_ESTIMABLE | EWT_UNAVAILABLE_NO_QUALIFIED_COMMON_TRAJECTORY | NOT_ESTIMABLE | AIW_UNAVAILABLE_MEASURED_LATENCY_CHAIN_MISSING |  | SYNTHETIC_SOFTWARE_CONTROL_ONLY | W11_EXPANDED_SYNTHETIC_GROUPED
METHOD_FOLD | SYNTHETIC_DEVELOPMENT | 60.0 | B0_THRESHOLD | F2 |  |  |  |  |  |  | 0.9885531289507862 | DEFINED |  | 1.0 | 0.0 | 0 | 0 | NOT_ESTIMABLE | EWT_UNAVAILABLE_NO_QUALIFIED_COMMON_TRAJECTORY | NOT_ESTIMABLE | AIW_UNAVAILABLE_MEASURED_LATENCY_CHAIN_MISSING |  | SYNTHETIC_SOFTWARE_CONTROL_ONLY | W11_EXPANDED_SYNTHETIC_GROUPED
METHOD_FOLD | SYNTHETIC_DEVELOPMENT | 60.0 | B1_HYSTERESIS | F2 |  |  |  |  |  |  | 0.6953168044077135 | DEFINED |  | 1.0 | 0.0 | 0 | 0 | NOT_ESTIMABLE | EWT_UNAVAILABLE_NO_QUALIFIED_COMMON_TRAJECTORY | NOT_ESTIMABLE | AIW_UNAVAILABLE_MEASURED_LATENCY_CHAIN_MISSING |  | SYNTHETIC_SOFTWARE_CONTROL_ONLY | W11_EXPANDED_SYNTHETIC_GROUPED
METHOD_FOLD | SYNTHETIC_DEVELOPMENT | 60.0 | B0_THRESHOLD | F3 |  |  |  |  |  |  | 0.9889339340833572 | DEFINED |  | 1.0 | 0.0 | 0 | 0 | NOT_ESTIMABLE | EWT_UNAVAILABLE_NO_QUALIFIED_COMMON_TRAJECTORY | NOT_ESTIMABLE | AIW_UNAVAILABLE_MEASURED_LATENCY_CHAIN_MISSING |  | SYNTHETIC_SOFTWARE_CONTROL_ONLY | W11_EXPANDED_SYNTHETIC_GROUPED
METHOD_FOLD | SYNTHETIC_DEVELOPMENT | 60.0 | B1_HYSTERESIS | F3 |  |  |  |  |  |  | 0.6840383500072496 | DEFINED |  | 1.0 | 0.0 | 0 | 0 | NOT_ESTIMABLE | EWT_UNAVAILABLE_NO_QUALIFIED_COMMON_TRAJECTORY | NOT_ESTIMABLE | AIW_UNAVAILABLE_MEASURED_LATENCY_CHAIN_MISSING |  | SYNTHETIC_SOFTWARE_CONTROL_ONLY | W11_EXPANDED_SYNTHETIC_GROUPED
METHOD_FOLD | SYNTHETIC_DEVELOPMENT | 60.0 | B0_THRESHOLD | F4 |  |  |  |  |  |  | 0.9890604309018636 | DEFINED |  | 1.0 | 0.0 | 0 | 0 | NOT_ESTIMABLE | EWT_UNAVAILABLE_NO_QUALIFIED_COMMON_TRAJECTORY | NOT_ESTIMABLE | AIW_UNAVAILABLE_MEASURED_LATENCY_CHAIN_MISSING |  | SYNTHETIC_SOFTWARE_CONTROL_ONLY | W11_EXPANDED_SYNTHETIC_GROUPED
METHOD_FOLD | SYNTHETIC_DEVELOPMENT | 60.0 | B1_HYSTERESIS | F4 |  |  |  |  |  |  | 0.6953168044077135 | DEFINED |  | 1.0 | 0.0 | 0 | 0 | NOT_ESTIMABLE | EWT_UNAVAILABLE_NO_QUALIFIED_COMMON_TRAJECTORY | NOT_ESTIMABLE | AIW_UNAVAILABLE_MEASURED_LATENCY_CHAIN_MISSING |  | SYNTHETIC_SOFTWARE_CONTROL_ONLY | W11_EXPANDED_SYNTHETIC_GROUPED
METHOD_FOLD | SYNTHETIC_DEVELOPMENT | 60.0 | UNWEIGHTED | F1 |  |  |  |  |  |  | 1.0 | DEFINED |  | 1.0 | 0.0 | 0 | 0 | NOT_ESTIMABLE | EWT_UNAVAILABLE_NO_QUALIFIED_COMMON_TRAJECTORY | NOT_ESTIMABLE | AIW_UNAVAILABLE_MEASURED_LATENCY_CHAIN_MISSING |  | SYNTHETIC_SOFTWARE_CONTROL_ONLY | W11_EXPANDED_SYNTHETIC_GROUPED
METHOD_FOLD | SYNTHETIC_DEVELOPMENT | 60.0 | UNWEIGHTED | F2 |  |  |  |  |  |  | 1.0 | DEFINED |  | 1.0 | 0.0 | 0 | 0 | NOT_ESTIMABLE | EWT_UNAVAILABLE_NO_QUALIFIED_COMMON_TRAJECTORY | NOT_ESTIMABLE | AIW_UNAVAILABLE_MEASURED_LATENCY_CHAIN_MISSING |  | SYNTHETIC_SOFTWARE_CONTROL_ONLY | W11_EXPANDED_SYNTHETIC_GROUPED
METHOD_FOLD | SYNTHETIC_DEVELOPMENT | 60.0 | UNWEIGHTED | F3 |  |  |  |  |  |  | 1.0 | DEFINED |  | 1.0 | 0.0 | 0 | 0 | NOT_ESTIMABLE | EWT_UNAVAILABLE_NO_QUALIFIED_COMMON_TRAJECTORY | NOT_ESTIMABLE | AIW_UNAVAILABLE_MEASURED_LATENCY_CHAIN_MISSING |  | SYNTHETIC_SOFTWARE_CONTROL_ONLY | W11_EXPANDED_SYNTHETIC_GROUPED
METHOD_FOLD | SYNTHETIC_DEVELOPMENT | 60.0 | UNWEIGHTED | F4 |  |  |  |  |  |  | 1.0 | DEFINED |  | 1.0 | 0.0 | 0 | 0 | NOT_ESTIMABLE | EWT_UNAVAILABLE_NO_QUALIFIED_COMMON_TRAJECTORY | NOT_ESTIMABLE | AIW_UNAVAILABLE_MEASURED_LATENCY_CHAIN_MISSING |  | SYNTHETIC_SOFTWARE_CONTROL_ONLY | W11_EXPANDED_SYNTHETIC_GROUPED
METHOD_FOLD | SYNTHETIC_DEVELOPMENT | 60.0 | TRAIN_FOLD_CLASS_WEIGHT | F1 |  |  |  |  |  |  | 1.0 | DEFINED |  | 1.0 | 0.0 | 0 | 0 | NOT_ESTIMABLE | EWT_UNAVAILABLE_NO_QUALIFIED_COMMON_TRAJECTORY | NOT_ESTIMABLE | AIW_UNAVAILABLE_MEASURED_LATENCY_CHAIN_MISSING |  | SYNTHETIC_SOFTWARE_CONTROL_ONLY | W11_EXPANDED_SYNTHETIC_GROUPED
METHOD_FOLD | SYNTHETIC_DEVELOPMENT | 60.0 | TRAIN_FOLD_CLASS_WEIGHT | F2 |  |  |  |  |  |  | 1.0 | DEFINED |  | 1.0 | 0.0 | 0 | 0 | NOT_ESTIMABLE | EWT_UNAVAILABLE_NO_QUALIFIED_COMMON_TRAJECTORY | NOT_ESTIMABLE | AIW_UNAVAILABLE_MEASURED_LATENCY_CHAIN_MISSING |  | SYNTHETIC_SOFTWARE_CONTROL_ONLY | W11_EXPANDED_SYNTHETIC_GROUPED
METHOD_FOLD | SYNTHETIC_DEVELOPMENT | 60.0 | TRAIN_FOLD_CLASS_WEIGHT | F3 |  |  |  |  |  |  | 1.0 | DEFINED |  | 1.0 | 0.0 | 0 | 0 | NOT_ESTIMABLE | EWT_UNAVAILABLE_NO_QUALIFIED_COMMON_TRAJECTORY | NOT_ESTIMABLE | AIW_UNAVAILABLE_MEASURED_LATENCY_CHAIN_MISSING |  | SYNTHETIC_SOFTWARE_CONTROL_ONLY | W11_EXPANDED_SYNTHETIC_GROUPED
METHOD_FOLD | SYNTHETIC_DEVELOPMENT | 60.0 | TRAIN_FOLD_CLASS_WEIGHT | F4 |  |  |  |  |  |  | 1.0 | DEFINED |  | 1.0 | 0.0 | 0 | 0 | NOT_ESTIMABLE | EWT_UNAVAILABLE_NO_QUALIFIED_COMMON_TRAJECTORY | NOT_ESTIMABLE | AIW_UNAVAILABLE_MEASURED_LATENCY_CHAIN_MISSING |  | SYNTHETIC_SOFTWARE_CONTROL_ONLY | W11_EXPANDED_SYNTHETIC_GROUPED
HORIZON_LABELS | SYNTHETIC_DEVELOPMENT | 120.0 | ALL | ALL | 1288 | 800 | 488 | 0.6211180124223602 | 1608 | 0 |  |  |  |  |  |  |  | NOT_ESTIMABLE | EWT_UNAVAILABLE_NO_QUALIFIED_COMMON_TRAJECTORY | NOT_ESTIMABLE | AIW_UNAVAILABLE_MEASURED_LATENCY_CHAIN_MISSING |  | SYNTHETIC_SOFTWARE_CONTROL_ONLY | W11_EXPANDED_SYNTHETIC_GROUPED
METHOD_FOLD | SYNTHETIC_DEVELOPMENT | 120.0 | B0_THRESHOLD | F1 |  |  |  |  |  |  | 0.9433766728168205 | DEFINED |  |  | 22.641509433962263 | 0 | 2 | NOT_ESTIMABLE | EWT_UNAVAILABLE_NO_QUALIFIED_COMMON_TRAJECTORY | NOT_ESTIMABLE | AIW_UNAVAILABLE_MEASURED_LATENCY_CHAIN_MISSING | NO_ELIGIBLE_CRITICAL_EVENTS | SYNTHETIC_SOFTWARE_CONTROL_ONLY | W11_EXPANDED_SYNTHETIC_GROUPED
METHOD_FOLD | SYNTHETIC_DEVELOPMENT | 120.0 | B1_HYSTERESIS | F1 |  |  |  |  |  |  | 0.8313975155279503 | DEFINED |  |  | 22.641509433962263 | 0 | 2 | NOT_ESTIMABLE | EWT_UNAVAILABLE_NO_QUALIFIED_COMMON_TRAJECTORY | NOT_ESTIMABLE | AIW_UNAVAILABLE_MEASURED_LATENCY_CHAIN_MISSING | NO_ELIGIBLE_CRITICAL_EVENTS | SYNTHETIC_SOFTWARE_CONTROL_ONLY | W11_EXPANDED_SYNTHETIC_GROUPED
METHOD_FOLD | SYNTHETIC_DEVELOPMENT | 120.0 | B0_THRESHOLD | F2 |  |  |  |  |  |  | 0.9341312189092313 | DEFINED |  |  | 22.641509433962263 | 0 | 2 | NOT_ESTIMABLE | EWT_UNAVAILABLE_NO_QUALIFIED_COMMON_TRAJECTORY | NOT_ESTIMABLE | AIW_UNAVAILABLE_MEASURED_LATENCY_CHAIN_MISSING | NO_ELIGIBLE_CRITICAL_EVENTS | SYNTHETIC_SOFTWARE_CONTROL_ONLY | W11_EXPANDED_SYNTHETIC_GROUPED
METHOD_FOLD | SYNTHETIC_DEVELOPMENT | 120.0 | B1_HYSTERESIS | F2 |  |  |  |  |  |  | 0.8332919254658385 | DEFINED |  |  | 22.641509433962263 | 0 | 2 | NOT_ESTIMABLE | EWT_UNAVAILABLE_NO_QUALIFIED_COMMON_TRAJECTORY | NOT_ESTIMABLE | AIW_UNAVAILABLE_MEASURED_LATENCY_CHAIN_MISSING | NO_ELIGIBLE_CRITICAL_EVENTS | SYNTHETIC_SOFTWARE_CONTROL_ONLY | W11_EXPANDED_SYNTHETIC_GROUPED
METHOD_FOLD | SYNTHETIC_DEVELOPMENT | 120.0 | B0_THRESHOLD | F3 |  |  |  |  |  |  | 0.8594594916011251 | DEFINED |  |  | 22.641509433962263 | 0 | 2 | NOT_ESTIMABLE | EWT_UNAVAILABLE_NO_QUALIFIED_COMMON_TRAJECTORY | NOT_ESTIMABLE | AIW_UNAVAILABLE_MEASURED_LATENCY_CHAIN_MISSING | NO_ELIGIBLE_CRITICAL_EVENTS | SYNTHETIC_SOFTWARE_CONTROL_ONLY | W11_EXPANDED_SYNTHETIC_GROUPED
METHOD_FOLD | SYNTHETIC_DEVELOPMENT | 120.0 | B1_HYSTERESIS | F3 |  |  |  |  |  |  | 0.8295031055900621 | DEFINED |  |  | 22.641509433962263 | 0 | 2 | NOT_ESTIMABLE | EWT_UNAVAILABLE_NO_QUALIFIED_COMMON_TRAJECTORY | NOT_ESTIMABLE | AIW_UNAVAILABLE_MEASURED_LATENCY_CHAIN_MISSING | NO_ELIGIBLE_CRITICAL_EVENTS | SYNTHETIC_SOFTWARE_CONTROL_ONLY | W11_EXPANDED_SYNTHETIC_GROUPED
METHOD_FOLD | SYNTHETIC_DEVELOPMENT | 120.0 | B0_THRESHOLD | F4 |  |  |  |  |  |  | 0.8595331868505174 | DEFINED |  |  | 22.641509433962263 | 0 | 2 | NOT_ESTIMABLE | EWT_UNAVAILABLE_NO_QUALIFIED_COMMON_TRAJECTORY | NOT_ESTIMABLE | AIW_UNAVAILABLE_MEASURED_LATENCY_CHAIN_MISSING | NO_ELIGIBLE_CRITICAL_EVENTS | SYNTHETIC_SOFTWARE_CONTROL_ONLY | W11_EXPANDED_SYNTHETIC_GROUPED
METHOD_FOLD | SYNTHETIC_DEVELOPMENT | 120.0 | B1_HYSTERESIS | F4 |  |  |  |  |  |  | 0.8332919254658385 | DEFINED |  |  | 22.641509433962263 | 0 | 2 | NOT_ESTIMABLE | EWT_UNAVAILABLE_NO_QUALIFIED_COMMON_TRAJECTORY | NOT_ESTIMABLE | AIW_UNAVAILABLE_MEASURED_LATENCY_CHAIN_MISSING | NO_ELIGIBLE_CRITICAL_EVENTS | SYNTHETIC_SOFTWARE_CONTROL_ONLY | W11_EXPANDED_SYNTHETIC_GROUPED
METHOD_FOLD | SYNTHETIC_DEVELOPMENT | 120.0 | UNWEIGHTED | F1 |  |  |  |  |  |  | 0.9046518284044316 | DEFINED |  |  | 45.283018867924525 | 0 | 4 | NOT_ESTIMABLE | EWT_UNAVAILABLE_NO_QUALIFIED_COMMON_TRAJECTORY | NOT_ESTIMABLE | AIW_UNAVAILABLE_MEASURED_LATENCY_CHAIN_MISSING | NO_ELIGIBLE_CRITICAL_EVENTS | SYNTHETIC_SOFTWARE_CONTROL_ONLY | W11_EXPANDED_SYNTHETIC_GROUPED
METHOD_FOLD | SYNTHETIC_DEVELOPMENT | 120.0 | UNWEIGHTED | F2 |  |  |  |  |  |  | 0.9022402631785451 | DEFINED |  |  | 33.9622641509434 | 0 | 3 | NOT_ESTIMABLE | EWT_UNAVAILABLE_NO_QUALIFIED_COMMON_TRAJECTORY | NOT_ESTIMABLE | AIW_UNAVAILABLE_MEASURED_LATENCY_CHAIN_MISSING | NO_ELIGIBLE_CRITICAL_EVENTS | SYNTHETIC_SOFTWARE_CONTROL_ONLY | W11_EXPANDED_SYNTHETIC_GROUPED
METHOD_FOLD | SYNTHETIC_DEVELOPMENT | 120.0 | UNWEIGHTED | F3 |  |  |  |  |  |  | 0.8776706757809121 | DEFINED |  |  | 67.9245283018868 | 0 | 6 | NOT_ESTIMABLE | EWT_UNAVAILABLE_NO_QUALIFIED_COMMON_TRAJECTORY | NOT_ESTIMABLE | AIW_UNAVAILABLE_MEASURED_LATENCY_CHAIN_MISSING | NO_ELIGIBLE_CRITICAL_EVENTS | SYNTHETIC_SOFTWARE_CONTROL_ONLY | W11_EXPANDED_SYNTHETIC_GROUPED
METHOD_FOLD | SYNTHETIC_DEVELOPMENT | 120.0 | UNWEIGHTED | F4 |  |  |  |  |  |  | 0.885109424647602 | DEFINED |  |  | 56.60377358490566 | 0 | 5 | NOT_ESTIMABLE | EWT_UNAVAILABLE_NO_QUALIFIED_COMMON_TRAJECTORY | NOT_ESTIMABLE | AIW_UNAVAILABLE_MEASURED_LATENCY_CHAIN_MISSING | NO_ELIGIBLE_CRITICAL_EVENTS | SYNTHETIC_SOFTWARE_CONTROL_ONLY | W11_EXPANDED_SYNTHETIC_GROUPED
METHOD_FOLD | SYNTHETIC_DEVELOPMENT | 120.0 | TRAIN_FOLD_CLASS_WEIGHT | F1 |  |  |  |  |  |  | 0.9046518284044316 | DEFINED |  |  | 45.283018867924525 | 0 | 4 | NOT_ESTIMABLE | EWT_UNAVAILABLE_NO_QUALIFIED_COMMON_TRAJECTORY | NOT_ESTIMABLE | AIW_UNAVAILABLE_MEASURED_LATENCY_CHAIN_MISSING | NO_ELIGIBLE_CRITICAL_EVENTS | SYNTHETIC_SOFTWARE_CONTROL_ONLY | W11_EXPANDED_SYNTHETIC_GROUPED
METHOD_FOLD | SYNTHETIC_DEVELOPMENT | 120.0 | TRAIN_FOLD_CLASS_WEIGHT | F2 |  |  |  |  |  |  | 0.9022402631785451 | DEFINED |  |  | 33.9622641509434 | 0 | 3 | NOT_ESTIMABLE | EWT_UNAVAILABLE_NO_QUALIFIED_COMMON_TRAJECTORY | NOT_ESTIMABLE | AIW_UNAVAILABLE_MEASURED_LATENCY_CHAIN_MISSING | NO_ELIGIBLE_CRITICAL_EVENTS | SYNTHETIC_SOFTWARE_CONTROL_ONLY | W11_EXPANDED_SYNTHETIC_GROUPED
METHOD_FOLD | SYNTHETIC_DEVELOPMENT | 120.0 | TRAIN_FOLD_CLASS_WEIGHT | F3 |  |  |  |  |  |  | 0.8776706757809121 | DEFINED |  |  | 22.641509433962263 | 0 | 2 | NOT_ESTIMABLE | EWT_UNAVAILABLE_NO_QUALIFIED_COMMON_TRAJECTORY | NOT_ESTIMABLE | AIW_UNAVAILABLE_MEASURED_LATENCY_CHAIN_MISSING | NO_ELIGIBLE_CRITICAL_EVENTS | SYNTHETIC_SOFTWARE_CONTROL_ONLY | W11_EXPANDED_SYNTHETIC_GROUPED
METHOD_FOLD | SYNTHETIC_DEVELOPMENT | 120.0 | TRAIN_FOLD_CLASS_WEIGHT | F4 |  |  |  |  |  |  | 0.885109424647602 | DEFINED |  |  | 45.283018867924525 | 0 | 4 | NOT_ESTIMABLE | EWT_UNAVAILABLE_NO_QUALIFIED_COMMON_TRAJECTORY | NOT_ESTIMABLE | AIW_UNAVAILABLE_MEASURED_LATENCY_CHAIN_MISSING | NO_ELIGIBLE_CRITICAL_EVENTS | SYNTHETIC_SOFTWARE_CONTROL_ONLY | W11_EXPANDED_SYNTHETIC_GROUPED
HORIZON_LABELS | SYNTHETIC_DEVELOPMENT | 300.0 | ALL | ALL | 800 | 800 | 0 | 1.0 | 2096 | 0 |  |  |  |  |  |  |  | NOT_ESTIMABLE | EWT_UNAVAILABLE_NO_QUALIFIED_COMMON_TRAJECTORY | NOT_ESTIMABLE | AIW_UNAVAILABLE_MEASURED_LATENCY_CHAIN_MISSING | W13_HORIZON_NOT_ESTIMABLE: the label configuration leaves 8 of 16 runs with zero evaluable anchors; the shared W11 grouped benchmark refuses that declared population deterministically (DEV_RUN_WITHOUT_EVALUABLE_ANCHORS) instead of dropping a run, so the horizon is not estimable under the frozen benchmark contract; the remaining evaluable population is 800 positive and 0 negative, which is single-class, so AP and event metrics stay undefined | SYNTHETIC_SOFTWARE_CONTROL_ONLY | W11_EXPANDED_SYNTHETIC_GROUPED
REAL_REFUSAL | REAL_PHYSICAL | 30.0 | ALL | ALL | 0 |  |  |  |  |  |  | NOT_ESTIMABLE | EVENT_UTC_UNAVAILABLE_DEVICE_HAS_NO_WALL_CLOCK;HOST_RECEIPT_TIME_IS_NOT_PHYSICAL_EVENT_TIME;CLOCK_SYNC_NOT_EVIDENCED_IN_PACKAGE;RUN_IDENTITY_UNRESOLVED_FOR_CG_RUN_PATTERN;CALIBRATION_TRACEABILITY_ABSENT_FROM_PACKAGE_SCHEMA;SEGMENTS_SHARE_BOOTS_ROWS_ARE_NOT_INDEPENDENT_RUNS;CRITICAL_CRITERION_AND_REPRESENTATIVE_T_NOT_FROZEN |  |  |  |  | NOT_ESTIMABLE | NO_ELIGIBLE_REAL_PREDICTIVE_RUNS | NOT_ESTIMABLE | DOOR_CRITICAL_NOT_COMPUTABLE_AND_LATENCY_CHAIN_MISSING | EVENT_UTC_UNAVAILABLE_DEVICE_HAS_NO_WALL_CLOCK;HOST_RECEIPT_TIME_IS_NOT_PHYSICAL_EVENT_TIME;CLOCK_SYNC_NOT_EVIDENCED_IN_PACKAGE;RUN_IDENTITY_UNRESOLVED_FOR_CG_RUN_PATTERN;CALIBRATION_TRACEABILITY_ABSENT_FROM_PACKAGE_SCHEMA;SEGMENTS_SHARE_BOOTS_ROWS_ARE_NOT_INDEPENDENT_RUNS;CRITICAL_CRITERION_AND_REPRESENTATIVE_T_NOT_FROZEN | REAL_METRICS_NOT_ESTIMABLE | origin/main@d22c8d5b1fb3c05d8a9732ed0087d8e76b9f9e85
REAL_REFUSAL | REAL_PHYSICAL | 60.0 | ALL | ALL | 0 |  |  |  |  |  |  | NOT_ESTIMABLE | EVENT_UTC_UNAVAILABLE_DEVICE_HAS_NO_WALL_CLOCK;HOST_RECEIPT_TIME_IS_NOT_PHYSICAL_EVENT_TIME;CLOCK_SYNC_NOT_EVIDENCED_IN_PACKAGE;RUN_IDENTITY_UNRESOLVED_FOR_CG_RUN_PATTERN;CALIBRATION_TRACEABILITY_ABSENT_FROM_PACKAGE_SCHEMA;SEGMENTS_SHARE_BOOTS_ROWS_ARE_NOT_INDEPENDENT_RUNS;CRITICAL_CRITERION_AND_REPRESENTATIVE_T_NOT_FROZEN |  |  |  |  | NOT_ESTIMABLE | NO_ELIGIBLE_REAL_PREDICTIVE_RUNS | NOT_ESTIMABLE | DOOR_CRITICAL_NOT_COMPUTABLE_AND_LATENCY_CHAIN_MISSING | EVENT_UTC_UNAVAILABLE_DEVICE_HAS_NO_WALL_CLOCK;HOST_RECEIPT_TIME_IS_NOT_PHYSICAL_EVENT_TIME;CLOCK_SYNC_NOT_EVIDENCED_IN_PACKAGE;RUN_IDENTITY_UNRESOLVED_FOR_CG_RUN_PATTERN;CALIBRATION_TRACEABILITY_ABSENT_FROM_PACKAGE_SCHEMA;SEGMENTS_SHARE_BOOTS_ROWS_ARE_NOT_INDEPENDENT_RUNS;CRITICAL_CRITERION_AND_REPRESENTATIVE_T_NOT_FROZEN | REAL_METRICS_NOT_ESTIMABLE | origin/main@d22c8d5b1fb3c05d8a9732ed0087d8e76b9f9e85
REAL_REFUSAL | REAL_PHYSICAL | 120.0 | ALL | ALL | 0 |  |  |  |  |  |  | NOT_ESTIMABLE | EVENT_UTC_UNAVAILABLE_DEVICE_HAS_NO_WALL_CLOCK;HOST_RECEIPT_TIME_IS_NOT_PHYSICAL_EVENT_TIME;CLOCK_SYNC_NOT_EVIDENCED_IN_PACKAGE;RUN_IDENTITY_UNRESOLVED_FOR_CG_RUN_PATTERN;CALIBRATION_TRACEABILITY_ABSENT_FROM_PACKAGE_SCHEMA;SEGMENTS_SHARE_BOOTS_ROWS_ARE_NOT_INDEPENDENT_RUNS;CRITICAL_CRITERION_AND_REPRESENTATIVE_T_NOT_FROZEN |  |  |  |  | NOT_ESTIMABLE | NO_ELIGIBLE_REAL_PREDICTIVE_RUNS | NOT_ESTIMABLE | DOOR_CRITICAL_NOT_COMPUTABLE_AND_LATENCY_CHAIN_MISSING | EVENT_UTC_UNAVAILABLE_DEVICE_HAS_NO_WALL_CLOCK;HOST_RECEIPT_TIME_IS_NOT_PHYSICAL_EVENT_TIME;CLOCK_SYNC_NOT_EVIDENCED_IN_PACKAGE;RUN_IDENTITY_UNRESOLVED_FOR_CG_RUN_PATTERN;CALIBRATION_TRACEABILITY_ABSENT_FROM_PACKAGE_SCHEMA;SEGMENTS_SHARE_BOOTS_ROWS_ARE_NOT_INDEPENDENT_RUNS;CRITICAL_CRITERION_AND_REPRESENTATIVE_T_NOT_FROZEN | REAL_METRICS_NOT_ESTIMABLE | origin/main@d22c8d5b1fb3c05d8a9732ed0087d8e76b9f9e85
REAL_REFUSAL | REAL_PHYSICAL | 300.0 | ALL | ALL | 0 |  |  |  |  |  |  | NOT_ESTIMABLE | EVENT_UTC_UNAVAILABLE_DEVICE_HAS_NO_WALL_CLOCK;HOST_RECEIPT_TIME_IS_NOT_PHYSICAL_EVENT_TIME;CLOCK_SYNC_NOT_EVIDENCED_IN_PACKAGE;RUN_IDENTITY_UNRESOLVED_FOR_CG_RUN_PATTERN;CALIBRATION_TRACEABILITY_ABSENT_FROM_PACKAGE_SCHEMA;SEGMENTS_SHARE_BOOTS_ROWS_ARE_NOT_INDEPENDENT_RUNS;CRITICAL_CRITERION_AND_REPRESENTATIVE_T_NOT_FROZEN |  |  |  |  | NOT_ESTIMABLE | NO_ELIGIBLE_REAL_PREDICTIVE_RUNS | NOT_ESTIMABLE | DOOR_CRITICAL_NOT_COMPUTABLE_AND_LATENCY_CHAIN_MISSING | EVENT_UTC_UNAVAILABLE_DEVICE_HAS_NO_WALL_CLOCK;HOST_RECEIPT_TIME_IS_NOT_PHYSICAL_EVENT_TIME;CLOCK_SYNC_NOT_EVIDENCED_IN_PACKAGE;RUN_IDENTITY_UNRESOLVED_FOR_CG_RUN_PATTERN;CALIBRATION_TRACEABILITY_ABSENT_FROM_PACKAGE_SCHEMA;SEGMENTS_SHARE_BOOTS_ROWS_ARE_NOT_INDEPENDENT_RUNS;CRITICAL_CRITERION_AND_REPRESENTATIVE_T_NOT_FROZEN | REAL_METRICS_NOT_ESTIMABLE | origin/main@d22c8d5b1fb3c05d8a9732ed0087d8e76b9f9e85
