minhqng/predictive-cold-chain-aiot/docs/owner-integration/source-sync/source-sync-matrix.csv

member | week | pr | remote_head_sha | local_sha | remote_base_sha | ancestry | source_tested_sha | local_status | data_status | contract_status | tests | required_action
A | 1 | #7 | 7d03512d2c82050816268bb2446348bb3dff41a7 | 7d03512d2c82050816268bb2446348bb3dff41a7 | main | merged to main | 7d03512d2c82050816268bb2446348bb3dff41a7 | ALREADY_MERGED | ALREADY_MERGED | TESTED_ON_CORRECT_SHA | validate_wXX PASS on base evidence | none
A | 2 | #8 | 07a87b1feb52395c09d9d3318c293ce75a65f339 | 07a87b1feb52395c09d9d3318c293ce75a65f339 | main | merged to main | 07a87b1feb52395c09d9d3318c293ce75a65f339 | ALREADY_MERGED | ALREADY_MERGED | TESTED_ON_CORRECT_SHA | validate_wXX PASS on base evidence | none
A | 3 | #9 | 0d350a57874d53f9b48bfd6b639eae0f50e6f450 | 0d350a57874d53f9b48bfd6b639eae0f50e6f450 | main | merged to main | 0d350a57874d53f9b48bfd6b639eae0f50e6f450 | ALREADY_MERGED | ALREADY_MERGED | TESTED_ON_CORRECT_SHA | validate_wXX PASS on base evidence | none
A | 4 | #13 | 9841799b3387774eeb46d82b9fa1f0220f4d22be | 9841799b3387774eeb46d82b9fa1f0220f4d22be | main | merged to main | 9841799b3387774eeb46d82b9fa1f0220f4d22be | ALREADY_MERGED | ALREADY_MERGED | TESTED_ON_CORRECT_SHA | validate_wXX PASS on base evidence | none
A | 5 | A#94/#95 open remediation | d22c8d5b | n/a | main | in main via merged series | d22c8d5b | NO_SEPARATE_PR_FOUND | ALREADY_MERGED | TESTED_ON_CORRECT_SHA | dossier validators PASS | merge #94/#95
A | 6 | integration merges #91-93 | d22c8d5b | n/a | main | in main via merged series | d22c8d5b | NO_SEPARATE_PR_FOUND | ALREADY_MERGED | TESTED_ON_CORRECT_SHA | dossier validators PASS | merge #94/#95
A | 7 | integration merges #91-93 | d22c8d5b | n/a | main | in main via merged series | d22c8d5b | NO_SEPARATE_PR_FOUND | ALREADY_MERGED | TESTED_ON_CORRECT_SHA | dossier validators PASS | merge #94/#95
A | 8 | integration merges #91-93 | d22c8d5b | n/a | main | in main via merged series | d22c8d5b | NO_SEPARATE_PR_FOUND | ALREADY_MERGED | TESTED_ON_CORRECT_SHA | dossier validators PASS | merge #94/#95
A | 9 | integration merges #91-93 | d22c8d5b | n/a | main | in main via merged series | d22c8d5b | NO_SEPARATE_PR_FOUND | ALREADY_MERGED | TESTED_ON_CORRECT_SHA | dossier validators PASS | merge #94/#95
A | 10 | integration merges #91-93 | d22c8d5b | n/a | main | in main via merged series | d22c8d5b | NO_SEPARATE_PR_FOUND | ALREADY_MERGED | TESTED_ON_CORRECT_SHA | dossier validators PASS | merge #94/#95
A | 11 | integration merges #91-93 | d22c8d5b | n/a | main | in main via merged series | d22c8d5b | NO_SEPARATE_PR_FOUND | ALREADY_MERGED | TESTED_ON_CORRECT_SHA | dossier validators PASS | merge #94/#95
A | 12 | #77 | 7a07c260443d2d1eca9a48bb17483c95070250c2 | 7a07c260443d2d1eca9a48bb17483c95070250c2 | main | merged to main | 7a07c260443d2d1eca9a48bb17483c95070250c2 | ALREADY_MERGED | ALREADY_MERGED | TESTED_ON_CORRECT_SHA | validate_wXX PASS on base evidence | none
A | 13 | integration merges #91-93 | d22c8d5b | n/a | main | in main via merged series | d22c8d5b | NO_SEPARATE_PR_FOUND | ALREADY_MERGED | TESTED_ON_CORRECT_SHA | dossier validators PASS | merge #94/#95
B | 1 | merged #42 b-pre-w04-contract-intake; no own weekly PR | n/a | n/a | main | via #42 merged | d22c8d5b | NO_SEPARATE_PR_FOUND | ALREADY_MERGED | TESTED_ON_CORRECT_SHA | admission contract in main | none
B | 2 | merged #42 b-pre-w04-contract-intake; no own weekly PR | n/a | n/a | main | via #42 merged | d22c8d5b | NO_SEPARATE_PR_FOUND | ALREADY_MERGED | TESTED_ON_CORRECT_SHA | admission contract in main | none
B | 3 | merged #42 b-pre-w04-contract-intake; no own weekly PR | n/a | n/a | main | via #42 merged | d22c8d5b | NO_SEPARATE_PR_FOUND | ALREADY_MERGED | TESTED_ON_CORRECT_SHA | admission contract in main | none
B | 4 | #43 | 481aee7309685751f5f47ba0774e15d44bcd3cb0 | in 824a5389 tree only | main | ancestor in #102 stack | 824a5389 | TESTED_VIA_W13_HEAD_TREE | n/a | TESTED_VIA_W13_HEAD_TREE | B full suite on real head covers the stack | merge with #102 stack
B | 5 | #46 | 30227409e9685ef21db422f59f5fa93b63aab11c | in 824a5389 tree only | feat/b-w04-analysis-contract | ancestor in #102 stack | 824a5389 | TESTED_VIA_W13_HEAD_TREE | n/a | TESTED_VIA_W13_HEAD_TREE | B full suite on real head covers the stack | merge with #102 stack
B | 6 | #48 | bfd0a288a36730f7461ca3b21e678ff692e54915 | in 824a5389 tree only | feat/b-w05-real-data-qa | ancestor in #102 stack | 824a5389 | TESTED_VIA_W13_HEAD_TREE | n/a | TESTED_VIA_W13_HEAD_TREE | B full suite on real head covers the stack | merge with #102 stack
B | 7 | #49 | 739fbfed3960f9868a1c3447e1b8a75580e5563e | in 824a5389 tree only | feat/b-w06-timing-event-alignment | ancestor in #102 stack | 824a5389 | TESTED_VIA_W13_HEAD_TREE | n/a | TESTED_VIA_W13_HEAD_TREE | B full suite on real head covers the stack | merge with #102 stack
B | 8 | #50 | 36a5aab063409f3b8e47a790ed82ddac10645e82 | in 824a5389 tree only | feat/b-w07-plant-eda-repeatability | ancestor in #102 stack | 824a5389 | TESTED_VIA_W13_HEAD_TREE | n/a | TESTED_VIA_W13_HEAD_TREE | B full suite on real head covers the stack | merge with #102 stack
B | 9 | #52 | 7e1b9333a28063ccd76a47e0465ae2287873a58e | in 824a5389 tree only | feat/b-w08-gate-b-readiness | ancestor in #102 stack | 824a5389 | TESTED_VIA_W13_HEAD_TREE | n/a | TESTED_VIA_W13_HEAD_TREE | B full suite on real head covers the stack | merge with #102 stack
B | 10 | #54 | 884f2908895646948b114ae5f3ef8937c20e6b83 | in 824a5389 tree only | feat/b-w09-deterministic-baselines | ancestor in #102 stack | 824a5389 | TESTED_VIA_W13_HEAD_TREE | n/a | TESTED_VIA_W13_HEAD_TREE | B full suite on real head covers the stack | merge with #102 stack
B | 11 | #58 | 1c49ffc46ab74494bc3146d1212bf45cb74261e9 | in 824a5389 tree only | feat/b-w10-causal-feature-pipeline | ancestor in #102 stack | 824a5389 | TESTED_VIA_W13_HEAD_TREE | n/a | TESTED_VIA_W13_HEAD_TREE | B full suite on real head covers the stack | merge with #102 stack
B | 12 | #59 | 34435bdba8b4b98d418233ef3c07975deea36a1e | in 824a5389 tree only | feat/b-w11-grouped-xgboost-benchmark | ancestor in #102 stack | 824a5389 | TESTED_VIA_W13_HEAD_TREE | n/a | TESTED_VIA_W13_HEAD_TREE | B full suite on real head covers the stack | merge with #102 stack
B | 13 | #102 | 824a5389c29ade0e56ecef7ef21eb35c2a379a7b | 824a5389 snapshot (sha-pinned tarball) | feat/b-w12 @34435bd | stack b-w04..b-w12 (#43..#59) | 824a5389 | SNAPSHOT_ACQUIRED_AND_TESTED | A 20261107 pinned dataset (sha f028441d verified by B suite) | TESTED_ON_CORRECT_SHA | B ml full suite 835 PASS on real head; horizon suite 32/32 with pinned A dataset | ship with stack
C | 1 | c-w01..w04: merged #47 into non-main base; line outside main/#69 ancestry | see #47 | remote-tracking only | non-main | outside main ancestry | d22c8d5b | DIVERGED | n/a | NOT_VERIFIED | not in main nor in #69 stack | member confirmation
C | 2 | c-w01..w04: merged #47 into non-main base; line outside main/#69 ancestry | see #47 | remote-tracking only | non-main | outside main ancestry | d22c8d5b | DIVERGED | n/a | NOT_VERIFIED | not in main nor in #69 stack | member confirmation
C | 3 | c-w01..w04: merged #47 into non-main base; line outside main/#69 ancestry | see #47 | remote-tracking only | non-main | outside main ancestry | d22c8d5b | DIVERGED | n/a | NOT_VERIFIED | not in main nor in #69 stack | member confirmation
C | 4 | c-w01..w04: merged #47 into non-main base; line outside main/#69 ancestry | see #47 | remote-tracking only | non-main | outside main ancestry | d22c8d5b | DIVERGED | n/a | NOT_VERIFIED | not in main nor in #69 stack | member confirmation
C | 5 | #60 | 85cd2bfa8584d7a61936078fcbf3316908077a3c | not standalone in local store | main | ancestor in #69 stack | 361e732 | TESTED_VIA_W13_HEAD_TREE | n/a | TESTED_VIA_W13_HEAD_TREE | #69 tree carries the stack | merge with #69 stack
C | 6 | #61 | 929967f74bb938021405cf87e2dfcc3c239103f7 | not standalone in local store | feat/c-w05-telemetry-platform | ancestor in #69 stack | 361e732 | TESTED_VIA_W13_HEAD_TREE | n/a | TESTED_VIA_W13_HEAD_TREE | #69 tree carries the stack | merge with #69 stack
C | 7 | #62 | af49690586f0aaa465c77534c64a91bc9118360e | not standalone in local store | feat/c-w06-command-lifecycle | ancestor in #69 stack | 361e732 | TESTED_VIA_W13_HEAD_TREE | n/a | TESTED_VIA_W13_HEAD_TREE | #69 tree carries the stack | merge with #69 stack
C | 8 | #63 | b5e970337d9535c9d06a81aeb662b02da3828c65 | not standalone in local store | feat/c-w07-experiment-runs | ancestor in #69 stack | 361e732 | TESTED_VIA_W13_HEAD_TREE | n/a | TESTED_VIA_W13_HEAD_TREE | #69 tree carries the stack | merge with #69 stack
C | 9 | #64 | 2d196ad2c1625082fd4fdeda4939ba49ba1b1600 | not standalone in local store | feat/c-w08-platform-resilience | ancestor in #69 stack | 361e732 | TESTED_VIA_W13_HEAD_TREE | n/a | TESTED_VIA_W13_HEAD_TREE | #69 tree carries the stack | merge with #69 stack
C | 10 | #65 | 362d214f674df58afe700fc865b8a4dedb81f1e6 | not standalone in local store | feat/c-w09-reproducible-export | ancestor in #69 stack | 361e732 | TESTED_VIA_W13_HEAD_TREE | n/a | TESTED_VIA_W13_HEAD_TREE | #69 tree carries the stack | merge with #69 stack
C | 11 | #66 | fb00867ce38df4fcec40f9aed991b3110ffdd5aa | not standalone in local store | feat/c-w10-event-timeline | ancestor in #69 stack | 361e732 | TESTED_VIA_W13_HEAD_TREE | n/a | TESTED_VIA_W13_HEAD_TREE | #69 tree carries the stack | merge with #69 stack
C | 12 | #68 | a2eb4fc63307bee036bbc791287c5d994833413b | not standalone in local store | feat/c-w11-replay-resilience | ancestor in #69 stack | 361e732 | TESTED_VIA_W13_HEAD_TREE | n/a | TESTED_VIA_W13_HEAD_TREE | #69 tree carries the stack | merge with #69 stack
C | 13 | #69 | 361e73246a3a6746a39a7e2769dffdfb7b1ce486 | 361e732 local object (SHA verified) | feat/c-w12 @a2eb4fc | stack c-w05..c-w12 (#60..#68) | 361e732 | SOURCE_PRESENT | n/a | TESTED_ON_CORRECT_SHA | CommandAck 5/5 via model_validate; ack_consumer=SKIP_INFRA | merge with stack
D | 1 | no own PR; control package enters main via base | n/a | n/a | main | base control package | d22c8d5b | NO_SEPARATE_PR_FOUND | ALREADY_MERGED | TESTED_ON_CORRECT_SHA | control suites at base 330 PASS | none
D | 2 | no own PR; control package enters main via base | n/a | n/a | main | base control package | d22c8d5b | NO_SEPARATE_PR_FOUND | ALREADY_MERGED | TESTED_ON_CORRECT_SHA | control suites at base 330 PASS | none
D | 3 | no own PR; control package enters main via base | n/a | n/a | main | base control package | d22c8d5b | NO_SEPARATE_PR_FOUND | ALREADY_MERGED | TESTED_ON_CORRECT_SHA | control suites at base 330 PASS | none
D | 4 | #81 | a9326e1b713d2f04f76c1fe2b4934291efdfbbf0 | not standalone in local store | main | ancestor in #90 stack | da82109 | TESTED_VIA_W13_HEAD_TREE | n/a | TESTED_VIA_W13_HEAD_TREE | #90 tree carries the stack | merge with #90 stack
D | 5 | #82 | 605bab92228a9c27a5bd5ac989dae18c22cb82cf | not standalone in local store | feat/d-w04-command-ttl-safety | ancestor in #90 stack | da82109 | TESTED_VIA_W13_HEAD_TREE | n/a | TESTED_VIA_W13_HEAD_TREE | #90 tree carries the stack | merge with #90 stack
D | 6 | #83 | ef6934aa206576b608b20614cc7e677337bd162c | not standalone in local store | feat/d-w05-quality-contract | ancestor in #90 stack | da82109 | TESTED_VIA_W13_HEAD_TREE | n/a | TESTED_VIA_W13_HEAD_TREE | #90 tree carries the stack | merge with #90 stack
D | 7 | #84 | d805648476f9ffb5b7176b93b81ad5d8cae566aa | not standalone in local store | feat/d-w06-command-handoff | ancestor in #90 stack | da82109 | TESTED_VIA_W13_HEAD_TREE | n/a | TESTED_VIA_W13_HEAD_TREE | #90 tree carries the stack | merge with #90 stack
D | 8 | #85 | 42e81c582a3a2672a8d63c9d06aa8b8d4dd224e5 | not standalone in local store | feat/d-w07-controller-a | ancestor in #90 stack | da82109 | TESTED_VIA_W13_HEAD_TREE | n/a | TESTED_VIA_W13_HEAD_TREE | #90 tree carries the stack | merge with #90 stack
D | 9 | #86 | ae3140838be8a2a3c107cfc2878c02f95023cc48 | not standalone in local store | feat/d-w08-safe-local-session | ancestor in #90 stack | da82109 | TESTED_VIA_W13_HEAD_TREE | n/a | TESTED_VIA_W13_HEAD_TREE | #90 tree carries the stack | merge with #90 stack
D | 10 | #87 | 3e79c1be6d2d1c54423a423be52b1bcc0719416e | not standalone in local store | feat/d-w09-physical-verification | ancestor in #90 stack | da82109 | TESTED_VIA_W13_HEAD_TREE | n/a | TESTED_VIA_W13_HEAD_TREE | #90 tree carries the stack | merge with #90 stack
D | 11 | #88 | f78897e1aeccff5f205b70d8f4a76d7422fe0c0a | not standalone in local store | feat/d-w10-fault-protocol | ancestor in #90 stack | da82109 | TESTED_VIA_W13_HEAD_TREE | n/a | TESTED_VIA_W13_HEAD_TREE | #90 tree carries the stack | merge with #90 stack
D | 12 | #89 | 19b296de038096f293a2375afc6a099bf1ad2211 | not standalone in local store | feat/d-w11-incident-handoff | ancestor in #90 stack | da82109 | TESTED_VIA_W13_HEAD_TREE | n/a | TESTED_VIA_W13_HEAD_TREE | #90 tree carries the stack | merge with #90 stack
D | 13 | #90 | da821094985006945d0306dd7b16be576378bc18 | da82109 local object (SHA verified) | feat/d-w12 @19b296de | stack d-w04..d-w12 (#81..#89) | da82109 | SOURCE_PRESENT | n/a | TESTED_ON_CORRECT_SHA | clock gate/TTL/aiw/verification probes 6/6 + d90 suite | merge with stack
