minhqng/predictive-cold-chain-aiot/evidence/A/W04/boot-default-off.csv

source_file | capture_file | duplicate_captures | source_line | host_date | host_time | rst_code | reset_cause | start_kind_class | boot_banner | image | firmware_version | hardware_config_id | boot_id | boot_count | first_record_type | tec_state | output_stage | duty_permille | fan_command | ren | len | rpwm_level | current_a | current_status | voltage_v | power_w | fault_code | fault_reason | off_evidence_level | pin_level_measurement | image_basis
../A-W04-tec-commissioning/evidence/A/W02/espidf-run/serial-reboot-original.log | serial-reboot-original.log | ../A-W04-tec-commissioning/evidence/A/W02/espidf-run/serial-reboot-original.log; evidence/A/W02/espidf-run/serial-reboot-original.log | 6 | UNKNOWN_DATE |  | 0x15 | USB_JTAG_CHIP_RESET | USB_JTAG_RESET | USB_UART_CHIP_RESET | cg-w02(path) |  |  | 227e6f67 | 5 |  |  |  |  |  |  |  |  |  |  |  |  |  |  | NO_DEVICE_RECORD_AFTER_BANNER | NOT_FOUND_IN_THIS_CAPTURE | path_hint_only
../A-W04-tec-commissioning/evidence/A/W02/espidf-run/serial-reboot-original.log | serial-reboot-original.log | ../A-W04-tec-commissioning/evidence/A/W02/espidf-run/serial-reboot-original.log; evidence/A/W02/espidf-run/serial-reboot-original.log | 79 | UNKNOWN_DATE |  | 0x15 | USB_JTAG_CHIP_RESET | USB_JTAG_RESET | USB_UART_CHIP_RESET | cg-w02(path) |  |  | 50313e8c | 6 |  |  |  |  |  |  |  |  |  |  |  |  |  |  | NO_DEVICE_RECORD_AFTER_BANNER | NOT_FOUND_IN_THIS_CAPTURE | path_hint_only
../A-W04-tec-commissioning/evidence/A/W02/espidf-run/serial-reboot-original.log | serial-reboot-original.log | ../A-W04-tec-commissioning/evidence/A/W02/espidf-run/serial-reboot-original.log; evidence/A/W02/espidf-run/serial-reboot-original.log | 161 | UNKNOWN_DATE |  | 0x15 | USB_JTAG_CHIP_RESET | USB_JTAG_RESET | USB_UART_CHIP_RESET | cg-w02(path) |  |  | c864acea | 7 |  |  |  |  |  |  |  |  |  |  |  |  |  |  | NO_DEVICE_RECORD_AFTER_BANNER | NOT_FOUND_IN_THIS_CAPTURE | path_hint_only
../A-W04-tec-commissioning/evidence/A/W02/espidf-run/serial-reboot-original.log | serial-reboot-original.log | ../A-W04-tec-commissioning/evidence/A/W02/espidf-run/serial-reboot-original.log; evidence/A/W02/espidf-run/serial-reboot-original.log | 243 | UNKNOWN_DATE |  | 0x15 | USB_JTAG_CHIP_RESET | USB_JTAG_RESET | USB_UART_CHIP_RESET | cg-w02(path) |  |  | 222be57b | 8 |  |  |  |  |  |  |  |  |  |  |  |  |  |  | NO_DEVICE_RECORD_AFTER_BANNER | NOT_FOUND_IN_THIS_CAPTURE | path_hint_only
../A-W04-tec-commissioning/evidence/A/W02/espidf-run/serial-reboot-original.log | serial-reboot-original.log | ../A-W04-tec-commissioning/evidence/A/W02/espidf-run/serial-reboot-original.log; evidence/A/W02/espidf-run/serial-reboot-original.log | 325 | UNKNOWN_DATE |  | 0x15 | USB_JTAG_CHIP_RESET | USB_JTAG_RESET | USB_UART_CHIP_RESET | cg-w02(path) |  |  | 99b3dcb5 | 9 |  |  |  |  |  |  |  |  |  |  |  |  |  |  | NO_DEVICE_RECORD_AFTER_BANNER | NOT_FOUND_IN_THIS_CAPTURE | path_hint_only
../A-W04-tec-commissioning/evidence/A/W02/espidf-run/serial-reboot-original.log | serial-reboot-original.log | ../A-W04-tec-commissioning/evidence/A/W02/espidf-run/serial-reboot-original.log; evidence/A/W02/espidf-run/serial-reboot-original.log | 407 | UNKNOWN_DATE |  | 0x15 | USB_JTAG_CHIP_RESET | USB_JTAG_RESET | USB_UART_CHIP_RESET | cg-w02(path) |  |  | ae20928d | 10 |  |  |  |  |  |  |  |  |  |  |  |  |  |  | NO_DEVICE_RECORD_AFTER_BANNER | NOT_FOUND_IN_THIS_CAPTURE | path_hint_only
../A-W04-tec-commissioning/evidence/A/W04/h6/03-w04-boot-before-flash.log | 03-w04-boot-before-flash.log | ../A-W04-tec-commissioning/evidence/A/W04/h6/03-w04-boot-before-flash.log; evidence/A/W04/h6/03-w04-boot-before-flash.log | 8 | UNKNOWN_DATE |  | 0x15 | USB_JTAG_CHIP_RESET | USB_JTAG_RESET | USB_UART_CHIP_RESET | cg-w04-0.1.0 | cg-w04-0.1.0 | CG-HW-001 | 588f166f | 40 | CG_TELEM | OFF | DISABLED | 0 | OFF |  |  |  | nan | NO_DATA | nan | nan | 0x00000000 | BOOT_SAFE_OFF | DEVICE_REPORTED | NOT_FOUND_IN_THIS_CAPTURE | telemetry firmware_version line
../A-W04-tec-commissioning/evidence/A/W04/h6/20-boot-after-flash.log | 20-boot-after-flash.log | ../A-W04-tec-commissioning/evidence/A/W04/h6/20-boot-after-flash.log; evidence/A/W04/h6/20-boot-after-flash.log | 8 | UNKNOWN_DATE |  | 0x15 | USB_JTAG_CHIP_RESET | USB_JTAG_RESET | USB_UART_CHIP_RESET | h6-bench |  |  |  |  | H6_SAFE_OFF | OFF |  | 0 |  | 0 | 0 | 0 |  |  |  |  |  |  | DEVICE_REPORTED | NOT_FOUND_IN_THIS_CAPTURE | H6 SAFE_OFF line
../A-W04-tec-commissioning/evidence/A/W04/h6/20-boot-after-flash.raw.log | 20-boot-after-flash.raw.log | ../A-W04-tec-commissioning/evidence/A/W04/h6/20-boot-after-flash.raw.log; evidence/A/W04/h6/20-boot-after-flash.raw.log | 8 | UNKNOWN_DATE |  | 0x15 | USB_JTAG_CHIP_RESET | USB_JTAG_RESET | USB_UART_CHIP_RESET | h6-bench |  |  |  |  | H6_SAFE_OFF | OFF |  | 0 |  | 0 | 0 | 0 |  |  |  |  |  |  | DEVICE_REPORTED | NOT_FOUND_IN_THIS_CAPTURE | H6 SAFE_OFF line
../A-W04-tec-commissioning/evidence/A/W04/h6/24-boot-after-refix.raw.log | 24-boot-after-refix.raw.log | ../A-W04-tec-commissioning/evidence/A/W04/h6/24-boot-after-refix.raw.log; evidence/A/W04/h6/24-boot-after-refix.raw.log | 3 | UNKNOWN_DATE |  | 0x15 | USB_JTAG_CHIP_RESET | USB_JTAG_RESET | USB_UART_CHIP_RESET | h6-bench |  |  |  |  | H6_SAFE_OFF | OFF |  | 0 |  | 0 | 0 | 0 |  |  |  |  |  |  | DEVICE_REPORTED | NOT_FOUND_IN_THIS_CAPTURE | H6 SAFE_OFF line
../A-W04-tec-commissioning/evidence/A/W04/h7/32-boot-after-flash.log | 32-boot-after-flash.log |  | 3 | UNKNOWN_DATE |  | 0x15 | USB_JTAG_CHIP_RESET | USB_JTAG_RESET | USB_UART_CHIP_RESET | h7-bench |  |  |  |  | H7_SAFE_OFF_EARLY | OFF |  | 0 |  | 0 | 0 |  |  |  |  |  |  |  | DEVICE_REPORTED | NOT_FOUND_IN_THIS_CAPTURE | H7 SAFE_OFF line
../A-W04-tec-commissioning/evidence/A/W04/h7/32b-boot-after-flash-rev3.log | 32b-boot-after-flash-rev3.log |  | 3 | UNKNOWN_DATE |  | 0x15 | USB_JTAG_CHIP_RESET | USB_JTAG_RESET | USB_UART_CHIP_RESET | h7-bench |  |  |  |  | H7_SAFE_OFF_EARLY | OFF |  | 0 |  | 0 | 0 |  |  |  |  |  |  |  | DEVICE_REPORTED | NOT_FOUND_IN_THIS_CAPTURE | H7 SAFE_OFF line
../A-W04-tec-commissioning/evidence/A/W04/h7/32c-boot-after-flash-rev4.log | 32c-boot-after-flash-rev4.log |  | 3 | UNKNOWN_DATE |  | 0x15 | USB_JTAG_CHIP_RESET | USB_JTAG_RESET | USB_UART_CHIP_RESET | h7-bench |  |  |  |  | H7_SAFE_OFF_EARLY | OFF |  | 0 |  | 0 | 0 |  |  |  |  |  |  |  | DEVICE_REPORTED | NOT_FOUND_IN_THIS_CAPTURE | H7 SAFE_OFF line
../A-W04-tec-commissioning/evidence/A/W04/h7/34-pzem-after-clean-boot.log | 34-pzem-after-clean-boot.log |  | 3 | UNKNOWN_DATE |  | 0x15 | USB_JTAG_CHIP_RESET | USB_JTAG_RESET | USB_UART_CHIP_RESET | h7-bench |  |  |  |  | H7_SAFE_OFF_EARLY | OFF |  | 0 |  | 0 | 0 |  |  |  |  |  |  |  | DEVICE_REPORTED | NOT_FOUND_IN_THIS_CAPTURE | H7 SAFE_OFF line
../A-W04-tec-commissioning/evidence/A/W04/h7/60a-precheck-40pct.log | 60a-precheck-40pct.log |  | 3 | UNKNOWN_DATE |  | 0x15 | USB_JTAG_CHIP_RESET | USB_JTAG_RESET | USB_UART_CHIP_RESET | h7-bench |  |  |  |  | H7_SAFE_OFF_EARLY | OFF |  | 0 |  | 0 | 0 |  |  |  |  |  |  |  | DEVICE_REPORTED | NOT_FOUND_IN_THIS_CAPTURE | H7 SAFE_OFF line
../A-W04-tec-commissioning/evidence/A/W04/h7/62a-precheck-50pct.log | 62a-precheck-50pct.log |  | 3 | UNKNOWN_DATE |  | 0x15 | USB_JTAG_CHIP_RESET | USB_JTAG_RESET | USB_UART_CHIP_RESET | h7-bench |  |  |  |  | H7_SAFE_OFF_EARLY | OFF |  | 0 |  | 0 | 0 |  |  |  |  |  |  |  | DEVICE_REPORTED | NOT_FOUND_IN_THIS_CAPTURE | H7 SAFE_OFF line
../A-W04-tec-commissioning/evidence/A/W04/h7/64a-precheck-60pct.log | 64a-precheck-60pct.log |  | 3 | UNKNOWN_DATE |  | 0x15 | USB_JTAG_CHIP_RESET | USB_JTAG_RESET | USB_UART_CHIP_RESET | h7-bench |  |  |  |  | H7_SAFE_OFF_EARLY | OFF |  | 0 |  | 0 | 0 |  |  |  |  |  |  |  | DEVICE_REPORTED | NOT_FOUND_IN_THIS_CAPTURE | H7 SAFE_OFF line
../A-W04-tec-commissioning/evidence/A/W04/h7/66a-precheck-diag.log | 66a-precheck-diag.log |  | 3 | UNKNOWN_DATE |  | 0x15 | USB_JTAG_CHIP_RESET | USB_JTAG_RESET | USB_UART_CHIP_RESET | h7-bench |  |  |  |  | H7_SAFE_OFF_EARLY | OFF |  | 0 |  | 0 | 0 |  |  |  |  |  |  |  | DEVICE_REPORTED | NOT_FOUND_IN_THIS_CAPTURE | H7 SAFE_OFF line
../A-W04-tec-commissioning/evidence/A/W04/h7/68a-precheck-diag2.log | 68a-precheck-diag2.log |  | 3 | UNKNOWN_DATE |  | 0x15 | USB_JTAG_CHIP_RESET | USB_JTAG_RESET | USB_UART_CHIP_RESET | h7-bench |  |  |  |  | H7_SAFE_OFF_EARLY | OFF |  | 0 |  | 0 | 0 |  |  |  |  |  |  |  | DEVICE_REPORTED | NOT_FOUND_IN_THIS_CAPTURE | H7 SAFE_OFF line
../A-W04-tec-commissioning/evidence/A/W04/h7/70a-precheck-shunt.log | 70a-precheck-shunt.log |  | 3 | UNKNOWN_DATE |  | 0x15 | USB_JTAG_CHIP_RESET | USB_JTAG_RESET | USB_UART_CHIP_RESET | h7-bench |  |  |  |  | H7_SAFE_OFF_EARLY | OFF |  | 0 |  | 0 | 0 |  |  |  |  |  |  |  | DEVICE_REPORTED | NOT_FOUND_IN_THIS_CAPTURE | H7 SAFE_OFF line
../A-W04-tec-commissioning/evidence/A/W04/h7/71a-precheck-70pct.log | 71a-precheck-70pct.log |  | 3 | UNKNOWN_DATE |  | 0x15 | USB_JTAG_CHIP_RESET | USB_JTAG_RESET | USB_UART_CHIP_RESET | h7-bench |  |  |  |  | H7_SAFE_OFF_EARLY | OFF |  | 0 |  | 0 | 0 |  |  |  |  |  |  |  | DEVICE_REPORTED | NOT_FOUND_IN_THIS_CAPTURE | H7 SAFE_OFF line
../A-W04-tec-commissioning/evidence/A/W04/h7/72a-precheck-80pct.log | 72a-precheck-80pct.log |  | 3 | UNKNOWN_DATE |  | 0x15 | USB_JTAG_CHIP_RESET | USB_JTAG_RESET | USB_UART_CHIP_RESET | h7-bench |  |  |  |  | H7_SAFE_OFF_EARLY | OFF |  | 0 |  | 0 | 0 |  |  |  |  |  |  |  | DEVICE_REPORTED | NOT_FOUND_IN_THIS_CAPTURE | H7 SAFE_OFF line
../A-W04-tec-commissioning/evidence/A/W04/h7/73a-precheck-90pct.log | 73a-precheck-90pct.log |  | 3 | UNKNOWN_DATE |  | 0x15 | USB_JTAG_CHIP_RESET | USB_JTAG_RESET | USB_UART_CHIP_RESET | h7-bench |  |  |  |  | H7_SAFE_OFF_EARLY | OFF |  | 0 |  | 0 | 0 |  |  |  |  |  |  |  | DEVICE_REPORTED | NOT_FOUND_IN_THIS_CAPTURE | H7 SAFE_OFF line
../A-W04-tec-commissioning/evidence/A/W04/h7/74a-precheck-100pct.log | 74a-precheck-100pct.log |  | 3 | UNKNOWN_DATE |  | 0x15 | USB_JTAG_CHIP_RESET | USB_JTAG_RESET | USB_UART_CHIP_RESET | h7-bench |  |  |  |  | H7_SAFE_OFF_EARLY | OFF |  | 0 |  | 0 | 0 |  |  |  |  |  |  |  | DEVICE_REPORTED | NOT_FOUND_IN_THIS_CAPTURE | H7 SAFE_OFF line
../A-W04-tec-commissioning/evidence/A/W04/h7/75a-precheck-100run.log | 75a-precheck-100run.log |  | 3 | UNKNOWN_DATE |  | 0x15 | USB_JTAG_CHIP_RESET | USB_JTAG_RESET | USB_UART_CHIP_RESET | h7-bench |  |  |  |  | H7_SAFE_OFF_EARLY | OFF |  | 0 |  | 0 | 0 |  |  |  |  |  |  |  | DEVICE_REPORTED | NOT_FOUND_IN_THIS_CAPTURE | H7 SAFE_OFF line
../A-W04-tec-commissioning/evidence/A/W04/h8/box-cooling-600s-2026-11-01/monitor-final/telemetry_raw.log | telemetry_raw.log |  | 3 | UNKNOWN_DATE |  | 0x15 | USB_JTAG_CHIP_RESET | USB_JTAG_RESET | USB_UART_CHIP_RESET | h8-bench |  |  | 56044b74 |  |  |  |  |  |  |  |  |  |  |  |  |  |  | test_mode=BENCH_ENDURANCE | NO_DEVICE_RECORD_AFTER_BANNER | NOT_FOUND_IN_THIS_CAPTURE | boot line firmware field
../A-W04-tec-commissioning/evidence/A/W04/h8/mc38-2026-11-01/monitor/passive_raw.log | passive_raw.log |  | 4 | UNKNOWN_DATE |  | 0x15 | USB_JTAG_CHIP_RESET | USB_JTAG_RESET | USB_UART_CHIP_RESET | h8-bench |  |  | 98fa1c70 |  |  |  |  |  |  |  |  |  |  |  |  |  |  | test_mode=BENCH_ENDURANCE | NO_DEVICE_RECORD_AFTER_BANNER | NOT_FOUND_IN_THIS_CAPTURE | boot line firmware field
../A-W04-tec-commissioning/evidence/A/W04/h8/mc38-2026-11-01/monitor/session_raw.log | session_raw.log |  | 4 | UNKNOWN_DATE |  | 0x15 | USB_JTAG_CHIP_RESET | USB_JTAG_RESET | USB_UART_CHIP_RESET | h8-bench |  |  | 11dae4e6 |  |  |  |  |  |  |  |  |  |  |  |  |  |  | test_mode=BENCH_ENDURANCE | NO_DEVICE_RECORD_AFTER_BANNER | NOT_FOUND_IN_THIS_CAPTURE | boot line firmware field
../A-W04-tec-commissioning/evidence/A/W04/h8/mc38-direct-magnet-2026-11-01/monitor/session_raw.log | session_raw.log |  | 4 | UNKNOWN_DATE |  | 0x15 | USB_JTAG_CHIP_RESET | USB_JTAG_RESET | USB_UART_CHIP_RESET | h8-bench |  |  | eedacec1 |  |  |  |  |  |  |  |  |  |  |  |  |  |  | test_mode=BENCH_ENDURANCE | NO_DEVICE_RECORD_AFTER_BANNER | NOT_FOUND_IN_THIS_CAPTURE | boot line firmware field
../A-W04-tec-commissioning/evidence/A/W04/h8/mc38-lid-simple-2026-11-01/monitor/session_raw.log | session_raw.log |  | 4 | UNKNOWN_DATE |  | 0x15 | USB_JTAG_CHIP_RESET | USB_JTAG_RESET | USB_UART_CHIP_RESET | h8-bench |  |  | 9c54370e |  |  |  |  |  |  |  |  |  |  |  |  |  |  | test_mode=BENCH_ENDURANCE | NO_DEVICE_RECORD_AFTER_BANNER | NOT_FOUND_IN_THIS_CAPTURE | boot line firmware field
../A-W04-tec-commissioning/evidence/A/W04/h8/phase4a/06-h8-boot-idle.log | 06-h8-boot-idle.log |  | 17 | UNKNOWN_DATE |  | 0xc | SOFTWARE_RESET | SOFTWARE_OR_WATCHDOG_RESET | RTC_SW_CPU_RST | h8-bench |  |  | 29766f42 |  |  |  |  |  |  |  |  |  |  |  |  |  |  | test_mode=BENCH_ENDURANCE | NO_DEVICE_RECORD_AFTER_BANNER | NOT_FOUND_IN_THIS_CAPTURE | boot line firmware field
../A-W04-tec-commissioning/evidence/A/W04/h8/phase4a/06-h8-boot-idle.log | 06-h8-boot-idle.log |  | 67 | UNKNOWN_DATE |  | 0xc | SOFTWARE_RESET | SOFTWARE_OR_WATCHDOG_RESET | RTC_SW_CPU_RST | h8-bench |  |  | d8b62ef2 |  |  |  |  |  |  |  |  |  |  |  |  |  |  | test_mode=BENCH_ENDURANCE | NO_DEVICE_RECORD_AFTER_BANNER | NOT_FOUND_IN_THIS_CAPTURE | boot line firmware field
../A-W04-tec-commissioning/evidence/A/W04/h8/phase4a/06-h8-boot-idle.log | 06-h8-boot-idle.log |  | 117 | UNKNOWN_DATE |  | 0xc | SOFTWARE_RESET | SOFTWARE_OR_WATCHDOG_RESET | RTC_SW_CPU_RST | h8-bench |  |  | 8e9fd778 |  |  |  |  |  |  |  |  |  |  |  |  |  |  | test_mode=BENCH_ENDURANCE | NO_DEVICE_RECORD_AFTER_BANNER | NOT_FOUND_IN_THIS_CAPTURE | boot line firmware field
../A-W04-tec-commissioning/evidence/A/W04/h8/phase4a/06-h8-boot-idle.log | 06-h8-boot-idle.log |  | 167 | UNKNOWN_DATE |  | 0xc | SOFTWARE_RESET | SOFTWARE_OR_WATCHDOG_RESET | RTC_SW_CPU_RST | h8-bench |  |  | b1b56e31 |  |  |  |  |  |  |  |  |  |  |  |  |  |  | test_mode=BENCH_ENDURANCE | NO_DEVICE_RECORD_AFTER_BANNER | NOT_FOUND_IN_THIS_CAPTURE | boot line firmware field
../A-W04-tec-commissioning/evidence/A/W04/h8/phase4a/06-h8-boot-idle.log | 06-h8-boot-idle.log |  | 217 | UNKNOWN_DATE |  | 0xc | SOFTWARE_RESET | SOFTWARE_OR_WATCHDOG_RESET | RTC_SW_CPU_RST | h8-bench |  |  | aa781df4 |  |  |  |  |  |  |  |  |  |  |  |  |  |  | test_mode=BENCH_ENDURANCE | NO_DEVICE_RECORD_AFTER_BANNER | NOT_FOUND_IN_THIS_CAPTURE | boot line firmware field
../A-W04-tec-commissioning/evidence/A/W04/h8/phase4a/06-h8-boot-idle.log | 06-h8-boot-idle.log |  | 267 | UNKNOWN_DATE |  | 0xc | SOFTWARE_RESET | SOFTWARE_OR_WATCHDOG_RESET | RTC_SW_CPU_RST | h8-bench |  |  | be9d9016 |  |  |  |  |  |  |  |  |  |  |  |  |  |  | test_mode=BENCH_ENDURANCE | NO_DEVICE_RECORD_AFTER_BANNER | NOT_FOUND_IN_THIS_CAPTURE | boot line firmware field
../A-W04-tec-commissioning/evidence/A/W04/h8/phase4a/06-h8-boot-idle.log | 06-h8-boot-idle.log |  | 317 | UNKNOWN_DATE |  | 0xc | SOFTWARE_RESET | SOFTWARE_OR_WATCHDOG_RESET | RTC_SW_CPU_RST | h8-bench |  |  | d02e87ce |  |  |  |  |  |  |  |  |  |  |  |  |  |  | test_mode=BENCH_ENDURANCE | NO_DEVICE_RECORD_AFTER_BANNER | NOT_FOUND_IN_THIS_CAPTURE | boot line firmware field
../A-W04-tec-commissioning/evidence/A/W04/h8/phase4a/06-h8-boot-idle.log | 06-h8-boot-idle.log |  | 367 | UNKNOWN_DATE |  | 0xc | SOFTWARE_RESET | SOFTWARE_OR_WATCHDOG_RESET | RTC_SW_CPU_RST | h8-bench |  |  | ba447170 |  |  |  |  |  |  |  |  |  |  |  |  |  |  | test_mode=BENCH_ENDURANCE | NO_DEVICE_RECORD_AFTER_BANNER | NOT_FOUND_IN_THIS_CAPTURE | boot line firmware field
../A-W04-tec-commissioning/evidence/A/W04/h8/phase4a/06-h8-boot-idle.log | 06-h8-boot-idle.log |  | 417 | UNKNOWN_DATE |  | 0xc | SOFTWARE_RESET | SOFTWARE_OR_WATCHDOG_RESET | RTC_SW_CPU_RST | h8-bench |  |  | 01d54e05 |  |  |  |  |  |  |  |  |  |  |  |  |  |  | test_mode=BENCH_ENDURANCE | NO_DEVICE_RECORD_AFTER_BANNER | NOT_FOUND_IN_THIS_CAPTURE | boot line firmware field
../A-W04-tec-commissioning/evidence/A/W04/h8/phase4a/06-h8-boot-idle.log | 06-h8-boot-idle.log |  | 467 | UNKNOWN_DATE |  | 0xc | SOFTWARE_RESET | SOFTWARE_OR_WATCHDOG_RESET | RTC_SW_CPU_RST | h8-bench |  |  | 510e795f |  |  |  |  |  |  |  |  |  |  |  |  |  |  | test_mode=BENCH_ENDURANCE | NO_DEVICE_RECORD_AFTER_BANNER | NOT_FOUND_IN_THIS_CAPTURE | boot line firmware field
../A-W04-tec-commissioning/evidence/A/W04/h8/phase4a/06-h8-boot-idle.log | 06-h8-boot-idle.log |  | 517 | UNKNOWN_DATE |  | 0xc | SOFTWARE_RESET | SOFTWARE_OR_WATCHDOG_RESET | RTC_SW_CPU_RST | h8-bench |  |  | 002de793 |  |  |  |  |  |  |  |  |  |  |  |  |  |  | test_mode=BENCH_ENDURANCE | NO_DEVICE_RECORD_AFTER_BANNER | NOT_FOUND_IN_THIS_CAPTURE | boot line firmware field
../A-W04-tec-commissioning/evidence/A/W04/h8/phase4a/06-h8-boot-idle.log | 06-h8-boot-idle.log |  | 567 | UNKNOWN_DATE |  | 0xc | SOFTWARE_RESET | SOFTWARE_OR_WATCHDOG_RESET | RTC_SW_CPU_RST | h8-bench |  |  | 6212ef58 |  |  |  |  |  |  |  |  |  |  |  |  |  |  | test_mode=BENCH_ENDURANCE | NO_DEVICE_RECORD_AFTER_BANNER | NOT_FOUND_IN_THIS_CAPTURE | boot line firmware field
../A-W04-tec-commissioning/evidence/A/W04/h8/phase4a/06-h8-boot-idle.log | 06-h8-boot-idle.log |  | 617 | UNKNOWN_DATE |  | 0xc | SOFTWARE_RESET | SOFTWARE_OR_WATCHDOG_RESET | RTC_SW_CPU_RST | h8-bench |  |  | 5d67b388 |  |  |  |  |  |  |  |  |  |  |  |  |  |  | test_mode=BENCH_ENDURANCE | NO_DEVICE_RECORD_AFTER_BANNER | NOT_FOUND_IN_THIS_CAPTURE | boot line firmware field
../A-W04-tec-commissioning/evidence/A/W04/h8/phase4a/06-h8-boot-idle.log | 06-h8-boot-idle.log |  | 667 | UNKNOWN_DATE |  | 0xc | SOFTWARE_RESET | SOFTWARE_OR_WATCHDOG_RESET | RTC_SW_CPU_RST | h8-bench |  |  | 22154d42 |  |  |  |  |  |  |  |  |  |  |  |  |  |  | test_mode=BENCH_ENDURANCE | NO_DEVICE_RECORD_AFTER_BANNER | NOT_FOUND_IN_THIS_CAPTURE | boot line firmware field
../A-W04-tec-commissioning/evidence/A/W04/h8/phase4a/06-h8-boot-idle.log | 06-h8-boot-idle.log |  | 717 | UNKNOWN_DATE |  | 0xc | SOFTWARE_RESET | SOFTWARE_OR_WATCHDOG_RESET | RTC_SW_CPU_RST | h8-bench |  |  | 57c02371 |  |  |  |  |  |  |  |  |  |  |  |  |  |  | test_mode=BENCH_ENDURANCE | NO_DEVICE_RECORD_AFTER_BANNER | NOT_FOUND_IN_THIS_CAPTURE | boot line firmware field
../A-W04-tec-commissioning/evidence/A/W04/h8/phase4a/12-h8-boot-monitor.log | 12-h8-boot-monitor.log |  | 8 | UNKNOWN_DATE |  | 0x15 | USB_JTAG_CHIP_RESET | USB_JTAG_RESET | USB_UART_CHIP_RESET | h8-bench |  |  | 3eeb79ed |  |  |  |  |  |  |  |  |  |  |  |  |  |  | test_mode=BENCH_ENDURANCE | NO_DEVICE_RECORD_AFTER_BANNER | NOT_FOUND_IN_THIS_CAPTURE | boot line firmware field
../A-W04-tec-commissioning/evidence/A/W04/h8/phase4a/17-h8-boot-v3.log | 17-h8-boot-v3.log |  | 8 | UNKNOWN_DATE |  | 0x15 | USB_JTAG_CHIP_RESET | USB_JTAG_RESET | USB_UART_CHIP_RESET | h8-bench |  |  | 18a4ac2a |  |  |  |  |  |  |  |  |  |  |  |  |  |  | test_mode=BENCH_ENDURANCE | NO_DEVICE_RECORD_AFTER_BANNER | NOT_FOUND_IN_THIS_CAPTURE | boot line firmware field
../A-W04-tec-commissioning/evidence/A/W04/h8/phase4a/18-door-near-low.log | 18-door-near-low.log |  | 3 | UNKNOWN_DATE |  | 0x15 | USB_JTAG_CHIP_RESET | USB_JTAG_RESET | USB_UART_CHIP_RESET | h8-bench |  |  | 85e270b9 |  |  |  |  |  |  |  |  |  |  |  |  |  |  | test_mode=BENCH_ENDURANCE | NO_DEVICE_RECORD_AFTER_BANNER | NOT_FOUND_IN_THIS_CAPTURE | boot line firmware field
../A-W04-tec-commissioning/evidence/A/W04/h8/phase4a/23-h8-boot-v4.log | 23-h8-boot-v4.log |  | 8 | UNKNOWN_DATE |  | 0x15 | USB_JTAG_CHIP_RESET | USB_JTAG_RESET | USB_UART_CHIP_RESET | h8-bench |  |  | 5e5015a8 |  |  |  |  |  |  |  |  |  |  |  |  |  |  | test_mode=BENCH_ENDURANCE | NO_DEVICE_RECORD_AFTER_BANNER | NOT_FOUND_IN_THIS_CAPTURE | boot line firmware field
../A-W04-tec-commissioning/evidence/A/W04/h8/phase4a/26-door-reset-session.log | 26-door-reset-session.log |  | 3 | UNKNOWN_DATE |  | 0x15 | USB_JTAG_CHIP_RESET | USB_JTAG_RESET | USB_UART_CHIP_RESET | h8-bench |  |  | fc70bc8a |  |  |  |  |  |  |  |  |  |  |  |  |  |  | test_mode=BENCH_ENDURANCE | NO_DEVICE_RECORD_AFTER_BANNER | NOT_FOUND_IN_THIS_CAPTURE | boot line firmware field
../A-W04-tec-commissioning/evidence/A/W04/h8/phase4b/02-t1-loss-idle-BASELINE-ONLY-aborted.log | 02-t1-loss-idle-BASELINE-ONLY-aborted.log |  | 5 | UNKNOWN_DATE |  | 0x15 | USB_JTAG_CHIP_RESET | USB_JTAG_RESET | USB_UART_CHIP_RESET | h8-bench |  |  | 33d17bab |  |  |  |  |  |  |  |  |  |  |  |  |  |  | test_mode=BENCH_ENDURANCE | NO_DEVICE_RECORD_AFTER_BANNER | NOT_FOUND_IN_THIS_CAPTURE | boot line firmware field
../A-W04-tec-commissioning/evidence/A/W04/h8/phase4b/03-cmd-validation-idle.log | 03-cmd-validation-idle.log |  | 5 | UNKNOWN_DATE |  | 0x15 | USB_JTAG_CHIP_RESET | USB_JTAG_RESET | USB_UART_CHIP_RESET | h8-bench |  |  | 25b23e59 |  | H8_TELEM | OFF |  |  |  |  |  |  |  |  |  |  |  | test_mode=BENCH_ENDURANCE | DEVICE_REPORTED | NOT_FOUND_IN_THIS_CAPTURE | boot line firmware field
../A-W04-tec-commissioning/evidence/A/W04/h8/phase4b/04-latch-estop-idle.log | 04-latch-estop-idle.log |  | 5 | UNKNOWN_DATE |  | 0x15 | USB_JTAG_CHIP_RESET | USB_JTAG_RESET | USB_UART_CHIP_RESET | h8-bench |  |  | 4d086850 |  | H8_TELEM | FAULT_LATCH |  |  |  |  |  |  |  |  |  |  |  | test_mode=BENCH_ENDURANCE | DEVICE_REPORTED | NOT_FOUND_IN_THIS_CAPTURE | boot line firmware field
../A-W04-tec-commissioning/evidence/A/W04/h8/phase4b/05-monitor-kill-idle.log | 05-monitor-kill-idle.log |  | 5 | UNKNOWN_DATE |  | 0x15 | USB_JTAG_CHIP_RESET | USB_JTAG_RESET | USB_UART_CHIP_RESET | h8-bench |  |  | 18a18f6a |  |  |  |  |  |  |  |  |  |  |  |  |  |  | test_mode=BENCH_ENDURANCE | NO_DEVICE_RECORD_AFTER_BANNER | NOT_FOUND_IN_THIS_CAPTURE | boot line firmware field
../A-W04-tec-commissioning/evidence/A/W04/h8/phase4d/07-boot-after-reset/monitor-stdout.log | monitor-stdout.log |  | 11 | UNKNOWN_DATE |  | 0xc | SOFTWARE_RESET | SOFTWARE_OR_WATCHDOG_RESET | RTC_SW_CPU_RST | h8-bench(path) |  |  |  |  |  |  |  |  |  |  |  |  |  |  |  |  |  |  | NO_DEVICE_RECORD_AFTER_BANNER | NOT_FOUND_IN_THIS_CAPTURE | path_hint_only
../A-W04-tec-commissioning/evidence/A/W04/h8/phase4d/07-boot-after-reset/telemetry_raw.log | telemetry_raw.log |  | 9 | UNKNOWN_DATE |  | 0xc | SOFTWARE_RESET | SOFTWARE_OR_WATCHDOG_RESET | RTC_SW_CPU_RST | h8-bench(path) |  |  |  |  |  |  |  |  |  |  |  |  |  |  |  |  |  |  | NO_DEVICE_RECORD_AFTER_BANNER | NOT_FOUND_IN_THIS_CAPTURE | path_hint_only
../A-W04-tec-commissioning/evidence/A/W04/h8/phase4d/ondevice/25-boot-idle/console.log | console.log |  | 15 | UNKNOWN_DATE |  | 0xc | SOFTWARE_RESET | SOFTWARE_OR_WATCHDOG_RESET | RTC_SW_CPU_RST | h8-bench |  |  | fe31738b |  | H8_TELEM | OFF |  |  |  |  |  |  |  |  |  |  |  | test_mode=BENCH_ENDURANCE | DEVICE_REPORTED | NOT_FOUND_IN_THIS_CAPTURE | boot line firmware field
../A-W04-tec-commissioning/evidence/A/W04/h8/phase4d/ondevice/25-boot-idle/telemetry_raw.log | telemetry_raw.log |  | 13 | UNKNOWN_DATE |  | 0xc | SOFTWARE_RESET | SOFTWARE_OR_WATCHDOG_RESET | RTC_SW_CPU_RST | h8-bench |  |  | fe31738b |  | H8_TELEM | OFF |  |  |  |  |  |  |  |  |  |  |  | test_mode=BENCH_ENDURANCE | DEVICE_REPORTED | NOT_FOUND_IN_THIS_CAPTURE | boot line firmware field
../A-W04-tec-commissioning/evidence/A/W04/h8/phase4d/ondevice/27-s1-ack-loss/console.log | console.log |  | 11 | UNKNOWN_DATE |  | 0xc | SOFTWARE_RESET | SOFTWARE_OR_WATCHDOG_RESET | RTC_SW_CPU_RST | h8-bench |  |  | e85144f2 |  | H8_TELEM | FAULT_LATCH |  |  |  |  |  |  |  |  |  |  |  | test_mode=BENCH_ENDURANCE | DEVICE_REPORTED | NOT_FOUND_IN_THIS_CAPTURE | boot line firmware field
../A-W04-tec-commissioning/evidence/A/W04/h8/phase4d/ondevice/27-s1-ack-loss/telemetry_raw.log | telemetry_raw.log |  | 9 | UNKNOWN_DATE |  | 0xc | SOFTWARE_RESET | SOFTWARE_OR_WATCHDOG_RESET | RTC_SW_CPU_RST | h8-bench |  |  | e85144f2 |  | H8_TELEM | FAULT_LATCH |  |  |  |  |  |  |  |  |  |  |  | test_mode=BENCH_ENDURANCE | DEVICE_REPORTED | NOT_FOUND_IN_THIS_CAPTURE | boot line firmware field
../A-W04-tec-commissioning/evidence/A/W04/h8/phase4d/ondevice/28-s2-ack-semantics/serial_raw.log | serial_raw.log |  | 5 | UNKNOWN_DATE |  | 0xc | SOFTWARE_RESET | SOFTWARE_OR_WATCHDOG_RESET | RTC_SW_CPU_RST | h8-bench |  |  | a86eb119 |  |  |  |  |  |  |  |  |  |  |  |  |  |  | test_mode=BENCH_ENDURANCE | NO_DEVICE_RECORD_AFTER_BANNER | NOT_FOUND_IN_THIS_CAPTURE | boot line firmware field
../A-W04-tec-commissioning/evidence/A/W04/h8/phase4d/ondevice/29-s2-ack-semantics/serial_raw.log | serial_raw.log |  | 5 | UNKNOWN_DATE |  | 0xc | SOFTWARE_RESET | SOFTWARE_OR_WATCHDOG_RESET | RTC_SW_CPU_RST | h8-bench |  |  | d8aba0a2 |  |  |  |  |  |  |  |  |  |  |  |  |  |  | test_mode=BENCH_ENDURANCE | NO_DEVICE_RECORD_AFTER_BANNER | NOT_FOUND_IN_THIS_CAPTURE | boot line firmware field
../A-W04-tec-commissioning/evidence/A/W04/h8/phase4d/ondevice/30-s3-monitor-termination/console.log | console.log |  | 9 | UNKNOWN_DATE |  | 0xc | SOFTWARE_RESET | SOFTWARE_OR_WATCHDOG_RESET | RTC_SW_CPU_RST | h8-bench |  |  | 5f4c371d |  |  |  |  |  |  |  |  |  |  |  |  |  |  | test_mode=BENCH_ENDURANCE | NO_DEVICE_RECORD_AFTER_BANNER | NOT_FOUND_IN_THIS_CAPTURE | boot line firmware field
../A-W04-tec-commissioning/evidence/A/W04/h8/phase4d/ondevice/30-s3-monitor-termination/telemetry_raw.log | telemetry_raw.log |  | 7 | UNKNOWN_DATE |  | 0xc | SOFTWARE_RESET | SOFTWARE_OR_WATCHDOG_RESET | RTC_SW_CPU_RST | h8-bench |  |  | 5f4c371d |  |  |  |  |  |  |  |  |  |  |  |  |  |  | test_mode=BENCH_ENDURANCE | NO_DEVICE_RECORD_AFTER_BANNER | NOT_FOUND_IN_THIS_CAPTURE | boot line firmware field
../A-W04-tec-commissioning/evidence/A/W04/h8/phase4d/ondevice/32-s5-t1-conv/console.log | console.log |  | 11 | UNKNOWN_DATE |  | 0xc | SOFTWARE_RESET | SOFTWARE_OR_WATCHDOG_RESET | RTC_SW_CPU_RST | h8-bench |  |  | a56e1c54 |  |  |  |  |  |  |  |  |  |  |  |  |  |  | test_mode=BENCH_ENDURANCE | NO_DEVICE_RECORD_AFTER_BANNER | NOT_FOUND_IN_THIS_CAPTURE | boot line firmware field
../A-W04-tec-commissioning/evidence/A/W04/h8/phase4d/ondevice/32-s5-t1-conv/telemetry_raw.log | telemetry_raw.log |  | 62 | UNKNOWN_DATE |  | 0xc | SOFTWARE_RESET | SOFTWARE_OR_WATCHDOG_RESET | RTC_SW_CPU_RST | h8-bench |  |  | a56e1c54 |  |  |  |  |  |  |  |  |  |  |  |  |  |  | test_mode=BENCH_ENDURANCE | NO_DEVICE_RECORD_AFTER_BANNER | NOT_FOUND_IN_THIS_CAPTURE | boot line firmware field
../A-W04-tec-commissioning/evidence/A/W04/h8/phase4d/ondevice/33-s5-t1-crc/console.log | console.log |  | 9 | UNKNOWN_DATE |  | 0xc | SOFTWARE_RESET | SOFTWARE_OR_WATCHDOG_RESET | RTC_SW_CPU_RST | h8-bench |  |  | 0be17f9f |  |  |  |  |  |  |  |  |  |  |  |  |  |  | test_mode=BENCH_ENDURANCE | NO_DEVICE_RECORD_AFTER_BANNER | NOT_FOUND_IN_THIS_CAPTURE | boot line firmware field
../A-W04-tec-commissioning/evidence/A/W04/h8/phase4d/ondevice/33-s5-t1-crc/telemetry_raw.log | telemetry_raw.log |  | 7 | UNKNOWN_DATE |  | 0xc | SOFTWARE_RESET | SOFTWARE_OR_WATCHDOG_RESET | RTC_SW_CPU_RST | h8-bench |  |  | 0be17f9f |  |  |  |  |  |  |  |  |  |  |  |  |  |  | test_mode=BENCH_ENDURANCE | NO_DEVICE_RECORD_AFTER_BANNER | NOT_FOUND_IN_THIS_CAPTURE | boot line firmware field
../A-W04-tec-commissioning/evidence/A/W04/h8/phase4d/ondevice/34-s6-t1-stale/console.log | console.log |  | 9 | UNKNOWN_DATE |  | 0xc | SOFTWARE_RESET | SOFTWARE_OR_WATCHDOG_RESET | RTC_SW_CPU_RST | h8-bench |  |  | 1575fd32 |  |  |  |  |  |  |  |  |  |  |  |  |  |  | test_mode=BENCH_ENDURANCE | NO_DEVICE_RECORD_AFTER_BANNER | NOT_FOUND_IN_THIS_CAPTURE | boot line firmware field
../A-W04-tec-commissioning/evidence/A/W04/h8/phase4d/ondevice/34-s6-t1-stale/telemetry_raw.log | telemetry_raw.log |  | 7 | UNKNOWN_DATE |  | 0xc | SOFTWARE_RESET | SOFTWARE_OR_WATCHDOG_RESET | RTC_SW_CPU_RST | h8-bench |  |  | 1575fd32 |  |  |  |  |  |  |  |  |  |  |  |  |  |  | test_mode=BENCH_ENDURANCE | NO_DEVICE_RECORD_AFTER_BANNER | NOT_FOUND_IN_THIS_CAPTURE | boot line firmware field
../A-W04-tec-commissioning/evidence/A/W04/h8/phase4d/ondevice/35-s7-bme-fail/console.log | console.log |  | 10 | UNKNOWN_DATE |  | 0xc | SOFTWARE_RESET | SOFTWARE_OR_WATCHDOG_RESET | RTC_SW_CPU_RST | h8-bench |  |  | ead589f4 |  |  |  |  |  |  |  |  |  |  |  |  |  |  | test_mode=BENCH_ENDURANCE | NO_DEVICE_RECORD_AFTER_BANNER | NOT_FOUND_IN_THIS_CAPTURE | boot line firmware field
../A-W04-tec-commissioning/evidence/A/W04/h8/phase4d/ondevice/35-s7-bme-fail/telemetry_raw.log | telemetry_raw.log |  | 8 | UNKNOWN_DATE |  | 0xc | SOFTWARE_RESET | SOFTWARE_OR_WATCHDOG_RESET | RTC_SW_CPU_RST | h8-bench |  |  | ead589f4 |  |  |  |  |  |  |  |  |  |  |  |  |  |  | test_mode=BENCH_ENDURANCE | NO_DEVICE_RECORD_AFTER_BANNER | NOT_FOUND_IN_THIS_CAPTURE | boot line firmware field
../A-W04-tec-commissioning/evidence/A/W04/h8/phase4d/ondevice/36-s8-pzem-fail/telemetry_raw.log | telemetry_raw.log |  | 7 | UNKNOWN_DATE |  | 0xc | SOFTWARE_RESET | SOFTWARE_OR_WATCHDOG_RESET | RTC_SW_CPU_RST | h8-bench |  |  | 6aeabdf5 |  |  |  |  |  |  |  |  |  |  |  |  |  |  | test_mode=BENCH_ENDURANCE | NO_DEVICE_RECORD_AFTER_BANNER | NOT_FOUND_IN_THIS_CAPTURE | boot line firmware field
../A-W04-tec-commissioning/evidence/A/W04/h8/phase4d/ondevice/36b-s8-pzem-fail-recovery/telemetry_raw.log | telemetry_raw.log |  | 7 | UNKNOWN_DATE |  | 0xc | SOFTWARE_RESET | SOFTWARE_OR_WATCHDOG_RESET | RTC_SW_CPU_RST | h8-bench |  |  | 2e9aa0f4 |  |  |  |  |  |  |  |  |  |  |  |  |  |  | test_mode=BENCH_ENDURANCE | NO_DEVICE_RECORD_AFTER_BANNER | NOT_FOUND_IN_THIS_CAPTURE | boot line firmware field
../A-W04-tec-commissioning/evidence/A/W04/h8/phase4d/ondevice/36c-s8-pzem-fail-recovery/console.log | console.log |  | 9 | UNKNOWN_DATE |  | 0xc | SOFTWARE_RESET | SOFTWARE_OR_WATCHDOG_RESET | RTC_SW_CPU_RST | h8-bench |  |  | afad9578 |  |  |  |  |  |  |  |  |  |  |  |  |  |  | test_mode=BENCH_ENDURANCE | NO_DEVICE_RECORD_AFTER_BANNER | NOT_FOUND_IN_THIS_CAPTURE | boot line firmware field
../A-W04-tec-commissioning/evidence/A/W04/h8/phase4d/ondevice/36c-s8-pzem-fail-recovery/telemetry_raw.log | telemetry_raw.log |  | 67 | UNKNOWN_DATE |  | 0xc | SOFTWARE_RESET | SOFTWARE_OR_WATCHDOG_RESET | RTC_SW_CPU_RST | h8-bench |  |  | afad9578 |  |  |  |  |  |  |  |  |  |  |  |  |  |  | test_mode=BENCH_ENDURANCE | NO_DEVICE_RECORD_AFTER_BANNER | NOT_FOUND_IN_THIS_CAPTURE | boot line firmware field
../A-W04-tec-commissioning/evidence/A/W04/h8/phase4d/ondevice/37-s9-snapshot-incomplete/console.log | console.log |  | 11 | UNKNOWN_DATE |  | 0xc | SOFTWARE_RESET | SOFTWARE_OR_WATCHDOG_RESET | RTC_SW_CPU_RST | h8-bench |  |  | 67f10fb5 |  |  |  |  |  |  |  |  |  |  |  |  |  |  | test_mode=BENCH_ENDURANCE | NO_DEVICE_RECORD_AFTER_BANNER | NOT_FOUND_IN_THIS_CAPTURE | boot line firmware field
../A-W04-tec-commissioning/evidence/A/W04/h8/phase4d/ondevice/37-s9-snapshot-incomplete/telemetry_raw.log | telemetry_raw.log |  | 9 | UNKNOWN_DATE |  | 0xc | SOFTWARE_RESET | SOFTWARE_OR_WATCHDOG_RESET | RTC_SW_CPU_RST | h8-bench |  |  | 67f10fb5 |  |  |  |  |  |  |  |  |  |  |  |  |  |  | test_mode=BENCH_ENDURANCE | NO_DEVICE_RECORD_AFTER_BANNER | NOT_FOUND_IN_THIS_CAPTURE | boot line firmware field
../A-W04-tec-commissioning/evidence/A/W04/h8/phase4d/ondevice/38-s10-telemetry-fail/console.log | console.log |  | 11 | UNKNOWN_DATE |  | 0xc | SOFTWARE_RESET | SOFTWARE_OR_WATCHDOG_RESET | RTC_SW_CPU_RST | h8-bench |  |  | e75d32d0 |  |  |  |  |  |  |  |  |  |  |  |  |  |  | test_mode=BENCH_ENDURANCE | NO_DEVICE_RECORD_AFTER_BANNER | NOT_FOUND_IN_THIS_CAPTURE | boot line firmware field
../A-W04-tec-commissioning/evidence/A/W04/h8/phase4d/ondevice/38-s10-telemetry-fail/telemetry_raw.log | telemetry_raw.log |  | 9 | UNKNOWN_DATE |  | 0xc | SOFTWARE_RESET | SOFTWARE_OR_WATCHDOG_RESET | RTC_SW_CPU_RST | h8-bench |  |  | e75d32d0 |  |  |  |  |  |  |  |  |  |  |  |  |  |  | test_mode=BENCH_ENDURANCE | NO_DEVICE_RECORD_AFTER_BANNER | NOT_FOUND_IN_THIS_CAPTURE | boot line firmware field
../A-W04-tec-commissioning/evidence/A/W04/h8/phase4d/ondevice/39-s11-acq-stall/console.log | console.log |  | 11 | UNKNOWN_DATE |  | 0xc | SOFTWARE_RESET | SOFTWARE_OR_WATCHDOG_RESET | RTC_SW_CPU_RST | h8-bench |  |  | fb583e6b |  |  |  |  |  |  |  |  |  |  |  |  |  |  | test_mode=BENCH_ENDURANCE | NO_DEVICE_RECORD_AFTER_BANNER | NOT_FOUND_IN_THIS_CAPTURE | boot line firmware field
../A-W04-tec-commissioning/evidence/A/W04/h8/phase4d/ondevice/39-s11-acq-stall/telemetry_raw.log | telemetry_raw.log |  | 9 | UNKNOWN_DATE |  | 0xc | SOFTWARE_RESET | SOFTWARE_OR_WATCHDOG_RESET | RTC_SW_CPU_RST | h8-bench |  |  | fb583e6b |  |  |  |  |  |  |  |  |  |  |  |  |  |  | test_mode=BENCH_ENDURANCE | NO_DEVICE_RECORD_AFTER_BANNER | NOT_FOUND_IN_THIS_CAPTURE | boot line firmware field
../A-W04-tec-commissioning/evidence/A/W04/h8/phase4d/ondevice/40-s12-ctrl-stall/console.log | console.log |  | 11 | UNKNOWN_DATE |  | 0xc | SOFTWARE_RESET | SOFTWARE_OR_WATCHDOG_RESET | RTC_SW_CPU_RST | h8-bench |  |  | 64b92093 |  |  |  |  |  |  |  |  |  |  |  |  |  |  | test_mode=BENCH_ENDURANCE | NO_DEVICE_RECORD_AFTER_BANNER | NOT_FOUND_IN_THIS_CAPTURE | boot line firmware field
../A-W04-tec-commissioning/evidence/A/W04/h8/phase4d/ondevice/40-s12-ctrl-stall/telemetry_raw.log | telemetry_raw.log |  | 9 | UNKNOWN_DATE |  | 0xc | SOFTWARE_RESET | SOFTWARE_OR_WATCHDOG_RESET | RTC_SW_CPU_RST | h8-bench |  |  | 64b92093 |  |  |  |  |  |  |  |  |  |  |  |  |  |  | test_mode=BENCH_ENDURANCE | NO_DEVICE_RECORD_AFTER_BANNER | NOT_FOUND_IN_THIS_CAPTURE | boot line firmware field
../A-W04-tec-commissioning/evidence/A/W04/h8/phase4d/ondevice/41-s13-stage-deadline/console.log | console.log |  | 9 | UNKNOWN_DATE |  | 0xc | SOFTWARE_RESET | SOFTWARE_OR_WATCHDOG_RESET | RTC_SW_CPU_RST | h8-bench |  |  | 28a4f4c4 |  |  |  |  |  |  |  |  |  |  |  |  |  |  | test_mode=BENCH_ENDURANCE | NO_DEVICE_RECORD_AFTER_BANNER | NOT_FOUND_IN_THIS_CAPTURE | boot line firmware field
../A-W04-tec-commissioning/evidence/A/W04/h8/phase4d/ondevice/41-s13-stage-deadline/telemetry_raw.log | telemetry_raw.log |  | 7 | UNKNOWN_DATE |  | 0xc | SOFTWARE_RESET | SOFTWARE_OR_WATCHDOG_RESET | RTC_SW_CPU_RST | h8-bench |  |  | 28a4f4c4 |  |  |  |  |  |  |  |  |  |  |  |  |  |  | test_mode=BENCH_ENDURANCE | NO_DEVICE_RECORD_AFTER_BANNER | NOT_FOUND_IN_THIS_CAPTURE | boot line firmware field
../A-W04-tec-commissioning/evidence/A/W04/h8/phase4d/ondevice/42-s14-reset-latch-restart/telemetry_raw.log | telemetry_raw.log |  | 8 | UNKNOWN_DATE |  | 0xc | SOFTWARE_RESET | SOFTWARE_OR_WATCHDOG_RESET | RTC_SW_CPU_RST | h8-bench |  |  | 371edec9 |  |  |  |  |  |  |  |  |  |  |  |  |  |  | test_mode=BENCH_ENDURANCE | NO_DEVICE_RECORD_AFTER_BANNER | NOT_FOUND_IN_THIS_CAPTURE | boot line firmware field
../A-W04-tec-commissioning/evidence/A/W04/h8/phase4d/ondevice/42-s14-reset-latch-restart/telemetry_raw.log | telemetry_raw.log |  | 69 | UNKNOWN_DATE |  | 0xc | SOFTWARE_RESET | SOFTWARE_OR_WATCHDOG_RESET | RTC_SW_CPU_RST | h8-bench |  |  | f535b8bc |  |  |  |  |  |  |  |  |  |  |  |  |  |  | test_mode=BENCH_ENDURANCE | NO_DEVICE_RECORD_AFTER_BANNER | NOT_FOUND_IN_THIS_CAPTURE | boot line firmware field
../A-W04-tec-commissioning/evidence/A/W04/h8/phase4d/ondevice/42b-s14-reset-latch-restart/console.log | console.log |  | 9 | UNKNOWN_DATE |  | 0xc | SOFTWARE_RESET | SOFTWARE_OR_WATCHDOG_RESET | RTC_SW_CPU_RST | h8-bench |  |  | 8dcdf1bf |  |  |  |  |  |  |  |  |  |  |  |  |  |  | test_mode=BENCH_ENDURANCE | NO_DEVICE_RECORD_AFTER_BANNER | NOT_FOUND_IN_THIS_CAPTURE | boot line firmware field
../A-W04-tec-commissioning/evidence/A/W04/h8/phase4d/ondevice/42b-s14-reset-latch-restart/console.log | console.log |  | 76 | UNKNOWN_DATE |  | 0xc | SOFTWARE_RESET | SOFTWARE_OR_WATCHDOG_RESET | RTC_SW_CPU_RST | h8-bench |  |  | b034d0a9 |  |  |  |  |  |  |  |  |  |  |  |  |  |  | test_mode=BENCH_ENDURANCE | NO_DEVICE_RECORD_AFTER_BANNER | NOT_FOUND_IN_THIS_CAPTURE | boot line firmware field
../A-W04-tec-commissioning/evidence/A/W04/h8/phase4d/ondevice/42b-s14-reset-latch-restart/telemetry_raw.log | telemetry_raw.log |  | 7 | UNKNOWN_DATE |  | 0xc | SOFTWARE_RESET | SOFTWARE_OR_WATCHDOG_RESET | RTC_SW_CPU_RST | h8-bench |  |  | 8dcdf1bf |  |  |  |  |  |  |  |  |  |  |  |  |  |  | test_mode=BENCH_ENDURANCE | NO_DEVICE_RECORD_AFTER_BANNER | NOT_FOUND_IN_THIS_CAPTURE | boot line firmware field
../A-W04-tec-commissioning/evidence/A/W04/h8/phase4d/ondevice/42b-s14-reset-latch-restart/telemetry_raw.log | telemetry_raw.log |  | 68 | UNKNOWN_DATE |  | 0xc | SOFTWARE_RESET | SOFTWARE_OR_WATCHDOG_RESET | RTC_SW_CPU_RST | h8-bench |  |  | b034d0a9 |  |  |  |  |  |  |  |  |  |  |  |  |  |  | test_mode=BENCH_ENDURANCE | NO_DEVICE_RECORD_AFTER_BANNER | NOT_FOUND_IN_THIS_CAPTURE | boot line firmware field
../A-W04-tec-commissioning/evidence/A/W04/h8/phase4e/h8a-2026-10-31/monitor-stdout.log | monitor-stdout.log |  | 3 | UNKNOWN_DATE |  | 0x15 | USB_JTAG_CHIP_RESET | USB_JTAG_RESET | USB_UART_CHIP_RESET | h8-bench |  |  | ba592828 |  |  |  |  |  |  |  |  |  |  |  |  |  |  | test_mode=BENCH_ENDURANCE | NO_DEVICE_RECORD_AFTER_BANNER | NOT_FOUND_IN_THIS_CAPTURE | boot line firmware field
../A-W04-tec-commissioning/evidence/A/W04/h8/phase4e/h8a-2026-10-31/monitor/telemetry_raw.log | telemetry_raw.log |  | 3 | UNKNOWN_DATE |  | 0x15 | USB_JTAG_CHIP_RESET | USB_JTAG_RESET | USB_UART_CHIP_RESET | h8-bench |  |  | ba592828 |  |  |  |  |  |  |  |  |  |  |  |  |  |  | test_mode=BENCH_ENDURANCE | NO_DEVICE_RECORD_AFTER_BANNER | NOT_FOUND_IN_THIS_CAPTURE | boot line firmware field
../A-W04-tec-commissioning/evidence/A/W04/h8/phase4e/h8a-enable-fixed-2026-10-31/monitor-stdout.log | monitor-stdout.log |  | 3 | UNKNOWN_DATE |  | 0x15 | USB_JTAG_CHIP_RESET | USB_JTAG_RESET | USB_UART_CHIP_RESET | h8-bench |  |  | 4ee4aa03 |  |  |  |  |  |  |  |  |  |  |  |  |  |  | test_mode=BENCH_ENDURANCE | NO_DEVICE_RECORD_AFTER_BANNER | NOT_FOUND_IN_THIS_CAPTURE | boot line firmware field
../A-W04-tec-commissioning/evidence/A/W04/h8/phase4e/h8a-enable-fixed-2026-10-31/monitor/telemetry_raw.log | telemetry_raw.log |  | 3 | UNKNOWN_DATE |  | 0x15 | USB_JTAG_CHIP_RESET | USB_JTAG_RESET | USB_UART_CHIP_RESET | h8-bench |  |  | 4ee4aa03 |  |  |  |  |  |  |  |  |  |  |  |  |  |  | test_mode=BENCH_ENDURANCE | NO_DEVICE_RECORD_AFTER_BANNER | NOT_FOUND_IN_THIS_CAPTURE | boot line firmware field
../A-W04-tec-commissioning/evidence/A/W04/h8/phase4e/h8a-retry-2026-10-31/monitor-stdout.log | monitor-stdout.log |  | 3 | UNKNOWN_DATE |  | 0x15 | USB_JTAG_CHIP_RESET | USB_JTAG_RESET | USB_UART_CHIP_RESET | h8-bench |  |  | 111e8b54 |  |  |  |  |  |  |  |  |  |  |  |  |  |  | test_mode=BENCH_ENDURANCE | NO_DEVICE_RECORD_AFTER_BANNER | NOT_FOUND_IN_THIS_CAPTURE | boot line firmware field
../A-W04-tec-commissioning/evidence/A/W04/h8/phase4e/h8a-retry-2026-10-31/monitor/telemetry_raw.log | telemetry_raw.log |  | 3 | UNKNOWN_DATE |  | 0x15 | USB_JTAG_CHIP_RESET | USB_JTAG_RESET | USB_UART_CHIP_RESET | h8-bench |  |  | 111e8b54 |  |  |  |  |  |  |  |  |  |  |  |  |  |  | test_mode=BENCH_ENDURANCE | NO_DEVICE_RECORD_AFTER_BANNER | NOT_FOUND_IN_THIS_CAPTURE | boot line firmware field
../A-W04-tec-commissioning/evidence/A/W04/h8/phase4e/h8b-2026-10-31/monitor-stdout.log | monitor-stdout.log |  | 3 | UNKNOWN_DATE |  | 0x15 | USB_JTAG_CHIP_RESET | USB_JTAG_RESET | USB_UART_CHIP_RESET | h8-bench |  |  | af36b005 |  |  |  |  |  |  |  |  |  |  |  |  |  |  | test_mode=BENCH_ENDURANCE | NO_DEVICE_RECORD_AFTER_BANNER | NOT_FOUND_IN_THIS_CAPTURE | boot line firmware field
../A-W04-tec-commissioning/evidence/A/W04/h8/phase4e/h8b-2026-10-31/monitor/telemetry_raw.log | telemetry_raw.log |  | 3 | UNKNOWN_DATE |  | 0x15 | USB_JTAG_CHIP_RESET | USB_JTAG_RESET | USB_UART_CHIP_RESET | h8-bench |  |  | af36b005 |  |  |  |  |  |  |  |  |  |  |  |  |  |  | test_mode=BENCH_ENDURANCE | NO_DEVICE_RECORD_AFTER_BANNER | NOT_FOUND_IN_THIS_CAPTURE | boot line firmware field
../A-W04-tec-commissioning/evidence/A/W04/h8/phase4e/h8b-run-2026-10-31/monitor-stdout.log | monitor-stdout.log |  | 3 | UNKNOWN_DATE |  | 0x15 | USB_JTAG_CHIP_RESET | USB_JTAG_RESET | USB_UART_CHIP_RESET | h8-bench |  |  | 5ca09160 |  |  |  |  |  |  |  |  |  |  |  |  |  |  | test_mode=BENCH_ENDURANCE | NO_DEVICE_RECORD_AFTER_BANNER | NOT_FOUND_IN_THIS_CAPTURE | boot line firmware field
../A-W04-tec-commissioning/evidence/A/W04/h8/phase4e/h8b-run-2026-10-31/monitor/telemetry_raw.log | telemetry_raw.log |  | 3 | UNKNOWN_DATE |  | 0x15 | USB_JTAG_CHIP_RESET | USB_JTAG_RESET | USB_UART_CHIP_RESET | h8-bench |  |  | 5ca09160 |  |  |  |  |  |  |  |  |  |  |  |  |  |  | test_mode=BENCH_ENDURANCE | NO_DEVICE_RECORD_AFTER_BANNER | NOT_FOUND_IN_THIS_CAPTURE | boot line firmware field
../A-W04-tec-commissioning/evidence/A/W04/h8/phase4e/h8c-2026-10-31/monitor-stdout.log | monitor-stdout.log |  | 3 | UNKNOWN_DATE |  | 0x15 | USB_JTAG_CHIP_RESET | USB_JTAG_RESET | USB_UART_CHIP_RESET | h8-bench |  |  | 1e47067e |  |  |  |  |  |  |  |  |  |  |  |  |  |  | test_mode=BENCH_ENDURANCE | NO_DEVICE_RECORD_AFTER_BANNER | NOT_FOUND_IN_THIS_CAPTURE | boot line firmware field
../A-W04-tec-commissioning/evidence/A/W04/h8/phase4e/h8c-2026-10-31/monitor/telemetry_raw.log | telemetry_raw.log |  | 3 | UNKNOWN_DATE |  | 0x15 | USB_JTAG_CHIP_RESET | USB_JTAG_RESET | USB_UART_CHIP_RESET | h8-bench |  |  | 1e47067e |  |  |  |  |  |  |  |  |  |  |  |  |  |  | test_mode=BENCH_ENDURANCE | NO_DEVICE_RECORD_AFTER_BANNER | NOT_FOUND_IN_THIS_CAPTURE | boot line firmware field
../A-W04-tec-commissioning/evidence/A/W04/h8/phase4e/h8d-2026-10-31/monitor-stdout.log | monitor-stdout.log |  | 3 | UNKNOWN_DATE |  | 0x15 | USB_JTAG_CHIP_RESET | USB_JTAG_RESET | USB_UART_CHIP_RESET | h8-bench |  |  | 8122d858 |  |  |  |  |  |  |  |  |  |  |  |  |  |  | test_mode=BENCH_ENDURANCE | NO_DEVICE_RECORD_AFTER_BANNER | NOT_FOUND_IN_THIS_CAPTURE | boot line firmware field
../A-W04-tec-commissioning/evidence/A/W04/h8/phase4e/h8d-2026-10-31/monitor/telemetry_raw.log | telemetry_raw.log |  | 3 | UNKNOWN_DATE |  | 0x15 | USB_JTAG_CHIP_RESET | USB_JTAG_RESET | USB_UART_CHIP_RESET | h8-bench |  |  | 8122d858 |  |  |  |  |  |  |  |  |  |  |  |  |  |  | test_mode=BENCH_ENDURANCE | NO_DEVICE_RECORD_AFTER_BANNER | NOT_FOUND_IN_THIS_CAPTURE | boot line firmware field
../A-W04-tec-commissioning/evidence/A/W04/h8/phase4e/h8e-2026-10-31/monitor-stdout.log | monitor-stdout.log |  | 3 | UNKNOWN_DATE |  | 0x15 | USB_JTAG_CHIP_RESET | USB_JTAG_RESET | USB_UART_CHIP_RESET | h8-bench |  |  | c4ff0ab3 |  |  |  |  |  |  |  |  |  |  |  |  |  |  | test_mode=BENCH_ENDURANCE | NO_DEVICE_RECORD_AFTER_BANNER | NOT_FOUND_IN_THIS_CAPTURE | boot line firmware field
../A-W04-tec-commissioning/evidence/A/W04/h8/phase4e/h8e-2026-10-31/monitor/telemetry_raw.log | telemetry_raw.log |  | 3 | UNKNOWN_DATE |  | 0x15 | USB_JTAG_CHIP_RESET | USB_JTAG_RESET | USB_UART_CHIP_RESET | h8-bench |  |  | c4ff0ab3 |  |  |  |  |  |  |  |  |  |  |  |  |  |  | test_mode=BENCH_ENDURANCE | NO_DEVICE_RECORD_AFTER_BANNER | NOT_FOUND_IN_THIS_CAPTURE | boot line firmware field
../A-W04-tec-commissioning/evidence/A/W04/h8/phase4e/post-mount-300s-2026-11-01/monitor-stdout.log | monitor-stdout.log |  | 3 | UNKNOWN_DATE |  | 0x15 | USB_JTAG_CHIP_RESET | USB_JTAG_RESET | USB_UART_CHIP_RESET | h8-bench |  |  | eec9f67f |  |  |  |  |  |  |  |  |  |  |  |  |  |  | test_mode=BENCH_ENDURANCE | NO_DEVICE_RECORD_AFTER_BANNER | NOT_FOUND_IN_THIS_CAPTURE | boot line firmware field
../A-W04-tec-commissioning/evidence/A/W04/h8/phase4e/post-mount-300s-2026-11-01/monitor/telemetry_raw.log | telemetry_raw.log |  | 3 | UNKNOWN_DATE |  | 0x15 | USB_JTAG_CHIP_RESET | USB_JTAG_RESET | USB_UART_CHIP_RESET | h8-bench |  |  | eec9f67f |  |  |  |  |  |  |  |  |  |  |  |  |  |  | test_mode=BENCH_ENDURANCE | NO_DEVICE_RECORD_AFTER_BANNER | NOT_FOUND_IN_THIS_CAPTURE | boot line firmware field
../_w04-g1-evidence/40-g1-boot-60s.log | 40-g1-boot-60s.log | ../_w04-g1-evidence/40-g1-boot-60s.log; evidence/A/W04/g1/40-g1-boot-60s.log | 6 | UNKNOWN_DATE |  | 0x15 | USB_JTAG_CHIP_RESET | USB_JTAG_RESET | USB_UART_CHIP_RESET | cg-w04-0.1.0 | cg-w04-0.1.0 | CG-HW-001 | cb8775eb | 13 | CG_TELEM | OFF | DISABLED | 0 | OFF |  |  |  | nan | NO_DATA | nan | nan | 0x00000000 | BOOT_SAFE_OFF | DEVICE_REPORTED | NOT_FOUND_IN_THIS_CAPTURE | telemetry firmware_version line
../_w04-g1-evidence/41-g1-reset.log | 41-g1-reset.log | ../_w04-g1-evidence/41-g1-reset.log; evidence/A/W04/g1/41-g1-reset.log | 6 | UNKNOWN_DATE |  | 0x15 | USB_JTAG_CHIP_RESET | USB_JTAG_RESET | USB_UART_CHIP_RESET | cg-w04-0.1.0 | cg-w04-0.1.0 | CG-HW-001 | b05067ad | 14 | CG_TELEM | OFF | DISABLED | 0 | OFF |  |  |  | nan | NO_DATA | nan | nan | 0x00000000 | BOOT_SAFE_OFF | DEVICE_REPORTED | NOT_FOUND_IN_THIS_CAPTURE | telemetry firmware_version line
../_w04-g1-evidence/41-g1-reset.log | 41-g1-reset.log | ../_w04-g1-evidence/41-g1-reset.log; evidence/A/W04/g1/41-g1-reset.log | 106 | UNKNOWN_DATE |  | 0x15 | USB_JTAG_CHIP_RESET | USB_JTAG_RESET | USB_UART_CHIP_RESET | cg-w04-0.1.0 | cg-w04-0.1.0 | CG-HW-001 | 8ddececf | 15 | CG_TELEM | OFF | DISABLED | 0 | OFF |  |  |  | nan | NO_DATA | nan | nan | 0x00000000 | BOOT_SAFE_OFF | DEVICE_REPORTED | NOT_FOUND_IN_THIS_CAPTURE | telemetry firmware_version line
../_w04-g1-evidence/61-g1-boot60.log | 61-g1-boot60.log | ../_w04-g1-evidence/61-g1-boot60.log; evidence/A/W04/g1/61-g1-boot60.log | 6 | UNKNOWN_DATE |  | 0x15 | USB_JTAG_CHIP_RESET | USB_JTAG_RESET | USB_UART_CHIP_RESET | cg-w04-0.1.0 | cg-w04-0.1.0 | CG-HW-001 | 76b491cd | 18 | CG_TELEM | OFF | DISABLED | 0 | OFF |  |  |  | nan | NO_DATA | nan | nan | 0x00000000 | BOOT_SAFE_OFF | DEVICE_REPORTED | NOT_FOUND_IN_THIS_CAPTURE | telemetry firmware_version line
../_w04-g1-evidence/62-g1-reset.log | 62-g1-reset.log | ../_w04-g1-evidence/62-g1-reset.log; evidence/A/W04/g1/62-g1-reset.log | 6 | UNKNOWN_DATE |  | 0x15 | USB_JTAG_CHIP_RESET | USB_JTAG_RESET | USB_UART_CHIP_RESET | cg-w04-0.1.0 | cg-w04-0.1.0 | CG-HW-001 | 379247f2 | 19 | CG_TELEM | OFF | DISABLED | 0 | OFF |  |  |  | nan | NO_DATA | nan | nan | 0x00000000 | BOOT_SAFE_OFF | DEVICE_REPORTED | NOT_FOUND_IN_THIS_CAPTURE | telemetry firmware_version line
../_w04-g1-evidence/62-g1-reset.log | 62-g1-reset.log | ../_w04-g1-evidence/62-g1-reset.log; evidence/A/W04/g1/62-g1-reset.log | 92 | UNKNOWN_DATE |  | 0x15 | USB_JTAG_CHIP_RESET | USB_JTAG_RESET | USB_UART_CHIP_RESET | cg-w04-0.1.0 | cg-w04-0.1.0 | CG-HW-001 | 02f6c372 | 20 | CG_TELEM | OFF | DISABLED | 0 | OFF |  |  |  | nan | NO_DATA | nan | nan | 0x00000000 | BOOT_SAFE_OFF | DEVICE_REPORTED | NOT_FOUND_IN_THIS_CAPTURE | telemetry firmware_version line
