minhqng/predictive-cold-chain-aiot/evidence/A/W04/g1/23-build-provenance.txt

=== BUILD ARTIFACT HASHES ===
b1aeaf744710bc1aa533c7ac428f814cd8ba8469fd304585cd344e1fa52aef94 *build/bootloader/bootloader.bin
7f00b6c042a89b15b0cac534f82ed988caf29278ff5700b0c511eb1b5bb7c820 *build/partition_table/partition-table.bin
7cb26583743a4a9d246eb6f87f45940623bb52d4ceab672157dd49a9d5e9c6df *build/coldguard_firmware.bin
c4c78a29e57112d8986b744bb52b2336650bcc6be5ac0b641e42be65e1c28f78 *build/coldguard_firmware.elf

=== SDKCONFIG (safety-relevant) ===
CONFIG_IDF_TARGET="esp32s3"
CONFIG_IDF_TARGET_ESP32S3=y
CONFIG_BOOTLOADER_WDT_ENABLE=y
CONFIG_BOOTLOADER_WDT_TIME_MS=9000
CONFIG_ESPTOOLPY_FLASHSIZE_2MB=y
CONFIG_ESPTOOLPY_FLASHSIZE="2MB"
CONFIG_PARTITION_TABLE_SINGLE_APP=y
CONFIG_PARTITION_TABLE_CUSTOM_FILENAME="partitions.csv"
CONFIG_PARTITION_TABLE_FILENAME="partitions_singleapp.csv"
CONFIG_PARTITION_TABLE_OFFSET=0x8000
CONFIG_PARTITION_TABLE_MD5=y
CONFIG_COMPILER_OPTIMIZATION_DEBUG=y
CONFIG_COMPILER_OPTIMIZATION_ASSERTIONS_ENABLE=y
CONFIG_COMPILER_OPTIMIZATION_ASSERTION_LEVEL=2
CONFIG_ESP_CONSOLE_UART_DEFAULT=y
CONFIG_ESP_CONSOLE_SECONDARY_USB_SERIAL_JTAG=y
CONFIG_ESP_CONSOLE_USB_SERIAL_JTAG_ENABLED=y
CONFIG_ESP_CONSOLE_UART=y
CONFIG_ESP_CONSOLE_UART_NUM=0
CONFIG_ESP_CONSOLE_ROM_SERIAL_PORT_NUM=0
CONFIG_ESP_CONSOLE_UART_BAUDRATE=115200
CONFIG_ESP_SYSTEM_PANIC_PRINT_REBOOT=y
CONFIG_ESP_SYSTEM_PANIC_REBOOT_DELAY_SECONDS=0
CONFIG_ESP_INT_WDT=y
CONFIG_ESP_INT_WDT_TIMEOUT_MS=300
CONFIG_ESP_INT_WDT_CHECK_CPU1=y
CONFIG_ESP_TASK_WDT_EN=y
CONFIG_ESP_TASK_WDT_INIT=y
CONFIG_ESP_TASK_WDT_TIMEOUT_S=5
CONFIG_ESP_TASK_WDT_CHECK_IDLE_TASK_CPU0=y
CONFIG_ESP_TASK_WDT_CHECK_IDLE_TASK_CPU1=y
CONFIG_COMPILER_OPTIMIZATION_LEVEL_DEBUG=y
CONFIG_COMPILER_OPTIMIZATION_DEFAULT=y
CONFIG_ESP_TASK_WDT=y

=== FLASH ARGS ===
--flash-mode dio --flash-freq 80m --flash-size 2MB
0x0 bootloader/bootloader.bin
0x8000 partition_table/partition-table.bin
0x10000 coldguard_firmware.bin

=== app descriptor (esptool image-info) ===
esptool v5.6.0
Image size: 244352 bytes
Detected image type: ESP32-S3

ESP32-S3 Image Header
=====================
Image version: 1
Entry point: 0x403756cc
Segments: 6
Flash size: 2MB
Flash freq: 80m
Flash mode: DIO

ESP32-S3 Extended Image Header
==============================
WP pin: 0xee (disabled)
Flash pins drive settings: clk_drv: 0x0, q_drv: 0x0, d_drv: 0x0, cs0_drv: 0x0, hd_drv: 0x0, wp_drv: 0x0
Chip ID: 9 (ESP32-S3)
Minimal chip revision: v0.0, (legacy min_rev = 0)
Maximal chip revision: v0.99

Segments Information
====================
Segment   Length   Load addr   File offs  Memory types
-------  -------  ----------  ----------  ------------
      0  0x0c810  0x3c020020  0x00000018  DROM
      1  0x03318  0x3fc91700  0x0000c830  BYTE_ACCESSIBLE, MEM_INTERNAL, DRAM
      2  0x004c0  0x40374000  0x0000fb50  MEM_INTERNAL, IRAM
      3  0x1e82c  0x42000020  0x00010018  IROM
      4  0x0d1d0  0x403744c0  0x0002e84c  MEM_INTERNAL, IRAM
