minhqng/predictive-cold-chain-aiot/docs/leader-delivery/pr113-reconstructed-commits.csv

old_sha | proposed_sha | change | tree | old_parents | proposed_parents | subject | week_number | invalid_grammar | signature_present
240b39351dd972dcc10b6287ac9f896d8616e354 | de17a171924c775d8fd00664af9b39df02b66493 | integration identity and subject | 0f28f0c33e25a1aa7f6bb31a2434a842e0772d7a | d22c8d5b1fb3c05d8a9732ed0087d8e76b9f9e85 ae23a36fe98fcf1bf6005dd9fcd79b95fb796570 | d22c8d5b1fb3c05d8a9732ed0087d8e76b9f9e85 ae23a36fe98fcf1bf6005dd9fcd79b95fb796570 | chore(integration): integrate telemetry contract remediation | 0 | 0 | 0
2cd8023a064342535d26d90d6cfd275d5a2a1d06 | 8f31f0a0a797508ec779c40fd181ea35fed339c5 | required owner subject normalization | 46bf4feec2c902bce8f8c9243df31c44e11baf76 | 240b39351dd972dcc10b6287ac9f896d8616e354 815387d19a3898e6b33ccb65758a554dd0c589e1 | de17a171924c775d8fd00664af9b39df02b66493 815387d19a3898e6b33ccb65758a554dd0c589e1 | chore(integration): integrate acceptance integrity repairs | 0 | 0 | 0
36fe0382b0b6c9c82956c19f7f2cefa38c2bdc89 | adc888b2464ddbde96454817e8e623c42fa33824 | remove tool attribution | cf05078bb8f5a59caf941f9c8bed8c08207b3a5e | 0b6ec400b77cfc1cf22fab8b180f06dc1920d60d | 0b6ec400b77cfc1cf22fab8b180f06dc1920d60d | fix(commands): defer broker PUBACK until ACK evidence is committed | 0 | 0 | 0
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
7825524e8a2c2722019586d188ef5f6c7d3902a8 | 653414ef8cd067f9aa2f5eaeb7220a460048392f | parent only | ef75a7064bc47ab338700b632a45553f189a1ef3 | a6818a4047cfc16de84c121b9bd90fd2e04b7fcd | 6bd9cba291d634799776fffdb3f0c0ab044a5bbb | docs(qa): record the phase8.2 final verification verdict | 0 | 0 | 0
cddce2a6c4a9a062b74d98619b1678b8f791d3b8 | 5b841a7d576ca1a06606fac442093092545ec7e8 | parent only | 1f7a2283dbf6979cde3ad645c1885ae452a9b018 | 7825524e8a2c2722019586d188ef5f6c7d3902a8 | 653414ef8cd067f9aa2f5eaeb7220a460048392f | docs(qa): pin the phase8.2 terminal verdict and manifest | 0 | 0 | 0
776c022d616b35f5cae94db9583a0ff283619e29 | 99698120dfc63b3166ba87c7ef21efa3cbaefd11 | parent only | 1fc2942ca02071c5ca7875ebdca1a6c740e42fe1 | cddce2a6c4a9a062b74d98619b1678b8f791d3b8 | 5b841a7d576ca1a06606fac442093092545ec7e8 | docs(qa): repin terminal git reference after owner attribution rewrite | 0 | 0 | 0
0a0b99b4269d4e25597ab524d946e224c64ace08 | 48c09106c1bdf167d3af0426d487005a04cc95c8 | parent only | 30e8dd70f53e78c2ad24fc5ef26251fc7a34e5d8 | 776c022d616b35f5cae94db9583a0ff283619e29 | 99698120dfc63b3166ba87c7ef21efa3cbaefd11 | docs(leader-delivery): add 52-week member-pr traceability and refresh PR description | 0 | 0 | 0
