minhqng/predictive-cold-chain-aiot/evidence/A/W23/imports/A-W23-03/7537ff47deea-01-overview-wiring.jpg

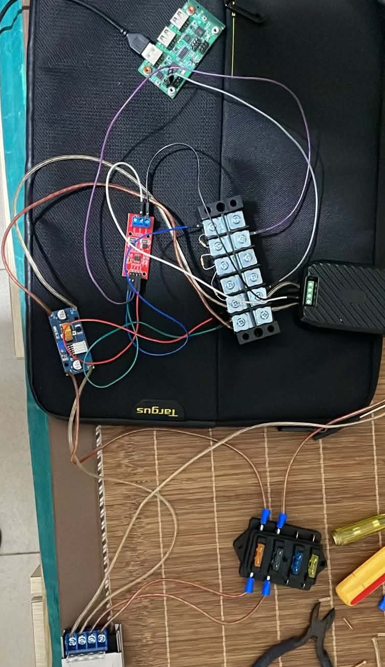
evidence/A/W23/imports/A-W23-03/7537ff47deea-01-overview-wiring.jpg
