minhqng/predictive-cold-chain-aiot/evidence/A/W23/operator-submission-20261108/fuse-block-installed.png

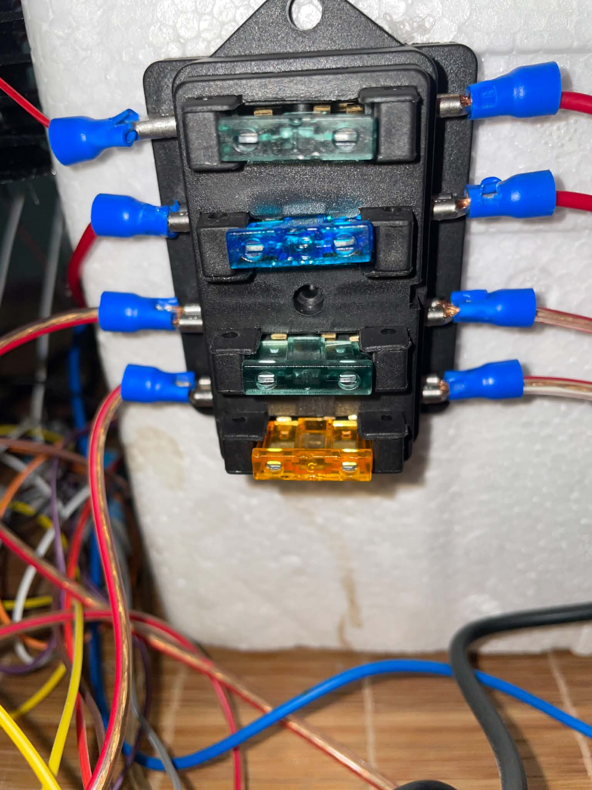
evidence/A/W23/operator-submission-20261108/fuse-block-installed.png
