minhqng/predictive-cold-chain-aiot/evidence/A/W14/sensor-position-qa.md

# W14 sensor-position QA (A-W14-01)

Generated by `evidence/A/W14/build_w14_artifacts.py`. Host analysis of committed captures: nothing was measured, no probe was touched, and no new identification test is proposed or authorized.

## The ask, and what it can honestly become

docs/05A A-W14-01 says *verify no movement since freeze*. Archived telemetry cannot verify physical non-movement: the frames carry no sensor ROM ids, so channel identity across boots is not established by the wire, and no frame records mounting, tip height, clearance, orientation or cable path. What this deliverable is therefore written as: a **method plus a baseline**, so the next capture can be checked, with the two states kept apart instead of blurred.

The sentence this tool refuses to print is `"no movement verified"`; the guard in `cg_w14_sensor_qa.guard_no_forbidden_claim` and this dossier's validator both fail if it ever appears as an assertion.

## Frozen baseline this check is written against

- geometry: `evidence/A/W07/geometry-v1.md §1`
- identification record: `evidence/A/W07/probe-identification-v0.md`
- slot to position: `{'t1_c': 'CHAMBER_CENTER', 't2_c': 'TEC_HOT_SIDE', 't3_c': 'CHAMBER_BOTTOM', 't4_c': 'CHAMBER_NEAR_DOOR'}`
- capture role labels the record documents: `{'t1_role': 'UNASSIGNED', 't2_role': 'HOT_SIDE', 't3_role': 'UNASSIGNED', 't4_role': 'UNASSIGNED'}`
- frozen by: operator-confirmed identification accepted as the official as-built record; no new identification test is authorized

## CURRENT-VERIFIABLE (today, from the rows already on disk)

- capture role labels versus the frozen record: **MATCH**
- behaviour consistent with the frozen geometry: **True**
- the only channel that rose while the bridge was driven: `['t2_c']`
- air triad maximum spread in that session: `1.126 C`

Statements this supports:

- the committed session's own role column says MATCH against the labels the frozen record documents
- in that session exactly one channel rose while the bridge was driven and it is the slot the record calls TEC_HOT_SIDE, while all three air channels fell - the data and the frozen geometry agree
- the three air channels stayed within 1.126 C of each other while the hot-side surface separated by up to 18.459 C, which is the shape three tips in the air volume plus one on metal produce

Statements this does **not** support:

- that no probe moved after the freeze: the only session on disk predates every later date, so it cannot describe a period after it
- that a channel in a new capture is the same physical probe: the H8S schema-3 frames carry no sensor ROM ids, so slot identity is not established by the wire
- tip height, clearance, orientation, mounting method or cable path: none of these is in any frame

## Baseline behaviour signature, per channel

| slot | role | samples | mean driven C | delta C | direction | sd within session C |
|---|---|---|---|---|---|---|
| `t1_c` | CHAMBER_CENTER | 600 | 23.2848 | -9.25 | DOWN | 2.9362 |
| `t2_c` | TEC_HOT_SIDE | 600 | 37.5119 | 9.687 | UP | 2.4034 |
| `t3_c` | CHAMBER_BOTTOM | 600 | 24.0158 | -8.125 | DOWN | 2.5852 |
| `t4_c` | CHAMBER_NEAR_DOOR | 600 | 23.6663 | -8.75 | DOWN | 2.7149 |

Channel rank by level (high to low): `['t2_c', 't3_c', 't4_c', 't1_c']`. Hot-side surface minus air mean: `{'min': -0.1667, 'max': 18.459, 'mean': 13.8563}` C.

## NEEDS-A-NEW-CAPTURE (what only a fresh session can say)

- status: **NO_CANDIDATE_CAPTURE** - distinct candidate sessions available: `0`
- question it can answer: whether role labels and per-channel behaviour still match the frozen record - a match is a consistency observation, never a proof of non-movement
- question it cannot answer: physical non-movement, which needs the mounting and photo evidence below

Protocol the next capture must meet for this check to mean anything:

- same stage, same commanded duty and duration as the frozen baseline, TEC driven once, door CLOSED with door_polarity CONFIRMED
- >= 600 samples at the commanded 1 Hz so the driven block is as long as the baseline's
- run this tool against the baseline capture before any statistic from the new session is published
- a ROM readback or an equivalent per-channel identity record, because the schema in use carries none

## NEEDS-PHYSICAL-EVIDENCE (what no capture can say)

- status: `NOT_IN_ANY_CAPTURE` - owner: operator, at a supervised session (NEED_USER_ACTION)

- configuration photo or drawing of the three air tips with a scale
- mounting method, height, clearance and orientation per probe
- cable path and strain-relief record
- confirmation that the operator's wire labels still match the slots

## What each mismatch would mean, physically

A flag nobody can interpret is not a QA method, so every check names its own consequences. These are stated as candidates for inspection, not conclusions.

- **`capture_role_label_mismatch`** - the firmware's role column no longer matches the label the frozen record documents, which means the image, pin-map version or slot-to-channel map changed - the capture is then describing a different logical geometry, not the frozen one. It is not by itself proof that a probe was moved.
- **`hot_side_channel_moved`** - the channel that rises while the bridge is driven is no longer the slot the record calls TEC hot side: either the hot-side probe left the stack, an air probe is now touching the stack or a rack, or the 1-Wire slots were re-mapped at the connector. Any of these invalidates the air/hot split every W07 statistic is built on.
- **`air_triad_direction_change`** - one of the three chamber-air channels stopped falling while driven, so that tip is no longer sampling the air volume the other two agree about - the most likely causes are a probe that moved, became coupled to a surface, or became electrically stale while the value held.
- **`air_separation_change`** - the mutual spread of the three air probes left the band the baseline session shows. Because that band comes from one run's within-session drift, this is a flag to look, not a measurement of movement: it also fires if the chamber started at a different load or the door was left cracked.
- **`level_offset_beyond_baseline_band`** - the absolute levels sit outside the baseline session's own drift band. That is expected whenever start conditions differ, so on its own it says nothing about position; it only matters together with a direction or separation change.
- **`rank_order_change`** - the ordering of the channels by level flipped. Positions in a stratified chamber set the ordering, so a persistent flip with everything else unchanged is the pattern a probe swap or a probe that moved a shelf over would leave.

## Verdict

- movement since freeze: **NOT_VERIFIABLE_FROM_ARCHIVED_DATA**
- capture role labels now: **MATCH**
- behaviour agrees with the frozen geometry for the session on disk: **True**
- non-movement status: **NEEDS_A_NEW_CAPTURE_AND_PHYSICAL_EVIDENCE**
- policy: this report never states or implies that movement was ruled out

## Reproduce

```bash
py firmware/tools/cg_w14_sensor_qa.py --baseline evidence/A/W04/tec-cooling-response-600s.csv
py evidence/A/W14/build_w14_artifacts.py --check
py evidence/A/W14/validate_w14.py
```
