minhqng/predictive-cold-chain-aiot/evidence/A/W04/h6/08-refix-flash-verification.md

# H6 corrected PZEM image — flash and boot verification (2026-10-29)

Status: **PASS — corrected image flashed, selftest 172/172, SAFE_OFF and
WAIT_FOR_MANUAL_ARM confirmed, no output and no reboot in a 60 s idle window.
Stopped at the power-restoration gate.** No `ARM`, no `START`, TEC branch
fuse still removed, PSU still off.

## 1. Operator isolation (prerequisite)

Operator confirmed before this session: PSU 12 V OFF and disconnected from AC,
TEC 15 A fuse (slot 3) removed while unpowered, all other wiring unchanged,
ESP32-S3 still on USB.

## 2. Target identity

`esptool --chip esp32s3 -p COM4 -b 460800 chip-id`:

```
Chip type:          ESP32-S3 (QFN56) (revision v0.2)
USB mode:           USB-Serial/JTAG
MAC:                e0:72:a1:bc:cf:4c        <- matches the required target
```

## 3. Flash (`12-flash-h6-fix.log`)

```
esptool --chip esp32s3 -p COM4 -b 460800 --before default-reset --after hard-reset \
  write-flash --flash-mode dio --flash-freq 80m --flash-size 2MB \
  0x0     _h6-build/bootloader/bootloader.bin \
  0x8000  _h6-build/partition_table/partition-table.bin \
  0x10000 _h6-build/coldguard_h6_bench.bin
```

| Offset | Image | Bytes | esptool |
|---|---:|---:|---|
| 0x00000 | bootloader | 19 008 | Hash of data verified |
| 0x08000 | partition table | 3 072 | Hash of data verified |
| 0x10000 | app | 248 592 | Hash of data verified |

No chip erase. Sector erases limited to 0x0–0x5FFF, 0x8000–0x8FFF and
0x10000–0x4CFFF (app end 0x4CB10); NVS at 0x9000 untouched.
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
