minhqng/predictive-cold-chain-aiot/evidence/D/W01/hazard-ledger-v0.md

# Hazard ledger v0 (W01)

**Scope:** W01 design hazards for the ColdGuard P0 cooling-control path.
W01 itself contains no policy implementation or automated test evidence.
**Status:** v0 living ledger. Not an FMEA, not a certification, no quantitative
risk acceptance.
**Owners:** Doc 04 ownership; "D" means Member D, but detection, hardware
characterization and cloud controls remain with A/B/C/W11/W13 as named.

Severity is intentionally qualitative (`S1` high / `S2` medium / `S3` low) until
the team freezes a risk method. `Open` means no complete, verified mitigation
exists in this workspace. Test IDs in the Evidence column are planned W03 or
later verification targets; they are not present or executed in this W01 branch.

| ID | Hazard | Trigger | Potential harm | Prevention / invariant | Detection | Mitigation | Evidence | Status / owner |
|---|---|---|---|---|---|---|---|---|
| H-01 | Unintended actuation at boot/reset | Reset, watchdog, brown-out, firmware start | TEC/fan energizes before state is known | Boot default OFF; policy undefined in `BOOT`/`SELF_TEST`; watchdog-safe output | Boot self-test, actuator feedback (future) | Hardware default-off + explicit self-test gate | `test_policy_undefined_before_online_modes` | Partial — A/firmware; W03 only refuses to decide |
| H-02 | TEC ON while heat-rejection fan unavailable | Fan failure, connector fault, fan state unknown | Hot-side overheating, reduced cooling, hardware stress | PHY-SAFE-002: no energization without confirmed fan availability | Fan feedback/current evidence (A) | Command validator blocks ON when `fan_available is not True`; hardware interlock required | `test_unknown_fan_state_is_not_treated_as_healthy`, `test_fan_unavailable_blocks_energization` | Partial — A hardware interlock + D gate |
| H-03 | Stale command applied after delay/reconnect | Old queued/retained command, clock skew | Actuation that no longer matches plant state | TTL (`expires_at`), no retained commands, freshness check | Command timestamp vs local time; ACK `EXPIRED` | Reject at schema/expiry gate; SAFE_LOCAL exit also requires no stale pending command | `test_expired_command_is_rejected`, `test_retained_command_is_rejected`, `test_stale_pending_command_blocks_exit_even_with_good_telemetry` | Mitigated in design — W03 validator; transport still W04/C |
| H-04 | Duplicate command causes repeated actuation | QoS 1 redelivery, retry, reconnect | Chatter, repeated thermal/electrical stress | Idempotency by `command_id`; return canonical status, never re-actuate | Processed-command record | `DUPLICATE_CANONICAL` + HOLD, no second actuation | `test_duplicate_returns_canonical_status_without_reactuating`, `test_expiry_is_checked_before_duplicate` | Mitigated in design — persistence across reboot is C/A |
| H-05 | Command for another device is applied | Topic/ACL mistake, shared credentials, bug | Wrong chamber cooled; target chamber uncontrolled | Per-device identity; device-id check before any action | Device-id mismatch | `COMMAND_WRONG_DEVICE` rejection | `test_wrong_device_is_rejected_before_expiry` | Mitigated in design — ACL owner infra/C |
| H-06 | Out-of-range duty/action | Bad UI, model error, malformed payload, uncharacterized PWM | Overcurrent, thermal stress, unintended full power | Range check against characterized action family; PWM only if explicitly enabled | Schema/range validation | `OUT_OF_RANGE`; non-PWM config rejects any duty; OFF with non-zero duty rejected | `test_duty_on_non_pwm_configuration_is_out_of_range`, `test_pwm_duty_outside_characterized_range_is_out_of_range`, `test_off_with_nonzero_duty_is_out_of_range` | Partial — PWM bounds not frozen (A/W04) |
| H-07 | Actuation driven by invalid/missing sensor data | Probe failure, CRC error, disconnected DS18B20, stale cache | Under- or over-cooling based on fiction; loss of protection | INVALID/UNKNOWN never carries a value; no substitution; predictive prohibited; lockout when protection cannot be computed | Quality state, age, CRC/identity checks (A) | Reject invalid inputs; `FAULT_LOCKOUT` for unusable critical state; stale → HOLD/no new actuation | `test_invalid_quality_must_not_carry_a_substituted_value`, `test_unusable_critical_thermal_state_locks_out`, `test_stale_thermal_state_is_fault_with_no_new_actuation` | Partial — quality classifier + stale fallback owned by A/W05 |
| H-08 | Current while commanded OFF | Relay/MOSFET failure, wiring fault, sensor offset | Unintended heating/cooling, electrical hazard, false safety belief | OFF must be electrically verifiable; unexpected current is high severity | PZEM OFF-current envelope (A) | Control electrical anomaly → `FAULT_LOCKOUT`; no further actuation | `test_control_electrical_anomaly_beats_heat_and_prediction` | Partial — envelope/detector owner A; W11 incident actions |
| H-09 | Hot-side abnormality / poor heat rejection | Fan/duct/ambient problem, blocked airflow | Cooling degrades; TEC overheats; false confidence in cooling | Hardware safety stop; hot-side characterization | Characterized stop condition (A), thermal/electrical evidence (W11) | Asserted hardware condition → `FAULT_LOCKOUT`; taxonomy marks F-THERM-02 not contracted | `test_hardware_safety_condition_beats_heat_and_prediction`, `classify_failure("F-THERM-02")` | Open — stop condition not characterized (A/W11) |
| H-10 | Cloud/broker loss stops or corrupts control | Network outage, broker crash, backend DB down | Loss of remote supervision; stale remote intent on reconnect | SAFE_LOCAL local deterministic control; remote predictive commands disabled; verified exit | Heartbeat/offline timer, backend state age, sync trust | Enter SAFE_LOCAL after grace; hold local hysteresis; exit only when all requirements hold | `test_broker_loss_enters_safe_local_with_local_hysteresis`, `test_untrusted_twin_state_enters_safe_local_not_remote_trust`, `test_safe_local_exits_only_when_every_requirement_holds` | Partial — local actuator behavior and timers on device (A); final timings W05 |
| H-11 | Control-task starvation / missed protection deadline | Blocking I/O, long GC, MQTT/DB work in control loop, priority bug | Temperature crosses limit while policy never runs | Control task isolated, bounded work, watchdog; pure core has no I/O | Task heartbeat, watchdog, deadline monitor | Architecture requirement (A/W13); W03 reports none of this as tested | None in W03 | Open — A/firmware, W13 |
| H-12 | Old/stale prediction reused as current truth | Model timeout, frozen inference, Redis/DB delay | Preemptive action on obsolete risk; missed critical trend | Freshness bound; READY health; version match; never reuse one old score | Prediction age/version/health | `SAFE_LOCAL` + `AI_UNAVAILABLE` when predictive policy is enabled and evidence is stale/unhealthy; A still protects | `test_stale_prediction_is_never_reused_for_actuation`, `test_unavailable_model_blocks_preemptive_action` | Mitigated in design — model health producer B/C |
| H-13 | Model (or DB/UI/operator) reaches GPIO directly | Convenience bypass, shared credentials, endpoint added later | Unvalidated actuation, loss of local authority | One policy gate; no model→device path; device may reject any command; trust-boundary design | Architecture review, import/call purity tests | Compile-time/purity guard plus broker ACL; review required for every new path | `test_core_imports_no_transport_db_gpio_or_web_modules`, `test_core_never_calls_transport_actuation_or_clock_functions`, `test_decision_has_no_actuator_or_transport_fields`; `trust-boundary.png` | Mitigated in design — infra/C must enforce |
| H-14 | Reconnect replays remote intent or restores trust too early | Link flap, broker session resume, backend restart | Sudden remote actuation after an outage | Reconnect ≠ trust; stable-connectivity window; reconciled state; no stale command; fresh valid telemetry | Exit-gate evidence and missing-requirement list | Stay in SAFE_LOCAL until every requirement is satisfied | `test_reconnect_alone_does_not_restore_remote_trust`, `test_safe_local_exit_requires_fresh_valid_telemetry_and_no_fault`, `test_safe_local_exit_requires_healthy_prediction_when_predictive_on` | Mitigated in design — device persistence/reconciliation A/C |
| H-15 | Unauthenticated/unauthorized command | Credential leak, ACL gap, spoofed broker client | Attacker controls cooling or disables protection | mTLS/identity, least-privilege ACL, backend authz, command authorization evidence | Broker auth logs, backend audit | Validator rejects `authorized=False`; full authn/authz is outside the pure core | `test_unauthorized_command_is_rejected` | Partial — infra/C own actual identity and ACL |
| H-16 | Predictive/optimization suppresses critical protection | Model bug, threshold conflict, priority inversion | No cooling at the critical boundary | Lexical safety hierarchy; Controller A gate precedes predictive | Decision state/reason audit | `CRITICAL_PROTECTION` + REACTIVE wins at/above upper boundary; FAULT wins over optimization | `test_critical_protection_beats_fresh_predictive_warning`, `test_plain_fault_beats_every_predictive_optimization` | Mitigated in design — W03 unit level |

## Explicitly out of scope for this ledger version

- Quantitative severity/probability, detectability scoring and residual-risk
  acceptance. These require a team-agreed risk method and field evidence.
- Cybersecurity threat modeling beyond the P0 baseline; see
  `security-baseline-v0.md`.
- Physical fault injection (no device was driven, no heater/fan was forced).
- Multi-chamber/site-level hazards, maintenance mistakes and supply-chain
  compromise. These are not covered by Docs 00–05D evidence available here.

## Change rule

A hazard row may move to `Mitigated` only with a reproducible test/evidence
reference and the named owner's confirmation. Until then it stays `Partial` or
`Open`; a design note is not a verified mitigation.
