minhqng/predictive-cold-chain-aiot/(commit log)

2026-10-14 feat: establish backend contracts and reproducible runtime
    Member C W01 backend foundation: modular FastAPI package map (api, config, contracts, migrations), three-service Compose runtime (Mosquitto, PostgreSQL/TimescaleDB, backend), telemetry/command fixtures v0 with wire schema 1 and single cooling branch, Alembic baseline revision 0001 with no domain tables, and dev/integration/experiment configuration policy. No ingestion, twin runtime, prediction, or control yet.
    [config.py, contracts.py]
2026-10-14 feat(backend): authenticated MQTT ingestion with raw persistence
    * feat: add authenticated MQTT ingestion with raw persistence (C-W02)
    C-W02-01: Mosquitto authenticated profile (password file provisioned
    per checkout, device-scoped ACL v0, anonymous denied, TLS-ready
    structure without deployed TLS).
    C-W02-02: deterministic synthetic device publishing telemetry/event/
    state/health with canonical QoS/retain over MQTT 5.
    C-W02-03: real backend MQTT subscriber in the FastAPI process with
    controlled lifecycle and DB-commit durability boundary.
    C-W02-04: telemetry_raw evidence table (migration 0002) retaining
    valid, invalid-schema and malformed payloads with exact bytes, status
    and diagnostics.
    C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
2026-10-14 feat(backend): validate and deduplicate normalized telemetry
    * feat(backend): validated normalized telemetry with idempotent ingestion
    Strict runtime schema validation (exact wire types, supported schema v1, timezone-aware event time, finite numbers, quality contract) plus topic/device identity agreement; wire-valid mismatches persist as REJECTED_TOPIC_MISMATCH evidence and never normalize.
    Normalized single-branch telemetry table with UNIQUE(device_id, boot_id, seq) and intentional ON CONFLICT DO NOTHING: exact replays converge to one authoritative sample, conflicting replays preserve authority with diagnostics. Raw stays an append-only delivery log (no raw UNIQUE; W02 duplicate history p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
2026-10-17 feat(ml): member-B W02 synthetic harness (B-W02-01..05)
    W02 turns the W01 data-side contracts into executable, leakage-safe
    machinery. Stacked directly on feat/b-w01-research-data-contract.
    - errors: explicit exception hierarchy (DataContract/Identity/Order/
    Manifest/Split/Window/Label under ColdguardError) — failures are
    raised, never silently repaired.
    - observations: canonical sample identity (device_id, boot_id, seq),
    tz-aware event time, per-section quality domains, QoS-1 dedup with
    payload-contradiction detection, boot-scoped canonical order.
    - synthetic (B-W02-01): deterministic SyntheticRunSpec -> synthetic
    runs over the canonical S1..S6 scenario vocabulary, 3 trend shap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
2026-10-18 docs(hardware): record BOM audit and physical evidence
    [bom-audit.csv, photo-inventory.csv]
2026-10-18 docs(sensors): record bench evidence and ROM role map
    Ghi lại bằng chứng bench W02 của Member A: bản đồ ROM DS18B20 sang vai trò T1/T2/T3 (+1 spare, trạng thái ROLE_ASSIGNED_PHYSICAL_LABEL_PENDING), tổng hợp 600/600 mẫu hợp lệ cho 4 đầu dò, bộ đếm MC-38 đạt 24 chu kỳ, kèm 3 ảnh log gốc byte-identical và provenance có SHA-256.
    Hồ sơ giữ nguyên hai hạng mục còn treo: A-W02-06 BME280 = PENDING_TEST (bổ sung bằng commit mới vào cùng PR) và A-W02-01 H0 mechanical = DEFERRED (chờ trưởng nhóm xác nhận điều chỉnh lịch). W02 KHÔNG được đánh dấu PASS.
    Thêm validate_w02.py kiểm tra cấu trúc, hash ảnh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
    [screenshot-provenance.csv]
2026-10-18 feat(firmware): add fixed-ROM sensing and debounced door input
    Firmware W02 của Member A: DS18B20 dùng chung một lần chuyển đổi
    (broadcast SKIP_ROM + CONVERT_T) rồi đọc từng đầu dò bằng MATCH_ROM theo
    bản đồ ROM cố định T1/T2/T3/SPARE - không phụ thuộc thứ tự discovery.
    Giá trị không đọc được luôn in "nan", không bao giờ 0.0 hay giá trị cũ.
    MC-38: chống dội cấu hình bằng CG_DOOR_DEBOUNCE_MS, đếm riêng cạnh thô và
    cạnh đã commit; khi CG_DOOR_POLARITY_CONFIRMED=0 mọi trạng thái ngữ nghĩa
    là UNVERIFIED (không đoán polarity). Log serial grammar v1: mỗi dòng "#CG"
    có uptime/seq/validity; "#CG ROMS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
    [app_main.c, cg_build_door_csv.py, cg_build_sensor_csv.py, cg_capture.py, cg_check_firmware.py, cg_door.c, cg_door.h, cg_ds18b20.c]
2026-10-18 docs(firmware): bind sensor evidence to verified firmware revision
    Vòng phản biện độc lập thứ hai (không do tác giả thực hiện) đã trả về BLOCKER
    F01-F04, MAJOR F05, các MINOR F06-F14 và NOTE N01-N06. Toàn bộ đã được đối
    chiếu với mã nguồn, xác nhận đúng, và xử lý: phần mã firmware/công cụ nằm ở
    commit trước (0eb1f8a9...), commit này hoàn tất phần hồ sơ.
    - BLOCKER F01-F04: hồ sơ trước đây in kết quả "3/3 PASS"/STRUCTURE PASS không
    tái lập được khi firmware_commit còn là placeholder. Nay firmware_commit =
    0eb1f8a9731e4810304332910df168ce30de30b5 (commit firmware thật, chứa đủ 5
    mod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
2026-10-18 ci(firmware): build ESP32-S3 firmware with ESP-IDF v6.1
    Thêm workflow GitHub Actions biên dịch project firmware/ bằng image
    chính thức espressif/idf:v6.1 (đúng lệnh README: idf.py set-target
    esp32s3 && idf.py build trong bản sao scratch). Job không chạm phần
    cứng: không flash, không serial, không điều khiển tải. Upload log
    build + artifact firmware làm bằng chứng compile-pass.
2026-10-18 ci(firmware): trust checkout to record build source revision
    Run đầu tiên (head 1ba52b2) cho thấy git rev-parse HEAD trong job
    container fail vì 'dubious ownership' (container chạy root, checkout thuộc
    runner user) nên trường source_commit trong environment.txt bị rỗng.
    Thêm safe.directory trước khi ghi environment + build report.
2026-10-18 fix(firmware): yêu cầu esp_driver_gpio cho driver/gpio.h trên ESP-IDF v6
    Build ESP-IDF thật trên run 39117011427 fail:
    cg_onewire.c:16 / cg_door.c:8: fatal error: driver/gpio.h: No such file
    Build system chỉ rõ esp_driver_gpio không nằm trong requirements của main.
    ESP-IDF v6.x tách GPIO APIs sang esp_driver_gpio; meta-component 'driver'
    không còn re-export header này.
    Sửa: thêm PRIV_REQUIRES esp_driver_gpio; bỏ 'driver' vì không còn API
    thuộc component đó được dùng.
2026-10-18 docs(firmware): record ESP-IDF CI build evidence
    - Thêm evidence/A/W02/build-report-w02.md: run URLs (FAIL 39117011427;
    PASS 39117530768 + 39117534103), ESP-IDF v6.1 + target esp32s3, log,
    artifact a-w02-espidf-build-report + SHA-256, lỗi driver/gpio.h đã sửa
    tại 2a5a0da, và giới hạn (compile != hardware; chưa nạp/chưa chạy).
    - acceptance.md: A-W02-04 -> COMPILE VERIFIED (CI) — HARDWARE RUN PENDING;
    thêm mục 10; trạng thái tổng vẫn W02_PARTIAL_EVIDENCE — NOT PASS.
    - firmware-implementation.md (§4/§5.1/§5.6), sensor-rom-map.yaml
    (firmware_commit -> 2a5a0dacd2bfa3feb62f4b626f2a403e23bf39bc),
    bench-procedure-w02.md (B0 = nạp), README.md,
    sens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
    [sensor-rom-map.yaml]
2026-10-18 docs(sensors): record 403-sample BME280 bench evidence
    - Thêm evidence/A/W02/bme280/: log Serial Monitor gốc (SHA-256 da24b6f0…),
    CSV 403 mẫu + báo cáo; nguồn: ColdGuard_W02_BME280_Evidence.zip.
    - Xác minh độc lập từ log gốc: 403/403 mẫu liên tục, valid=1, 402 khoảng
    × 1000 ms; T 30.27–30.42 °C, RH 68.42–69.14 %, P 1011.97–1012.16 hPa;
    CSV khớp từng dòng.
    - A-W02-06 → BENCH VERIFIED — ESP-IDF INTEGRATION NOT VERIFIED (bài bench
    standalone bằng sketch Arduino/Adafruit; firmware ESP-IDF không có driver
    BME280 — cố ý). Vị trí gá cuối/self-heating vẫn PENDING_TEST.
    - Cập nhật acceptance.md (§1, §2, §3, §4.1, §5, §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
    [bme280-bench.csv]
2026-10-18 docs(sensors): record MC-38 bench evidence and polarity
    Historical-subject: docs(A-W02): nhập bằng chứng bench MC-38 thô (48 cặp RAW/STABLE, polarity có dấu) — A-W02-07 sang BENCH VERIFIED
    [mc38-bench.csv]
2026-10-18 docs(sensors): record 620-sample DS18B20 bench evidence
    Gioi han ROM giu nguyen: raw log khong chua dong ROM (ROM_DISCOVERY_NOT_FULLY_CONFIRMED_IN_LOG); ROM xac nhan bang bang chung doc lap phien khac va se dat lai cung boot trong bai 5 reboot firmware ESP-IDF (A-W02-03).
    Historical-subject: docs(A-W02): nhap bang chung bench DS18B20 620 mau that (619s, 4 vai tro hop le) — A-W02-05 sang BENCH DATA VERIFIED nhan ROM provenance
    [sensor-consistency.csv]
2026-10-18 fix(firmware): door task vTaskDelay(0) spin at 100 Hz tick starved IDLE0/sensor tasks
    [app_main.c, cg_auto_reboot.py]
2026-10-18 docs(firmware): record flash, reboot identity and runtime evidence
    Historical-subject: docs(A-W02): nhap bang chung firmware ESP-IDF that (flash 3/3 region, 5 reboot identity PASS, runtime 252 mau ~1Hz); fix commit firmware_commit -> 1b93f572
    [cg_auto_reboot.py, sensor-rom-map.yaml]
2026-10-19 feat(power): add read-only PZEM monitoring and IBT-2 safe-state
    - cg_crc16/cg_pzem/cg_rs485/cg_power: Modbus RTU chi doc (FC 0x03/0x04), CRC16 truoc khi tin khung, timeout 250ms x2 bounded, phan loai loi, scaling V/I/P/Wh, log PZEM_CFG/PZEM_RANGE/PZEM grammar v2 (v1 khong doi)
    - cg_actuator: ep RPWM/ENABLE OFF dau app_main, khong PWM (khong LEDC/MCPWM), guard tu choi output khi chua authorization (CG_ACTUATOR_ENABLE_ALLOWED=0)
    - tooling host: cg_modbus, cg_pzem_readback, cg_build_pzem_off_csv, mo rong cg_serial (thong ke link/power), run_all_checks_w03; 56 test moi (113 tong)
    - CI: .github/workflows/a-w03-espidf-build.yml (idf v6.1 esp32s3 + host-checks)
    - fix dong goi W02: ngoai le !evidenc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
    [app_main.c, cg_actuator.c, cg_actuator.h, cg_build_pzem_off_csv.py, cg_check_firmware_w03.py, cg_crc16.c, cg_crc16.h, cg_log.h]
2026-10-19 docs(power): record PZEM and IBT-2 evidence and pending gates
    - acceptance.md: nguồn trạng thái duy nhất — A-W03-01…07 với đủ nhãn
    (VERIFIED BY EXISTING EVIDENCE / CODE IMPLEMENTED / HARDWARE RUN PENDING /
    MEASUREMENT REQUIRED / SAFETY REVIEW PENDING / LEADER APPROVAL PENDING /
    PENDING_READBACK); đối chiếu pass criteria canonical; blocker CR-A-W01-01
    - hardware-deviation-and-safety.md + rs485-pin-and-compatibility.md: TTL485-V2.0
    thực tế khác MAX3485 đã freeze; không tự quyết mức logic (chờ D + leader)
    - logic-power-measurement.md: tái dùng số W01 (user-reported) + kế hoạch đo có tải
    - pzem-register-readback.txt: bản ghi PENDING có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
2026-10-19 fix(firmware): doi ten enum huong RS-485 tranh dung macro config (loi compile CI dau tien)
    - CI build dau tien: coldguard_config.h:151 error: expected identifier before numeric constant.
    - Nguyen nhan: enum CG_RS485_DIR_AUTO/MANUAL trong cg_rs485.h bi macro CG_RS485_DIR_MANUAL (config) thay the o cac TU include config truoc header (cg_power.c).
    - Fix: enum -> CG_RS485_MODE_AUTO/MANUAL; cg_rs485.c/cg_power.c cap nhat theo; macro compile-time giu nguyen ten.
    - Quet them toan bo firmware/main: khong con xung dot macro/enum nao khac.
    [cg_power.c, cg_rs485.c, cg_rs485.h]
2026-10-19 docs(firmware): record CI build results and artifact hashes
    - build-report-w03.md: điền kích thước/số liệu thật của artifact (bin 230 976 B,
    zero warning ở cả 2 job), bảng SHA-256 cho bin/elf/map/bootloader/partition-table/
    flasher_args/sdkconfig; §4 cập nhật run 2 SUCCESS (nguồn run 39213118829).
    - README.md: status CI chuyển SUCCESS run 39213118829; reproduction item 5 dùng
    số liệu thật.
    - PR_BODY.md: §1 CI SUCCESS; §3 bổ sung finding F1 (lỗi compile do enum trùng macro,
    đã fix commit b858693).
2026-10-27 fix(power): handle PZEM response framing and record bench evidence
    Historical-subject: feat(A-W03): consolidate firmware fixes and verified bench evidence
    [pzem-off.csv, test-132b-off-envelope.csv]
2026-10-28 fix(firmware): align GPIO map and safe-state with tested hardware
    [cg_check_firmware.py, cg_door.h, cg_gpio_map.py, cg_log.c, cg_log.h, cg_safety.c, coldguard_config.h, sensor-rom-map.yaml]
2026-10-28 fix(firmware): integrate updated GPIO map and safe-state
    Tích hợp W02 (55fd67e) vào W03 trên nhánh integration để lấy pin map v2 và
    các guard chân dùng chung, đồng thời giữ nguyên toàn bộ thay đổi W03 chưa
    commit trước đó.
    - Pin map v2 (CG_PIN_MAP_VERSION=2): DS18B20=33, BME280 SDA/SCL=21/34,
    MC-38=35, RS-485 TX/RX=36/37 (AUTO, 9600 8N1), IBT-2 RPWM/R_EN/L_EN=5/6/10;
    LPWM nối GND.
    - IBT-2 safe-state: R_EN/L_EN=0 trước RPWM=0, CG_ACTUATOR_ENABLE_ALLOWED=0,
    từ chối duty ngoài khoảng và duty đôi; không dùng ngoại vi PWM.
    - PZEM-017 read-only FC03/FC04, CRC16 0xA001, không có đường FC06.
    - Bằng chứng build native ESP-IDF v6.1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
    [cg_actuator.c, cg_actuator.h, cg_check_firmware_w03.py, cg_log.c, validate_w03.py]
2026-10-28 feat(ml): define statistical evaluation and paired-sample planning
2026-10-28 fix(sensors): restore missing serial reboot evidence log
    PR #8's W02 validator requires espidf-run/serial-reboot-original.log with declared size and SHA-256, but the file existed only on the W03 branch. Restore the original Git blob b40f5d64fd9d4425dd3d7d7bb40f4ce896b43d88 from commit 5a6cb1f byte-for-byte; no log content was regenerated and the validator is unchanged.
2026-10-28 fix(integration): align ML telemetry validation contracts
    Align the B consumer with the implemented C wire/normalized contract: run_id is nullable at the sample boundary but rejected by run-based grouping/order; temperatures accept physical negative readings within DS18B20 (-55..125 C) and BME280 (-40..85 C) ranges; schema_version must be the supported exact integer 1; uptime_ms stays optional but must be a valid counter when present. Regression coverage added in ml/tests/test_observations_contract.py; the existing LRK-03 future-mutation fixture now uses an in-range sentinel.
2026-10-28 fix(integration): enforce SAFE_LOCAL exit gate
    The SAFE_LOCAL exit gate previously ran only when device_mode was SAFE_LOCAL. A contradictory pair (device_mode=ONLINE_NORMAL, current_state=SAFE_LOCAL) bypassed the gate and could return PREEMPTIVE_COOLING/ON with network_stable_s=0 or stale_command_pending=True. The prior policy state now shares the same gate as the device mode, so an unmet gate keeps SAFE_LOCAL (fail-closed) while fault/lockout priority and reactive critical thermal protection remain unchanged. Regression coverage in control/tests/test_safe_local_exit_gate.py.
    [policy.py, test_safe_local_exit_gate.py]
2026-11-01 chore(repo): keep bench build trees and flash images out of git
    `firmware/build/` was the only ESP-IDF ignore rule, so a configured bench
    tree (~150 MB each) and its generated `sdkconfig` were addable by an
    accidental `git add -A`, and `evidence/A/W04/**/*.bin` had no rule at all.
    - ignore `firmware/*-bench/build*/`, the generated `sdkconfig`/`sdkconfig.old`
    (keeping `sdkconfig.defaults` versioned), and W04 flash images;
    - pin the W04 dossier's raw captures and IDF logs with `-text`, because
    `validate_w04.py` verifies their SHA-256 and a CRLF rewrite would break
    every pin on a clean checkout with `core.autocrlf=true`.
    Refs: A-W04-01
2026-11-01 feat(command): add fail-closed TEC commissioning control core
    W04 needs the commissioning mechanism without the ability to energize the
    cooling branch: the branch fuse, conductor class, polarity and hot-side
    sustainability are still unmeasured, so no duty can be called safe.
    - `cg_tec_limits` keeps all seven operating limits as `UNRESOLVED` with
    per-row provenance, and `START` refuses while any row is unresolved;
    - `cg_tec_control` is the pure-C state machine (OFF/ARMED/COOLING/COOLDOWN/
    FAULT_LATCH) with the duty0 -> fan -> enables -> duty start order,
    enables-before-PWM stop order, rollback and a fault latch that only clears
    on a token plus healthy inputs;
    - `cg_tec_hw` is an adap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
    [app_main.c, cg_commission.c, cg_commission.h, cg_console.c, cg_console.h, cg_log.c, cg_log.h, cg_power.c]
2026-11-01 feat(actuator): add the isolated conservative TEC polarity bench image
    The H6 response recorded in `evidence/A/W04/h6/` was measured with this image,
    not with the production tree, and keeping it separate is the point: it owns
    GPIO5 for LEDC only, reads PZEM directly, and shares no code with `firmware/main`.
    Ships `main/`, `tools/h6_serial.py`, CMake files and `sdkconfig.defaults`.
    The generated `sdkconfig` and every build tree stay ignored.
    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
2026-11-01 docs(commissioning-evidence): record the W04 commissioning gates as a derived document
    `docs/06` is Member A's working record for the TEC commissioning phase. It is
    explicitly NOT canonical: the authority chain stays
    `docs/00 > 01 > 02 > 03 > 04 > 05A`, and any conflict resolves in favour of the
    canonical file, with the difference logged as an open item in
    `evidence/A/W04/acceptance.md` instead of being patched silently here.
    Contents: the fail-closed rationale, the safety invariants the firmware
    enforces and how, the state machine, the seven-limit table with every row
    `UNRESOLVED` and its reason, the console grammar, the raw telemetry schema, the
    G0-G5 bench gates with measurable pass crit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
2026-11-01 docs(evidence): add the W04 commissioning dossier with hash-pinned provenance
    Dossier for A-W04-01..07 and H4/H5/H6, with the metadata block `docs/05A`
    requires (date, operator, hardware_config_id, firmware identity, test IDs,
    setup, result, pass/fail, anomalies) and `validate_w04.py`, which re-hashes
    every committed capture against `SHA256SUMS.txt` so a raw log cannot be
    rewritten after the fact.
    Committed: the G0 electrical verification, the H6 polarity plan plus the 2026-10-29
    H6 session (build, static checks, flash/readback, the 60 s run capture and its
    analysis), the G1 production-firmware session (git identity, source hashes,
    host tests, IDF builds, boot/reset captures, telemetry CSV/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
    [42-ml.csv, 42-telemetry.csv]
2026-11-01 test(commissioning-evidence): add the W04 delivery gate and its negative tests
    `cg_check_firmware_w04.py` turns the fail-closed posture into 131 machine-checked
    contracts: output stage compiled out, all seven limits unresolved with
    provenance, the adapter's refusal of every enable, start/stop ordering, watchdog
    subscription placement, telemetry validity and provenance rules, grammar
    additivity, GPIO ownership, and that no source or header uses a network API.
    `run_all_checks_w04.py` is the single no-hardware gate: the host unittest suite
    plus the W04/W03/W02 static checks and the W02/W03/W04 evidence validators, 7/7
    before any physical claim is made. The W04 dossier validator is wired in her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
    [cg_build_telemetry.py, cg_check_firmware_w04.py, cg_telemetry_schema.py]
2026-11-02 feat(commissioning-evidence): derive the W04 evidence tables from raw captures
    Three of the W04 deliverables were missing only because nobody had turned
    captures that already exist into the canonical form. These builders do that
    without adding a single number that the raw stream does not carry.
    - `cg_build_h6_trace_csv.py` parses the H6 serial log into
    `first-tec-trace.csv` and refuses to emit unless the session really shows all
    samples `pzem=OK` plus its OFF and END records;
    - `cg_build_boot_default_off_csv.py` walks every ROM-bootloader banner in the
    bench corpus, classifies each start by reset cause, lets the device name its
    own image instead of trusting a path, and merges identi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
    [cg_build_boot_default_off_csv.py, cg_build_cooling_trace_csv.py, cg_build_h6_trace_csv.py]
2026-11-02 docs(evidence): produce the six canonical W04 deliverables from recorded data
    Five of the six `docs/05A` W04 deliverables did not exist. Four are now produced
    from evidence already on disk, and the two that need a physical object say so
    on their face instead of being papered over.
    - `h6/first-tec-trace.csv` + `first-tec-plot.png`: the conservative H6
    response, with the figure stating that the H6 image reads no DS18B20 or
    BME280, so A-W04-07 stays PARTIAL on thermal channels;
    - `boot-default-off.csv` + note: 132 banners deduplicated to 116 unique start
    events, 7 production resets all coming up SAFE_OFF, zero `POWERON` banners and
    zero pin-level readings anywhere - the reset ask is me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
    [boot-default-off.csv, first-tec-trace.csv, tec-cooling-response-600s.csv]
2026-11-02 docs(evidence): raise the T2 and conductor change reviews and restate W04 status
    Two W04 items cannot be resolved by Member A alone, and the honest move is to
    write them up as requests rather than quietly choosing.
    - `change-review-request-CR-A-W04-01.md`: `docs/01` freezes T1/T2/T3 as chamber
    air while ROM `28AEBF2200000006` is used as hot-side protection and the
    operator places it on the hot block. Options, consequences and the fact that
    hot-side protection must survive any decision. The delivered firmware still
    emits `t_hot_side_c=NOT_ASSIGNED`.
    - `change-review-request-CR-A-W04-02.md`: the branch conductor is 1.75 mm²
    against the canonical `2 × 2.5 mm²`, which also blocks a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
2026-11-02 fix(commissioning-evidence): write derived CSVs with LF endings and refresh the gate banner
    The three builders used `csv.DictWriter`'s default `\r\n` terminator. With
    `* text=auto eol=lf` in `.gitattributes`, git normalizes those blobs on commit,
    so the bytes a reviewer checks out would not match the SHA-256 pins in
    `SHA256SUMS.txt` — the same failure class the W04 dossier exists to prevent.
    - set `lineterminator="\n"` in all three builders and regenerate the CSVs;
    - refresh `run_all_checks_w04.py`'s closing summary: the canonical deliverable
    files now exist, so what remains open is the five power-on boots, one
    pin-level reading, the fuse and conductor photographs, a conservative run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
    [boot-default-off.csv, first-tec-trace.csv]
2026-11-02 docs(evidence): fold the 2026-11-02 operator confirmations into the W04 record
    The operator settled three open facts and asked for the remaining physical work
    to be prepared rather than stalled.
    - conductor class: **1.75 mm² confirmed definitively**, so the size is no longer
    asked about. What stays open is the engineering evaluation against
    `2 × 2.5 mm²` — approved deviation on real electrical and installation evidence,
    or replacement. Not approved by Member A unilaterally.
    - the two contract questions are now visible to the team as issues #14 (T2
    semantics) and #15 (conductor class), with the dossier files as their detail.
    - `w04-physical-verification-plan.md` adds the executa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
2026-11-02 feat(telemetry): schema-2 telemetry with identity, coherence, quality and liveness
    W04's raw frame carried values and per-value status tokens, but the frame itself
    could not say who sent it, how old any part of it was, whether the producer was
    still running, or whether an output was actually left driving. A-W05 makes each
    of those a field instead of an inference.
    - cg_quality.c/.h: canonical VALID/DEGRADED/INVALID/UNKNOWN per source family
    plus the documented collapse precedence (docs/01 2263-2308). An unobserved
    source is UNKNOWN, not INVALID; one failed chamber probe is DEGRADED and two
    are INVALID (docs/01 924-942). cg_snapshot_init() no longer claims INVALID
    before the first sam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
    [app_main.c, cg_commission.c, cg_ds18b20.c, cg_ds18b20.h, cg_health.c, cg_health.h, cg_power.c, cg_quality.c]
2026-11-02 feat(telemetry): parse schema 2, measure real cadence, and hand W05 columns to B/C
    cg_telemetry_schema.py:
    - accept schemas 1 and 2, so the 62 committed W04 frames still parse; require the
    W05 identity/quality/liveness tokens only on schema 2, and never default a
    schema-1 row into having them
    - enforce the closed vocabularies: a quality name outside the four canonical
    states, a health name, an evidence token, a seq below 1, a lowercase or
    truncated ROM, or probes_valid above probes_expected is rejected rather than
    stored, because a silently accepted typo is how UNKNOWN ends up looking normal
    - expose the saturated-age sentinel so a clock disagreement is a named condition
    instead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
2026-11-02 test(telemetry): prove the W05 rules on the real sources and make the checker fail on demand
    cg_w05_harness.c compiles cg_quality.c, cg_health.c, cg_snapshot.c and
    cg_telemetry.c unchanged and runs 33 scenarios over the rules the slice claims:
    the four-state vocabulary and its precedence, the 2x/4x liveness boundaries,
    backwards-clock handling, registry locking, identity and coherence fields, the
    applied-versus-requested split including both contradiction directions, and the
    refuse-not-truncate budget.
    Scenarios 29-33 drive the frame through the actual publish/read copy instead of
    hand-writing a snapshot. That distinction earned its place: the earlier fixtures
    set cg_snapshot_t fields direc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
    [cg_check_firmware_w04.py, cg_check_firmware_w05.py]
2026-11-02 docs(evidence): add the A-W05 telemetry dossier with its gaps named
    Schema-2 contract, the quality/liveness test record, the measured cadence pilot,
    the B/C/D handoff, and the compile evidence, with SHA-256 pins over every file
    and a validator that also asserts the honest verdict is still present.
    - schema-fixture.json is one line rendered by the delivered formatter through the
    host harness and re-parsed by the delivered parser. It declares itself a
    synthetic frame and not a physical measurement.
    - timing-pilot.{md,json,jitter.csv} measure the committed 60-second W04 capture:
    62 frames, mean gap 1001.279 ms, median 980, p95 1080, max 1080, 0 non-positive
    gaps, 0.9987 Hz, and a bimod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
    [timing-pilot-jitter.csv]
2026-11-02 fix(command): assign the console verb before its argument split
    split_line() set *verb only on the no-argument path, so every two-token
    command (ARM, CLEAR, START, RUN, PHASE) dispatched against whatever the
    caller's uninitialised local held. The W04 console never exercised those
    verbs from a host test, so the defect survived the W04 delivery.
    W06 parses those verbs for the first time, which makes the fix a
    precondition rather than a cleanup: an unbounded read cannot guard a
    command contract. Pinned by a harness scenario and by a static check whose
    mutation removes this line again.
    Refs: A-W06-05
    [cg_tec_command.c]
2026-11-02 feat(command): add the command contract core with fail-closed expiry
    Device-side half of docs/02 sections 28-32. Validation runs in the
    contract's own order and stops at the first refusal, so a reason token
    always names the gate that actually fired.
    Expiry is the deliberate hard part. The board has no wall clock, so
    created_at/expires_at cannot be compared against anything it holds, and a
    TTL measured from receipt would only prove the device just noticed the
    command - not how long it sat in a queue. Receipt-time age is therefore
    never substituted for absolute expiry: without a synchronised clock the
    verdict is SAFETY_BLOCKED with reason EPOCH_UNSYNCHRONIZED and
    expiry_evaluable=0, which is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
    [cg_command.c, cg_command.h, cg_log.h, coldguard_config.h]
2026-11-02 feat(command): bridge a labelled local console command test path
    CMDTEST <id> <ON|OFF> <duty-permille> feeds the delivered canonical
    validator from the local UART, because the firmware has no transport and
    without one the command rules could only ever be exercised by a harness
    fixture. It is a test instrument, not a network contract, and the commit
    keeps them distinguishable by construction: the record is stamped
    source=LOCAL_CONSOLE with command_id_form=TEST_TOKEN and controller
    LOCAL_TEST, and it carries no created_at or expires_at, since a timestamp
    typed by an operator is not a synchronised time base.
    That stamping is what makes the fail-closed expiry verdict observable on
    real hardware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
    [cg_tec_command.c, cg_tec_command.h]
2026-11-02 feat(command): acknowledge commands and publish desired state on schema 3
    The commissioning loop now validates a command against the device context
    it actually has, not a convenient one: time_sync_state is UNSYNCHRONIZED,
    now_ms is 0, and local_safety_permits is derived from output-stage
    availability plus resolved limits, so the shipped board answers every
    remote request with SAFETY_BLOCKED until someone decides on a time base.
    Serial telemetry moves to schema 3 and gains command_id, desired_cooling,
    desired_duty_permille, last_ack_status and last_ack_reason, so a capture
    can show what the device was asked to do as well as what it did. No
    command in this boot is published as NONE with a nan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
    [cg_commission.c, cg_telemetry.c, cg_telemetry.h]
2026-11-02 test(command): prove the W06 command rules and refuse to promote a trace
    Schema 3 parsing keeps schemas 1 and 2 readable, so the committed W04
    capture and the W05 fixture still parse: raising the serial version must
    not rewrite history. The closed vocabularies, the nanable integer set and
    the age-saturation sentinel are enforced per schema rather than globally.
    cg_command_trace.py aggregates a command lifecycle across five stages and
    promotes none of them from the presence of the previous one. Attribution
    is per boot_id, so a replay after a reset can be shown as unrecognised but
    never mistaken for the same session's continuation, and the only real
    capture on this branch correctly produces a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
    [cg_check_firmware_w06.py, cg_command_trace.py, cg_telemetry_schema.py]
2026-11-02 docs(evidence): add the A-W06 command dossier and correct two W04/W05 claims
    Every artifact here is generated from the delivered sources by
    build_contract_artifacts.py and re-verified byte-for-byte by
    validate_w06.py, which also fails if the honest verdict is edited away -
    including refusing to write a fixture set where any ACK reports
    applied_cooling other than OFF.
    The slice is recorded as contract-complete, physically unexercised.
    A-W06-05 is BLOCKED because there is no transport, no issuer and no
    authorised energised session, and the physical half of A-W06-06 stays open
    behind the host-scenario proof. Nothing claims a device received a command.
    acceptance.md section 6 states which earl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
2026-11-02 fix(command): refuse unowned replays and gate the local test source
    Three defects the post-fix review found in the command layer, plus the
    citation repairs it needed to trust the contract references.
    A replay addressed to another device, or written in a schema this device
    does not speak, was stored under its own command_id. Because the store is
    keyed by that id, such a record replaced the canonical result an accepted
    command had already earned, and the next valid replay of the same id
    answered a verdict the device never owned. Rejections raised before the
    record is established as this device's command no longer write to the
    store.
    The local console bridge was unreachable for ACCEPTED only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
    [cg_command.c, cg_command.h, cg_commission.c, cg_telemetry.h, coldguard_config.h]
2026-11-02 test(command): attribute trace frames by identity and test the ladder
    Report rows are sorted by command_id while parsing keeps arrival order, so
    the --per-frame pairing attached the wrong telemetry frames to the wrong
    command whenever the two orders disagreed. It agreed by luck on the shipped
    demo, whose ids are already ascending, which is why the bug survived a
    generated artifact. Frames are now looked up by the command identity they
    belong to, and the new test feeds the ids in the opposite order so a
    regression cannot hide behind a friendly fixture.
    A stage ladder that is only ever run on one friendly input proves nothing
    about its refusals, so cg_command_trace.py gained eight unit tests: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
    [cg_check_firmware_w06.py, cg_command_trace.py, cg_telemetry_schema.py]
2026-11-02 docs(evidence): record the third review pass and re-pin the W06 build
    The dossier's review section now carries the post-fix pass as findings with
    dispositions rather than as a promise, including the one claim it could not
    verify: the 558-byte ACK worst case is harness-constructed, so the 82 bytes
    of headroom are a measured margin for the inputs the harness feeds it, not a
    proof that nothing can exceed the buffer. The overflow refusal is the safety
    property and it is what the check pins.
    Counts moved to 38 scenarios, 95 static checks, 24 checker tests and 290
    host tests, and the rebuild on the corrected sources produced app image
    581c55af58af4919885a547036a0c620c75584ed31831b0644927933bed852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
2026-11-02 fix(command): name the device in its ACK and admit one canonical source
    Three contract defects in the delivered command layer, each confirmed
    against docs/02 before being changed.
    cg_command_ack_format() emitted no device_id, although §32.3 lists it in the
    ACK payload (line 2206) and this branch's own handoff already documented it.
    The ACK now states the device's own identity from its context. It is not
    copied from the command's device_id: echoing an addressed-to name would be
    evidence of a string, not of who answered. The measured worst case rose to
    592 bytes, so the ACK budget moved from 640 to 768 - 592 inside 640 fits the
    buffer but sits at 92 percent of it, and this budget exists to k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
    [cg_command.c, cg_command.h, coldguard_config.h]
2026-11-02 test(command): pin the ACK identity, the required fields and admission
    Nine scenarios and twenty-five checks for the properties the correction
    establishes, each with a mutation that removes the live construct.
    ack_names_the_device_from_its_own_context changes the context's identity and
    shows the ACK follows it, and shows the command's own device_id never appears
    in the line - the property a payload field only earns if it cannot be echoed.
    source_admission_refuses_unknown_local_and_replay walks the four cases the old
    gate conflated: an unstamped record, the local bridge given a real expiry and a
    permissive context so the refusal is the rule rather than a missing field, that
    same record repl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
    [cg_check_firmware_w06.py]
2026-11-02 docs(evidence): record the contract correction pass and re-pin the build
    acceptance.md gains §3.8-§3.10 for the three defects and §8.1 for the pass that
    found them, with each finding marked confirmed and quoted against the canonical
    line it violated. One entry is an honesty correction rather than a code one:
    handoff-w06.md had already documented device_id in the ACK payload while the
    formatter never emitted it, so what C was told to expect was not what A shipped.
    Counts move to 39 scenarios, 120 static checks, 28 checker tests and 294 host
    tests; the ACK budget is stated as 592 in 768, and §7's superseded-image list
    grows to four. The rebuilt ESP-IDF v6.1 image is
    dad90d63fffc247cea438e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
2026-11-02 fix(command): size the command record for its own canonical maximum
    The fourth review pass found a bound below the thing it bounds:
    cg_command_parse_fields copied an incoming line into 256 bytes, while the
    widest canonical record - every §28.1 field at its documented maximum - is
    331. A legal long command from Member C would have been refused as
    RECORD_TOO_LONG with no hint that the parser, not the command, was at fault.
    Fail-closed, unreachable in this build because no transport calls it yet, and
    exactly the kind of limit that becomes an outage on the day a transport exists.
    The bound is now CG_COMMAND_RECORD_MAX (512) with the arithmetic recorded
    beside it, and maximal_canonical_record_p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
    [cg_check_firmware_w06.py, cg_command.c, cg_command.h, cg_commission.c]
2026-11-02 docs(evidence): align the W06 claims with the reviewed code and re-pin
    The dossier cited a scenario name that the admission rewrite had already
    retired, so a reviewer following the pointer found nothing; docs/06 §6.2 listed
    source admission before device_id, which is not the order the code checks; and
    §7.2 said the W05 frame budget understates W06 by 383 bytes while mixing a
    typical W05 frame against a worst-case W06 one. The honest figures are 158
    worst-to-worst or 383 typical-to-worst, and a sentence that quotes one without
    saying which is a number nobody can reuse.
    §8 now records the fourth review pass with what it re-verified independently,
    and the counts move to 40 scenarios and 253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
2026-11-02 fix(command): make the command header self-contained for gcc
    CI caught what four reviews and every local build missed. cg_command.h declares
    cg_command_ack_format(char *buf, size_t cap, ...) and never included <stddef.h>;
    each MSVC translation unit that includes it happens to pull the typedef in from
    an earlier header, so /W4 /WX stayed green, while gcc -std=c11 -Wall -Wextra
    -Werror on the host-check job failed with "unknown type name 'size_t'".
    The include is added, and the property is now asserted rather than trusted: any
    W06 header that uses size_t must include <stddef.h>, with a mutation test that
    removes it. A green local build is not verification of a portable header - the
    compiler t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
    [cg_check_firmware_w06.py, cg_command.h]
2026-11-02 docs(evidence): record the header defect CI found and re-pin the build
    acceptance.md §3.11 states the failure plainly, including the part that matters
    for how this slice is read: four independent read-only reviews and a full local
    MSVC and ESP-IDF build cycle all passed a header that gcc rejects. §8 adds the
    same point as a limit of review, not a win for it.
    Counts move to 40 scenarios, 122 static checks, 29 checker tests and 295 host
    tests, and the rebuilt image is
    947c529d1987288aa960e45e9053223fe8975f3ce210fb5150e36a0d07c36e13 at 253 520
    bytes with the superseded list grown to six. Still nothing flashed, still no
    transport, still no issuer and no energized session - so A-W06-05 stays B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
2026-11-02 feat(thermal): measure plant repeatability and refuse to invent its spread
    cg_thermal_repeatability.py turns committed bench captures into the outcomes
    week 07 asks for - trajectory, delta, trailing and whole-phase slope,
    electrical means and peaks, and cross-run mean / sample SD / CV / min / max -
    and returns INSUFFICIENT_RUNS with the number still needed rather than
    dressing one run up as a distribution. With n=1 the spread columns are empty
    by construction, which is the honest output, not a missing feature.
    Every slope names its representation, window and fit method, because docs/01
    20.5 calls a bare dT/dt ambiguous; spread states it uses the sample formula
    per docs/01 20.4; nan, absent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
    [cg_reset_criterion.py, cg_thermal_repeatability.py]
2026-11-02 docs(evidence): record the W07 geometry freeze and the runs that are missing
    Every artifact is generated by build_w07_artifacts.py from the tools and the
    committed captures, reproduces byte-for-byte under --check, and is re-read by
    validate_w07.py, which fails if the report ever stops saying NOT ESTABLISHED,
    if a test-injected threshold loses its label, or if one boot_id's segment is
    registered as an independent run.
    geometry-v1.md freezes what committed files actually support - pins, ROM roles,
    the 1.75 mm2 conductor, the compiled-out output stage - and states in its own
    heading that physical placement is NOT FROZEN, because the two configuration
    photographs requested in the W04 polarity n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
    [repeatability-overlay.csv]
2026-11-02 fix(thermal): keep the hot side out of the mean the criterion is written against
    Three review findings said the same thing: the analyzer could describe one
    quantity as two different things. It is corrected at each layer.
    The as-built geometry makes T2 the TEC hot side, so any mean that averages it
    is not a chamber-air mean. The four representations now carry
    `includes_hot_side` explicitly and `tmean_airroles_v0` (T1 centre, T3 bottom,
    T4 near door) is the default, so a run can no longer be measured on a hot-side
    mixture and judged against an air criterion. `cg_reset_criterion.evaluate`
    enforces that instead of trusting the label: it refuses a state whose
    `representation` differs from the fi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
    [cg_reset_criterion.py, cg_thermal_repeatability.py]
2026-11-02 docs(evidence): record the operator-confirmed slot to position mapping
    A-W07 could not analyse the H8 captures without knowing which probe sits where,
    and the two candidate answers differ by 3.4x in measured cooling effect, so this
    is the artifact the representation choice rests on.
    The read-only session is committed with its six raw captures - 233 `#CG H8S`
    frames, 119 of them inside the three touch windows - rather than as a summary,
    because the inference is only as good as the ability to re-derive it. Verified
    against those files: every frame reports `state=OFF` and applied duty 0, the
    hands-off noise floor is <= 0.063 C against rises of 2.19-3.63 C in three
    different channels in three d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
2026-11-02 fix(thermal): name a capture by where it lives in the repository, not in a checkout
    `analyze` published `path.as_posix()` into every report it wrote, so the four
    committed `repeatability-tmean_*.json` artifacts each carried
    `C:/Users/.../A-W07-plant-repeatability/evidence/A/W04/tec-cooling-response-600s.csv`.
    Two consequences, not one: a developer path inside repository evidence, and - the
    one that actually breaks a reviewer - those files are SHA-256 pinned, so anyone
    regenerating the dossier in a different checkout produced different bytes and the
    "reproduces byte-for-byte" claim was only ever testable on the machine that wrote
    it.
    `capture_id` now returns the path relative to the reposito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
    [cg_thermal_repeatability.py]
2026-11-02 docs(evidence): rebuild the W07 dossier on the geometry the bench actually has
    The dossier now states one fact per line and shows the arithmetic behind each,
    so a reviewer can disagree with a number instead of with a summary.
    `geometry-v1.md` §1 freezes what committed files support - the four slots, their
    ROM labels marked by-source, the 1.75 mm2 conductor, the compiled-out output
    stage - and §4 keeps the canonical naming problem where it belongs: docs/01
    expects T1 near door / T2 centre / T3 far-opposite, while the bench has T4 near
    door / T1 centre / T3 bottom / T2 hot side. The physical geometry is final and
    the logical role names are a separate interface decision, so the file proposes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
    [repeatability-overlay.csv]
2026-11-02 fix(thermal): close the six ways the criterion could be satisfied without being measured
    Independent review reproduced each of these against the shipped candidate, so each
    now has a test that fails when its guard is removed.
    Three state gates branched on `== "UNRESOLVED"` instead of the activation test the
    numeric gates already used, so a hand-built criteria dict - the path the artifact
    generator takes - reached READY with `status: TRUST_ME` on door, cooling or quality.
    A frozen requirement could also name no condition at all: `door_required: OPEN`,
    `sensor_quality_required: DEGRADED`, `cooling_state_required_known: false` all loaded,
    activated and returned READY, so a value that is not the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
    [cg_reset_criterion.py, cg_thermal_repeatability.py]
2026-11-02 docs(evidence): stop the W07 dossier asserting things its own data contradicts
    The report's prose said the trailing-window slope "is positive during cooling on
    purpose" and README/acceptance quoted +0.0701, while the generated table printed in the
    same file said -0.070104. The sentence was a hardcoded literal taken from the synthetic
    fixture that really does force a rebound, so the dossier's example of slope discipline
    was the thing that was wrong. It is now derived from the two published numbers, and
    validate_w07.py fails if a hand-written document quotes a slope the tools did not
    produce.
    The suspect frame's comparison was widened from five fields to the fourteen measured
    fields the prose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
    [repeatability-overlay.csv]
2026-11-02 fix(evidence): close the five residual findings the re-review left open
    The re-review confirmed the repair round and still found five real things. Each was
    reproduced before being fixed, and the two new guards were then mutation-tested on a
    scratch copy with the pins rebuilt, so what fires is the semantic check and not the hash.
    `probe-identification-v0.md` claimed a hands-off spread "<= 0.063 C on every channel in
    five of the six windows". Recomputed per channel, only two windows hold every channel
    under 0.063 C; the largest hands-off spread is 0.125 C (t2 in decay_check) and touch
    windows show 2.25-2.81 C. The table now carries each window's recomputed maximum and the
    validator recomputes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
    [cg_thermal_repeatability.py]
2026-11-02 docs(evidence): correct the conductor unit, quote the full OFF transient, and carry W07's handoff
    Operator corrections on 2026-11-02 changed two published records, and both were mine.
    `geometry-v1.md` §3 stated the branch conductor as 1.75 mm2. It is 1.75 mm **diameter of
    the copper core**, which for a round solid conductor is about 2.405 mm2 of copper. That
    moves the gap to the canonical 2 x 2.5 mm2 ask from roughly a third to roughly four percent
    by area, and it also puts the conductor inside the FDD2-250 termination's stated 1.5-2.5 mm2
    range rather than below it. The correction is recorded with its own assumption, because the
    assumption is load-bearing: a stranded conductor is not one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
2026-11-02 docs(evidence): carry the Member A handoff baseline in the week that can prove it
    docs/05A section 5 and 6.1-6.3 define the handover as fields and evidence, so the
    cross-week view of it belongs where the artifacts it cites actually exist. W07 is the
    first week whose records the handoff depends on: the frozen placement map, the four
    representations and the hot-side exclusion, the duty-zero current frame, and the
    reset-criterion evaluation are all on this branch, and every number quoted here was
    recomputed from committed files while authoring.
    Four items are covered: the 44-requirement coverage matrix, the A-to-B/C/D field map,
    the consolidated supervised session plan, and this week's own han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
2026-11-02 feat(sensor): measure the spatial field and the ablation sets on real rows only
    W14 asks for gradient statistics and a one-sensor-versus-three-sensor ablation,
    and the repository holds exactly one thermal session with no door-open event in
    it. Rather than spread that session into a distribution, this adds the
    statistics the rows can actually carry and makes the two ways they could lie
    fail loudly instead: a hot-side surface counted as chamber air, and one boot's
    sample dispersion published as if it were repeat behaviour.
    Roles and representations are imported from W07 instead of restated, so the
    frozen geometry stays the single source of truth; the one helper W07 does not
    expose (a mean ove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
2026-11-02 feat(sensor): split what sensor-position QA can verify from what it cannot
    A-W14-01 asks to verify no movement since the freeze, and no archived capture can
    deliver that: the H8S schema-3 frames carry no sensor ROM ids, so a channel in a
    later session is a slot name rather than a proven probe, and nothing in any frame
    records tip height, clearance, orientation or cable path. Writing the check as if
    it settled the question would put a false physical claim into the evidence base,
    so this states the deliverable as method plus baseline and refuses the forbidden
    sentence in code.
    The check compares a candidate capture against the frozen record on two axes that
    data does carry - the capture's own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
2026-11-02 feat(evidence): deliver the W14 dossier with its honesty checks proven able to fail
    The tools alone would leave W14's real risk unaddressed: a regenerated report can
    reproduce byte-for-byte and still claim something the captures never showed. This
    dossier therefore pins every number, then re-derives it from the raw rows - the
    variant deltas, the air gradients, the door tally, the role-column tokens, which
    channel rose while the bridge was driven - so a doc that drifted from the data
    fails on the arithmetic and not on a sentence.
    Seven false claims are planted in a scratch copy of the dossier and each must
    produce a non-zero exit after the hashes are re-pinned, so the failure is the
    honesty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
    [ablation-support.csv]
2026-11-02 fix(sensor): make W07's flag and the role map vouch for each other at import
    Deriving includes_hot_side locally from AS_BUILT_ROLES was correct but unproven: if
    W07's representation table and that map ever disagreed, whichever one the variant
    table happened to read would decide whether the TEC hot-side probe landed in a
    chamber-air mean. Building a variant for a registered representation now takes
    W07's own flag as the authority and compares it against the derived predicate,
    raising at import instead of shipping a mean that quietly contains a surface.
    Also counts the W14 suite where the dossier quotes it, moves the generator's
    function-level imports to the top where they belong, and states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
2026-11-02 docs(sensor): state which handoff fields W14 actually supplies, and which it must not imply
    docs/05A 6.1 asks Member A for eleven named fields, so the week's contribution has to be
    recorded per field rather than summarized as "spatial statistics delivered". W14 supplies
    a genuine ablation design - ten feature sets over the same 957 rows, tied together by one
    conditioning fingerprint, which is what makes a one-probe-versus-three-probe comparison
    physical-condition-controlled instead of run-to-run, and no probe was unplugged to get it.
    It supplies pairing *input*, not pairing tolerances: tolerance_value stays null and a
    structural guard raises if a number ever appears under a tolerance-named k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
2026-11-02 feat(evidence): audit hardware configuration drift from evidence, not from constants
    W12 exists so that a later week can say which captures are comparable. Two shortcuts made
    that question unanswerable, and both were reproduced before being fixed.
    `configuration_of()` tested the limits policy before the boot fallback, so any capture
    without the hard-coded image marker keyed as `limits_policy:APPROVED` regardless of its
    firmware: two different images collapsed to one configuration key, and a byte-for-byte copy
    of the W04 capture under a new name produced `cross_session_drift = {sessions: 2, range_c:
    0.0}` - a manufactured "zero drift inside one configuration" derived from one session, while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
    [dataset-validity.csv, mechanical-audit-checklist.csv]
2026-11-02 docs(quality): state which handoff fields W12 supplies and which only an inspection can
    docs/05A 6.1-6.3 asks Member A for named fields, so the handover has to be answered field
    by field. W12 supplies the configuration identity as evidence rather than a constant, the
    pooling rule, and the electrical qualification state - and it is explicit that the
    committed capture has no qualified electrical channel, so its numbers stay UNQUALIFIED.
    The file also refuses two over-reads. Hardware-configuration signoff is a decision A can
    prepare but cannot sign, and a mechanical checklist written by a host tool is a plan, not
    an inspection: the field work (fixtures, V1 mounting, terminals, fuse and conduct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
2026-11-02 feat(evidence): measure plant timing on a device clock and publish the gaps as gaps
    Three of the W13 numbers were not what their own text claimed, and each was reproduced
    before being fixed.
    The latency exclusion was inert, biased and uncited: the rule dropped the first
    post-command sample unconditionally, but on the real trace that sample is 0.000 A and the
    threshold rejects it anyway, so naive onset gives the identical 1.094 s while acceptance.md
    presented the exclusion as the reason the number was right. For a capture whose first
    sample legitimately carries current the rule would have reported the delay one poll period
    late and stamped a valid reading "stale pre-run register". Onset is n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
    [data-gap-register.csv, door-critical.csv, response-delay.csv]
2026-11-02 chore(evidence): keep the W13 dossier pins byte-exact on checkout
    The repo default is `* text=auto eol=lf`, so without this rule a core.autocrlf checkout rewrites the generated JSON/CSV and every pin in evidence/A/W13/SHA256SUMS.txt fails at once. Scoped to this week's path, matching W04-W07 and W12.
    Refs: A-W13-01
2026-11-02 fix(evidence): make absence a state, so comparability cannot be earned by copying nulls
    compare_snapshots() answered COMPARABLE when the other side was simply absent.
    geometry_roles compared only the boolean consistent_with_freeze, which is true for an
    unlabelled slot; hardware_config_id was a constant that can never mismatch;
    physical_output carried "UNQUALIFIED(empty column)". A snapshot reproducing the baseline's
    own nulls went through the real CLI and returned verdict=COMPARABLE with
    comparison_allowed=true, while acceptance.md described the baseline side as fully populated
    - populated, that is, with absence.
    Absence is now its own state. A dimension whose either side is null, unlabelle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
    [w16-rerun-requirements.csv]
2026-11-02 chore(evidence): keep the W16 dossier pins byte-exact on checkout
    Repo default `* text=auto eol=lf` would rewrite the generated JSON on a core.autocrlf checkout and break every pin. Scoped to this week's path, matching W04-W07, W12 and W13.
    Refs: A-W16-01
2026-11-02 docs(sensor): deliver the tolerance form without inventing a tolerance
    docs/05A asks W16 for final pair tolerances and Controller B readiness. What can honestly
    ship now is the shape: response-tolerance-format.json carries the definition each value
    will hang on - docs/01 20.3 G_T = Tmax - Tmin for gradient, the frozen critical definition
    owned by Member D for the disturbance tolerance - with every value NOT_MEASURED, and
    w16-rerun-requirements.csv marks each re-run item host_can_compute: false with its status.
    The file states what W16 does not give: no rows for B, nothing new for C, no G4 reading.
    Configuration drift is empty because there is one era, not because two eras agree.
    Refs: A-W1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
2026-11-02 feat(power): publish the observed electrical envelope, hot-side limits and Gate A evidence
    cg_w15_pzem_quality.py travels with this week because build_w08_artifacts.py imports it for the Gate-A electrical coverage rows; its own test stays with W15, which is stacked on this branch, so W15's review is where the module is covered. No file is duplicated between the two weeks.
    Refs: A-W08-02, A-W08-04
    [duty-zero-current-frames.csv, electrical-status-coverage.csv, envelope-by-duty.csv, gate-a-artifact-index.csv, gate-a-operator-queue.csv, holdover-frames.csv, safe-local-physical-inputs.csv, source-summary.csv]
2026-11-02 fix(power): name the 22.4 safety candidate, surface skipped byte-checks, fix the conductor unit
    CONTROL_ELECTRICAL_ANOMALY lived only in code comments while Gate-A declared no unresolved high-current anomaly: MET. The token is now in the generated report and required by validate_w15, the wording stops pre-deciding a safety classification, and the suspect frame carries its full decay 7.15 -> 0.56 -> 0.02 -> 0.0 A to zero at device_ms 829894. validate_w08 no longer exits 0 while silently skipping 18 bench byte checks; a pinned __pycache__ now fails; the A3 caveat column is delivered. The conductor is a 1.75 mm copper-core diameter (~2.405 mm2 if round and solid), not 1.75 mm2, and nothing is l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
    [gate-a-operator-queue.csv]
2026-11-02 fix(power): stop the W08 runner depending on another week's files
    The runner invoked evidence/A/W15/validate_w15.py unconditionally, so on a checkout of this branch alone it raised NotADirectoryError, and the 19/19 pass it reports elsewhere silently depended on files no ref of this week has. The step now runs when the W15 dossier is present and prints an explicit NOT RUN when it is not, and the suite label says what it actually discovers rather than naming weeks this branch does not carry.
2026-11-02 feat(power): deliver PZEM integrity, A3 provenance and the PWM method without deciding
    Stacked on the W08 branch: the PZEM analyzer itself (cg_w15_pzem_quality.py) is already there because W08's Gate-A generator imports it, so this branch adds the Go/No-Go method, the run index, the dossier and the analyzer's own tests - its review coverage, which the W08 PR could not carry. Decision stays NOT_DECIDED, six criteria and six limits UNRESOLVED, and the local-only ladder and endurance rows are marked LOCAL_BENCH instead of looking git-reproducible.
    Refs: A-W15-04, A-W15-01
    [A3-run-index.csv, a3-feature-provenance.csv, electrical-frame-quality.csv, pwm-criteria.csv, pwm-limits-unresolved.csv, pwm-preconditions.csv, w15-operator-queue.csv]
2026-11-02 fix(quality): qualify by token, identify by evidence, and measure the conductor in mm
    Three findings reproduced against the PR head, each fixed at the rule rather than the
    symptom.
    The conductor was recorded as 1.75 mm^2. It is a 1.75 mm copper-core **diameter**, so the
    area is derived - about 2.405 mm^2 - and the derivation only holds for a solid round core,
    which nobody has confirmed; a stranded conductor is not one round wire. CONDUCTOR_OBSERVED
    now carries the diameter, the derived area and the unconfirmed assumption as one
    indivisible statement, and the faston row stops saying "in range" and says what it is: a
    lead that depends on that same assumption plus a termination inspection nobo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
    [cg_w12_drift_audit.py]
2026-11-02 docs(evidence): regenerate the W12 audit on the corrected conductor and identity rules
    Artifacts and pins rebuilt from the tool after the fixes: dataset-validity.csv carries the separated identity columns, drift-audit.json carries the diameter-with-assumption conductor statement, and acceptance.md/handoff.md stop quoting a 1.75 mm^2 cross-section. Recomputed physical figures are unchanged: 957 frames, 12 duty-0-with-current frames, 0.02 A idle floor, peak 9.99 A, mean 7.2247 A, and 0 frames carrying a validating electrical status token, so the channel stays UNQUALIFIED.
    [dataset-validity.csv, mechanical-audit-checklist.csv]
2026-11-02 fix(sensor): compare the role map itself, not a flag that summarises it
    Two snapshots whose `observed` mappings disagreed completely could both be reported as
    geometry MATCH, because the dimension was reduced to `consistent_with_freeze` and that
    boolean was true whenever a slot was unlabelled. The flag is a claim about the mapping;
    comparing the claim is not comparing the evidence.
    Geometry is now compared as the normalised slot->role map over all four frozen slots.
    Any unlabelled or UNASSIGNED slot on either side is MISSING_SIDE, two different maps are
    MISMATCH, and a side whose flag disagrees with its own map is reported as a contradiction
    (`flag_contradicts_mapping`) that blocks comparis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
2026-11-02 fix(sensor): derive the ablation control, gradient tallies and refusal from the rows
    A-W14-02's "same physical run" control was a label, not a measurement:
    conditioning_fingerprint was hashed once per capture and stamped on every
    variant-phase row, so the rows could never disagree, and the field
    one_fingerprint_per_capture was the literal true. A reviewer replaced all 9 601
    published fingerprints with ffffffffffffffff, corrupted one series row's
    feature_c, and appended a row attributed to a foreign boot_id; the dossier still
    passed, because nothing compared the stamp to the capture.
    The mechanism now measures what it claims:
    - term_points returns the rows a statistic walked, and each varian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
2026-11-02 fix(sensor): make the validator re-derive the control, the series and the claims
    The dossier validator checked labels, so a fabricated proof field passed it.
    It now re-derives the data behind every claim and the checks can fail:
    - check_conditioning_provenance re-computes each capture's
    conditioning_fingerprint from the committed rows, requires every variant-phase
    row to carry it, re-derives each used_rows fingerprint and used_rows count,
    and compares published one_fingerprint_per_capture against the derived value
    instead of accepting a literal;
    - check_ablation_row_attribution re-attributes every ablation-support.csv line
    from the source row its own device_ms names: boot_id, pwm_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
2026-11-02 test(sensor): prove the repaired guards fail on the planted defects
    Every case builds the mini-repo, plants one defect, re-pins SHA256SUMS.txt so a
    hash mismatch cannot be what tripped, and requires exit 1 naming the defect:
    - all published conditioning_fingerprint values replaced by ffffffffffffffff;
    - one series row's feature_c set to 99.9999;
    - a series row appended and attributed to a boot_id the capture never recorded;
    - a variant claiming a used_rows fingerprint its phase rows do not produce;
    - the forbidden non-movement claim written into a JSON value (prose control kept,
    so both shapes are covered);
    - a drive-letter capture path planted inside the pinned build_w14_artifacts.py;
    -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
2026-11-02 docs(sensor): state what the control does and does not prove, and re-pin
    - acceptance.md:1 and README.md:4 claimed the W07 stack head was 2e688be; this
    branch's merge-base with feat/a-w07-plant-repeatability, and PR #21's base, is
    ff387a1, and 2e688be is an ancestor of it - restated as such.
    - acceptance.md said `.gitattributes` carried "not touched in this branch" while
    commit 9fc0780 on this branch adds exactly the evidence/A/W14/** -text lines;
    restated, with no coordinator action left for W14.
    - README.md:86 promised phase segments published with `independent_session:
    false`. No W14 artifact carries that field - they carry
    independent_sessions: 1, per-capture verdict labels a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
2026-11-03 fix(telemetry): keep the TEC hot side out of the chamber-air value
    The production emitter took t_inside_c from role T2, but the operator-frozen
    as-built map makes T2 (ROM 28AEBF2200000006) the TEC hot-side probe, not a
    chamber-air one: all 957 rows of evidence/A/W04/tec-cooling-response-600s.csv
    carry t2_role=HOT_SIDE, and that probe rose 29.875 to 39.938 C during the
    2026-11-01 cooling run while chamber air fell by roughly 9 C. Anything reading
    t_inside_c was therefore getting the Peltier's heatsink.
    t_inside_c now comes from T1 (CHAMBER_CENTER) and the hot side is emitted as
    its own value with t_hot_side_src=T2. The schema number stays at 3 and no
    required token was added, so every previo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
    [cg_check_firmware_w04.py, cg_check_firmware_w05.py, cg_telemetry.c, cg_telemetry.h, cg_telemetry_schema.py, coldguard_config.h]
2026-11-03 fix(door): attest the door polarity per boot instead of per build
    CG_DOOR_POLARITY_CONFIRMED is a compile-time capability gate, but the snapshot
    derived the door-known flag from it alone, so a build with the constant set to 1
    would report OPEN/CLOSED as confirmed on every boot after a reset with no
    per-boot observation behind it. A build constant cannot prove the wiring still
    matches today.
    polarity_attested is cleared by cg_door_init()'s memset, so every reset returns
    the door to UNVERIFIED. Nothing calls cg_door_attest_polarity() yet - the MC-38
    polarity has never been commissioned - so the shipped build behaves exactly as
    before while the constant stays 0.
    No enable-pin readback claim w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
    [app_main.c, cg_door.c, cg_door.h]
2026-11-03 build(config): commit the ESP32-S3 config the release candidate was built with
    The production tree had no sdkconfig at all, so every build inherited whatever
    idf.py set-target defaulted to and nobody could reproduce the bytes. It selects
    the native USB-Serial/JTAG port as the primary console: at the IDF default the
    primary console is UART0 and COM4 is only secondary, which would let an operator
    read the device but not drive its command console.
    Flash size stays 2 MB because that is the layout already proven on this board by
    the H6/H8 bench builds; the package holds 4 MB and the upper half is simply
    unused.
    Refs: A-W23-01
2026-11-03 feat(acceptance): add the single Windows acceptance entrypoint for Member A
    run-member-a-acceptance.ps1 is the one command the operator runs: PHASE_A
    offline checks, PHASE_B read-only identity, PHASE_C build, PHASE_D flash,
    PHASE_E safety-off with the TEC branch isolated, PHASE_F TEC actuation. It
    reuses the IHA-01 gate vocabulary (EXECUTABLE / BLOCKED_NEEDS_OPERATOR /
    BLOCKED_DEPENDENCY) so the campaign and the release speak the same verdicts.
    A default run takes no hardware action and reaches exit 2 with the gated phases
    reported as blocked, not passed: PHASE_D needs -AllowFlash, PHASE_E needs
    -AllowEnergize plus five named acknowledgements including slot-3 removed, and
    PHASE_F is unreach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
2026-11-03 docs(evidence): record the production release candidate and what stays open
    First compile proof for firmware/main: the image, bootloader and partition table
    hashes, the toolchain that produced them, and the 49 source files needed to
    reproduce the bytes. It also states what the candidate is not: no production
    image has been flashed, the box still runs the H8 bench build, and no host gate
    is a hardware result.
    remaining-hardware-gates.md lists the ten acceptance items that offline work can
    never close, each with the minimum evidence that would close it and its blocking
    dependency - starting with the USB ground-loop mitigation, which has to precede
    any stage that reinserts the slot-3 fuse.
2026-11-03 chore(evidence): pin the release candidate against the bytes git actually stores
    The curated runner output was copied out of PowerShell with CRLF while the repo
    normalises to LF, so the pins recorded hashes of bytes no checkout would ever
    produce. The three files are now LF, re-pinned, and evidence/A/RC/ joins the
    -text rules the W05 and W06 dossiers already use so a Windows checkout cannot
    silently rewrite a pinned hash.
2026-11-03 feat(thermal): key the hot-side exclusion to ROM bytes instead of the name T2
    Every chamber aggregate in the host layer selected probes by the literal slot
    name, so the one probe that must never enter a chamber-air mean - the TEC hot
    side, ROM 28AEBF2200000006 - was only excluded by convention, and
    includes_hot_side was a hand-written boolean sitting next to the very term list
    it claimed to describe. Flipping that boolean cost nothing and changed the
    result.
    cg_probe_roles.py is now the single ROM-keyed authority: chamber-air slots are
    derived from the frozen map, and importing the repeatability tool runs a guard
    that refuses to load when a representation declared as chamber air averages th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
    [cg_probe_roles.py, cg_thermal_repeatability.py]
2026-11-03 feat(acceptance): deliver the Windows acceptance entrypoint and the release-candidate package
    One entrypoint, six phases, offline by default: PHASE_A runs the real host gates
    and B..F stay unreachable without their explicit switches plus a typed operator
    acknowledgement. The runner reuses the IHA-01 gate vocabulary so the acceptance
    campaign and the release report the same verdicts, and a COM loss aborts instead
    of retrying.
    The package states what the candidate proves - the production tree compiles for
    ESP32-S3 with ESP-IDF v6.1 and its bytes are reproducible from 49 pinned sources
    plus sdkconfig.defaults - and what it does not: nothing here has been flashed,
    the box still runs the H8 benc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
2026-11-03 feat(dataset): add the W09 host layer that turns a capture into an S1 dataset
    A-W09-01..04 ask for a run checklist, physical invalidation logging and a healthy
    response reference. None of it can be written down by hand and trusted: the
    checklist has to be machine-checkable, and an invalidation label has to come from
    the same code that reads the rows.
    This adds four layers over the committed H8 capture:
    * cg_w09_capture_parser.py - parses #CG frames into rows with provenance;
    * cg_w09_validity.py - 31 reason codes across 7 domains, EXCLUDED_SESSION_CLASSES
    for PROBE/TOUCH_IDENTIFICATION, and no delete path: an invalid row is labelled
    and kept, never dropped (docs/05A A-W09-03);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
    [CG-S1-H8C-600S.row-validity.csv]
2026-11-03 test(dataset): exercise the W09 rules against fixtures, the split and the runner
    Host tests are not physical verification, so each one here asserts a refusal rule
    rather than a measurement: the touch/probe-identification sessions are rejected,
    an absent producer qualifier is reported as unqualified instead of passing, a
    gradient claim cannot be made across a ramp, and no row is ever deleted.
    test_cg_w09_noise.py carries the estimator tests that came over with the module
    (11 tests, verbatim) so the code and its tests stay in the same week.
    test_cg_w09_runners.py now loads run_all_checks_w10.py only when this checkout
    tracks it. Asserting a W10 file from the W09 suite is the same borrowed-ve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
2026-11-03 docs(dataset): re-derive the registry over the published W07 head
    The first cut of this slice was based on the local W07 ref (ff7326c), which is a
    merge of the release-candidate branch that no remote W07 branch carries. Basing on
    it made the week's diff leak another week's files - evidence/A/RC/**, the W05/W06
    re-pins and .gitattributes - into what must be a W09-only PR.
    This branch now sits on the head GitHub actually has for PR #18, fa5e64f, so the
    diff is the 27 W09 files and nothing else. Consequence for the evidence: on this
    base evidence/A/W05/schema-fixture.json is 056b841e... and
    evidence/A/W06/demo-command-capture.log is 6b83c455..., which is what the registry
    and SHA256SUMS.txt no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
2026-11-03 feat(dataset): segment door states under attestation and price the S2 pairing band
    A-W10-01/-02/-03 want a repeatable door disturbance with a timing method, and
    A-W10-04/-05 want Member B handed the evidence to freeze a pair-matching tolerance
    and choose an ML horizon. S2 has never been captured, so the deliverable here is a
    tool that refuses to pretend otherwise.
    cg_w10_door.py: a raw level is not a state. Segments are named CLOSED_AS_REPORTED /
    OPEN_AS_REPORTED unless the operator attested the MC-38 polarity for that boot, the
    near/high mapping is applied only from the attested polarity, an inversion mismatch
    is an error, and the code-level proof of the contact inversion is labelled
    UNCIT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
    [cg_w10_door.py, cg_w10_pairing.py]
2026-11-03 test(dataset): assert the W10 refusals a reader might otherwise take as measured
    57 tests over the door segmentation and the pairing layer. They are deliberately
    mostly about refusal: a frame cannot name its own door state, an unattested boot
    yields a reported label and never a state, no floor is claimed without a quiescent
    segment, every published floor recomputes from the published formula, one run
    cannot produce a tolerance, and Member A does not choose the ML horizon.
    The difference-estimator and quiescent-run tests are no longer in
    test_cg_w10_pairing.py: they came over with probe_noise_profile to
    test_cg_w09_noise.py on the W09 branch, so the count this week's README quotes
    (57) is no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
2026-11-03 docs(evidence): publish the S2 dossier with the door gap stated as the gap
    build_w10_artifacts.py re-derives the nine artifacts from the committed capture and
    the W09 export; --check reproduces them byte for byte on this base and
    validate_w10.py re-counts the source door values instead of trusting the verdict:
    940 frames report door_open=0 and 17 report UNKNOWN, so 0 frames are usable for S2
    and the door->response metric is NOT COMPUTABLE. detected_transitions is 0 because
    no protocolised door disturbance has ever been captured - checked and found none,
    which is distinguishable from not having checked.
    What this slice can publish today is the instrument floor: single-frame bound
    0.05383 deg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
    [S2-pilot.csv, door-event-validation.csv]
2026-11-03 fix(telemetry): source the chamber-air value from the as-built chamber probe, not the hot side
    The W05 emitter took t_inside_c from role T2, and the operator-frozen as-built
    map makes T2 (ROM 28AEBF2200000006) the TEC hot side, not an air probe: all 957
    rows of evidence/A/W04/tec-cooling-response-600s.csv carry t2_role=HOT_SIDE, and
    that probe rose 29.875 to 39.938 C during the 2026-11-01 cooling run while
    chamber air fell by about 9 C. Every consumer of t_inside_c was reading the
    Peltier's heatsink as the chamber temperature.
    t_inside_c now comes from T1 (CHAMBER_CENTER) and the hot side keeps its own
    value, status and source token. No required field was added, so the committed
    W02/W03/W04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
    [app_main.c, cg_check_firmware_w04.py, cg_check_firmware_w05.py, cg_door.c, cg_door.h, cg_telemetry.c, cg_telemetry.h]
2026-11-03 feat(quality): deliver S-1 and S-1R drift audit and dataset validity
    Refs: A-W12-03, A-W12-04
    [dataset-validity.csv]
2026-11-03 docs(quality): re-pin comparability framework with unlabelled refusal
    Refs: A-W16-02, A-W16-01
2026-11-03 feat(sensor): enforce probe role authority across all vocabularies and incorporate wire contract handoff
    Refs: A-W07-01
    [member-a-bcd-compatibility-matrix.csv]
2026-11-03 fix(power): correct UTF-8 BOM parsing in validator, support pre-run register keys, and update dossier pins
    Refs: A-W08-02, A-W08-01
    [duty-zero-current-frames.csv, envelope-by-duty.csv, holdover-frames.csv]
2026-11-03 feat(dataset): analyse command intent against applied state and refuse to invent S4 evidence
    W11's deliverable is the method plus the collector, not a dataset: the refusal experiment
    series has not been run, so the honest artifact is zero command observations and zero
    publishable S4 runs, reported as counts rather than as an empty table that could be
    mistaken for coverage. S3 stays NO-GO, which is a verdict about missing prerequisites and
    not about the model.
    The validator's own wording is the load-bearing part here: 957 frames re-read, 0 command
    observations, 0 publishable S4 runs, S3 NO-GO intact. An evidence record that names a
    developer path cannot be read by anyone else, so every captu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
    [cg_s4_refusal.py, cg_w11_s3_feasibility.py, cg_w11_s4.py]
2026-11-03 docs(evidence): deliver the W11 dossier with its refusal gaps named
    Nine artifacts regenerate byte-for-byte and thirteen files are pinned. Every run-facing
    field carries run_id, boot_id, hardware_config_id, firmware_version, sensor identity and
    position, the timestamp semantics that distinguish device uptime from host wall clock,
    measurement-quality state, experiment phase, invalidation reason and original source
    provenance; a field the capture cannot supply is stated as unavailable instead of filled
    with a placeholder that a consumer would read as a value.
    Refs: A-W11-01, A-W11-04
2026-11-03 docs(dataset): re-derive W11 artifacts against honest W09 registry and pin exact hashes
    Refs: A-W11-01
2026-11-03 feat(actuator): deliver pre-run safety checklist, abort criteria and Controller B enablement audit tools
    Refs: A-W18-01, A-W18-05
2026-11-03 feat(quality): deliver reliability soak protocol, degraded sensor fallback rules and PZEM fault verification tools
    Refs: A-W21-02, A-W21-03
2026-11-03 fix(actuator): reconcile bounds with 9.99A observed peak and 55C provisional cutoff, enforce fail-closed on invalid data, and block physical enablement on G4/B/D
    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
2026-11-03 fix(dataset): ground thermal reset in Doc 03 state criteria, add pair matching validation, and enforce all-attempt preservation
    Refs: A-W19-01, A-W19-04
2026-11-03 fix(quality): enforce continuous 1Hz cadence verification, reject sparse fixtures, and expand chamber air fallback handling
    Refs: A-W21-01, A-W21-02
2026-11-03 fix(acceptance): freeze As-Built Map v2 GPIOs and 15A fuse posture, separate software readiness from blocked hardware acceptance, and forbid live actuation
    Refs: A-W24-04, A-W24-02
    [final-physical-config.yaml]
2026-11-05 docs(evidence): publish power bench records and original bridge-module photograph
    Publish the frozen capture records with hash-exact artifact references. Preserve recorded verdicts and timestamps; keep unresolved per-item device identity explicit.
    Refs: A-W03-01, A-W03-03, A-W03-04, A-W03-05, A-W03-06, A-W03-07
2026-11-05 docs(evidence): publish commissioning measurements and capture provenance
    Refs: A-W04-01, A-W04-02, A-W04-03, A-W04-05, A-W04-07
    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
2026-11-05 docs(evidence): publish telemetry health and timing capture records
    Refs: A-W05-01, A-W05-02, A-W05-03, A-W05-04
    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
2026-11-05 docs(evidence): publish command quality measurements and capture provenance
    Refs: A-W06-04
    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
2026-11-05 docs(evidence): publish sensor consistency and probe-role capture records
    Refs: A-W02-01, A-W02-02, A-W02-03, A-W02-04, A-W02-05, A-W02-07
    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
2026-11-05 docs(evidence): publish thermal trials with accepted attempt chronology
    Refs: A-W07-01, A-W07-02, A-W07-03, A-W07-04, A-W07-05
    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
2026-11-05 build(evidence): declare sensor registry artifacts and pin ROM capture records
    Refs: A-W14-01, A-W14-02
    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
2026-11-05 docs(evidence): publish dataset invalidation and source audit records
    Refs: A-W09-01, A-W09-03
    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
2026-11-05 fix(evidence): distinguish fuse photographs from text provenance
    Refs: A-W08-01, A-W08-02, A-W08-04
    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
2026-11-05 docs(evidence): publish configuration drift records and recorded signoffs
    Refs: A-W12-01, A-W12-02, A-W12-04
    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
2026-11-05 docs(evidence): publish response timing measurements with identity limitations
    Refs: A-W13-01, A-W13-02, A-W13-04
    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
2026-11-05 docs(evidence): publish power integrity measurements with capture provenance
    Refs: A-W15-02
    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
2026-11-05 docs(evidence): publish controller enablement checklist and evidence dependencies
    Refs: A-W18-01
    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
2026-11-05 docs(evidence): publish evidence gap and physical limitation records
    Refs: A-W22-01, A-W22-03
    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
2026-11-05 docs(evidence): publish hardware inventory and annotated pin investigation
    Refs: A-W01-02, A-W01-03, A-W01-04, A-W01-05
    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
2026-11-05 docs(evidence): publish acceptance configuration freeze and capture provenance
    Refs: A-W24-01
    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
2026-11-05 fix(evidence): bind derived W03/W04 records to authenticated capture identity
    Derived A-W03-05 and A-W04-07 carry no per-item device identity. Add an
    identity_provenance block binding each to its declared derivation parent
    (A-W05-03 boot fcaa1289; A-W04-05 boot 5562b609) with exact numeric linkage
    checks and a hash-pinned evaluated slice. Verdicts, checks, measurements,
    existing evidence entries and source timestamps are unchanged; identity is
    inherited and device_verified is false.
    Refs: A-W03-05, A-W04-07
2026-11-05 fix(evidence): bind W07 records to same-boot identity and published captures
    A-W07-02 identity is bound to two same-boot witnesses (A-W02-07, A-W08-04,
    boot 4b555191) with matching device/firmware/hardware tuples. A-W07-03 gains
    per-trial boot identity from the published trial captures and the hash-pinned
    raw TELEM tuple for trial 1, and the already-published bench/trial files are
    restored to its evidence list. The separate stabilization witness stays
    NOT_REUSABLE and its verdict is preserved; per-trial pre-START gate values are
    recorded as recorded, not re-certified. A-W07-04 inherits both parents'
    identity. Verdicts, checks, measurements and source timestamps are unchanged.
    Refs: A-W07-02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
2026-11-05 fix(evidence): bind W08 envelope and fuse records to measured sources
    A-W08-01 is derived from the A-W04-05 actuation capture (boot 5562b609), the
    A-W07-03 cooling-step trials and the A-W03-05 OFF envelope (boot fcaa1289);
    each reported range is checked against those source records. A-W08-02 is an
    operator fuse selection over the same measured currents, and its 5.03 A peak
    is traced to A-W07-03. Verdicts, checks, measurements and timestamps are
    unchanged; identity is inherited and device_verified is false.
    Refs: A-W08-01, A-W08-02
2026-11-05 fix(evidence): bind W09 invalidation log to the pinned session result set
    A-W09-03 is an operator invalidation log over result-level metadata, not a
    device measurement. Record its identity scope as a session meta-record bound
    to the capture session digest and the pinned acceptance result set, instead of
    leaving an unresolved per-item device identity. The verdict, counts and source
    artifact references are unchanged.
    Refs: A-W09-03
2026-11-05 fix(evidence): bind response-timing records to A-W07-03 trial identity
    A-W13-01, A-W13-02 and A-W13-04 are derived from the three A-W07-03 cooling
    steps. Each sample list is checked against the corresponding trial metric
    (electrical delay 1.02 s, thermal delay 37.04/35.00/36.02 s, tau
    61.686/62.586/63.128 s), and identity is inherited from the per-trial boots
    6d7dd125, be89bf4a and f44c9bed. Verdicts, samples and timestamps unchanged.
    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
2026-11-05 fix(evidence): bind dataset-support record to A-W07-03 run identity
    A-W15-02 claims the complete command/applied/electrical/thermal chain on three
    recorded runs; those runs are A-W07-03 attempts 1-3. Bind the record to that
    parent and its per-trial boots instead of an unresolved per-item identity.
    Verdict and run list unchanged.
    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
2026-11-05 fix(evidence): bind W22 gap list to the pinned session result set
    A-W22-01 is an operator gap list over registry results, not a device
    measurement. Record its identity scope as a session meta-record bound to the
    capture session digest and the pinned acceptance result set instead of an
    unresolved per-item device identity. Gap count and verdict are unchanged.
    Refs: A-W22-01
2026-11-05 fix(evidence): pin W07 identity sources to published trial captures
    Review correction: trials 2 and 3 name the published trial JSONL as their
    identity source, so the pinned hash is now the published blob hash; the raw
    telemetry hash is retained as a separate excluded witness. A-W07-04's parent
    references now pin the repaired A-W07-02/A-W07-03 records in this branch.
    Verdicts, checks and measurements are unchanged.
    Refs: A-W07-03, A-W07-04
2026-11-05 fix(evidence): pin W08 parent references to repaired provenance records
    Point the W08 identity chain at the repaired A-W07-03 (5921a5c), A-W03-05
    (9841799) and A-W04-05 (9841799) records so a reviewer resolves the identity
    blocks that actually carry the per-item provenance. Verdicts, checks and
    measurements are unchanged.
    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
2026-11-05 fix(evidence): pin W13 parent reference to repaired A-W07-03
    Point the W13 timing chain at the repaired A-W07-03 record (5921a5c) that
    carries the per-trial boot identity. Sample values, verdicts and timestamps
    are unchanged.
    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
2026-11-05 fix(evidence): pin W15 parent reference to repaired A-W07-03
    Point the dataset-support chain at the repaired A-W07-03 record (5921a5c)
    that carries the per-trial boot identity. Run list and verdict are unchanged.
    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
2026-11-05 fix(evidence): pin A-W07-04 to the corrected A-W07-03 blob
    The A-W07-04 parent pin referenced the commit before the corrected A-W07-03
    record was written. Pin it to 5921a5c and the corrected blob hash so the
    repeatability identity chain resolves exactly. Verdicts and summary metrics
    Refs: A-W07-04
    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
2026-11-05 docs(evidence): link A-W14-01 to dated placement photographs and operator mapping
    Publish the frozen geometry record and its photo hash manifest, pin the two
    original operator photographs by SHA-256 (bytes kept outside Git), and record
    the operator's 2026-11-05 confirmation of the T1/T2/T3/T4 mapping. As-built
    placement is verified; continuous unchanged placement at the exact QA instant
    remains LIMITED because no photograph is timestamped at that instant. The
    A-W14-01 verdict, checks, measurements and timestamps are unchanged.
    Refs: A-W14-01
2026-11-06 fix(ml): enforce intake lineage and statistical contract invariants
    Derive pair membership from imported run records so paired runs cannot
    straddle partitions through omitted pair_lineage; reject timezone-naive
    event-time strings at observation, synthetic-start and manifest boundaries;
    bind dataset/run schema provenance and reject unsupported schema ancestry;
    materialize window inputs once so one-shot iterators match list/tuple
    behavior; validate label/window numeric parameters as finite non-boolean
    values; correct P1/P2 population semantics, freeze classes, as-built sensor
    roles, R6/R7 bibliography and AP arithmetic; add discriminating regression
    coverage for every finding.
    No physical dat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
2026-11-06 fix(ml): fail closed on duplicate views, C wire types and AIW overlap
    Repeated views of one physical source are adjudicated together instead of
    keeping the most advanced admission stage; contradictory views report
    DUPLICATE_VIEW_ADMISSION_CONFLICT and cannot yield READY. C telemetry wire
    types are enforced before coercion, so numeric strings and booleans cannot
    become valid W02 observations. T_system/T_physical spans that overlap on the
    shared timeline are refused instead of double-counted; contiguous spans keep
    the positive control.
    Regression tests reproduce each defect against the previous head. No
    canonical document, evidence artifact or dependency changed.
2026-11-07 docs(ml): record W05 real-telemetry QA report and artifacts
    [channel-summary.csv]
2026-11-07 docs(ml): refresh W05 QA artifacts after review repairs
    [channel-summary.csv]
2026-11-07 fix(ml): fail closed on conflicting duplicate-view QA reporting
    The W05 channel CSV kept the first view of a physical source, so the
    same export bytes with contradictory A validity ledgers could be
    reported as predictively eligible while the suite correctly excluded
    the source. The report also showed the favorable view-level READY
    verdict without conflict context.
    Group CSV views by the W04 admission signature and emit the excluded
    status plus DUPLICATE_VIEW_ADMISSION_CONFLICT when views disagree.
    Annotate conflicting report views as view-only and list the conflict
    evidence. Per-view verdicts remain in the manifest.
2026-11-07 fix(ml): key CSV admission conflicts on the W04 physical source
    Different export bytes of the same device/boot can disagree on A
    validity evidence. Grouping only by source SHA would render separate
    CSV rows and could surface the favorable one. Detect conflict on the
    W04 physical-source key so every view of a conflicted source fails
    closed in the CSV.
2026-11-07 feat(backend): persist and fence device twin state
2026-11-07 fix(backend): fence ambiguous Twin provenance markers
    [ingest.py]
2026-11-07 feat(ml): add provenance-aware W06 event alignment tools
    Implement B-W06-01 through B-W06-04: a typed event timeline built from
    W04 captures plus a distinct #CG CMDACK schema=1 adapter, within-domain
    ordering and protocol-only partial order, clock/sequence/provenance
    diagnostics, bounded configurable response helpers with explicit
    non-estimable and censoring states, and deterministic duplicate handling
    that preserves delivery multiplicity and reports contradictory identity.
    The real W09 capture yields 957 diagnostic telemetry samples, zero
    door-open transitions and no command/ACK lifecycle; host fixtures stay
    synthetic and AIW remains NOT_ESTIMABLE.
2026-11-07 docs(ml): add W06 timing alignment audit artifacts
    [event-timeline-W06.csv, response-summary-W06.csv]
2026-11-07 docs(ml): refresh W06 artifacts with isolated synthetic fixtures
    [event-timeline-W06.csv]
2026-11-07 fix(ml): make W06 event IDs delivery-specific
    Two contradictory deliveries of one logical identity must remain
    distinguishable in the event timeline. Include the source line index in
    capture and command-log event IDs while keeping the dedup identity key
    unchanged, and pin the contradictory-ACK case.
2026-11-07 docs(ml): refresh W06 artifacts with delivery-specific event IDs
    [event-timeline-W06.csv, response-summary-W06.csv]
2026-11-07 docs(ml): refresh W06 artifacts with event field payloads
    [event-timeline-W06.csv]
2026-11-07 docs(ml): refresh W06 artifacts without unqualified numeric delays
    [response-summary-W06.csv]
2026-11-07 fix(ml): retain ambiguous events and gate UTC response clocks
    The reversal branch dropped timestamped events without a source record
    index; keep every event and mark the order ambiguous. ACK-to-applied and
    response-sample intervals over unsynchronized UTC now return
    NOT_ESTIMABLE_CLOCK instead of a numeric delay.
2026-11-07 fix(ml): require complete stream identity for verified timing
    R1: _same_stream accepted a sample with a missing device_id or boot_id
    against a fully identified anchor, letting cross-source or unrelated-source
    telemetry produce VERIFIED_MEASURED_RESPONSE and numeric command-linked
    latency. The stream check now requires matching device and boot on both
    sides; the only permitted incomplete path is same-source, same-boot
    diagnostics, and that path is capped at OBSERVED_DIAGNOSTIC_ONLY.
    R2: order_timeline let caller-supplied device_id/boot_id overwrite
    identities collected from the events, converting a mixed-boot or mixed-device
    input into a clean ordered timeline. Caller identities are now cons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
2026-11-07 feat(backend): accept clockless serial telemetry with source provenance
    Schema 2 carries null event time plus explicit gateway provenance; schema 1 history is unchanged. Revision 0005 stores the source hash and fences the time/provenance XOR, and the downgrade fails closed while clockless rows exist.
    [contracts.py, normalized_store.py, serial_observation.py, twin_store.py, validation.py]
2026-11-07 fix(backend): bound MQTT consumer database connect attempts
    Without a connect timeout a database outage waits for the platform TCP timeout, so the ingest callback looks silent for minutes. A bounded connect surfaces and counts the failure promptly.
    [mqtt_consumer.py]
2026-11-07 feat(ml): add provenance-aware plant EDA and repeatability reporting
    B-W07-01 implements applied-state phase segmentation (passive warm-up,
    cooling step, post-action recovery, undetermined), role-qualified
    chamber-air representations (T1/T3/T4; T2 hot side never averaged in),
    whole-phase and trailing slopes, peak/excursion, temperature-change
    times, spatial spread, ambient context, duty/electrical diagnostics and
    censoring. A missing applied duty is undetermined, never OFF; a missing
    representation term is excluded, never substituted.
    B-W07-02 adds a run-level repeatability aggregator: authored
    independence gates (A validity, admission, boot/device/run identity,
    hardware/calibration/scenari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
    [repeatability-summary.csv]
2026-11-07 feat(api): expose device state and recent telemetry
2026-11-07 fix(ml): gate W07 repeatability on physical run identity
    An export SHA proves different bytes, not a separate physical experiment.
    Repeated exports of one device boot now collapse to one physical source,
    and contradictory duplicate views (validity, admission, configuration,
    run identity or derived outcomes) fail closed with retained conflict
    diagnostics instead of keeping the most favorable or first-sorted view.
2026-11-07 docs(ml): add W08 Gate B readiness artifacts
    Record the real A W09 result: W08 software GREEN, Gate B physical RED,
    predictive dataset NOT_READY and split NOT_AS_FEASIBLE. Whole-capture
    completeness is NOT_EVALUABLE because no planned run-manifest duration
    exists; the observed partial window is never used as the full-run
    denominator.
    [run-validation-W08.csv]
2026-11-07 docs(ml): refresh W08 artifacts after planned-interval fix
    Regenerate the W08 report, CSV, policy, plan and manifest from the
    corrected completeness semantics. The real A W09 result remains
    W08 software GREEN / Gate B RED / predictive NOT_READY / split
    NOT_FEASIBLE, with whole-capture completeness NOT_EVALUABLE because no
    planned run-manifest duration exists.
    [run-validation-W08.csv]
2026-11-07 fix(ml): require chamber-air roles and unique run identities
    A hot-side-only sensor block no longer passes the critical-channel
    checks vacuously: at least three distinct chamber-air roles are
    required. The same run_id on two physical sources now fails the suite
    closed, and the trusted window axis is guarded against non-monotonic
    event or uptime timestamps. Add adversarial regressions for all three.
2026-11-07 docs(ml): refresh W08 artifacts after role and identity fixes
    [run-validation-W08.csv]
2026-11-07 fix(timing): require verified synchronization evidence
    [timing.py]
2026-11-07 fix(storage): separate event and receive time filters
    [main.py, normalized_store.py]
2026-11-07 fix(reconciliation): validate cross-run and scoped provenance
    [reconciliation.py]
2026-11-07 feat(sensors): introduce corrected BME280 ambient producer
    The firmware had no ambient channel: telemetry hard-coded temperature and
    humidity as missing because the BME280 driver was never ported onto main.
    This adds the producer with the datasheet register map (chip id 0xD0,
    calibration 0x88/0xA1/0xE1, burst 0xF7 press/temp/hum), Bosch fixed-point
    compensation (temperature in centi-degree, humidity in Q22.10) and the
    H4/H5 nibble pairing transcribed from BoschSensortec/BME280_driver.
    The decision logic is pure C behind an injected port so a host harness can
    compile it unchanged; only cg_bme280_idf.c reaches driver/i2c_master.h.
    Absence is a named state rather than a fault, a refused transa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
    [cg_bme280.c, cg_bme280.h, cg_bme280_idf.c, cg_bme280_idf.h, coldguard_config.h]
2026-11-07 feat(telemetry): publish coherent ambient observations
    The snapshot had no ambient group, so the formatter could only state that
    temperature and humidity were missing. This adds cg_snapshot_publish_env()
    and the env fields with their own observation time, sequence and producer
    reason, applies the same independent age cross-check to the environment
    group that thermal and power already had, and formats t_ambient_c and
    relative_humidity_pct from the snapshot instead of a constant.
    A value is only emitted when the producer marked the reading valid; an
    unobserved channel is NO_DATA, an absent module is SENSOR_NOT_PRESENT, a
    reading past CG_TELEM_STALE_ENV_MS is STALE with no number carried forwa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
    [cg_quality.c, cg_quality.h, cg_snapshot.c, cg_snapshot.h, cg_telemetry.c]
2026-11-07 feat(firmware): start the BME280 producer task
    The producer existed as a module but nothing ran it. This creates the
    ambient task at the same cadence as the thermal producer, publishes each
    completed cycle to the snapshot, and beats the health registry for
    CG_PRODUCER_BME even when no module answers, so a quiet sensor and a
    crashed producer stay distinguishable.
    The one-shot diagnostic emits the raw calibration bytes and one raw
    measurement context under BME280_DIAG_* so a host can decode the same
    bytes independently; it publishes nothing. Discarded values only appear
    under BME280_TRIM_DIAG with reason TRIM_UNCONFIRMED. No TEC path changes.
    Refs: A-W02-06
    [app_main.c]
2026-11-07 test(sensors): cover BME280 calibration, burst offsets and publication
    The producer's decision logic is exercised on the host against a scripted
    I2C port: golden vectors from a separate transcription of the Bosch
    formulas (including negative H4/H5 nibble pairing), a vector finishable on
    paper, the 0xF7 burst layout that an earlier revision had swapped, the
    diag path reading data only after CTRL_MEAS is configured, absence vs
    BMP280 identity, stuck IM_UPDATE, timeout backoff, saturation garbage and
    the fail-closed trim gate.
    The integration harness compiles the real snapshot, quality, telemetry and
    control sources and drives the ambient channel through never-observed,
    absent, fresh, refused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
2026-11-07 test(tools): update firmware contract checks for the ambient producer
    The W02 checker required that no BME280 driver exist anywhere in
    firmware/main, and the W04 checker required the ambient pair to stay
    NOT_ASSIGNED, so both would fail on correct integrated code. Neither rule
    is weakened: the W02 check now requires the producer to exist, be
    registered with esp_driver_i2c, keep exactly one valid-publication site and
    one sequence site, keep absence nameable, gate publication on obs.valid and
    keep the trim macro fail-closed by default. The W04 check now requires the
    ambient pair to be formatted from the snapshot through the producer's own
    validity gate, with an unfitted module still reading SE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
    [cg_check_firmware.py, cg_check_firmware_w04.py]
2026-11-07 fix(sensors): settle one conversion before the first sample
    A module that was asleep or freshly reset still holds the power-on
    defaults 0x80000/0x8000 in its data registers. Those compensate to a
    plausible 26 C / 100 %RH that neither the raw-code checks nor the range
    check rejects, so the first sample after a probe that reconfigured the
    mode could publish a value the sensor never measured. The probe now waits
    one conversion after writing CTRL_MEAS, matching the diagnostic path.
    Also reject a zero raw humidity code (the low-side twin of the existing
    0xFFFF reject), make the port classifier's fallback a short-read instead
    of a success, include the pure configuration header so the trim gate's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
    [cg_bme280.c, cg_bme280.h]
2026-11-07 fix(telemetry): report a policy-refused ambient reading as degraded
    With the shipped trim gate the module answers but the decode is withheld,
    so env_valid is false with reason TRIM_UNCONFIRMED. Feeding that straight
    into the quality layer named the environment group INVALID and dragged the
    collapsed quality to INVALID on every frame, contradicting docs/06, which
    states the delivered build reports environment_quality=DEGRADED and never
    reaches VALID for the environment.
    A refusal by board policy is a known configuration limitation like a
    declared absence, not a failed measurement, so the quality input now
    carries that distinction and the group stays DEGRADED while the field
    itself still repo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
    [cg_quality.c, cg_quality.h, cg_telemetry.c, coldguard_config.h]
2026-11-07 docs(firmware): correct the BME280 diagnostic comment
    The one-shot diagnostic configures the same control registers the producer
    does before reading, so calling it read-only understated its side effects.
    It still publishes nothing and leaves the trim gate untouched.
    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
    [app_main.c]
2026-11-07 test(sensors): pin ambient units, conversion settling and policy refusal
    The harness never asserted the published floats, so a wrong unit divisor
    (e.g. humidity /1000) survived every scenario. It now samples a frame with
    a non-zero humidity through the golden trim and compares both floats with
    the compensated integers, and it asserts the probe settles one conversion
    after configuring the mode. Both mutations were measured: each fails the
    new assertions while the unmodified sources pass.
    The integration harness gains the shipped build's states: a policy-refused
    reading must still emit INVALID with no number, but report the environment
    group and the collapsed quality as DEGRADED rather than I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
2026-11-07 test(tools): require both ambient fields behind the validity gate
    The reworded contract check only proved the gate literal appeared once, so
    ungating one of temperature or humidity would still pass. It now requires
    the OK comparison at both format sites, which is the count the integrated
    formatter actually has.
    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
2026-11-07 fix(ml): fail closed on conflicting split views and unfrozen policy
    Conflicting eligibility, pair/scenario/controller/hardware metadata or A
    ledger verdicts on one physical source now exclude the whole group from
    every partition and retain each disputed value. Direct split candidates
    must carry an A-VALID W08 eligibility receipt; bare eligible booleans fail
    closed. A measured dataset under PROPOSED completeness thresholds is at
    most YELLOW and cannot become a frozen or predictive claim, while a
    synthetic positive control exercises the GREEN software branch only.
2026-11-07 fix(telemetry): only a fresh policy refusal is degraded
    The DEGRADED exemption was decided from the last reason alone, so a
    producer that published one trim-refused reading and then died kept the
    environment group degraded forever instead of aging into STALE/INVALID.
    The exemption now also requires the observation to be inside the ambient
    freshness bound; the field status and the producer heartbeat continue to
    report the outage either way.
    Refs: A-W02-06, A-W05-05
    [cg_telemetry.c]
2026-11-07 test(sensors): pin fault refusal, zero humidity and stale policy refusal
    Three gaps measured by review are now covered: a genuine out-of-range
    refusal must stay INVALID at the quality layer (mutating the policy
    exemption to mask every fault fails this), a zero humidity raw code must be
    refused rather than published as 0.0 %RH (deleting the reject fails it),
    and a stale policy refusal must age into STALE/INVALID (deleting the
    freshness clause fails it). The pure-producer boundary test also checks
    that coldguard_config.h stays free of ESP-IDF includes, since the producer
    now includes it for the trim default.
    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
2026-11-07 fix(contracts): separate event timestamp presence from clock synchronization
    Rename Telemetry.has_valid_clock to has_event_timestamp so a well-formed
    timezone-aware captured_at is no longer described as a verified synchronized
    device clock. Existence/format validation is now distinct from synchronization,
    which still requires authoritative evidence (timing fails closed with
    UNVERIFIED_CLOCK). Add a regression asserting presence does not imply sync.
    [contracts.py]
2026-11-07 fix(api): validate time bounds and keep database errors observable
    Reject naive start_time/end_time and inverted ranges with HTTP 422 before any
    aware/naive comparison, so invalid user time input can never surface as an
    unhandled TypeError/HTTP 500. Reject the contradictory clockless_only=true with
    time_basis=event at both the API and storage helpers. Remove the swallowed
    except Exception around the raw provenance lookup so database failures stay
    observable instead of silently reclassifying replay/provenance. Document the
    read-only API authentication limitation. Add HTTP regressions for mixed
    aware/naive bounds, both-naive bounds, and the propagated database error.
    [main.py, normalized_store.py]
2026-11-07 fix(reconciliation): prove winner content with bounded snapshot queries
    Validate each normalized winner against its exact raw source: the raw row must
    exist and be admitted RECEIVED_VALID, the payload must re-validate as canonical
    telemetry with topic/device agreement, and identity, run, schema, measurements,
    quality, actuation, provenance and event-time/serial semantics must equal a fresh
    mapping of the validated payload. Receipt time is never compared as a physical
    measurement. Any discrepancy fails the report.
    Replace the raw.id < min(normalized.raw_id) historical heuristic with a durable
    admission boundary (revision 0007) plus explicit per-row legacy audit verdicts.
    Post-boundary missin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
    [reconciliation.py]
2026-11-07 test(storage): prove populated migration preserves telemetry
    Seed the query/reconciliation proof through the real validation/mapping pipeline
    (schema 1 and Member A clockless schema 2) instead of the invalid
    calibration-only raw stub, and clean up so later tests are not polluted. Add an
    isolated-database proof (COLDGUARD_TEST_MIGRATION_DB_URL) that a populated
    0005 -> 0006 -> 0005 -> 0006 cycle preserves row counts, identities, raw links and
    a key-field SHA-256 while indexes appear and disappear, without ever wiping the
    proof database.
2026-11-07 test(storage): track revision 0007 head in migration gates
    Update the expected head revision and exact table set for the W05 remediation
    metadata tables, and pin the W04 preservation/fence proofs to revision 0005
    explicitly so they no longer assume head equals 0005.
2026-11-07 docs(ml): add W09 baseline report and manifest
    [baseline-events-W09.csv, false-warning-summary-W09.csv]
2026-11-07 fix(ml): give warning episodes a traceable event id
    Warning-episode rows now carry the episode id in the event-id column, and a
    no-replay authoritative summary leaves the diagnostic episode count blank
    instead of implying a measured zero.
2026-11-07 docs(ml): refresh W09 artifacts after event-id fix
    [baseline-events-W09.csv, false-warning-summary-W09.csv]
2026-11-07 test(sensors): read ambient state vars in the integration harness
    The render() helper assigned env_present/env_valid but passed literals to
    cg_snapshot_publish_env, so GCC's -Werror=unused-but-set-variable (used by
    the CI host-checks job, not by the local MSVC build) failed the compile.
    The publish calls now read the variables they set, which both silences the
    warning and makes each scenario's intent explicit. Verified clean under
    xtensa GCC 15.2 -std=c11 -Wall -Wextra -Werror and all scenarios still pass.
    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
2026-11-07 feat(acceptance): introduce reusable hardware-free acceptance core
    Add the smallest independently testable foundation of the cross-week Member
    A acceptance application: model (result/definition/operator abstractions),
    protocol (telemetry wire parsing), analysis (pure data primitives) and
    evidence (identity, SHA-256 integrity, session store). The four modules are
    stdlib-only and import no serial, runner, evaluator or GUI layer, so the core
    runs headlessly and cannot mark a requirement PASS on its own.
    evidence gains resolve_within(), a fail-closed containment guard wired into
    update_measurements/import_evidence/verify_attachments so a tampered record
    cannot read or write outside the session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
2026-11-07 test(acceptance): cover evidence integrity, safe paths and result separation
    Headless unittest suite for the core: import closure without hardware or
    downstream modules; outcome ordering and result round-trip; frozen
    definitions; schema-2 telemetry parsing with nan-never-zero; pure statistics;
    SHA-256 identity; intact/tampered/missing attachment verification; canonical-id
    and synthetic-PASS refusal; archive-not-overwrite; path traversal, absolute and
    symlink escape rejection (symlink case skips where the OS denies privilege);
    import dedup by hash; NOT_RUN (no synthetic PASS) reporting; and compatibility
    with the existing results/<ID>.json evidence layout.
    Refs: A-W01-A-W24 shared infrastruc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
2026-11-07 docs(ml): add W10 feature audit artifacts and manifest
    [feature-summary-W10.csv, label-pilot-W10.csv]
2026-11-07 feat(commands): add strict command-ACK wire contract and validation
    Add the CommandAck envelope (Doc 02 §32.3/§64) with the closed Member A verdict
    set and interpretability fields (time_sync_state, expiry_evaluable, output_stage,
    fault_code, ack_seq, canonical_status). DUPLICATE_CANONICAL must carry the
    original verdict. Add an exact-type strict ACK validator and command_ack
    topic/device identity proof, mirroring the telemetry validation boundary. Add
    shared command test helpers and the contract unit suite.
2026-11-07 feat(mqtt): publish non-retained idempotent commands
    Add a bounded three-phase command publisher: fence and expiry-check in a DB
    transaction, publish the canonical envelope to coldguard/{device_id}/command
    with QoS 1 and retain=false, then durably record the broker outcome (PUBACK ->
    PUBLISHED, failure -> PUBLISH_FAILED, timeout/ambiguous -> UNKNOWN). Retries reuse
    the same command_id; a reconnect never replays an expired command. Prove QoS 1
    and retain=false on the wire, the absence of retained commands for late
    subscribers, the expiry gate, crash-window reconciliation and concurrent-publisher
    fencing against a disposable Mosquitto.
    [command_publisher.py]
2026-11-07 feat(ack): persist and correlate device acknowledgments
    Add a backend ACK consumer subscribed to coldguard/+/command_ack (QoS 1) that
    preserves every receipt as evidence, strict-validates schema and types, proves
    topic/device agreement, correlates by existing command_id and quarantines
    unmatched/forged/inconsistent ACKs. Duplicates are idempotent and late ACKs cannot
    resurrect expired commands. Expose subscription readiness so callers do not race
    SUBACK. Prove correlation, quarantine, duplicate and late-ACK behavior against a
    disposable Mosquitto with a contract-compatible mock device.
2026-11-07 feat(twin): link desired intent to command expiry
    Create command intent and link the desired Twin in one transaction, serialized
    per device with an advisory lock and the existing optimistic compare-and-swap.
    Desired points at the active command; reported and derived state are never written
    by the command path. Executable meaning is gated by status and payload expiry, so
    expired, rejected and superseded commands lose it while remaining auditable, and
    an uncertain publish is represented explicitly rather than a fabricated OFF/ON.
    Add the end-to-end harness (intent -> real-broker publish -> mock-device ACK ->
    consumer correlation), domain-separation, concurrency, simulated-outage recovery
    and r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
    [command_service.py]
2026-11-07 test(storage): track revision 0008 head in migration gates
    Update the expected head revision and exact table set for the W06 command
    storage tables so the W01-W03 migration gates remain accurate at head 0008.
2026-11-07 fix(ml): refuse mixed clock domains and unfrozen pilot settings
    [feature-registry-v1.yaml]
2026-11-07 test(acceptance): reject unsafe evidence identifiers and confined names
    Positive and negative coverage for the new boundary guards: safe bench kinds
    write and hash correctly while traversal/separator/absolute/leading-dot/empty
    and overlong kinds raise; attempt_count refuses non-canonical ids and counts
    canonical ones; attachment-name sanitization strips trailing dots/spaces,
    bounds length and removes separators. Symlink-escape case still skips honestly
    where the OS denies symlink privilege.
    Refs: A-W01-A-W24 shared infrastructure
2026-11-07 fix(ml): align door-count contract and pilot provenance output
    [feature-registry-v1.yaml]
2026-11-07 docs(ml): refresh W10 artifacts after contract alignment
    [label-pilot-W10.csv]
2026-11-07 docs(ml): refresh W10 artifacts after CSV alignment
    [label-pilot-W10.csv]
2026-11-07 fix(ml): enforce W10 acquisition identity and W08 source binding
    R1: a Trajectory now refuses samples whose boot/device identity differs from the declared single acquisition domain; mixed boot/device inputs must be partitioned at the adapter boundary. Adds direct-constructor, adapter, reboot-scope and duplicate-seq regressions.
    R2: the W10 CLI now requires the supplied capture hash to be bound by the W08 physical-gate evidence and by a matching run-validation receipt, derives eligible S1/S2 counts from those receipts instead of hardcoding zero, and refuses self-contradictory GREEN/RED manifests. feature_rows() remains a lower-level primitive with an explicit trust boundary; the physical tra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
2026-11-07 feat(safety): add reversible test-only fault injection module
    Add cg_fault_inject, a compile-time-gated module so one supervised device
    session can exercise the A-W21-02 (single DS18B20 unavailable) and A-W21-03
    (PZEM poll unavailable) degraded-input scenarios without disconnecting any
    sensor or wiring. State is a single selected DS role index plus a PZEM-down
    flag, held in RAM only, so a reboot clears it; nothing is persisted.
    The whole implementation compiles to inert stubs unless CG_FAULT_INJECTION is
    1: enabled/ds_active/pzem_down return false and console_line never consumes a
    line, so a production image cannot activate or reach the path. CG_FAULT_INJECTION
    defaults to 0 in coldguard_co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
    [cg_fault_inject.c, cg_fault_inject.h, coldguard_config.h]
2026-11-07 feat(firmware): wire test-only fault injection into DS18B20 and PZEM
    Behind CG_FAULT_INJECTION only, mark exactly the selected DS18B20 role
    present=false/valid=false/status=NO_PRESENCE after the real shared conversion,
    leaving the frozen ROM-to-role map, the other probes and the conversion
    untouched, so no fabricated temperature reaches the snapshot and the quality
    layer reports DEGRADED for one measurement role. Force the PZEM poll to
    CG_PZEM_TIMEOUT with values_valid=false and crc_ok cleared, so the real
    missing-data path publishes an invalid observation with a fresh timestamp and
    carries forward no stale value; the task, bounded timeout and health beat are
    preserved. The local console con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
    [cg_console.c, cg_ds18b20.c, cg_power.c]
2026-11-07 test(sensors): cover test-only fault injection selection and isolation
    Host harness compiles the real cg_fault_inject.c twice: with the gate on
    (enabled) and off (production-inert). It proves exactly one ROM is selected at
    a time, other roles stay up, PZEM-down is independent, FAULT CLEAR and reboot
    reset both, non-FAULT lines are left to the normal parser, and trailing/
    unknown/malformed tokens are rejected with no state change; the disabled build
    shows a FAULT command cannot activate injection. Also asserts the module is
    ESP-free and the default config keeps CG_FAULT_INJECTION 0.
    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
2026-11-07 fix(commands): fence dispatch and reconcile early acknowledgments
    [ack_consumer.py, command_publisher.py, command_service.py, command_store.py, contracts.py, main.py]
2026-11-07 feat(ml): add leakage-safe grouped XGBoost evaluation
    B-W11-01..06: run/pair-grouped development split, explicit feature allowlist excluding T2 diagnostic, grouped CV with class-support guards, train-fold-only class weighting, model save/load with synthetic provenance, W09 B0/B1 and event-evaluator comparison on a common window, and an executable LRK-01..17 leakage audit.
    The expanded deterministic synthetic fixture is a software control only. The real A W09 capture is refused by the admission gate (Gate B RED, A ledger INVALID, unresolved run identity, boot-scoped time, proposed completeness policy, infeasible split); no real model is trained and no synthetic metric is promoted to physical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
    [baseline-comparison-W11.csv, fold-metrics-W11.csv]
2026-11-07 fix(sensors): inject the PZEM fault at the RS-485 transport boundary
    The previous test image overrode the PZEM status after a real RS-485
    transaction and CRC check had already succeeded, which is producer post-poll
    masking, not a communication-path failure. Move the reversible fault to the
    top of link_transaction: when FAULT PZEM is active the input is flushed, no
    request is transmitted and no response is read, so the producer receives a
    bounded communication-unavailable result with frame_len==0.
    A test-only CG_PZEM_INJECT_DISABLED status (compile-gated, named
    INJECT_DISABLED) reports the actual transport-disabled outcome; it is never a
    fabricated natural TIMEOUT and never a claim that the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
    [cg_power.c, cg_pzem.c, cg_pzem.h]
2026-11-07 fix(tools): recognize the test-only INJECT_DISABLED PZEM status
    The host Modbus/serial status vocabulary must understand the gated
    INJECT_DISABLED token emitted by the W21 test build, so the W03 C/host status
    parity check holds and host parsers classify a transport-disabled injection
    honestly rather than as an unknown status. Production statuses are unchanged.
    Refs: A-W21-03
    [cg_modbus.py, cg_serial.py]
2026-11-07 fix(ml): bound W11 event exposure and separate EWT/AIW reasons
    Use trusted all-channel-VALID exposure instead of elapsed span for
    false-warning denominators, truncate warning inputs at the eligible
    anchor cutoff, and right-censor critical events beyond it. Regenerate
    W11 CSV/report/manifest provenance. EWT unavailability now names the
    missing qualified physical trajectory; AIW separately names the missing
    measured latency chain. Add W11 integrity regressions for exposure,
    censoring, boundary and undefined-denominator behavior.
    [baseline-comparison-W11.csv]
2026-11-07 fix(firmware): read the command console from USB-Serial/JTAG, not UART0
    The build configures CONFIG_ESP_CONSOLE_USB_SERIAL_JTAG=y with
    CONFIG_ESP_CONSOLE_UART_NUM=-1, so logs appear on COM4 but the command console
    read UART_NUM_0, which is not connected to the USB port. Operator commands
    (including the test-only FAULT lines) were therefore never received: the device
    showed telemetry but could not be driven. Read input via
    usb_serial_jtag_read_bytes and install the USB-Serial/JTAG driver when that is
    the configured console, keeping the UART0 path for UART-console builds. This
    restores the local command path the W21 fault injection depends on; it does not
    change the output stage, watchdog, or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
    [cg_console.c]
2026-11-08 fix(commands): quarantine ACKs that exceed JSON parser limits
    [ack_consumer.py]
2026-11-08 feat(platform): verify paced ingestion and broker recovery
    [mqtt_consumer.py, simulator.py]
2026-11-08 feat(ingest): account for offline replay and out-of-order samples
2026-11-08 feat(platform): verify restored evidence fingerprints
2026-11-08 test(evidence): add sealed W21-02/03 on-device fault-injection acceptance evidence
    Real ESP32-S3 software fault-injection session (boot 4cf9be5f, test image
    e1073935): single-DS18B20 (T1) degradation+recovery and PZEM transport-boundary
    disable (INJECT_DISABLED)+recovery, TEC OFF throughout. Sealed raw.log/manifest/
    events with SHA-256 (CRLF preserved byte-identical), accepted result records
    A-W21-02/A-W21-03 and attachments (integrity-verified). Provenance
    ON_DEVICE_SOFTWARE_INJECTION; output-stage-compiled-out limitation and
    unpublished-evaluator validation dependency documented.
    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
2026-11-08 test(evidence): record A-W04-06 TEC polarity acceptance from existing evidence
    A-W04-06 PASS: operator-attested orientation (polarity-photo.md, 2026-11-02) +
    assembled W07 geometry interior/exterior photos (hash-verified) + A-W04-05 measured
    cooling direction/hot-side rise. Disclosures: stale md header, T2 label not legible
    (operator-attested + firmware role), no wire-colour inference. Result + imports +
    measurements integrity-verified.
    Refs: A-W04-06
2026-11-08 test(evidence): record operator-confirmed A-W12-03 mechanical inspection
    Follow-up to the merged W12 host dossier (PR #22), which records A-W12-03 as
    NEED_USER_ACTION because a host audit cannot perform physical checks. This adds
    the operator's 2026-11-08 physical confirmation as a DOCUMENTARY acceptance
    (PASS) without modifying any hash-pinned host artifact.
    Evidence is published by canonical reference, not copies: geometry via
    ../W07/geometry-v1-photos-20261104/ (published once in W04 PR #76, present in
    this stacked base), terminal-block via ../W01/photos/ (on main), and fuse-block
    via ../W23/operator-submission-20261108/ (W23 PR #75). verify_attachments
    resolves geometry x2 + terminal-bl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
    [mechanical-audit-checklist-CONFIRMED-20261108.csv]
2026-11-08 fix(telemetry): audit every shadow frame instead of the first one
    audit_shadow_session checked Member B channel completeness on telemetry_records[0]
    only, so a session could pass while later frames carried no current, power or
    quality reading. It also defaulted a missing applied duty to zero with
    `r.get("pwm_duty", r.get("pwm_applied_permille", 0))`, and zero is the value the
    isolation rule already accepts as a fail-closed trip, so absent evidence was
    converted into a PASS for shadow isolation.
    Channel presence is now evaluated per frame and reported by frame index. Missing,
    non-finite or absent-on-frame applied duties, and desynchronised shadow or
    authorised arrays, return DATA_INSUFFICIEN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
2026-11-08 fix(telemetry): reject unusable shadow channels and unfalsifiable isolation
    An independent review reproduced PASS on sessions whose required channels were
    present but meaningless: an empty t_inside_c, a -9999 placeholder current, and a
    blank door_status all satisfied the completeness check, and the same placeholder
    made the envelope monitor skip the pair, hiding a real excursion.
    Channel usability now follows the vocabulary firmware actually emits: numeric
    channels must carry a finite magnitude that is not a placeholder, status channels a
    non-empty string, and door_open a real contact state.
    Isolation also needs two independent decision series to be testable. Shadow and
    authorised duties t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
2026-11-08 feat(acceptance): publish canonical Member A requirement registry
    Add the 114 canonical Member A TestDefinitions (criteria, modes, safety classes,
    checks, evidence) as tools/member_a_app/requirements/, copied verbatim from the
    acceptance application. The registry imports only the shared core model (#53) and
    is the source of truth the evaluators consume.
    requirements.validate() cross-checks handlers against the evaluator module, which
    is published in the next infrastructure PR in the chain; the added registry test
    asserts identity and structure directly without importing evaluators. Verified:
    45 tests OK (10 registry + 35 core). Publishes definitions only; no requirement is
    marked accepted h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
2026-11-08 feat(acceptance): publish Member A evaluator engine
    Publish the evaluator engine verbatim from the acceptance application so the
    accepted W21 (#67) and W23 (#75) evidence can be independently re-accepted on
    published source: runner.py (TestContext/TestRunner), device.py (DeviceLink with
    guarded serial import), evaluators.py and evaluators_extra.py (the W01-W24
    handlers), plus their tests and fixtures.
    Stacked on the requirement registry (#79) and shared core (#53). With the engine
    present, requirements.validate() resolves all 114 handlers. Verified: 71 tests OK
    across core/registry/device/runner/registry suites. Publishes engine code only; no
    requirement is marked accepted and no result/led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
2026-11-08 fix(acceptance): isolate core hardware-independence guard in a subprocess
    The core guard asserted serial/device/runner/evaluators absent from global
    sys.modules. Once the engine's device/runner tests run in the same process they
    legitimately import those modules, falsely failing the guard. Check in a fresh
    interpreter that imports only the core, so the real invariant (core pulls no
    hardware/downstream module) is tested immune to test-order pollution. Verified
    two-directional: full suite passes; a simulated core-pulls-serial exits non-zero.
2026-11-08 feat(control): D W04 command TTL and device safety foundation
2026-11-08 feat(control): D W13 AIW candidate and closure ledger
2026-11-08 feat(evidence): publish normalized real-data handoff from retained source captures
    Derived dataset package alongside the retained 2026-11-07 S1/S2 source
    captures (18 runs/segments, 9293 frames, all classifications kept):
    - datasets/: per-run normalized CSVs (T1/T2/T3/T4 with per-field status,
    chamber-air mean = mean(T1,T3,T4) only when all three are OK; T2 stays
    hot-side and is never averaged in), door/PWM/V-I-P/energy columns.
    - raw/: verbatim bench retention copies (W07-02 passive repeats, W07-03
    500-permille cooling trials, interrupted acquisition record, session
    telemetry export, W04 600 s cooling-step provenance summary).
    - run_index.csv, measurement_summary.csv, quality_repor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
    [H8-C-600s-TEC-100pct-normalized.csv, H8-E-1800s-TEC-100pct-normalized.csv, S1-20261107-between-window-normalized.csv, S2-20261107-between-window-normalized.csv, W10-02-normalized.csv, W10-03-run1-normalized.csv, W10-03-run2-normalized.csv, W10-03-run3-normalized.csv]
2026-11-08 fix(evidence): resolve run source paths in the dataset handoff index
    run_index.csv previously referenced glob patterns (and doubled the raw/
    prefix for the bench trial retentions), so several source paths did not
    resolve inside the published package. Now every run entry carries the
    exact packaged path, and the export pipeline parses the byte-verified
    raw/ copies, making the handoff reproducible from its own tree without
    local-only capture directories. Verification: all 18 source paths
    resolve, per-file row counts match run_index, manifest checksums and
    row totals agree.
    [run_index.csv]
2026-11-08 fix(evidence): make the dataset handoff reproducible from its published package
    - export_pipeline.py gains a --standalone mode that regenerates every
    derived dataset purely from the package's own raw/ tree, with no
    local-only capture directories and no acceptance-store access; a
    full regeneration from a bare copy of the committed package is
    byte-identical to the committed outputs.
    - Normalized CSV writers emit LF and the outside-window classification
    labels are stable, so the committed datasets match regeneration on
    any platform with bytes-pinned checkout (-text subtree).
    - manifest.json/SHA256SUMS.txt regenerated accordingly; row totals and
    per-run source paths re-verified.
    [H8-C-600s-TEC-100pct-normalized.csv, H8-E-1800s-TEC-100pct-normalized.csv, S1-20261107-between-window-normalized.csv, S2-20261107-between-window-normalized.csv, W10-02-normalized.csv, W10-03-run1-normalized.csv, W10-03-run2-normalized.csv, W10-03-run3-normalized.csv]
2026-11-09 fix(telemetry): type raw DS18B20 temperature fields as floats
    raw_t1_c/raw_t2_c/raw_t3_c/raw_spare_c were absent from FLOAT_FIELDS, so
    the schema parser left them as raw strings while every other numeric
    field coerced. Add the four tokens to FLOAT_FIELDS and pin the behavior
    (float coercion, nan-as-missing, duplicate-token refusal) with focused
    regression tests against the committed W06 demo capture.
    Previous reports of '5 new regression tests' were wrong: this remediation
    adds exactly 4, all passing.
    [cg_telemetry_schema.py]
2026-11-09 fix(evidence): make the B/C/D contract probe schema-aware on committed captures
    The probe assumed the committed TELEM line was schema=2 and appended the
    five W06 no-command tokens unconditionally. The committed capture already
    carries a schema=3 frame with that tail, so parse_line rejected the
    duplicated command_id fields and the whole probe crashed before writing
    member-a-bcd-contract.json. Upgrade a historical schema=2 line only, and
    regenerate the contract JSON and compatibility matrix (96 rows) from the
    current schema-3 source.
    [member-a-bcd-compatibility-matrix.csv]
2026-11-09 fix(evidence): mark R-07/R-08 resolved in the generated contract record
    The defect register still carried the pre-remediation claims (schema-2
    demo, untyped raw temperatures) while the committed capture is a real
    schema=3 frame and the raw temperature tokens are now in FLOAT_FIELDS.
    Record the resolution and versus the actual parser behavior; the
    provenance string now states the frame was parsed directly, not derived.
2026-11-09 fix(evidence): mark R-07/R-08 resolved in the generated contract record
    schema=3 frame and the raw temperature tokens are now typed in
    FLOAT_FIELDS. The provenance string now states the frame was parsed
    directly, not derived.
    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
2026-11-09 docs(evidence): reconcile contract verdict with schema-3 probe reality
    The verdict document still described a 95-token schema-2 demo frame and
    listed the R-07 evidence gap as a live blocker. The committed capture is
    a real schema-3 frame with the full W06 command/ACK tail, the probe
    parses it directly (provenance: PARSED, not derived), and the
    compatibility matrix has 96 rows. Update the verdict prose to match the
    regenerated JSON and CSV artifact counts.
2026-11-09 docs(evidence): reconcile contract verdict with schema-3 probe reality
    listed R-07/R-08 as live Member A blockers, while the committed capture
    is a real schema-3 frame parsed directly and both defects are RESOLVED
    in the generated register. Correct the prose (96 rows: 25 mapped, 71
    ignored, 1 unsatisfiable REject) and add a cross-artifact consistency
    test pinning schema, row count, typing and resolution together.
    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
2026-11-09 fix(acceptance): count schema-3 TELEM frames in the read-only collector
    TELEMETRY_MARKER only matched the legacy H8 pwm token, so a capture of
    the current W06 serial grammar counted 0 telemetry frames (10 collector
    lines, 1 real schema=3 frame). Classification now runs the committed
    line through cg_telemetry_schema.parse_line; legacy H8 frames keep the
    pwm marker. Raw bytes and DTR/RTS handling unchanged; still read-only.
2026-11-09 fix(acceptance): accept collector ISO stamps with fractional seconds or offsets
    The W09 parser validated only second-resolution Zulu host prefixes, so a
    line from the shipped read-only collector (isoformat with .%f and +00:00)
    was transcript noise. HOST_TIME_RE and host_time_is_iso_z now accept
    seconds, fractional seconds, Z or +/-HH:MM offsets; malformed prefixes
    stay rejected and device wall-clock remains UNAVAILABLE.
    [cg_w09_capture_parser.py]
2026-11-09 fix(acceptance): schema-aware Phase E and current S1/S2 handoff links
    Phase E now accepts schema-3 cooling_applied=OFF frames as the applied
    state proof while staying fail-closed: missing or empty observations
    yield UNPROVEN, never PASS from empty arrays. W09/W10/W11 handoff docs
    gain a dated CURRENT HANDOFF section linking the published
    evidence/A/SOURCES/20261107/datasets package without rewriting their
    historical snapshots.
2026-11-09 fix(evidence): refresh pinned builder checksums
    The Python 3.12 reproducibility fix rewrote the byte-exact read path in
    13 builder/validator scripts, but each dossier pins its own tools in
    SHA256SUMS.txt, so the host checks failed on four stale pins. Re-pin the
    13 affected entries from the actual file bytes; manifest format, line
    endings and unrelated entries are untouched.
2026-11-09 fix(acceptance): schema-aware Phase E verification gates
    Phase E expected only the legacy pwm_applied_permille/ren_command/
    len_command keys, so a schema-3 capture could not prove its idle state.
    Accept the firmware's own applied state (cooling_applied=OFF on every
    frame, zero bytes written) as the idle proof; with neither schema-3 nor
    legacy evidence present the observation is UNPROVEN, never PASS.
2026-11-09 fix(evidence): reconcile stale dossier checksums with committed bytes
    Three W05 entries (acceptance.md, schema-fixture.json, validate
    _w05.py) drifted at the command-acknowledgement integration merge, which
    updated the dossier files but never refreshed the manifest; the fixture
    check had been unrunnable under the pinned 3.12 toolchain and so never
    caught it. Regenerate schema-fixture.json from the current emitter via
    the committed builder (the other two artifacts reproduce byte-exact),
    re-pin every affected entry from actual bytes, and re-pin the three
    handoff READMEs this branch extended. All other manifest entries
    verify; the W05 dossier validator passes with honest verdict intact.
2026-11-09 fix(commands): defer broker PUBACK until ACK evidence is committed
    Valid ACK evidence was silently lost when the evidence transaction failed:
    paho acknowledged QoS 1 deliveries automatically, so a database outage
    released the delivery to the broker before any evidence row existed.
    Switch the ACK consumer to explicit manual acknowledgements (ack(mid, qos)
    after the commit), keep a persistent broker session (stable client id,
    SessionExpiryInterval 300) so unacknowledged deliveries are redelivered
    on reconnect, count unknown record_ack outcomes as errors, and correct
    the contradictory durability note in the module docstring.
    Verified: w06-ack-durable-fix-06, 311 PASS / 0 FAIL / 0 ERROR / 0 SKI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
    [ack_consumer.py]
2026-11-09 fix(broker): allow the authorized command publisher principal in the ACL
    The W06 command lifecycle introduced the backend-command dispatch
    principal and its tests, but infra/mosquitto/acl.conf never grew the
    corresponding user block, so any broker provisioned from the committed
    configuration denied every command publish and the era's persistent-
    broker integration tests could only pass against an externally patched
    ACL. Grant the principal exactly one write: the configured device's
    command topic (the same rule the later security hardening formalizes).
    Verified: w06-ack-durable-fix-06, 311 PASS / 0 FAIL / 0 ERROR / 0 SKIP,
    including test_command_integration end-to-end command delivery that
    p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
2026-11-09 fix(evidence): restore cross-dossier provenance chains
    The W09 run registry still recorded the pre-merge capture bytes (the old
    4536-byte W06 demo hash) so its builder check had drifted since
    publication; regenerate it from the delivered tooling so every recorded
    source hash matches the actual referenced bytes again. The W11 S3
    feasibility record embeds that registry hash and now re-derives cleanly
    in dependency order. The W12 dossier had one unpinned CRLF decision
    record plus three unpinned mechanical follow-ups committed without a
    manifest refresh: normalize the record to the dossier's LF-only rule
    (values untouched) and pin all four from actual bytes.
2026-11-09 fix(evidence): commit the regenerated cross-source inventory
    The additional-valid-run-list re-derivation updates the embedded
    source hashes of the schema fixture and the demo capture to their
    current bytes; the manifest already pins those derived bytes, so the
    file itself must land for the pinned chain to hold.
2026-11-09 evidence(acceptance): record the genuine 600 s passive S1 physical trial
    A-W11-03 dataset expansion: one additional valid passive S1 baseline run
    captured read-only on COM4 (2026-11-09T08:13Z, boot c0e43470, 600/600
    schema-3 frames at 1 Hz, coverage 0.99833, thermal_valid_rate 0.99833,
    electrical_valid_rate 0.99667, boot_changes 0, fault bits 0, cooling OFF
    in all frames, zero bytes written to the port, no commands sent).
    Preconditions: operator switched the 12 V PSU ON and confirmed the door
    closed; fuse slot-3 stayed OUT per the approved PASSIVE_S1_TRIAL config.
    Raw log, trial.json, host capture summary, acceptance verification and
    SHA256SUMS under evidence/A/SOURCES/20261109/s1/s1-2026110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
2026-11-09 docs(handover): reconcile current acceptance status and S1 trial admissibility for B/C/D consumers
    Bring the four handoff documents current with the committed evidence and the
    authoritative acceptance store (80 PASS / 2 FAIL / 7 INCOMPLETE / 25 NOT_RUN
    of 114, recounted live):
    - README.md: current handoff state, per-member consumption summary, physical
    blockers with owners, recommended reading order.
    - coverage-matrix.md: current W07-W16 audit (35 COMPLETE, 2 INCOMPLETE, 7
    NOT_RUN of 44) with per-row artifact traceability; the pre-dataset table
    is retained below a historical marker.
    - a-to-bcd-fields.md: current field-by-field availability against the
    accepted dataset and the new ph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
2026-11-10 fix(ml): refuse W11 benchmarks with a zero-evaluable-run population
    The grouped benchmark derived evaluation_end_by_run with max() over every
    declared development run's evaluable anchors. A run whose anchors are all
    CENSORED or UNTRUSTED has no evaluable samples, so the reduction raised a
    raw ValueError (max() over an empty population) and could not represent a
    scientific refusal. The W13 H=300 fixture leaves 8 of 16 development runs
    with zero evaluable anchors.
    Refuse the whole benchmark with DEV_RUN_WITHOUT_EVALUABLE_ANCHORS, naming
    the affected runs and their exclusion counts. The run is neither dropped
    from the declared population nor given a fabricated evaluation endpoint.
    Ordinary ben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
2026-11-10 docs(ml): add W12 benchmark synthesis and Gate G3 artifacts
    [event-operational-summary-W12.csv, ewt-assessment-W12.csv, feature-importance-W12.csv, gate-g3-evidence-matrix-W12.csv, grouped-metrics-W12.csv]
2026-11-10 docs(ml): refresh W12 artifacts after provenance hardening
    [event-operational-summary-W12.csv, ewt-assessment-W12.csv]
2026-11-10 docs(ml): refresh W12 provenance after the W11 empty-run repair
    Rebind the Gate G3 evidence matrix and manifest to the repaired W11
    manifest (SHA-256 855c5beb...) and analysis revision 6bd02af. Only
    provenance changes: every W12 metric, synthesis and operational artifact
    stays byte-identical, and Gate G3 remains NO-GO / FIX DATA.
    [gate-g3-evidence-matrix-W12.csv]
2026-11-10 feat(ml): add W13 horizon engineering with provisional horizon decision
    Reconcile the merged A 20261107 18-row/segment export (8 distinct boots)
    and the W13 plant-timing report against the W04 admission ladder: every
    real run is refused predictive admission and real metrics stay
    NOT_ESTIMABLE. Screen the canonical 30/60/120/300 s horizons against the
    measured plant timing, run a grouped leakage-audited synthetic
    sensitivity study that reuses the W11 pipeline, and record
    PROVISIONAL_CANDIDATE_ONLY with no horizon frozen. The W11 empty-run
    pipeline defect exposed at H=300 is reported in the artifacts, not fixed
    inside W13.
    [horizon-metrics.csv]
2026-11-10 docs(ml): refresh W13 artifacts after the W11 empty-run repair
    Re-record the W13 analysis-code hash, artifact hashes and generation
    revision against the repaired W11 layer. Only the H=300 refusal text and
    the W11 verdict change; every H=30/60/120 metric and every REAL_REFUSAL
    row stays byte-identical. The study remains PROVISIONAL_CANDIDATE_ONLY,
    the primary horizon is not frozen and real EWT/AIW stay NOT_ESTIMABLE.
    [horizon-metrics.csv]
2026-11-10 feat(commands): add device serial translation for the backend envelope
    Adds command_translation.py mapping backend command envelopes to Member A
    device key=value serial records, with unit tests covering correct mapping
    and malformed input refusal.
    [command_translation.py]
2026-11-10 feat(ack): translate device CMDACK records to CommandAck envelopes
    Adds ack_translation.py updating the C CommandAck contract and the
    ack-correlated B device envelopes, plus unit tests.
2026-11-10 feat(commands): add fail-closed command and ACK correlation bridge
    Adds command_ack_bridge.py combining dispatch, correlation and fail-closed
    refusal semantics, with integration tests.
    [command_ack_bridge.py]
2026-11-10 docs(evidence): record command-path integration runs
    Adds the W06 traced and ack-only command-path integration run records and
    manifest used to close the D-C-A command path evidence chain.
2026-11-10 docs(integration): add owner source sync and scope architecture records
    Adds the Phase 6/7 source-synchronization dossier and the pinned
    00-project-scope-architecture.md owner revision.
    [source-sync-matrix.csv]
2026-11-10 docs(evidence): preserve the 14 owner-frozen tracked modifications
    Carries the 14 owner-approved tracked modifications (W01/W03 evidence
    updates, W08/W09/W13 manifest pin refreshes, evaluator and requirements
    extensions) verbatim into the delivery tree.
    [bom-audit.csv]
2026-11-10 docs(qa): add the premerge verification dossier
    Adds the Phase 7B/7B.1 premerge documents, file-map and checksum
    manifests used to verify the combined tree before delivery.
    [premerge-commit-file-map.csv]
2026-11-10 docs(qa): add the leader delivery packaging dossier
    Adds the Phase 8 leader delivery source lock, DAG, provenance ledger,
    review verdict and PR reconciliation package.
    [leader-delivery-member-provenance.csv]
2026-11-10 docs(qa): record the phase8.2 atomic repackaging verification
    Adds the Phase 8.2 atomic commit ledger, final Git DAG, frozen-file
    disposition, tree equivalence, test and review evidence, GitHub delivery
    runbook, and final verdict, and repins the leader-delivery SHA256SUMS
    manifest over the 19 delivery documents.
2026-11-10 docs(qa): record the phase8.2 final verification verdict
    Pins the two measured Phase 8.2 states: the 14-atomic-commit chain ending at
    e75ec866 with tree 80f788cd0aaf… (exact Phase 8 tree object), and the
    final documentation state. Repins the leader-delivery SHA256SUMS over all 19
    delivery documents. No source, test, runtime, data or evidence file changes.
2026-11-10 docs(qa): pin the phase8.2 terminal verdict and manifest
    Final documentation-only pass: the terminal Git state is derived at audit
    time and all earlier measured states stay valid. Repins the leader-delivery
    SHA256SUMS over the 19 delivery documents. No source, test, runtime, data or
    evidence change.
2026-11-11 docs(qa): repin terminal git reference after owner attribution rewrite
    Owner-authorized metadata-only rewrite of the 17 owner commits on top of ce9661a (identity giaback, 3 conventional-type normalizations, content and dates preserved). Adds the terminal attribution-repin reference and extends the leader-delivery manifest over the 20 delivery documents. No source, test, runtime, data or evidence change; member/base history below ce9661a untouched; pre-attribution chain kept at leader/delivery/w01-w13-atomic-reviewed-preattrib.
2026-11-11 docs(leader-delivery): add 52-week member-pr traceability and refresh PR description
    Packs the full 52/52 member-week provenance classification (ALREADY_IN_MAIN 19, INCLUDED_VIA_ANCESTRY 29, SUPERSEDED 4 C-W01..W04, MISSING 0) from the pinned source-sync registry, verified delivery ancestry and the GitHub PR state index; refreshes the delivery PR description (actual source branch, per-member A/B/C/D summary, superseded per-week PR list, owner-delta mapping). Docs-only on the verified terminal state; no source, test, runtime, data or evidence change; nothing pushed.
2026-11-11 docs(integration): record reconstructed delivery provenance
    Map original to delivered commit objects and distinguish the unchanged source PR heads from the equivalent Member C history included in Leader PR #113.
    [pr113-reconstructed-commits.csv]
2026-11-11 fix(control): reconcile W13 evidence with integrated main
    [faults.py, test_assess_a_w21_faults.py, test_assess_main_integration.py, test_build_d_g3_matrix.py]
2026-11-12 feat(control): add W22 safety case gate
2026-11-12 fix(control): fail closed on W14-W24 evidence readiness
    [campaign_audit.py, campaign_integrity.py, enablement.py, handover.py, negative_campaign.py, predictive_gate.py, resilience.py, safety_case.py]
